lst92991-eng/four-axis-robot-arm/hardware/arm_equal_275/v1/README.txt

275+275 mm 等臂版 CAD 副本（2026-10-09）

打开 native/EQ275_SCARA四轴机械臂总成.SLDASM。必须保留整个native文件夹及同目录零件，不要只移动装配文件。
也可使用独立中性格式 SCARA_equal_275.step。

本次修改
- G1转轴中心距：195 -> 275 mm（增加80 mm）；G2仍为275 mm。
- G1臂板外形：330 × 60 × 10 mm；原孔径、板厚和端部安装尺寸保留。
- 中槽直段50 -> 130 mm，并修正槽位置、电机槽组和肘部四孔，避免中心矩形变长导致它们漂移。
- 肘部组件及大同步轮前移80 mm；关闭原CAD皮带的固定长度驱动，让皮带按新中心距重建。
- 原生装配、零件和虚拟皮带依赖均为独立副本。本次恢复仅打开和保存EQ275文件。

验证
- SolidWorks圆柱面回读轴距：275.000000 / 275.000000 mm。
- G1体积：136224.851137 mm³，与保留两端、中间加长80mm的几何结果一致。
- G1特征无错误；没有新增装配配合错误；原模型既有13项配合错误和配合组警告保留，见final-model-verification.json。
- 207实体，8281组4°构型；3939组无碰撞样本属于直臂姿态所在离散连通分量。
- 五对既有轴/轴套/键连接交叠按原模型解释排除；同步轮、皮带当前外形纳入本次检查。
- 新图为当前Z高度和末端R相对姿态的几何分析；不是连续路径证明、强度或实机安全验收。

需要后续核实
- 实物同步带长度/齿数必须重新选型，不能从CAD带长直接推出采购规格。
- 加长后的刚度、驱动负担、线缆/软管、抓手TCP和实物限位尚未验证。
- 当前棋盘尚未确定，本图没有把任何棋盘尺寸认定为最终实购物料。
- 此尺寸版本保留原生草图；以后再改臂长，仍须同步复核孔槽位置及装配关系。

文件
workspace-comparison.png / .svg：旧版195+275与新版275+275的同尺度俯视对比及中心放大。
旧版采样未纳入被抑制的同步轮/皮带总成，新版已纳入；不能将面积差解释为纯臂长修改的精确增益。
workspace-top-view.png / .svg：新的工作区俯视图。
model-isometric.png：新模型预览。
analysis/：实体干涉采样、连接交叠排除和统计证据。
final-model-verification.json：最终装配核验；早期制作日志中的错误已由后续步骤修正。

原件记录
初次复制时原文件哈希未变。用户关闭/重启SolidWorks的间隔内，原总装及其旧临时虚拟总装的哈希发生变化；该差异保留在日志中，没有回滚。恢复后的操作只针对EQ275副本，原件相对恢复基线未再变化。
