lst92991-eng/four-axis-robot-arm/hardware/camera_mount/v2/README.md

# 省料双梁相机桥架 V2 · 已撤回打印建议

> 2026-10-09：用户否决本方案，理由为结构过于复杂、用料仍偏多，以及62.6cm高度缺少实际视场与识别验证。棋盘尚未最终确定，本目录仅保留历史CAD及几何检查证据，不作为当前制作方案。以下打印数量和尺寸是该历史设计的记录。

2026-10-09。借用机械臂既有顶层铝板，打印左右卡座、镂空双梁、主板横条和相机横梁。省掉V1独立立柱与大托盘。结构件全部打印，普通螺钉连接；这是待试装原型，尚未打印或验证长期承载。

## 文件

- `camera_bridge.SLDASM`：9个打印组件的独立SolidWorks 2026固定装配；零件在`parts/`。
- `camera_bridge.step`：通用CAD装配；`print/`内5个STL按下表打印。
- `layout_check.png`、`layout_check.step`：包含机械臂、参考棋盘、相机和主板的安装场景。棋盘位置仍是布局参考，实际可达工作区另行验收。
- `reference/pcb_major_components.SLDPRT`：从用户STEP复制板框、固定孔和主要器件实体，省略小SMD，只作安装参考，不打印。完整器件包络记录在`pcb-import-evidence.json`。
- `source/`：本轮生成与验证脚本；`*-sketches.json`记录草图约束及特征消费关系。普通打印不需要运行Python。

原机械资料与用户STEP作为参考读取。不要把整机场景或主板参考模型拿去打印。

## 默认打印数量

| 文件 | 数量 | 包络mm | 用途 |
|---|---:|---|---|
| `01_clamp_right.STL` | 1 | 105×131.4×22.8 | 右侧板边卡座 |
| `02_clamp_left.STL` | 1 | 105×131.4×22.8 | 左侧板边卡座 |
| `03_truss_200.STL` | 4 | 200×45×12 | 每侧两段，搭接20mm |
| `04_camera_B_crossbar.STL` | 1 | 146×48×9 | 镜头向下的轻量横梁 |
| `05_pcb_support.STL` | 2 | 146×10×15 | 两个窄横条、四个12mm支柱 |

共**5种、9件**。最长200mm，成型空间建议至少约220×220mm，给裙边留余量。不要缩放适配打印机；更小的打印机需要重新分段。

## 安装接口与尺寸

坐标沿用项目候选机器人坐标，单位mm。铝板安装基准取原CAD底座底面；实际桌面与棋盘高度需要测量。

| 接口 | 尺寸/位置 | 来源或限制 |
|---|---|---|
| 顶层铝板 | 120×161×10；X=±60，Y=-214..-53，Z=524..534 | 原CAD电机支撑铝板 |
| 卡槽 | 净高10.4，单侧名义间隙0.2 | 夹10mm板；实际打印补偿待试配 |
| 每侧卡唇 | 两段各16mm宽，中心Y=-185、-115 | 避开下方角码和板角孔 |
| 板边压紧孔 | 每侧2孔Ø3.4，X=±55，Y=-185、-115 | M3顶紧；原铝板不钻新孔 |
| M3螺母窝 | 矩形6.7×5.8、深2.5；承力底厚2.7 | 放普通M3六角螺母，两平面朝5.8方向防转；从卡槽内放入 |
| 梁根槽 | 4.6宽，配4厚梁 | 拧紧后检查夹持；不只凭松配插接承载 |
| 梁根固定孔 | 每侧2孔Ø3.4，Y=-100，Z=615、640 | 与梁u=30孔对应 |
| 双梁 | 中心X=±66.6；从Y=-130延伸到250；Z=605..650 | 380mm有效长，45mm高、主腹板4mm厚 |
| 梁接缝 | 每侧2孔Ø3.4，Y=60，Z=615、640 | 两片各1.9厚，中间名义间隙0.2 |
| 梁顶固定耳 | u=65、95、125、155、175；孔Ø3.4，腹板横向w=2 | 由每段梁起点计；本版使用Y=145、205、225固定横条/相机 |
| 主板 | 板框约84.975×55.975、厚1.586 | 用户STEP；近似称85×56，不把接插件伸出量算作板框 |
| 主板孔 | 4孔约Ø2.700；孔阵58.000×49.000 | 使用四个安装孔，不使用网口/USB的焊接定位孔 |
| 主板横条 | Y=146、204；孔中心X=±24.5；Ø2.8；支柱Ø6×12高 | 固定58×49孔阵；梁端3.4×5.4矩形槽吸收1mm安装偏移 |
| 主板朝向 | 两个FPC朝+Y相机；网口、USB朝-Y机械臂侧 | 保留插拔空间；FPC1/FPC2名称本身不能证明哪一个是CSI |
| 主板底面 | Z=665；最高模型点约680.4，最低底面元件约656.7 | 下方横条顶面653，最低器件包络约留3.7mm |
| 相机固定 | 两端M3孔X=±66.6、Y=225；中央四孔21×13.5，Ø2.8 | MIS5001 B官方孔阵；实物PCB孔径仍需核对 |
| 镜头前端 | (0,250,626.4)；约62.6cm高 | 相对原CAD底座底面；离棋盘距离须扣除棋盘表面高度 |

相机孔阵中心暂代光轴参考，厂家图没有完整给出光轴偏置。新方案高度固定；若实际视野不够，应修改卡座高度或相机位置，不能把V1的50mm增高件直接套在V2上。

## 紧固件与装配

| 用途 | 初选规格 | 数量 |
|---|---|---:|
| 板边顶紧 | M3×10～12＋普通M3螺母，螺母放下卡唇防转窝 | 4套 |
| 梁根夹紧 | M3×18＋垫片/螺母 | 4套 |
| 梁叠接 | M3×10＋垫片/螺母 | 4套 |
| 主板横条到梁 | M3×12＋垫片/螺母 | 4套 |
| 相机横梁到梁 | M3×12＋垫片/螺母 | 2套 |
| 主板 | M2.5×22～25＋绝缘垫片/螺母 | 4套 |
| 相机 | 暂按M2×16＋垫片/螺母，先核对PCB孔径 | 4套 |

长度是按CAD厚度的初选，实装核对螺纹啮合与突出端。板边顶紧螺钉从下往上，螺母承在下唇的窝中，顶紧铝板；不要把螺母错误放在下唇外侧而失去承力。给接触面贴薄保护垫，轻拧到没有松动即可。

装配：先放卡座螺母→左右卡座从板侧滑入→顶紧定位→双梁根部固定→每侧两段梁叠接→两根主板横条→主板→相机横梁与相机→布线。先打印一个卡座试10mm板边配合，再打印全部。

实际MIPI排线160mm。两块FPC到相机背面接口的直线间距约50～55mm，只是布局预算；还需让排线绕开相机横梁、留弯曲和应力释放余量，实物试绕后确认。网线、电源和USB线固定在梁根/原结构处，插头拉力不要由主板孔和相机承担。

## 打印与使用边界

- 镂空侧梁平躺打印，让长边/三角框处于打印XY平面。两端1.9mm搭接面、梁耳局部悬空须检查切片。
- 卡座侧放，卡唇、梁根夹片和螺母窝可能需要局部支撑；不是整套免支撑设计。先在切片预览中确认卡槽没有残留支撑妨碍试装。
- 可从PETG、0.2mm层高、4道外壁开始试制；薄梁大多由外壁决定强度，实际用料以切片为准。长期蠕变、温升、卡座松动和相机摆动需要实物观察。
- 机械臂振动会传到相机。取图应安排在停车并稳定后；靠角标重投影/棋盘边缘位置记录稳定时间，不宣称软件滤波已解决机械抖动。
- 运动件、工具和线束的完整扫掠尚未验收；CAD几何检查不能替代实机运动与承载验证。

实际STL实体体积约166.09cm³，相比V1的CAD实体体积约减少89.88%。这不是切片耗材克数；卡座支撑、裙边及打印设置仍会改变实际用料。

已核对：5种STL封闭、正体积；9打印件SolidWorks自身干涉为0；按实际装配变换检查参考棋盘视锥无支架侵入；卡座对顶板/角码等邻近静态包络、主板横条/支柱对全部PCB器件包络未发现重叠；5种零件草图完全定义且没有Fix关系。61个原机械文件与用户源PCB STEP字节保持不变。几何检查范围见`validation.json`，不是完整运动或实物承载验收。

本版未获用户认可，已撤回打印建议；几何检查通过不能替代光学与识别验证。后续先确定视觉覆盖范围和图像质量，再设计少量短小支撑。

## 修改模型

通常直接编辑`parts/`中的SolidWorks草图和特征，再核对装配位置即可。装配固定在参考位置，修改梁长/卡座高度后不能假定其他组件会自动跟随。

脚本是本机SolidWorks 2026 COM生成记录，依赖已安装的`solidworks-automation-mcp`技能、pywin32、NumPy和Pillow；其他电脑需设置`SCARA_SW_SKILL`、模板路径及输入模型位置。生成顺序为`build_bridge.py clamps beam camera pcb`→导入用户STEP后运行`pcb_reference.py`→`assemble_bridge.py`→`assemble_bridge.py scene`→`verify_bridge.py`。重建会覆盖相应生成文件，先保留自己的改版。普通打印和原生CAD编辑不需要这套脚本环境。
