lst92991-eng/four-axis-robot-arm/hardware/camera_mount/v2/review/05_pcb_support_review_summary.md

# SolidWorks Review Summary

- Status: `pass`
- Score: `100`
- Manual review required: `True`

## Checks

- `rebuild_succeeded`: `True`
- `model_available`: `True`
- `previews_created`: `True`
- `previews_not_blank`: `True`
- `expected_outputs_exist`: `True`
- `feature_summary_available`: `True`
- `geometry_measurements_available`: `True`
- `geometry_measurements_error_free`: `True`
- `feature_errors_absent`: `True`

## Issues

- No rule-based issues.

## Recommendations

- Inspect generated previews and confirm geometry matches the user request.

## Previews

- `C:\Users\lst\Desktop\scara\hardware\camera_mount\v2\review\05_pcb_support_isometric.bmp`
- `C:\Users\lst\Desktop\scara\hardware\camera_mount\v2\review\05_pcb_support_front.bmp`
- `C:\Users\lst\Desktop\scara\hardware\camera_mount\v2\review\05_pcb_support_top.bmp`
- `C:\Users\lst\Desktop\scara\hardware\camera_mount\v2\review\05_pcb_support_right.bmp`
