lst92991-eng/four-axis-robot-arm/docs/机械臂软件参数与运动控制说明.md

# 机械臂软件参数、运动控制与相机安装

**2026-10-13 Z轴实测补充：** 当前节点1为Emm闭环，用户与日志确认上升/下降均达到过500RPM；不能据此称为极限或无异常持续运行。最小C++17 SocketCAN驱动及完整统计见[Z轴500RPM实测与最小驱动](Z轴500RPM实测与最小驱动.md)。丝杆导程仍未测定，不能把500RPM直接换算成已知Z线速度；其余三轴实物地址和性能不由本次结果外推。

日期：2026-10-09。依据已提供的机械装配/BOM、板端只读检查和当前C++代码整理。

**2026-10-13尺寸更正：** 用户将目标棋子直径从30mm改为33mm。新旧棋盘总装同步采用33mm参考棋子，格距暂沿用35mm、名义相邻净距2mm；板315×350mm、中心(0,280)mm及四码外包络450×485mm不变。下文30mm及35mm旧建议保留为历史来源；本次更正不改变仿真程序或冻结实物支架机位。

**2026-10-10当前口径覆盖：** 本文保留早期计算和来源；当前棋子为用户已购25mm磁性棋子，后续目标30mm。35mm/40mm及V1/V2固定机位是历史建议，棋盘和支架未冻结。本次新授权的旧机软件仿真见[仿真说明](../simulation/README.md)：节点1=Z、用户指定抬升10mm、驱动暂按X固件、机器人执红/执黑可配置。相机450mm、棋高6mm、格距30mm、导程4mm/转及扰动是明确的仿真假设；不替换第3.6节历史20mm计时数据或实物标定。运动EKF已在该虚拟执行器中实现，末端XY是合成传感器，不代表真实反馈已经接通。

本文是后续接真实电机的参数依据与实现取舍，不表示下面的新增算法已经实现。当前交付程序仍使用虚拟执行器；本次只补文档，不改运行程序、原始CAD或已交付压缩包。

## 1. 先采用的方案

- 棋具先固定一种：直径35mm的32枚棋子，厚度约10～15mm，交点间距40mm。实物到手后记录实测值；尺寸是项目选择，不是已经测过的商品参数。
- 相机镜头放在棋盘中心正上方，光轴垂直棋盘。用户后续明确采用全3D打印支架：新设计默认镜头前端距底脚安装面646.4mm，用50mm增高件分档调高；实际距棋盘还要扣除棋盘表面的高差，并按实拍校准。
- 四轴先完成单位、方向、回零、限位、反馈与停止。运动平顺优先使用驱动器已有的加减速/轨迹缓冲能力；能力不足再做主机轨迹时间规划。
- 背隙先测量。只有误差显著且方向规律稳定时，才增加定向接近或有限速度的背隙补偿。
- EKF按用户明确的目标用于运动状态估计。现有棋盘单应矩阵EKF不算运动EKF，也不能证明机械减振。
- 复用现有主循环、规划器、模拟器和统一测试入口，不为了四个节点引入通用设备框架或插件体系。

## 2. 如何区分参数可信度

| 标记 | 含义 | 能否直接驱动实物 |
|---|---|---|
| 资料确认 | BOM、CAD引用实体或官方文档中明确给出 | 还需核对实际装机是否一致 |
| 板端实测 | 当前开发板读到或本次记录中实测得到 | 只适用于对应硬件/固件与采集配置 |
| 软件假设 | 当前程序为仿真选择的数值 | 不能当作真实限位、负载或速度 |
| 待确认 | 材料没有给出，或不同证据有冲突 | 不填猜测值；影响该动作时应阻止执行 |

来源入口：[原始BOM只读副本](../research/mechanism/bom-original.xlsx)、[BOM单元格及图片记录](../research/mechanism/bom-evidence.json)、[CAD轴线/配合/属性证据](../research/mechanism/assembly-evidence.json)。BOM副本与原压缩包内容SHA-256一致：`a127472e85306e2ad5f825bf92eadf67cd0f0d8821d4d85861f71e27f169005b`。

## 3. 四轴结构与软件坐标

| 项目 | 已提取内容 | 软件含义与限制 |
|---|---|---|
| J1 | 42步进电机L60-2＋DLE42-L2BJ-长款50；输出轴经键槽法兰固定Z滑台，壳体/电机/J1臂一起转动 | 行星减速器反装。电机轴相对壳体的角度不能直接当大臂相对基座角度 |
| J2 | 42步进电机L60-3、GT20/GT60同步轮、同步带、61mm光轴 | 设计意图为小轮驱动大轮。软件肘角必须是第二臂相对第一臂的角度 |
| Z | 42步进电机L60-1、联轴器、T型丝杆与螺母、MGW12导轨滑块 | 螺母推动L型支架，整套水平机械臂升降；需要丝杆导程mm/转 |
| R | 42步进电机L40-1位于第二臂末端 | CAD未建额外减速器，也未建完整吸盘抓手。直接输出是当前设计意图 |
| 第一段转轴中心距 | 195mm，CAD轴线测得 | `L1`，不是J1板件外形250mm |
| 第二段转轴中心距 | 275mm，CAD轴线测得 | `L2`，不是第二臂板件外形330mm |
| 平面理想可达范围 | 半径80～470mm，即`abs(L1-L2)`至`L1+L2` | 只表示工具同轴时的理想几何。不能代替关节限位、碰撞和奇异位形余量 |
| 电机数量 | L60三台、L40一台；用户采购截图已对应到42ZDT60A-2与42ZDT40A-2，均带磁柱、8mm轴径 | 型号与驱动板见3.4节；BOM简称本身不提供完整电气性能 |

以下CAD差异要保留，不能靠软件参数掩盖：

1. DLE文件名含“长款50”，但原BOM/CAD没有独立速比属性或内部齿数。用户已更正误发的短款截图，正确实购选项为“二级DLE42 长款 圆法兰（12比-100比）”，并于2026-10-09明确确认“50：1”。**后续计算采用J1减速比幅值i1=50，即电机相对壳体转50圈，关节输出转1圈。** 来源为用户确认，不标为实测；方向仍按反装结构与实机标定处理。原“实购短款与CAD不一致”结论撤回。
2. GT20/GT60若对应20/60齿，名义比为3:1。但CAD皮带配合用了13和40.6mm直径，动画比例为3.1230769；轮子没有真实齿形。同步带真实速比应取齿数比，不能取外径比或照搬该动画比例。
3. J2小轮与电机模型轴线偏离约3.2075mm，模型电机轴径5mm、小轮孔径8mm；大轮与61mm光轴共轴。用户后续订单已确认实购电机轴径8mm，因此原5/8mm孔轴差异属于CAD模型与实购件的差异，不能再据此认定实物不匹配。CAD约3.2075mm轴线偏离仍需独立核实，不能用运动补偿掩盖装配问题。
4. 丝杆模型标注直径16mm、长度500mm；加工图只给长度与端部加工，未给有效行程和导程。多头丝杆的导程也不等于单条螺纹的螺距。

### 3.1 坐标与正逆解

当前[运动学接口](../algorithm/fk.hpp)约定：基座肩轴中心为XY原点，从+Z向下看逆时针为正，长度用mm、角度用rad，Z向上。`q1`相对基座，`q2`相对第一臂，`q4`相对第二臂。

```text
x   = L1*cos(q1) + L2*cos(q1+q2)
y   = L1*sin(q1) + L2*sin(q1+q2)
yaw = q1 + q2 + q4
q4  = 目标yaw - q1 - q2
```

这些公式以工具中心在腕轴中心为前提。实际TCP若有平面偏置或高度偏置，需加入工具变换，不能只改Z。末端保持同一朝向时，腕轴通常需要随前两轴补偿旋转。四角棋盘定位得到的平面映射，也不等于已经取得棋盘到机械臂基座的变换。

### 3.2 每个轴都必须记录的参数

| 参数 | 单位/记录方式 | 当前状态或用途 |
|---|---|---|
| 驱动节点地址及实际轴名 | J1/J2/Z/R映射表 | 待驱动板资料；不要只靠插线顺序 |
| 实际传动比 | 旋转轴`i=电机相对机壳转数/关节相对父连杆转数`的幅值；Z轴`iZ=电机转数/丝杆转数` | J1用户已确认i1=50；J2名义3有CAD冲突；Z/R直接连接需实装核对 |
| 电机步距角、外部细分、电子齿轮 | °/整步、输入脉冲/电机转、比例 | 三者与编码器计数分开记录，不默认1.8°或16细分 |
| 指令位置/速度/加速度单位 | 电机计数、关节角、mm、rpm等 | 以CAN协议为准，明确是否已在驱动器内换算减速比 |
| 反馈位置/速度单位与安装侧 | 电机轴或负载轴、计数/转、rad/s等 | 待确认；“闭环电机”不等于关节负载侧闭环 |
| 正方向、零位偏置 | `sign=±1`、rad或mm | 用统一坐标定义核验；J1反装特别核对 |
| 回零方式 | 开关/编码器索引/绝对编码器、搜索方向、速度、退回与二次接近 | 待确认；记录掉电后是否保留有效位置 |
| 软件限位、硬件限位 | rad/mm、常开/常闭、触发电平与去抖 | 待实物；量到接线及触发顺序，不能使用仿真±4π |
| 速度/加速度/jerk限制 | rad/s、rad/s²、rad/s³；Z轴用mm系列 | 当前只有仿真限速。jerk是加速度变化率 |
| 到位条件 | 位置误差、速度阈值、连续满足时间、超时 | 应依据真实反馈；固定等待不能证明到位 |
| 停止/故障/重新使能行为 | 减速停止、急停、断线、掉电、总线故障 | 明确哪个动作由硬件保证，何时需要重新回零/核对盘面 |
| Z抱闸/重力保持与恢复顺序 | 驱动使能、抱闸释放/吸合顺序 | 本资料未确认抱闸，也不能只凭T型丝杆就认定自锁 |
| 背隙、弹性误差、重复性 | 输出侧角度或mm；按方向/姿态/负载测 | 待测；不能把厂商别的DLE型号参数移用 |
| 电流、峰值/连续扭矩、温升、减速器允许负载 | A、N·m、温度、轴向/径向载荷 | 用于限制工况；现BOM没有可靠额定值 |
| 编码器状态 | 单圈/多圈、绝对/增量、溢出范围、错误位 | 处理回绕及重新上电；指令计数不是实测角度 |

### 3.3 电机单位到关节单位

若协议位置`m`是**电机轴计数**，这条数据每电机转对应计数为`N`，基础换算为：

```text
q = q0 + sign * (m-m0) * 2*pi / (N*i)
Z = z0 + sign * (m-m0) * lead / (N*iZ)   // lead单位mm/丝杆转
```

指令计数与反馈计数可能使用不同尺度，应分别记录`Ncmd`与`Nfeedback`，不能默认共用一个`N`。Z轴先用`iZ`得到丝杆转数，再乘导程。

仅当驱动器的协议单位及缩放**已经包含机械传动比**时，应用层才不再重复换算。设置电子齿轮本身不证明包含了减速器；需核对具体映射。毫米、角度、整数计数只在驱动边界转换；FK/IK与规划内部继续用mm/rad。

J1反装可解释为：在同一物理正方向下，常规减速关系是`输出相对壳体角=电机相对壳体角/i`；输出固定后，`壳体角=-电机相对壳体角/i`。这解释了结构负号，但最终`sign`还取决于电机安装朝向及反馈极性，不能未经核对直接设为-1。

### 3.4 2026-10-09 实购电机、CAN驱动与计时资料

本节根据用户本聊天连续提供的驱动板订单、电机订单及商品参数页，与原BOM逐项对照。采购截图属于用户提供的实购物料证据；没有读取或控制任何电机。

| 设备 | 目前确认的信息 | 来源和对应关系 |
|---|---|---|
| 40mm电机 | 张大头42ZDT40A系列，订单缩略图标为42ZDT40A-2；带磁柱、40mm机身、8mm轴径，1台 | BOM C21/D21为42步进电机L40/1；用于R轴的对应关系来自CAD。采购SKU `5764545574390` |
| 60mm电机 | 张大头42ZDT60A-2；带磁柱、60mm机身、8mm轴径，3台 | BOM C8/D8为42步进电机L60/3；分别对应J1/J2/Z。采购SKU `5764545574392` |
| 闭环驱动板 | 张大头X42S_V1.0主板套餐，CAN版 | 用户驱动板订单明确确认；板卡版本不等于当前固件版本 |
| J1行星减速器实购规格 | 二级DLE42、长款、圆法兰；用户已确认50∶1减速，计算取i1=50 | 长款类别由更正订单确认，具体速比由用户随后明确确认；不是从12～100可选范围推测，先前短款截图作废 |
| 40mm商品参数页 | 型号42ZDT40A、品牌ZHANGDATOU、D轴；页面标称5V、24W、0.42N·m | 按页面原字段记录。不能把通用商品属性套给60mm规格，不能将0.42N·m当作任意转速下的可用转矩 |

原BOM“品牌”和独立“型号”栏L8/M8、L21/M21为空，但C列已有电机规格且N列有精确采购SKU；因此不能笼统说“没有电机型号”。两款均来自BOM商品 `682797640293`：[60mm采购链接](https://item.taobao.com/item.htm?id=682797640293&skuId=5764545574392)、[40mm采购链接](https://item.taobao.com/item.htm?id=682797640293&skuId=5764545574390)。本次未能从公开商品页面取到可信的完整电气参数表或转矩—转速曲线，订单小图中模糊的电阻、电感、重量等不填为确认值。尺寸和轴径以用户订单为准。

已保存厂家署名《ZDT_X42S第二代闭环步进电机用户手册V1.0.5》（2026-05-27，110页）：[本地手册](../research/mechanism/driver-x42s/ZDT_X42S_manual_V1.0.5_260527.pdf)。下载来自[GitHub保存的厂家PDF副本](https://github.com/xhfb/emm_stepper/blob/main/ZDT_X42S%E7%AC%AC%E4%BA%8C%E4%BB%A3%E9%97%AD%E7%8E%AF%E6%AD%A5%E8%BF%9B%E7%94%B5%E6%9C%BA%E7%94%A8%E6%88%B7%E6%89%8B%E5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)，不是厂家下载站；文件SHA-256为 `0afae3f30e1a679c0cd425c790b495dee504c352d2afe234cfa474868319ee92`。手册第7～8页明确包含X42S_V1.0，不能混用较新V2.0硬件的供电/编码器指标。

与耗时计算直接有关：该板支持Emm与X两种固件，实际FWType仍需确认。X固件梯形位置模式可分别设置加速、减速（RPM/s），速度单位0.1RPM、位置单位0.1°（第55～56页）；Emm位置模式使用脉冲数，acc为档位，第57页给出每隔 `(256-acc)*50µs` 改变1RPM，acc=0为不使用曲线。两种固件均有同步执行和到位返回相关设置，需按手册对应章节与实机版本核对。本次只读资料，没有发送校准、使能、切换固件或运动命令。

后续计时分成两层：①给定速度、加减速、传动比和无碰撞路径后，计算指令轨迹时间；②结合供电、负载惯量及电机动态转矩验证是否能跟随该轨迹。电机页面5V不等于驱动母线供电，24W与0.42N·m也不能直接相除得出可用转速。J1减速比已由用户确认i1=50；仍缺Z丝杆导程、实际FWType及配置、负载下速度/加速度或转矩曲线、工具吸取/释放等待时间。型号及J1减速比不再要求用户重复提供。

### 3.5 计时参数：已有资料、配置核对与实测的区别

原机械资料包主要是CAD、加工图及BOM；已检查的“代码”“笔记”目录无文件。X42S用户手册为后续补充下载，驱动板与电机实购规格来自用户订单，不应统称为原压缩包已包含的资料。

| 计时相关信息 | 当前材料能给出什么 | 是否需要实测 |
|---|---|---|
| 臂长、转轴、名义结构及碰撞区 | CAD轴距195/275mm，结构碰撞采样、Z配合行程327.5mm已有 | 初步理论计算可用CAD；实装尺寸与限位最终核对 |
| 电机与驱动型号、数量、轴径 | BOM和用户采购图已对上，X42S CAN驱动手册已保存 | 无需再测型号；铭牌/装机一致性核对即可 |
| J1减速比 | 用户明确确认50∶1减速，取i1=50；与CAD“长款50”名称相符 | 理论计算可采用，不再列为资料缺口；实机接入时按既定单位/方向流程校验 |
| J2同步带比 | BOM为GT20/GT60，20/60齿对应名义3:1；CAD动画比例不作输入 | 看实物齿数标记、订单或数齿即可确认，不必运行电机计时 |
| Z丝杆导程 | BOM只有500mm长度及16mm包络；加工图标长度和端部加工，无导程 | 先查丝杆订单详细规格；仍缺时，安装条件允许后标定每转移动量 |
| 实际FWType、细分、驱动限制、CAN速率 | 手册说明含义和读法，不记录本机当前设置 | 从驱动菜单/只读参数取得，属于配置核对，不是机械运动实验 |
| 本次运动的速度、加速、减速 | 是规划/运动命令输入，不一定有可读取的持久默认值 | 可先由方案明确设置，直接计算轨迹时间；这些设置能否在负载下实现另测 |
| 棋盘位姿、抓取/通行高度、工具长度 | 现有代码高度属于仿真假设，完整工具未建模 | 最终安装后测量/标定；理论初算可先用明确标注的假设 |
| 抓手和负载质量/惯量 | 尚无可靠整机质量惯量 | 最快工况验证需确认，可用材料可靠的CAD估算或称重，不是给定轨迹计时的先决条件 |
| 吸牢、释放、落子后停稳时间 | 没有本抓手/棋子的有效实测值 | 需要在实际抓手、棋子、管路和运动参数下测试；初算仅能给等待假设 |
| 满载可用速度/加速度、跟随误差、振动 | 空载宣传转速和静态标称转矩不能替代 | 判断最快且可靠的完成时间需要实测验证；未验证时只给条件化理论值 |
| 通信、到位回报及主机调度延迟 | 可先按链路和协议预算，不含真实USB/Linux调度波动 | 要逼近实际总时间时测量；理论轨迹时间应单列这些开销 |

所以不需要先把所有参数实测一遍。J1速比已确认50；第一轮理论指令时间优先补Z导程，确认J2齿数及固件类型，然后明确速度/加减速、合法起终点路径、抬升距离、取放等待和是否回等待位。实际可靠时间再用负载运动、抓取释放和停稳测试校正。此处仅明确资料缺口与验证方法，未授权或执行硬件动作。

### 3.6 2026-10-09 走棋分项计时：20mm抬升方案

J1实际减速比已由用户最终确认 **50∶1（输入∶输出）**，本节可以据此计算给定运动参数下的轨迹时间。下面三档是计算假设，不是额定能力、实机推荐参数或已经测出的最快/最慢边界；所有动作采用静止起步、静止结束的对称梯形/三角形加减速，未计jerk限制。

| 假设档位 | J1电机速度/加减速 | J1、J2关节速度/加减速 | Z线速度/加减速 |
|---|---|---|---|
| 较慢 | 300rpm / 600rpm/s | 36°/s / 72°/s² | 20mm/s / 80mm/s² |
| 中档 | 600rpm / 1200rpm/s | 72°/s / 144°/s² | 40mm/s / 160mm/s² |
| 较快 | 900rpm / 1800rpm/s | 108°/s / 216°/s² | 60mm/s / 240mm/s² |

J1换算为 `关节速度(°/s)=电机rpm*6/50`。J2暂用相同的关节速度/加速度，按名义3∶1分别相当于电机18/36/54rpm、36/72/108rpm/s；实际齿数确认后再换算。Z导程尚未给出，因此只假设线速度，不将它冒充已实现的电机转速；若导程为p mm/转，中档40mm/s对应电机转速为 `2400/p rpm`（直接驱动假设）。本计算采用物理加速度；若实际使用Emm档位，需换算并按可用档位重算。

用户要求将运动与思考时间分开，并将抬升由原50mm改为20mm。本节按**从抓取接触位置向上移动20mm**重算；它不是距棋盘绝对高度20mm，也不是比其他棋子顶面再高20mm。实际净空仍需结合最高棋子、工具长度/包络及误差核对。

其他明确假设：吸取等待0.5秒、释放0.3秒，每次完整取放再预留通信/停稳合计0.2秒；R保持相对第二臂的当前姿态，不额外把棋子文字转正。参考等待点W=(0,440)mm，弃子点C=(270,210)mm，均为计算用点，不是已标定或推荐的实物位置。

不吃子的机械计时边界是：W通行高度出发→源点上方→下降/吸取/抬升→目标上方→下降/释放/抬升→返回W静止。共3段水平运动、4次20mm升降、1秒等待预算。吃子先从目标点移走对方棋子到C，再移动己方棋子，最后回W，共5段水平运动、8次20mm升降、2秒等待预算。机械执行时间不包含视觉、引擎思考、回零和异常重试。

对位移s、最大速度v、加速度幅值a：`T=2*sqrt(s/a)`（s≤v²/a）；否则 `T=s/v+v/a`。水平段让两轴共享归一化进度曲线，以最大关节位移控制耗时，避免只同步终点却改变路径。保持同一肘分支，离线每不超过0.5°检查关节路径是否位于既有4°CAD矩阵中四角均通过的单元；此筛查不替代新的连续碰撞计算、落子高度及工具/棋子净空验证。

| 机械执行示例（源→目标，mm；含吸放与等待） | 较慢假设 | 中档假设 | 较快假设 |
|---|---:|---:|---:|
| 相邻交点40mm：(20,256)→(-20,256) | 11.85s | 7.57s | 6.12s |
| 沿棋盘200mm：(-100,296)→(100,296) | 11.69s | 7.60s | 6.22s |
| 横跨长边360mm：(-180,336)→(180,336) | 11.24s | 7.37s | 6.05s |
| 横跨360mm且先移走目标棋子到C | 20.17s | 13.27s | 10.89s |

不同示例源点距等待点不同，因此不能只按棋子搬运直线距离比较总时间。J1单独转90°在中档假设下为1.75秒，不能用90/72=1.25秒遗漏加减速。中档Z轴每次20mm运动为 `20/40+40/160=0.75s`，包含加减速。

以横跨360mm中档为例，分项如下：

| 时间项 | 不吃子 | 吃子 |
|---|---:|---:|
| 水平运动（含去源点及返回W） | 3.37s | 5.27s |
| 升降运动 | 3.00s | 6.00s |
| 纯机械运动合计 | **6.37s** | **11.27s** |
| 吸取及释放等待假设 | 0.80s | 1.60s |
| 通信/停稳预留假设 | 0.20s | 0.40s |
| 机械执行合计 | **7.37s** | **13.27s** |
| 皮卡鱼搜索预算（独立项） | 1.00s | 1.00s |
| 机械执行＋搜索预算小计 | 8.37s | 14.27s |

**思考依据与额外开销。** 当前 `config/robot.json` 的 `think_ms=1000`，由 `chess/pikafish.cpp` 转成 `go movetime 1000`。04线程的[真板原始记录](../output/rv1106/pikafish-validation/2023-03-05/board-results.json)中，两次1000ms搜索分别耗时1.047和1.031秒；单次启动握手1.328秒。这些是既有独立引擎测试，不是本次重新实测，不能推广为所有局面的严格上下界。当前 `main.cpp` 在思考分支启动引擎并在搜索后关闭，因此启动/加载、合法走法检查及退出开销不能藏在1秒搜索预算内；本轮未修改引擎生命周期。

总响应应分别累计：视觉采集/稳定/识别/棋局确认、引擎准备与合法性检查、搜索、机械运动、吸放与停稳、落子后复核。已有单次NPU推理约85ms的记录不等于完整视觉时间。上表8.37/14.27秒只含明确列出的两类预算，不是端到端总时延。

结论仅为20mm抬升及三档明确假设下，不吃子示例机械执行约6～12秒，吃子示例约11～21秒；不是任意走法的全局上下界。原50mm方案结果已归档为 `timing-scenarios-lift50-superseded.json`，不再作为当前估算。仍有6个旧摆位交点不可达，不可给它们编造有限完成时间。驱动固件、Z导程、负载允许的速度/加速度和真实吸取停稳时间确认后，应替换假设重算。

可复算文件：[计算脚本](../research/estimate_move_time.py)、[逐段角度与时间结果](../output/move-time-estimate-2026-10-09/timing-scenarios.json)。未改机器人运行参数、未操作SolidWorks或实物电机。

### 3.7 当前皮卡鱼版本的棋力调节与时间口径

核对04线程的 `output/rv1106/pikafish-validation/2023-03-05/board-uci.log` 和本地源包 `source-4762ca3.tar.gz`：当前已真板验证的Pikafish-2023-03-05支持 `Skill Level=0..20`（默认20），以及 `UCI_LimitStrength`、`UCI_Elo=1350..2850`。源码中低于20级会启用弱化选招逻辑；开启UCI_LimitStrength时按UCI_Elo换算弱化等级，不应将其数值直接对应中国象棋棋手等级分或职业段位。

当前 `chess/pikafish.cpp` 只设置Threads=1、Hash=4MiB，未覆盖Skill Level，故采用默认20、不主动弱化；`config/robot.json` 的think_ms=1000控制搜索预算。当前程序尚未接入独立难度配置/选择界面，不能把引擎原生支持说成界面已经实现。难度和思考时长是两个维度，延长搜索通常可提高搜索质量，但不保证每一个具体局面都单调改善。

[官方FAQ](https://github.com/official-pikafish/Pikafish/wiki/Pikafish-FAQ#the-elo-rating-of-pikafish)将皮卡鱼描述为超人类棋力，同时说明棋力评价受硬件、用时和对手样本影响，不同等级分体系不可直接比较。本项目旧版本在RV1106上1秒/步的实测并未包含与王天一等顶尖棋手的对局，不能承诺达到或超过某位棋手水平。引擎版本和真板结论仍以04线程记录为准；本轮只核查能力，不更换引擎、不修改运行配置。

## 4. 棋盘、工具与运动空间参数

| 参数 | 当前代码值/已有选择 | 实物接入时的处理 |
|---|---|---|
| 棋盘 | 9列10行，格距40mm，交点跨度320×360mm | 量交点间距，包括河界；记录横纵是否相同 |
| 棋子 | 直径35mm；建议厚度10～15mm | 实测直径、高度、重量、表面吸附性，固定一种棋具 |
| 原标定板整体 | 480×520mm，网格原点(80,80)mm | 这是原打印稿尺寸；买成品后外围贴码必须重新记录几何 |
| 标记 | DICT_4X4_50；0左上、1右上、2右下、3左下；黑框48mm＋白边8mm | 四码全部可见、朝向匹配、与棋盘共面、相对位置固定 |
| 原标记中心 | (32,32)、(448,32)、(448,488)、(32,488)mm | 不可直接套到任意贴法；更换后更新16个角点的物理坐标 |
| 原交点到基座映射 | `x=(4.5-row)*40, y=90+col*40` | 仿真假设；实物需测棋盘到基座的平移/旋转及板面高度 |
| 原取放高度 | TCP Z=12mm，通行Z=70mm | 仿真假设；需结合板厚、棋子厚、吸盘压缩量、工具长度和障碍物设置 |
| 原软限位 | J1/R±4π，J2±π，Z 0～160mm | 全部为仿真假设，禁止照搬到实物 |
| 原限速 | J1/J2=1rad/s，Z=80mm/s，R=1.5rad/s；笛卡尔120mm/s | 全部为仿真假设；没有加速度/jerk约束 |
| 原规划分辨率 | 直线1mm、转角0.05rad，工具等待0.25s | 采样/演示参数，不是精度、减振或吸取成功保证 |
| 收纳区 | 每方15槽，当前坐标由`capturePose`给出 | 检查实际可达、碰撞、槽间距与收纳占用；相机若要复核，也要覆盖或另设观测方式 |
| 工具参数 | 同轴工具假设，实际抓手未建模 | TCP偏置、吸盘直径/材料、阀门极性、真空建立/释放时间、吸附反馈均待确认 |
| 负载与包络 | 未提取可靠质量、惯量和碰撞包络 | 记录连杆/电机/工具/棋子及线束；CAD材料属性缺失时不冒充实测惯量 |

原摆位的交点距离肩轴约92.2～447.8mm，仅是理想XY可达性。还要核对臂板宽度、转动中的电机壳体、相机支架、立柱、线束、棋子及收纳区。路径经过内侧空区、接近伸直奇异位形时，即使端点可达，也不能直接执行。

代码位置：[几何与仿真参数](../app/config.hpp)、[运动规划](../algorithm/motion_plan.cpp)、[运行配置](../config/robot.json)。更换棋盘后，不只改`Pitch`：当前视觉代码还写有固定ROI `(120,120,720,800)` 和40/80像素网格换算，应一起改为由实测几何推导。

### 4.1 2026-10-09 用户确认棋具规格及俯视摆位计算

> **已撤回作为实际摆位建议。** 用户指出必须计入机械结构碰撞/挡块。以下圆环和96mm近边仅保留为无碰撞约束前的几何计算历史；不能据此判定棋盘实机可用。后续以第4.2节的SolidWorks实体碰撞分析及其明确范围为准。

用户确认棋子直径35mm，横纵交点间距均为40mm，9列10行。最外侧交点跨度为 `(9-1)*40 × (10-1)*40 = 320×360mm`。这是用户确认的规格，不是本次用尺实测；棋盘外板尺寸、厚度、棋子高度和定位标记位置仍待记录。

本次通过SolidWorks COM只读提取原机械臂总装155个零件的三角面投影，没有模拟鼠标键盘、修改配合或保存模型。原总装SHA-256仍为 `42d75c8cc76da8c43b351f9c857fffed658a2c09febaa11f47c1b6cb3e27ec7b`，读取前后未保存标志均为false。投影轮廓为显示三角化精度，不是制造用精确线图。

- [俯视工作区与摆位图](../output/workspace-projection-2026-10-09/workspace-and-board.png)
- [摆放方向与正方形外板对照](../output/workspace-projection-2026-10-09/orientation-comparison.png)
- [CAD投影证据](../output/workspace-projection-2026-10-09/cad-projection-evidence.json)、[摆位计算](../output/workspace-projection-2026-10-09/placement-analysis.json)

**几何候选摆位：360mm沿横向X，320mm沿前后Y；网格中心在肩轴正前方256mm，近边Y=96mm、远边Y=416mm，左右X=±180mm。** 距离必须从肩旋转轴量起，不是从后方立柱中心或底座前沿量起。坐标方向沿用 `research/mechanism/camera-mount-layout-evidence.json` 中的候选右手系：`X=0.508123-CAD_X，Y=-155.215866-CAD_Y`（均为mm），+Y指向原装配伸臂前方。

该摆位对应 `x=(4.5-row)*40, y=96+col*40`，仅是布局分析候选值，未写入运行配置。90个交点都存在无约束2R逆解，双分支FK回代最大误差约1.61e-13mm。最近交点半径98.1mm，最远角点453.3mm，距理想80/470mm边界的径向余量约18.1/16.7mm；整个网格矩形的最小半径为96mm。上述数值不代表实际重复定位精度。

设网格横宽W、前后深D，近边距肩轴g。在正前方居中且边线与坐标轴平行、要求整个网格矩形在理想圆环内时：

```text
g >= 80
(W/2)^2 + (g+D)^2 <= 470^2
```

所以360横向×320前后时，g允许80～114.17mm；320横向×360前后时，仅允许80～81.93mm。96mm取值接近均衡整个矩形内外径向余量的96.38mm，未声称是计入关节限位和碰撞后的全局最优位置。最近交点需要J2相对折角约165.9°（伸直为0°）；**折臂自碰撞、驱动/线缆限位可能进一步扩大实际近端盲区**，必须验证后才能确认真实可用。所有目标点和路径还需验证Z工作高度、工具TCP、立柱和相机架净空。

正方形外板与可达落子区域要分别判断。以400×400mm正方形外板为示例，网格居中时可放在X=±200、Y=56～456mm，长边方向的棋子外缘到板边仍有2.5mm，短边方向有22.5mm；这是可容纳棋子的最低余量示例，未包含足够的四角标记区域，也不是用户已购外板尺寸。棋盘纸面边角无须全部被腕轴到达，90个交点及实际取放路径需要可达。若额外要求正前方居中、边线平行的正方形内每一点均在理想圆环内，最大边长约355.16mm，此时贴住内外边界，没有执行余量。棋子中心的可达区也不等于机械臂所有实体的运动扫掠区。

### 4.2 2026-10-09 修正：SolidWorks机械结构碰撞约束

**2026-10-13新旧同口径复核：** [俯视对比图](../output/workspace-comparison-2026-10-13/old-new-top-view.png)、[低头螺丝前后](../output/workspace-comparison-2026-10-13/screw-change-top-view.png)、[完整说明与范围](../output/workspace-comparison-2026-10-13/对比说明.md)。本次棋具参考直径33mm、格距35mm、中心(0,280)mm，与以下历史40mm格距/斜置分析分开。

用户随后指定只看新版螺丝改薄前后：[新版275＋275mm专图](../output/workspace-comparison-2026-10-13/new-arm-screw-change-top-view.png)。蓝色原范围、绿色新增约715cm²（约10.1%）；最远半径550mm不变，主要增加后侧绕回范围。两种头高均90/90端点通过，分析边界同下。

| 轴距mm | 两颗M6头高mm | 采样投影约cm² | 当前棋盘精确端点通过 |
|---|---:|---:|---:|
| 195＋275 | 6 | 5133 | 86/90 |
| 195＋275 | 3.82 | 5589 | 89/90 |
| 275＋275 | 6 | 7061 | 90/90 |
| 275＋275 | 3.82 | 7776 | 90/90 |

两版统一204实体、当前Z与腕相对姿态、4°构型采样，均不含传动子总成；保留5对已记录轴/轴套/键连接重叠的排除。90交点另行解两支IK并检查端点干涉。面积是构型单元FK投影合并近似值；不证明连续路径、完整电磁铁/线缆、全部Z工作区或实机安全。

低头分析保持承压面与杆部不动，仅截低原CAD头部2.18mm，未取得实际低头商品完整轮廓。旧臂肩部首次基座干涉由约±97.738°放宽至±114.610°，再回收会碰铝型材角座；近侧中心(0,122.5)mm仍需约±118.224°，所以不是全盘。名义头部间隙约2.08mm。**两份新交付原生总装仍保留6mm原头；3.82mm只是分析变体。** 最新总装入口见[33mm交付说明](../hardware/xiangqi33-assemblies-2026-10-13/README_先读我.md)。

用户明确：这里的限位指机械结构碰撞或挡块，不是驱动器软件角度限制。第4.1节的理想圆环和近边96mm摆位建议不能当作实际工作区。

**装配审计。** 本次直接读取运行中的原总装，发现其已有未保存改动，读取时保留原状态，不重建、不移动组件、不抑制/恢复配合，也不保存。主装配树包含270项配合和1个配合组，其中没有J1/J2角度限位配合；唯一限位配合为 `LimitDistance1`，范围约0～327.5mm。`平行17`将L型支架底座与J1臂板的侧面保持平行，限制其平面方向，不能把当前装配求解器的锁定姿态当成实物运动能力。

**分析方法。** 根据已测转轴和配合引用，将零件归入支架、第一臂、第二臂三个刚体组，用SolidWorks `IBody2.Copy` 创建临时实体，将组件坐标转换至总装坐标，再按J1/J2旋转变换对临时实体执行 `IModeler.CheckInterference`。这是真正的三维实体相交检测；二维投影仅用来画图，不用于判定碰撞。原文档的平行配合保持不变，分析采用重建的功能运动关系，不声称运行了原装配的完整配合求解器。

共153个已解析零件、204个实体参与当前状态的扫描。当前被抑制的同步带子总成及其子件不作为有效碰撞体；末端吸盘、软管、实物附加挡块未建模。初始直臂姿态中存在5对跨刚体交叠，位于减速器输出与键/法兰、肘轴与轴承/轴套连接处。按转轴连接关系将这些指定实体对排除，并保留清单；这是模型解释假设，不等于证明实物过盈量正确，也不允许自动忽略其他干涉。

**已经确认的接触边界与反例：**

| 姿态或检查 | SolidWorks结果 |
|---|---|
| J1正向边界 | 97.734375°未检出碰撞；97.741699°检出J1臂板与 `M6内六角x22-5` 相交 |
| J1负向边界 | -97.734375°未检出碰撞；-97.741699°检出J1臂板与 `M6内六角x22-1` 相交 |
| J1=0°、J2=150° | 当前高度下未检出碰撞 |
| J1=0°、J2=160° | 第二臂与L型支架底座相交 |
| J1=0°、J2=170° | 末端L40电机与L型支架底座相交 |
| J1=0°、J2=180° | 末端L40电机与T型丝杆相交 |

角度定义：J1=0°为本次CAD向正前方伸直，J2=0°为两臂同向伸直，俯视逆时针为正。这不是已标定的电机零位。约±97.7°是本模型无预留间隙的接触边界，不能直接作为实机软限位。J2的可用角度还与J1位置有关，不能简单设一个固定折角后画扇形。

原320×360mm网格（X=±180、Y=96～416mm）的90个交点已逐点计算两支逆解并执行实体干涉检查：84点至少有一支端点姿态未检出碰撞，6点两支均碰撞。失败点为 `(±60,96)`、`(±20,96)`、`(±20,136)` mm。其中 `(20,96)` 的J1逆解约为+125.263°和-148.800°，远超前述接触边界。84点只是端点无碰撞检查，不能由此推断整条取放路径、工具方向及实物都通过。

俯视区域使用4°构型网格，去掉干涉样本后，选取与当前直臂姿态连通的样本分量；网格间显示插值不是连续碰撞认证。输入Z高度取当前总装，末端法兰最低点CAD Z约1237.272mm；相对底座底面986mm约为251.272mm，不等于工具TCP或棋盘高度。全Z行程投影与固定落子高度的可达切片必须区别；结果适用范围见下列证据文件。

全域扫描覆盖J1/J2各-180～180°的91×91格点，共8281组构型；10226次SolidWorks实体对检查后，3711组未检出碰撞，且均属于包含(0°,0°)的离散连通分量。图中仅以四角均通过的3584个构型小格映射并填色，灰褐色兼含被约束剔除及采样边界未覆盖区域，不把整片未填色区都宣称为数学上已证明不可达。基准临时实体的包围盒在扫描前后保持一致。没有执行电机动作。

**Z关联复核（采样格点的投影存在性）。** J1当前可转连通分量内，748组被拒绝构型中有742组与随Z一起升降的支架/紧固件碰撞，这些相对干涉不会由共同升降解除。剩余6组均为第二臂与40×40立柱相交。读取立柱全部实体表面后，仅上下端面不是沿Z的直母线表面，恒定截面段为CAD Z=1000～1510mm；第二臂在完整327.5mm行程中的Z包络为1032.076～1369.576mm，始终在该段内，因此这6组干涉也不会因升降消失。J1两侧约±97.74°的接触屏障同样随Z升降，不能通过改变Z绕到另一侧。从而，在本4°构型格点和上述模型解释下，全行程XY投影未比当前高度增加可达格点。此结论不是“每个绿色XY点在任意Z都安全”。

末端R在本次扫描中保持当前相对第二臂的姿态，未独立扫描R转动包络；绿色区是该姿态下腕轴中心的位置范围，不是机械臂所有实体的扫掠区。抑制件、未来工具和实物未建模挡块仍须补齐后复核，不能把这张CAD采样图当作实机安全限位。

- [CAD碰撞约束工作区投影](../output/constrained-workspace-2026-10-09/cad-constrained-workspace.png)（[SVG](../output/constrained-workspace-2026-10-09/cad-constrained-workspace.svg)）
- [旧棋盘摆位的6个碰撞点](../output/constrained-workspace-2026-10-09/old-board-collision-check.png)
- [已确认的两处碰撞图](../output/constrained-workspace-2026-10-09/collision-witnesses.png)
- [配合及组件状态审计](../output/constrained-workspace-2026-10-09/constraint-audit.json)
- [刚体分组](../output/constrained-workspace-2026-10-09/rigid-groups.json)、[初始连接交叠](../output/constrained-workspace-2026-10-09/baseline-interference.json)
- [边界和90点干涉复核](../output/constrained-workspace-2026-10-09/boundary-and-board-probes.json)
- [全域扫描摘要](../output/constrained-workspace-2026-10-09/scan-summary.json)、[构型采样矩阵](../output/constrained-workspace-2026-10-09/cad-collision-scan.npz)
- [Z投影复核结论](../output/constrained-workspace-2026-10-09/z-projection-conclusion.json)、[立柱恒定截面证据](../output/constrained-workspace-2026-10-09/z-remaining-evidence.json)

API依据：[SolidWorks临时实体干涉示例](https://help.solidworks.com/2013/english/api/sldworksapi/Check_Interference_using_Modeler_CheckInterference_Example_VB.htm)、[角度限位定义](https://help.solidworks.com/2026/English/api/sldworksapi/SolidWorks.Interop.sldworks~SolidWorks.Interop.sldworks.IAngleMateFeatureData~IsAdvancedMate.html)。

### 4.3 2026-10-10真实驱动源码与软件验证补充

当前已编写`simulation/x42s.cpp/.hpp`真实SocketCAN驱动，和仿真共用X位置组包、分包、应答解析、四轴位移比例速度/加速度规划。共享运动滤波在`motion_filter.cpp/.hpp`：仅电机侧编码器是KF，加入独立新鲜末端XY才使用非线性FK测量成为EKF。没有用命令或FK(编码器)冒充独立测量。

厂家资料已由用户下载到`D:/BaiduNetdiskDownload/ZDT_XS系列第二代闭环步进电机资料`，实际核对了STM32F103/F407 HAL CAN示例。厂家固件记录明确有高速读参数顿挫、CAN定时上报叠加高频通信卡死、限位补偿越界等修复，实际固件版本必须接机核验。CANable识别和驱动板固件仍分别管理，不自动刷机。

真实代码支持四轴ACK后同步、位置/速度/状态稳定判定、超时/总线错误/堵转停止、心跳设置核对；已过隔离vcan测试及固定Cortex-A7/uClibc交叉编译。当前桌面仿真仍不打开真实CAN接口，软件通过不替代带负载运动和真实急停验收。完整说明、源码证据与参数假设见[本轮驱动报告](X42S驱动分析与实现报告.md)。

## 5. 相机安装：位置、距离与简单支架

> **2026-10-09更正：V2已被用户否决，撤回打印建议。** 用户指出结构过于复杂、用料仍偏多，且相机高度没有实际视场/识别验证。用户同时说明棋盘尚未确定。62.6cm及旧480×520mm标记板仅为历史设计/计算，不能作为已批准的采购或打印规格。后续先确定棋盘与标记外包络、实际有效视场及棋子文字清晰度，再确定机位和最少量支撑。

### 5.1 已知参数与真正缺少的参数

| 项目 | 当前证据 | 对安装的意义 |
|---|---|---|
| 主控/相机 | RV1106 boomPI＋MIS5001 MIPI；用户截图箭头指向广角无畸变B版 | 按B版做支架；实际采集视场仍须核对 |
| 已用采集 | 1280×960、NV12，转换BGR；节点`/dev/video11` | 4:3画面；测视场必须沿用同一采集/裁剪配置 |
| ISP输入记录 | 2592×1944 | 不等于已知镜头焦距，也不能据此直接算视场 |
| 当前IQ文件 | `mis5001_CMK-OT2115-PC1_30IRC-F16.json` | 这是ISP调校文件名，不是完整光学标定结果 |
| IQ光圈字段 | `module_calib/sensor_module/FNumber=1.6` | 表示调校中的f/1.6，不能解释成1.6mm焦距 |
| IQ焦距字段 | AF表`focal_length=[0]` | 未提供可用于计算的有效焦距；`LensT=90`也不能当90°视场 |
| B版厂家光学规格 | 焦距2.88mm、F2.4；DFOV95.5°、HFOV87.5°、VFOV56.5°，畸变标称<1% | 95.5°是对角视场；标称H/V与实际1280×960裁剪不能直接互相推出，K/D及有效视场仍须标定 |
| B版厂家机械图 | PCB25×24mm、厚1mm；四孔中心距21×13.5mm；前方轴向尺寸16.6mm、背面连接器突出2mm | 孔径与光轴到孔阵的完整偏置未标注；打印座按孔阵设计，实物试装核对 |
| 用户实物排线 | MIPI排线160mm | 主板放在相机附近，按真实走线预留弯曲与应力释放余量 |

板端IQ只读副本：[camera-iq.json](../research/mechanism/camera-iq.json)。光学工作距离、焦距、传感器有效尺寸共同决定视场，见[Basler镜头选择说明](https://www.baslerweb.com/en-us/learning/lens-selection/)。

B版参数与图来自[官方产品说明](https://wiki.luckfox.com/MIS5001-5MP-Camera/)和[官方机械尺寸图](https://www.luckfox.com/image/catalog/accBoard/MIS5001-5MP-Camera/MIS5001-5MP-Camera-details-size-B.jpg)。现IQ的FNumber=1.6与厂家B版F2.4不同，保留这一差异供后续相机阶段核对，不能用IQ覆盖实物版本信息；本轮没有修改ISP。

### 5.2 推荐安装位置

俯拍可作为画面均匀性和透视差的对照，但“镜头必须在棋盘中心正上方”尚未成为本项目的结构约束。应比较短支撑斜拍与必要伸出俯拍的识别效果，再选省料机位。画面长边尽量对齐棋盘及四角标记外包络；旋转相机后，标记位置与朝向仍须正确对应。

安装方式尚未确定。优先比较“主板直接固定在现有顶板、相机使用短小角度座”的用料和视野；斜拍需检查远端文字清晰度和机械臂停车时遮挡，不能因OpenCV能做透视变换就默认可行。若短支撑达不到视觉要求，再讨论必要的伸出长度。

**安装高度未确定。** V2的626.4mm是CAD相对基座底面的结构尺寸，不是通过相机实拍确定的工作距离；V1的646.4mm及50mm分档增高同样仅为旧方案记录。不能继续推荐用户按这些高度打印。

相机与支撑的实际位置须避开机械臂、工具和线束扫掠。不能仅按整机最高点统一抬高相机；位于扫掠之外的侧面短支撑应单独分析。当前软件Z=160mm上限只是TCP仿真值，不能用它推出真实电机壳体和相机横梁的安全间距。

### 5.3 用视场角估算高度

设要完整覆盖的“棋盘＋标记白边”外包络长宽为`W、H`，对应画面水平/垂直角为`alpha、beta`。每个方向最多使用画面80%，留出安装和定位余量，则近似：

```text
h >= max[ W / (0.8 * 2*tan(alpha/2)), H / (0.8 * 2*tan(beta/2)) ]
```

这是近似针孔计算，角度单位需一致；最终仍以该镜头实际图像验证。[视场角与工作距离关系](https://docs.baslerweb.com/knowledge/angle-of-view-calculation-in-the-basler-lens-selector)。

以原480×520mm标记板为例，把520mm方向对齐画面长边，需要水平视场至少650mm、垂直视场至少600mm。4:3画面若垂直覆盖600mm，水平方向对应约800mm。

| 假设的有效垂直视场角 | 覆盖600mm垂直范围所需高度 |
|---|---:|
| 40° | 824mm |
| 45° | 724mm |
| 50° | 643mm |
| 55° | 576mm |
| 60° | 520mm |

表中角度是演算例子，不是这颗MIS5001镜头的实测值。650mm起点大致对应有效垂直视场约50°时的需求。

### 5.4 不知道焦距，也能用一帧图确定高度

1. 先让镜头垂直朝下，把尺子或已知尺寸的纸放在**棋盘上表面所在平面**，量当前镜头到该平面的高度`h0`。粗装时用镜头前端量距，随后正式标定修正光心偏置。
2. 沿图像横、纵方向分别取一段已知长度`Lx、Ly`，测它们在原始1280×960图中的像素长度`px、py`。不要用浏览器缩放后截图的显示像素代替原图像素。
3. 近似全画面覆盖宽高：`Fx0=1280*Lx/px`，`Fy0=960*Ly/py`。
4. 所需高度：`h_new=h0*max(W/(0.8*Fx0), H/(0.8*Fy0))`。调整后再拍照验证四个标记的完整白边与所有棋子均在画面内。

例：高度500mm时，100mm尺段占原图200px，近似全画面为640×480mm。对于横520/纵480mm的目标外包络，留上述余量后，估算高度为625mm。**200px是计算示例，不是本次实拍数据。**

该方法要求同一镜头、对焦与采集裁剪不变，并尽量用画面中部尺段。广角畸变明显时先标定/去畸变，再测比例；四角单应变换本身不能消除径向畸变。

### 5.5 看得全还要看得清

若有效视场约800×600mm，1280×960原图中35mm棋子直径约56px，48mm标记黑框约77px。这只是分辨率预算；字形细节、失焦、压缩和反光仍会影响识别。不要通过无限抬高相机来避免遮挡。

固定漫射照明，避免棋面高光；对焦在棋子文字附近，并检查四角标记同样清楚。保存实际曝光时间、增益、白平衡和帧率。需要锁定曝光/白平衡时，以现场光照实测为准，不预先填一个万能值。

更换镜头、对焦距离、分辨率、裁剪或支架位置后，重新验证标定。检测耗时约85ms是本项目NPU测试的单次检测口径，不包含采集与传输，不能把该视觉链路当作高频电机控制环。

### 5.6 棋子高度带来的定位偏差

四角标记校正的是棋盘平面，棋子文字在更高的平面。对正上方针孔相机，棋子中心距光轴在棋盘上的投影点为`r`，棋子厚度为`t`，相机距棋盘为`h`，把棋子顶面直接映射到棋盘平面会产生近似径向误差：

```text
偏差 = r*t/(h-t)
```

例：棋盘网格角点`r≈241mm`、棋子厚12mm、相机高650mm，偏差约4.5mm。它是高度视差，不是减速器背隙，也不应靠EKF把真实偏差“平滑掉”。

对落子识别，使用检测结果判断所属交点；对取放目标，优先使用**已标定的交点机械坐标**。若要抓取明显偏离交点的实物棋子，需考虑棋子高度、内外参及实际抓取中心，再做修正。当前12mm的视觉交点归属容差不是允许12mm的机械定位误差。

### 5.7 已撤回的V2与历史V1

以下是[已被用户否决的双梁桥架V2](../hardware/camera_mount/v2/README.md)历史记录：左右打印卡座夹10mm顶层铝板，4段同款镂空梁组成两侧380mm悬臂，两个窄横条按用户主板四孔支撑，前端横梁固定相机，共5种、9件打印件。相对V1减少材料不能证明已符合用户“省料、结构简单”的要求。

原CAD顶层铝板120×161×10mm，位于基座Z=524..534mm。C槽净高10.4mm，卡槽定位、M3螺钉压紧，不钻原板。每侧卡唇中心Y=-185、-115mm，避开下方角码与板角孔。卡座打印配合、压紧承载和长期蠕变尚未实测。

双梁位于X=±66.6mm、Z=605..650mm，相机孔阵参考中心为(0,250)mm。镜头前端高度链为`650-6-1-16.6=626.4mm`，不是实拍光心高度；孔阵到光轴偏置仍需核对。参考棋盘摆位未作为实机可达验收结论。

用户主板STEP提取板框约84.975×55.975×1.586mm，四个安装孔约Ø2.700、孔距58.000×49.000mm。使用两个窄横条和四个12mm高支柱固定，主板底面Z=665mm，底面最低器件包络对横条约留3.7mm。两个FPC朝相机，网口/USB朝后侧；FPC的确切CSI用途以实际接线核对。用户排线仍为160mm，直线间距约50～55mm不替代实际绕线长度核对。

实际STL实体总体积约166.09cm³，相比V1约减少89.88%；不是切片后的耗材重量。网格封闭性、独立桥架自身干涉及参考视锥检查通过，卡座对邻近静态包络、支柱对全部PCB器件包络未发现重叠；尚未打印、承载、完整运动扫掠或实拍标定。最大件200mm，卡座等位置需要局部打印支撑。机械臂停车后仍需测量画面稳定时间。

[全打印支架V1](../hardware/camera_mount/v1/README.md)保留为历史方案：独立600mm柱段、646.4mm镜头高度、50mm增高模块、通用大托盘；这些结构与调高件不自动适用于V2。

### 5.8 2026-10-09相机参数复核：仍不能冻结高度

本次通过ADB只读查询，`/dev/video11`当前格式为1280×960、NV12，步长1280字节，一帧1843200字节。未启动采集、修改相机配置或取得已知高度/尺寸的实拍标定图。用户说明尚无最终棋盘，因此不存在已确认的“棋盘＋四角标记”实物外包络。

仅把B版标称VFOV=56.5°代入`覆盖高度=2h*tan(VFOV/2)`，且假设镜头垂直俯拍、该角度适用于当前采集，可得：

| 假设镜头距棋盘面 | 估算垂直覆盖 | 35mm棋子在960行原图中的直径 |
|---|---:|---:|
| 40cm | 430mm | 78px |
| 50cm | 537mm | 63px |
| 60cm | 645mm | 52px |
| 62.64cm | 673mm | 50px |

这些是视场预算，不是实拍或识别结果。厂家H/V角组合的正切比约1.782，而当前输出是4:3；尚不清楚它们对应的传感器有效区域和裁剪，不能直接把两个标称角拼成当前画面的确定覆盖宽高。透视变换能校正平面投影，不能恢复失焦、遮挡或原始采样中已经丢失的文字笔画。

当前代码先透视拉正，再裁720×800棋子区，等比缩放到640×640模型输入；35mm棋子在规范化输入中约56px。这个人为输出尺寸不能代替原始清晰度，不应误算为整幅1280图像直接缩半后的25px，也不证明远距离实拍可识别。

没有成品棋盘也能先用A4纸或尺子，在已知镜头高度下测有效视场；但最终仍要用选定棋具验证四角码稳定识别、全盘入镜、远近端各类棋子文字及停车遮挡，再设计短小支撑。当前只撤回旧方案和记录约束，不继续生成固定高度CAD。

## 6. 背隙会不会造成抖动

**会在某些工况下造成或加重抖动，但有背隙不等于每次运动都持续振荡。** 典型表现是：换向时电机先走一段而负载没动，另一侧齿面重新接触后发生冲击；位置控制器反复跨越空程，也可能来回修正。参见[Beckhoff机械背隙说明](https://infosys.beckhoff.com/content/1033/backlash/15312602251.html)与[MathWorks齿面接触/分离建模](https://www.mathworks.com/help/sm/ug/backlash-joint-limits.html)。

| 现象 | 优先排查 | 对应方法 |
|---|---|---|
| 同一点从两个方向接近，最终位置不同 | 减速器/丝杆/联接处空程 | 测换向差；定向接近或经验证的背隙补偿 |
| 加速、急停时晃动，停下后衰减 | 结构柔性、惯量、轨迹冲击 | 紧固/支撑、降低加速度和jerk、平滑轨迹 |
| 某个速度/频率特别容易振动 | 电机/机械共振、控制环参数 | 驱动参数整定，测频率后才考虑陷波 |
| 负载或伸展姿态变化后偏移变化 | 刚度、挠曲、工具偏置 | 负载/姿态测量、结构改进，不能只补一个常数 |
| 静止时读数抖，但实物未见移动 | 测量噪声、量化、时间戳 | 检查测量；适量滤波与状态估计 |
| 停机/重启后坐标突然不一致 | 丢步、未回零、编码器回绕/零偏错误 | 恢复定位与反馈检查，不用滤波掩盖 |

对同轴TCP，小角度误差可近似估算：`末端XY误差上界≈(L1+L2)*abs(δq1)+L2*abs(δq2)`，角度用rad。若仅J1有0.1°输出误差，最伸展处约0.82mm；若仅J2有0.1°，约0.48mm。**这是敏感度例子，不是本减速器已测背隙值。** Z轴空程直接表现为高度误差；腕轴空程主要影响朝向，工具偏心后也会引入位置误差。

## 7. 解决策略：按实测问题逐层增加

### 7.1 第一层：结构、参数与轨迹

1. 先处理松动、孔轴配合、联轴器、同步带张力和支架刚度。张力/预紧按零件允许值设置，不能靠无限拉紧消除误差。
2. 核对每轴方向、零点、单位和传动比。J1反装负号、J2相对角和Z导程错误不是“抖动参数”。
3. 优先使用驱动器现成的加减速、S曲线和同步启动/轨迹缓冲功能；只有驱动能力不足时才在主机补时间规划。[S曲线与jerk取舍](https://www.rockwellautomation.com/en-pl/docs/studio-5000-logix-designer/38-02/contents-ditamap/instruction-set/drives-instructions/tune-an-s-curve-profile.html)。
4. 当前`PlanStep`约1mm是路径采样点。平滑必须覆盖一整段连续动作，不能让每个采样点都零速起停。对有拐角的路径，需要明确减速到位或可接受的过渡误差，并重新检查整条扫掠路径。
5. 四轴需要共同的时间基准。逐个发目标并让四个驱动各自“尽快到位”，不能保证协调的TCP轨迹；确认驱动器是否支持同步触发、带时间戳目标或缓冲轨迹。

### 7.2 第二层：测量后再补偿背隙

可先用低速、空载及典型负载做往返定位测量：在同一姿态和同一目标，分别从正反方向接近，等待相同的稳定条件后，用输出侧测量比较位置。覆盖近/中/远几个姿态并重复若干次，记录换向差、离散程度和负载依赖。单次偏差不直接当作背隙常数。

简单选项是“从同一关节方向完成最后接近”，但为了绕行到同侧而新增的路径仍需限位/碰撞检查。TCP从同一方向靠近，不必然意味着两个转动关节都从同一方向靠近，要按最终关节轨迹判断。

软件换向补偿需要保存最后有效运动方向、实际输出侧空程和补偿完成状态；复位、故障或手动挪动后应重新建立状态。补偿应平滑分配在有限时间内，继续遵守速度、加速度、jerk与限位；不要在换向瞬间突然多发一大段角度。厂家说明也指出瞬时补偿会激励机器，需要时应分摊到多个控制周期。[补偿动态效应](https://infosys.beckhoff.com/content/1033/backlash/15312602251.html)。

若驱动器已启用背隙补偿，主机不能再重复补偿。目标到位后的有限等待可以帮助振动衰减，但不能消除静态空程，也不能替代实际到位/吸附反馈。

### 7.3 第三层：运动反馈与EKF

用户希望EKF服务于机械臂运动。可以从`x=[q1,q2,z,q4,dq1,dq2,dz,dq4]`的8状态开始，但先明确每项测量从哪里来。

- 仅使用匀速状态模型与编码器直接读关节角度时，模型是线性的，普通KF足够。
- 融合真实末端标记的视觉位置/姿态时，FK及相机投影形成非线性观测，才有使用EKF的具体理由。需保存相机标定、标记到TCP变换、编码器/图像时间戳、测量延迟和噪声估计。[EKF适用条件](https://www.mathworks.com/help/fusion/ug/extended-kalman-filters.html)。
- 静态棋盘四角只能测相机与棋盘的关系，不能测机械臂实际运动。当前只测XY时也无法完整观测Z和同轴腕角；需要相应的编码器或姿态/深度测量。
- 电机侧编码器位于减速器之前时，不能直接测到减速器之后的全部空程和弹性偏差。负载侧编码器或末端观测可用于验证实际输出位置；不能拿“命令已经发出”代替反馈。
- EKF提供状态估计，控制器依据估计误差产生控制量。大幅真实振动不能当成噪声直接滤掉；过度滤波或错误延迟处理会影响控制响应。

第一版不预建双惯量辨识、MPC或自适应控制框架。若驱动板已实现快速电流/速度环，先利用其能力，RV1106负责视觉、规划、指令协调与状态监督；普通Linux用户态和USB-CAN链路不作为未经验证的硬实时伺服环。

## 8. CAN、执行确认与故障处理参数

此前本机只读记录：boomPI、Linux5.10.160，`CONFIG_CAN`未启用；后续接入时复核当前内核。2026-10-10用户确认工具为张大头 **ZDT_CANable V1.0**，不再将型号列为未知。本次Windows已枚举到`1D50:606F`、`candleLight USB to CAN adapter`，通讯接口MI_00由WinUSB驱动，状态OK、问题码0；确认工具的candleLight固件类别，具体构建号仍未知。RV1106端可用驱动/接口尚未验证，不能把Windows识别成功当作板端`gs_usb`已可用。详见[USB识别记录](../output/hardware-validation/stage1-usb-identification.json)。

建议先接Windows电脑识别工具并用厂家软件验证单节点只读应答，最终移至RV1106 USB Host，由板端直接收发。CANable的candleLight/slcan等工具固件与电机驱动X/Emm固件分别核对。[厂家工具说明](https://blog.csdn.net/zhangdatou666/article/details/132269560)列出V1.0默认candleLight与配套cangaroo；默认值不替代实物确认。若复用当前ADB的USB口切换Host，先保证网口SSH或串口可持续登录。本次未发CAN查询或动作命令。

| 要记录的内容 | 为什么软件需要它 |
|---|---|
| 转接模块ZDT_CANable V1.0的实际固件、驱动和CAN速率 | 型号已由用户确认；其余决定内核/用户态接口，不先写死SocketCAN或任意厂家库 |
| 四轴节点ID与命令/反馈ID、标准/扩展帧 | CAN节点地址和报文ID的映射由协议决定，一个通道可挂四个节点 |
| 数据字节序、有符号数、缩放、校验/序号 | 防止角度/电流误解码，区分旧反馈与新反馈 |
| 指令模式及单位、允许刷新周期、缓冲深度 | 选择点位运动还是连续轨迹，估算总线负载与USB/调度抖动 |
| 反馈频率、时间戳、到位/故障位、错误码 | 为EKF、超时和真正到位确认提供依据 |
| 命令确认、重发、清队列、停止和恢复语义 | 避免重复动作；总线恢复后不能无条件继续旧轨迹 |
| 同步执行机制及四轴时序偏差 | 评估协调运动；不能仅凭四次发送成功认定四轴同步 |
| 急停/使能/限位与通信超时的硬件作用 | 网络软件停止不能代替硬件停机链路；Z保持和吸盘保持要单独定义 |

总线位率和更新率必须由真实协议计算：每周期包含命令、反馈及协议开销，还要考虑位填充和仲裁余量。这里不先规定一个未经带宽与时延验证的“1kHz四轴控制”目标。

只有“驱动反馈到位＋工具动作成功＋盘面复核一致”才提交机器走法。丢帧、断线、驱动故障、抓取失败或视觉不确定应停止推进并保留待确认状态；恢复后先重新核对实物。

## 9. 预计增加多少代码与复杂度

统计口径：**新增非空生产C++行，包含教学注释**。当前基线2267行，主流程305物理行；排除第三方源码、测试、Python界面、训练工具、文档和生成物。下表为设计估算，尚未实现，不是承诺工期或精度。

| 工作项 | 预计新增行 | 复杂度 | 前提/放置位置 |
|---|---:|---|---|
| 参数核实与标定值接入 | 0～60 | 代码低，测量工作较多 | 沿用`app/config.hpp`及一份明确标定数据，不造通用配置系统 |
| 单一确定CAN协议的四轴接入、换算、状态、超时/停止 | 350～700 | 中 | 各方案共用基础；一个实际驱动模块，配合现main，不另外建平行状态机 |
| 使用驱动器已有加减速/平滑与同步能力 | 40～120 | 低～中 | 确认协议已有对应功能；复用驱动模块 |
| 同方向最终接近＋有界稳定等待 | 40～100 | 低～中 | 按关节方向判断并检查新增路径；放现规划/执行流程 |
| 有限速度的换向背隙补偿 | 100～220 | 中 | 实测空程、保存方向状态、不与驱动器重复补偿 |
| 主机四轴同步平滑轨迹 | 250～550 | 中 | 覆盖整个连续动作，处理拐角/约束；扩展现`motion_plan` |
| 编码器位置/速度KF | 100～220 | 低～中 | 有真实反馈与时间戳；它不消除机械间隙 |
| 运动EKF＋一种非线性观测融合 | 350～800 | 中～高 | 有编码器与可观测的末端位置/姿态；含矩阵、异常测量和同步处理 |
| 相机标定结果加载/去畸变＋实际棋盘几何统一 | 50～120 | 低～中 | 标定采集与求解离线完成；板端复用OpenCV，消除当前硬编码ROI/格距 |
| 简化背隙/传感噪声仿真 | 80～180 | 中，测试支持为主 | 注入可控误差做比较；仍不能宣称真实柔性减振验证 |
| 双惯量柔性模型与主动振动抑制 | 1000以上 | 高 | 需要动态辨识及足够反馈；暂不作为教学首版 |

**这些行数不能全部直接相加。** 驱动器平滑与主机平滑是优先选择关系；KF与EKF也不是默认串联。视觉几何整理、背隙补偿和仿真注入按需要选择。运动EKF的传感器接入若超出已有CAN反馈与现有相机通路，需另估接口成本。

建议分两步预算：

- **先把真驱动跑稳：** 参数0～60＋驱动350～700＋驱动器平滑40～120＋定向接近/等待40～100，约新增430～980行，总量约2697～3247非空生产C++行。若不需要定向接近，可省去对应增量。
- **再满足运动EKF教学目标：** 在上述基础上增加350～800行，累计新增约780～1780行，总量约3047～4047行。这以真实观测条件具备为前提。若驱动器不提供平滑，替换为主机轨迹方案后重新估算，不把二者同时堆上去。

统一测试仍沿用`tests/main.cpp`。驱动模拟、停止/超时、换算与换向边界、滤波数学验证预计另需200～500行测试支持，复杂硬件异常场景另计；不混进上述生产行数。内核CAN适配、实物测量、支架安装、打印、标定和实验时间不能用代码行数代表。

## 10. 按什么顺序验证

| 顺序 | 要完成的结果 | 保留的证据 |
|---|---|---|
| 1 结构 | J1反装、J2孔轴/齿数、Z导程、工具偏置与限位核对 | 实测参数表，明确测量位置、方向、工况 |
| 2 相机架 | 四角完整白边和棋子可见，中心俯视，文字与角标清楚 | 实测高度、目标外包络、原始帧、实际像素跨度、曝光/对焦设置 |
| 3 标定 | 相机K/D、棋盘平面、棋盘到基座、TCP与高度建立一致关系 | 标定数据及独立检查点误差；不能只看拟合残差 |
| 4 单轴 | 低速方向/单位/回零/停止/故障正确 | 指令与实测位置对应记录，掉线后不自动续跑 |
| 5 往返 | 同一点正反向接近、多个姿态/负载重复测量 | 输出侧位置、换向差、稳定时间和离散程度 |
| 6 平滑 | 比较相同运动的原方案与平滑方案 | 速度/加速度限制检查、稳定时间、真实末端轨迹；不只看动画 |
| 7 补偿/估计 | 只有对应问题显著时启用补偿；按运动教学目标验证EKF | 原始反馈、估计值、独立真值/检查量、时间戳与延迟 |
| 8 整局 | 取子、吃子、收纳、遮挡、停止/恢复均能复核 | 执行前后盘面、工具状态、确认时刻和失败恢复记录 |

定位精度、稳定时间和可接受抓取偏心尚未验收。可先把“交点位置误差不超过2mm”作为讨论/测量目标，但它不是已达到的精度，也不是根据未知吸盘尺寸得出的保证；最终允许误差由实物棋具、吸盘有效接触区和抓取试验共同确定。

## 11. 后续实现约束

主流程仍按“观察→合法走法→规划→执行→复核→提交”顺序展开。硬件变化集中在参数、相机/驱动边界，运动学保持清晰单位。每增加一项优化，先证明它改善了对应实测问题，再保留代码；不为了演示算法名称同时堆叠滤波器。

当前[`homography_ekf`](../algorithm/homography_ekf.hpp)估计的是棋盘映射。后续运动EKF应有明确独立的关节状态与真实测量；视觉定位是否还需要原EKF，按固定支架后的测量结果决定。先完成本参数表，再修改算法与驱动，不把CAD尚未确认的数值静默写入运行程序。
