lst92991-eng/four-axis-robot-arm/output/workspace-comparison-2026-10-13/对比说明.md

# 新旧工作区俯视对比与螺丝改进（2026-10-13）

棋子按用户最新更正采用33 mm；格距仍35 mm、中心(0,280) mm。棋子尺寸不改变本次腕轴中心采样或90交点坐标；本次没有把邻子、电磁铁或实物抓取净空算作已通过。

- `old-new-top-view.png`：两版原6 mm螺丝，与本次两份原生总装一致。
- `new-arm-screw-change-top-view.png`：用户最新指定的新版275＋275，6→3.82mm前后对比；绿色单独标出新增采样范围，约715cm²、10.1%。
- `screw-change-top-view.png`：旧195＋275 mm不变，比较6与3.82 mm头高。
- `old-new-low-heads-top-view.png`：两版同用3.82 mm头高的分析变体。
- `all-four-top-view.png`：全部四种组合。各图坐标、比例、棋盘摆位相同。

| 臂长 mm | 两颗头高 mm | 采样投影 cm² | 当前棋盘端点通过 |
|---|---:|---:|---:|
| 195＋275 | 6 | 5133 | 86/90 |
| 195＋275 | 3.82 | 5589 | 89/90 |
| 275＋275 | 6 | 7061 | 90/90 |
| 275＋275 | 3.82 | 7776 | 90/90 |

旧臂换低头后，采样投影约增加456 cm²（约8.9%），棋盘通过点86增至89。肩部首次基座干涉由约±97.738°放宽到±114.610°；再回收时碰到铝型材角座。近侧中心(0,122.5) mm需要肩角约±118.224°，因此仍未通过。换低头没有消除所有结构限制。

新版275＋275 mm在原6 mm头高时即有90/90端点通过；低头变体也是90/90。只代表本参考摆位下各点至少有一支无碰撞IK端点，不证明整局搬子路径已经通过。

## 范围与方法

两版统一153个顶层零件、204个实体，均排除传动子总成；没有混用历史旧版不含传动、新版含传动的面积口径。5对已记录的轴/轴套/键连接交叠单独排除，其余跨组初始干涉会阻止扫描。

保持当前装配Z高度和腕的相对姿态，肩/肘4°采样，共8,281组构型。图中取直臂所在离散连通分量。投影面积由四角均通过的构型单元经FK投影、合并得到，是近似面积；边界不能直接当实机软限位。所有90交点另解两支IK并做精确端点实体干涉检查。

绿色/蓝色区域表示腕轴中心位置，不是整机实体扫掠外包络，也不代表全部Z高度。尚未纳入传动总成、完整电磁铁、线缆、实际TCP、动态挠曲及装配误差；连续轨迹和真实安全净空仍须复核。

## 低头螺丝的几何假设

仅`M6内六角x22-1`和`M6内六角x22-5`。承压面与杆部不动，把原头从6截低至3.82 mm；用实体极值检查头部切面和杆底。不是把整颗螺丝下移2.18 mm。低头商品的完整头径/圆角/垫片尚未取得，因此原头截低仅作为分析轮廓假设。

原G1底面相对CAD Z=1000约283.7535 mm；承压面277.8535 mm，新头顶281.6735 mm，名义静态间隙约2.08 mm。两份总装仍为原6 mm头高；没有擅自替换实购物料。

四个NPZ与同名JSON保存采样、连通性、实体范围、交点解和首接触角度；`plot-metrics.json`保存近似投影面积。API裁切盒依据[SolidWorks官方CreateBodyFromBox3](https://help.solidworks.com/2016/english/api/sldworksapi/SOLIDWORKS.Interop.sldworks~SOLIDWORKS.Interop.sldworks.IModeler~CreateBodyFromBox3.html)的底面中心与宽/长/高定义，并回读实体极值确认。所有运算只用临时BRep，未保存源CAD。
