lst92991-eng/four-axis-robot-arm/hardware/xiangqi30-long275275-2026-10-13/markers/aruco_4_ids_A4_100percent.pdf

## 中国象棋定位标记 / 4 个独立 ID

DICT_4X4_50 / ID 0 | DICT_4X4_50 / ID 1
DICT_4X4_50 / ID 3 | DICT_4X4_50 / ID 2

按 100% 或“实际大小”打印，不要选择“适合页面”。

黑色编码区 48 mm；四周白边各 6 mm；裁后外形 60 mm。

不要剪掉白边，不要覆反光胶膜。四块按模型位置和方向摆放。

50 mm calibration bar
