lst92991-eng/four-axis-robot-arm/hardware/xiangqi30-long275275-2026-10-13/markers/aruco_id_1_60mm.pdf

### DICT_4X4_50 / ID 1

Print 100% / Actual size
