lst92991-eng/four-axis-robot-arm/output/pdf/gomoku-board-a2.pdf

# GOMOKU / PRINT AT ACTUAL SIZE

A2 420 x 594 mm | Board 410 x 410 mm | 15 x 15 intersections | 25 mm spacing

18-20 mm stones. ArUco DICT_4X4_50, IDs 0-3. ID 0 (START) is the board top-left.

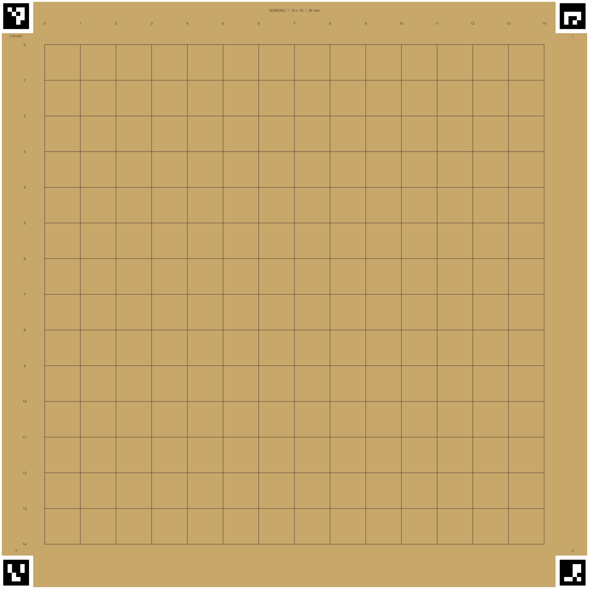
[picture p2: figure]
GOMOKU / 15 x 15 / 25 mm; 0 START

0 | 100 mm

PRINT: Actual size / 100%. Disable Fit, Shrink, scaling and printer borderless enlargement.

Measure the ruler: exactly 100 mm. Keep at least 2 mm of white paper outside the coloured board.

Do not trim the corner-marker white quiet zones. Use matte paper and mount flat.
