lst92991-eng/four-axis-robot-arm/output/pdf/gomoku-board-a4-tiles.pdf

# GOMOKU / TILE 1 OF 6

A4 portrait | Actual size 100% | Do not Fit / Shrink
Row 1, column 1 | Global origin (0, 0) mm | Window 150 x 210 mm

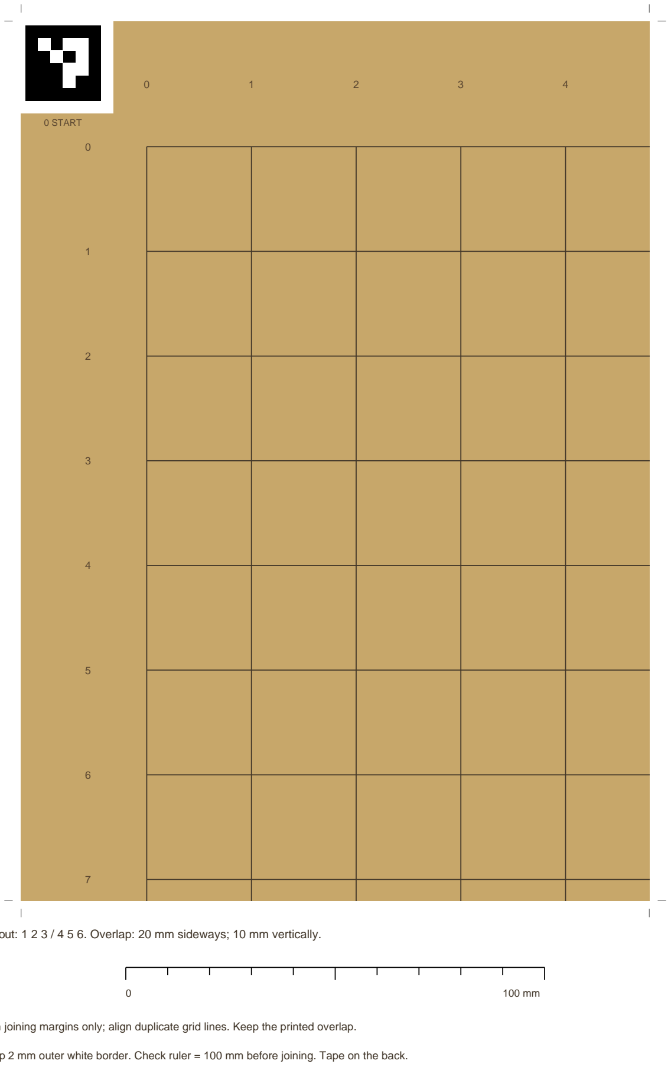
[picture p3: figure]
0 START

Layout: 1 2 3 / 4 5 6. Overlap: 20 mm sideways; 10 mm vertically.

Trim joining margins only; align duplicate grid lines. Keep the printed overlap.

Keep 2 mm outer white border. Check ruler = 100 mm before joining. Tape on the back.

# GOMOKU / TILE 2 OF 6

Row 1, column 2 | Global origin (130, 0) mm | Window 150 x 210 mm

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
GOMOKU / 15 x 15 / 25 mm

Layout: 1 2 3 / 4 5 6. Overlap: 20 mm sideways; 10 mm vertically.

# GOMOKU / TILE 3 OF 6

Row 1, column 3 | Global origin (260, 0) mm | Window 150 x 210 mm

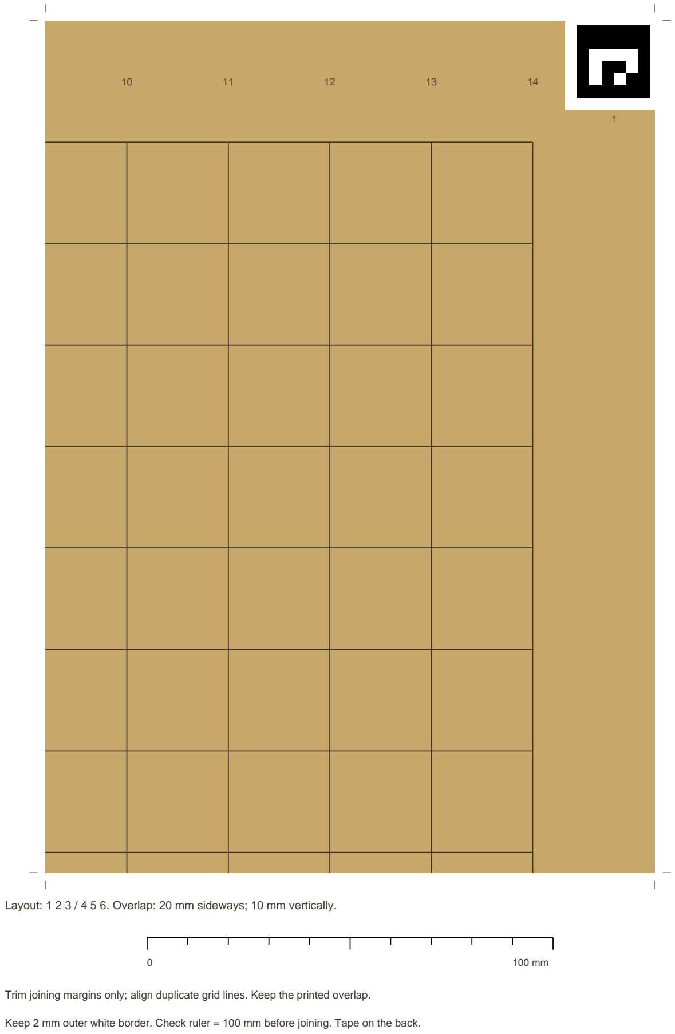
[picture p4: figure]

Layout: 1 2 3 / 4 5 6. Overlap: 20 mm sideways; 10 mm vertically.

# GOMOKU / TILE 4 OF 6

Row 2, column 1 | Global origin (0, 200) mm | Window 150 x 210 mm

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
Layout: 1 2 3 / 4 5 6. Overlap: 20 mm sideways; 10 mm vertically.

# GOMOKU / TILE 5 OF 6

Row 2, column 2 | Global origin (130, 200) mm | Window 150 x 210 mm

Layout: 1 2 3 / 4 5 6. Overlap: 20 mm sideways; 10 mm vertically.

# GOMOKU / TILE 6 OF 6

Row 2, column 3 | Global origin (260, 200) mm | Window 150 x 210 mm

2

Layout: 1 2 3 / 4 5 6. Overlap: 20 mm sideways; 10 mm vertically.
