lst92991-eng/four-axis-robot-arm/output/pdf/gomoku-board-v2-a1.pdf

# 五子棋 V2 / 大号定位标记

黑白打印 | 棋盘外框510mm | 15×15交点 | 格距25mm | 适配18-20mm棋子

每块标记黑色外框48×48mm，四周白色留边8mm；四个ID均保持正向。

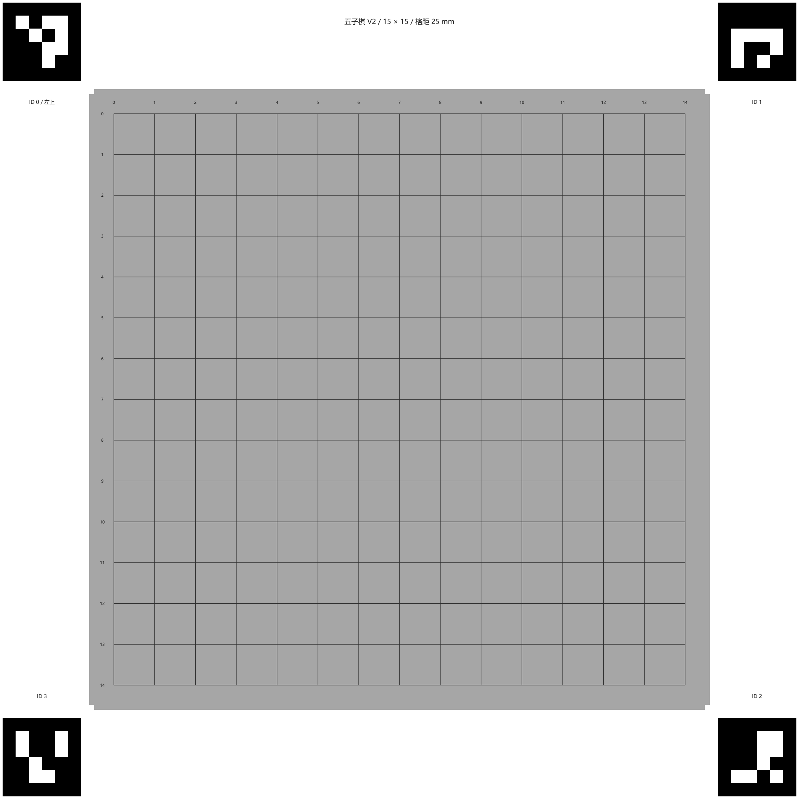
[picture p5: figure]
五子棋 V2 / 15 × 15 / 格距 25 mm

打印后测量：此尺应为 100 mm

请选择“实际大小 / 100%”，关闭“适合页面”和“缩小”。

不要把本页缩到A4；A4打印请使用六页拼接版。

打印后核对：标尺100mm、标记黑框48mm、相邻交点25mm。

保留完整白边，使用哑光纸并贴平。ID 0所在角为棋盘左上角。
