lst92991-eng/four-axis-robot-arm/output/pdf/gomoku-board-v2-a4-tiles.pdf

## 五子棋 V2 / 第 1 张，共 6 张

第1行，第1列 / 单面 / 100%实际大小 | 打印后测量：此尺应为 100 mm

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
### ID 0 / 左上

排列：1 2 3 / 4 5 6；横向重叠30mm、竖向10mm。只裁拼接白边，对齐网格，背面固定。

## 五子棋 V2 / 第 2 张，共 6 张

第1行，第2列 / 单面 / 100%实际大小 | 打印后测量：此尺应为 100 mm

# 五子棋 V2 / 15 × 15 / 格距 25 mm

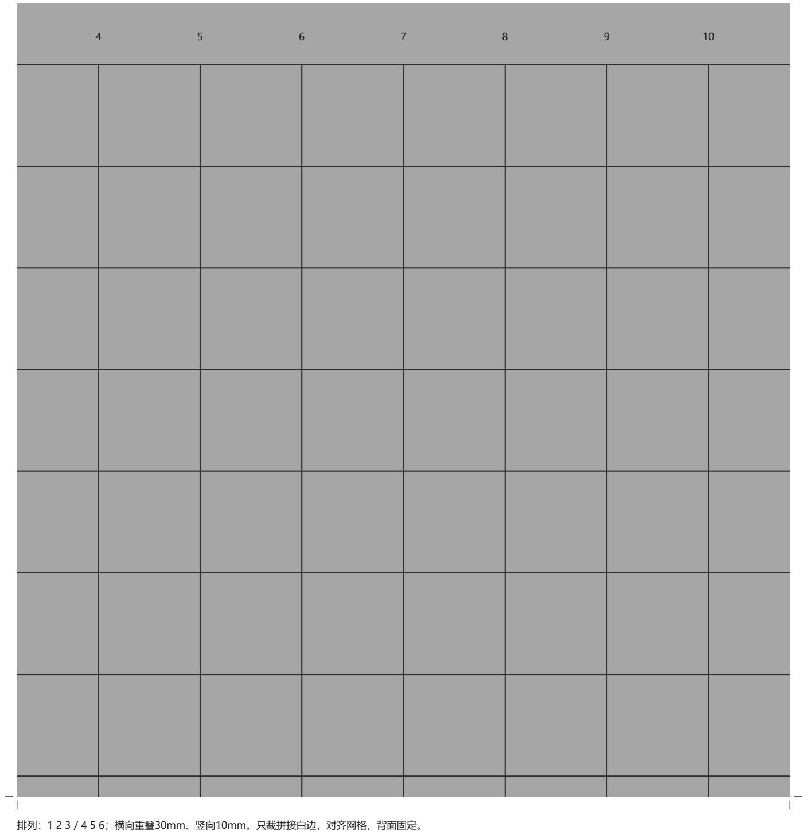
[picture p6: figure]

## 五子棋 V2 / 第 3 张，共 6 张

第1行，第3列 / 单面 / 100%实际大小 | 打印后测量：此尺应为 100 mm

10

11

12

13

14

ID 1

## 五子棋 V2 / 第 4 张，共 6 张

第2行，第1列 / 单面 / 100%实际大小 | 打印后测量：此尺应为 100 mm

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
ID 3

## 五子棋 V2 / 第 5 张，共 6 张

第2行，第2列 / 单面 / 100%实际大小 | 打印后测量：此尺应为 100 mm

## 五子棋 V2 / 第 6 张，共 6 张

第2行，第3列 / 单面 / 100%实际大小 | 打印后测量：此尺应为 100 mm

ID 2
