lst92991-eng/four-axis-robot-arm/output/pdf/xiangqi-board-a1.pdf

# 中国象棋 · 视觉标定棋盘

## 外框 480×520 mm / 9列×10行 / 格距 40 mm / 实物棋子 35 mm

## 单面打印 · 实际大小100% · 关闭适合页面、缩放和无边距扩印

9 | 9
8 | 8
7 | 7
6 | 6
5 | 5
4 | 4
3 | 3
2 | 2
1 | 1
0 | 0

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
楚 河 | 漢 界

## 中国象棋 · 视觉标定板

黑方在上 / row 0 / rank 9

红方在下 / row 9 / rank 0

格距 40 mm · 实物棋子 35 mm · 机器人布局尚未标定

ID 0 / 左上 | ID 1
ID 3 | ID 2

此段实测应为 100 mm

使用哑光纸并平整固定；不要裁入四角标记白边，四角必须完整入镜。

真实棋子使用红黑字区分双方；打印棋盘本身只用灰度，不依赖彩色打印。

打印几何读取 app/config.hpp；robot-placement 只是未标定模拟布局。

35mm参考得力9566商品规格；40mm格距由本项目选择，并非唯一市场标准。

商品规格来源：www.deliworld.com/product/educational-toy/

DICT_4X4_50 / ID 0,1,2,3 / 48mm黑块 / 8mm完整白边 / 所有坐标单位mm
