lst92991-eng/four-axis-robot-arm/output/pdf/xiangqi-board-a4-tiles.pdf

中国象棋 1/6 · 单面打印 · 实际大小100% · 禁止适合页面

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
## ID 0 / 左上

100 mm / 请用直尺核对 / 100%

排列 1 2 3 / 4 5 6 · 重叠30/20mm · 裁接缝白边，对齐重叠图案；外白边保留，胶带贴背面

中国象棋 2/6 · 单面打印 · 实际大小100% · 禁止适合页面

# 中国象棋 · 视觉标定板

## 黑方在上 / row 0 / rank 9

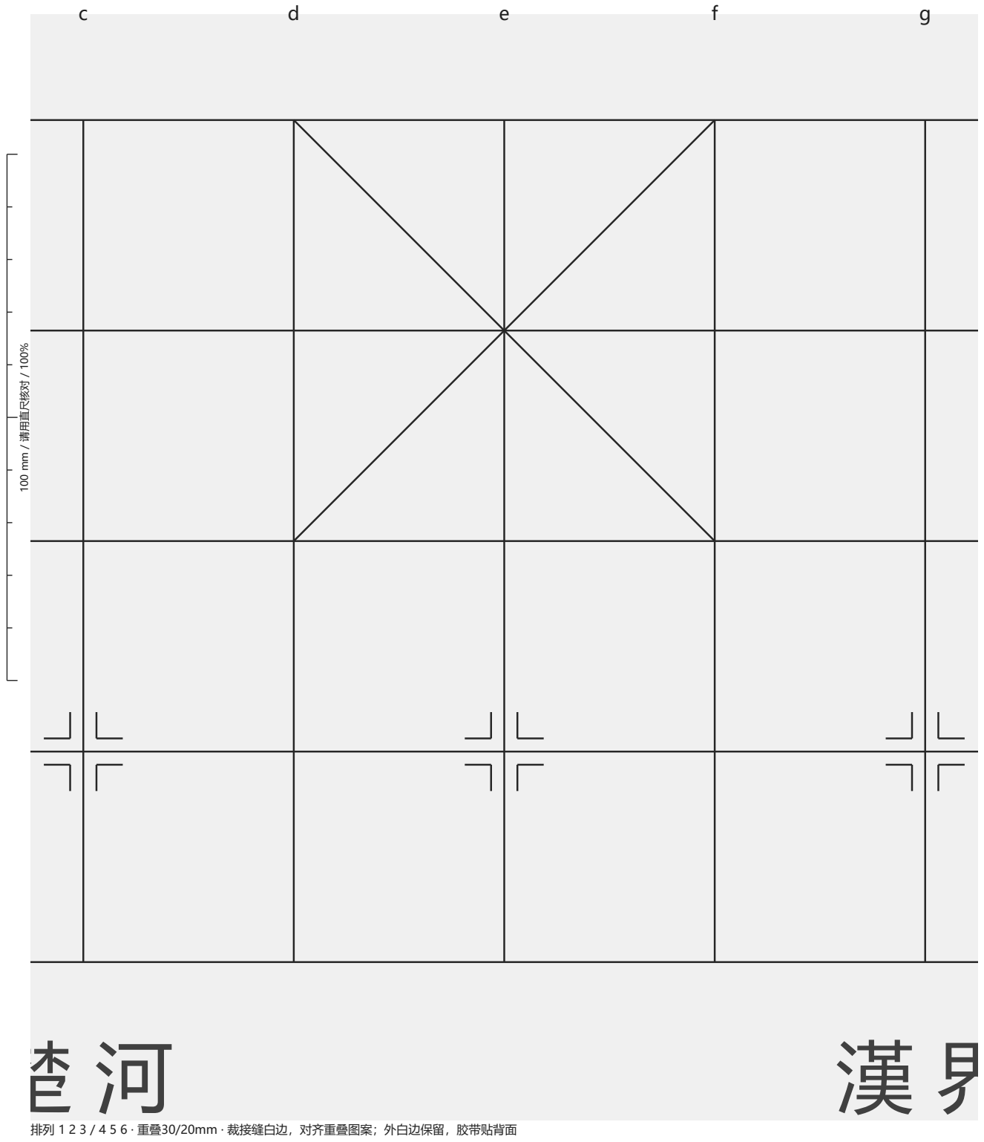
[picture p7: figure]
100 mm / 请用直尺核对 / 100%

中国象棋 3/6 · 单面打印 · 实际大小100% · 禁止适合页面

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
ID 1

100 mm / 请用直尺核对 / 100%

中国象棋 4/6 · 单面打印 · 实际大小100% · 禁止适合页面

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
ID 3

100 mm / 请用直尺核对 / 100%

中国象棋 5/6 · 单面打印 · 实际大小100% · 禁止适合页面

c

d

e

f

g

楚 河 | 漢 界

## 红方在下 / row 9 / rank 0

## 格距 40 mm · 实物棋子 35 mm · 机器人布局尚未标定

100 mm / 请用直尺核对 / 100%

中国象棋 6/6 · 单面打印 · 实际大小100% · 禁止适合页面

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
ID 2 ¹⁰⁰ mm / 请用直尺核对 / 100%
