lst92991-eng/four-axis-robot-arm/hardware/camera_mount/v2/STATUS.md

# V2已撤回打印建议

2026-10-09，用户否决本方案：结构过于复杂、用料仍偏多，且62.6cm高度缺少实际视场与识别验证。棋盘尚未最终确定。

本包仅保留历史CAD与几何检查记录，不作为当前制作方案。网格闭合、静态干涉和视锥计算不能证明真实相机能稳定识别棋盘及棋子。先确定棋盘/标记范围与实际画质，再设计最少量短支撑。
