lst92991-eng/four-axis-robot-arm/docs/项目开发总规划.md

# 中国象棋机器人开发总规划

日期：2026-10-09初版；2026-10-13更新。当前完成度和剩余待办以第10节为准；第3节仍是唯一阶段顺序。每个模块实施/精简之前，先与用户商定最小职责、接口和范围。

历史授权说明：2026-10-09规划轮次只完成规划。2026-10-10用户另外授权旧机软件仿真、RV虚拟机新目录及VSCode连接，交付说明见[仿真入口](../simulation/README.md)；本次未授权真实电机动作、提交/推送或旧代码清理。2026-10-13用户已另外授权Z轴带载测试，节点1实物上下运动及500RPM可达已确认；这覆盖此前规划轮次的动作限制，但不授权提交、推送或清理。软件仿真通过不替代实机阶段检验。各阶段的审核与归档规则见[分阶段开发与审核流程](分阶段开发与审核流程.md)，具体硬件证据见[机械臂参数说明](机械臂软件参数与运动控制说明.md)。阶段顺序以本文件为唯一清单。

## 1. 当前输入与最终目标

| 项目 | 当前事实 | 规划中的处理 |
|---|---|---|
| 现有机械臂 | 旧结构，原CAD轴距195＋275mm | 先用于驱动、平滑运动和已验证区域内的取放；不套用新版工作区 |
| 更新机械臂 | 06子线程已交付275＋275mm候选CAD，实物更新需要周期 | 加工等待期推进不依赖新机的阶段；新机到位后重新做几何与运动验收 |
| 末端 | 用户确定为电磁铁 | 所有新增取放流程按电磁吸取/释放设计，原吸盘/气路描述作为历史资料 |
| 当前棋子 | 用户已购买直径25mm、带磁铁的象棋 | 先验证真实吸放和这一套棋具；是否到货及实际高度/质量在对应阶段登记 |
| 后续棋子 | 用户于2026-10-13将目标直径从30mm更正为33mm | 先确认可吸附性，再换尺寸、标定与必要的权重；本次CAD参考格距仍为35mm |
| 棋盘 | 成品外形、格距、标记范围尚未最终确定 | 棋子直径不等于格距；旧35mm棋子/40mm格距/480×520mm稿不作为最终采购规格 |
| 主控与视觉 | RV1106、MIS5001 B MIPI、16cm排线，C++17、OpenCV5.0.0、RKNN YOLO | 沿用已确认技术栈；机位与支架在视觉阶段验证后决定 |
| 电机通信 | ZDT_CANable V1.0/candleLight；节点1实物X42S_V2.0B、Emm闭环、500kbit/s已通信及运动 | 其余三轴配置/地址和RV端USB Host、CAN/gs_usb链路待验证 |
| 对弈 | 9列×10行、红黑14类、Pikafish | 沿用04线程的真板引擎版本及协议证据，不另起引擎实现 |
| 算法 | FK/IK、平滑轨迹、运动EKF | EKF用于真实运动状态估计；棋盘映射滤波不算运动EKF完成 |

最终教学版要完成：人走棋→观察盘面→核验合法→皮卡鱼应手→机械臂搬子/吃子→复拍确认→提交棋局，包含停止、故障提示与可核对的恢复步骤。

25mm和33mm都属于当前确认的需求，但不同时建设两套程序。最终常用棋具目标是33mm；25mm用于前期开发和升级复验。30mm是已被更正的历史目标，既有资料保留。

### 1.1 已核对的新版资料

已读取聊天 **06-绘制机械臂子进程1（结构参数调整）-2026-10-09 (2)**，ID `01a12092-6b88-7d92-877c-c1396dbdb7c0`。

- [新版CAD交付与限制](../research/arm-structure-optimization/HANDOFF.json)
- [275＋275mm原生装配](../hardware/arm_equal_275/v1/native/EQ275_SCARA四轴机械臂总成.SLDASM)
- [同盘同摆位的新旧对比](../research/arm-structure-optimization/chess30-old-new-top-view.json)

该对比使用30mm棋子、40mm格距、棋盘中心(-210,210)mm及斜置候选摆位：旧机86/90点、新机90/90点通过采样工作区初筛。它没有为旧机重新优化摆位，也没有验证电磁铁、棋子实体及连续抬升路径；不能据此称新版已完成实机全盘验收。后续06若交付新版本，更新版本记录后再使用其参数。

### 1.2 电磁铁与33mm棋具的选型条件

“33mm、通用外观”不等于“能被电磁铁吸起”。后续棋具需要有可被吸附的材料/结构，或经过明确的可吸附改造；普通木质/塑料本体不能默认适用。尺寸、外观与可吸附性分别验收。

25mm棋子有磁铁，也仍要测试从棋子顶面吸取、克服棋盘吸持、运输和释放。永久磁铁/残磁可能影响断电释放，不能把线圈通电当作已经抓住棋子，也不能把断电指令当作棋子已经落下。

## 2. 模块划分：六个职责块

这是职责边界，不要求现在创建六套目录、类或测试程序。按阶段增加普通函数和少量必要文件。

| 模块 | 负责 | 输出给谁 | 单独验收的结果 |
|---|---|---|---|
| 设备接口 | USB-CAN传输、X42S协议、四轴状态/反馈、停止、电磁铁开关 | 运动与取放 | 指令、应答和真实状态能对应；故障有界退出 |
| 运动 | 单位/零位、FK/IK、轨迹与同步、已验证的限位/路径、运动EKF | 取放 | 给定目标在当前机械版本上正确运动并反馈状态 |
| 取放执行 | 到源点、吸取、抬升、搬运、释放、吃子及收纳 | 主流程 | 一次明确的搬子任务成功，或明确停在可复核的失败状态 |
| 视觉 | NV12转换、棋盘/标记定位、标定、NPU识别、90格状态与可信性 | 主流程/运动观测 | 输出有时间戳、坐标定义和不确定标记的观测 |
| 棋局与引擎 | 盘面差分、合法走法、历史、Pikafish请求、结果判断 | 主流程 | 合法走法与已提交棋局；不以通信错误代替终局 |
| 主流程 | 人机轮次、调用顺序、停止与恢复、显示必要结果 | 用户 | 一个能按执行顺序讲清楚的完整对局入口 |

程序读取一份当前有效参数；旧/新结构及25/30棋具的快照随阶段保存。候选新CAD参数不自动替换现用旧机运行参数。机械臂版本改变不另写一套FK/IK，棋子改变不另写一套棋局。视觉教学入口仍按单文件执行顺序展开，RKNN和硬件协议细节留在各自明确的边界。

模块间只约定必要数据：棋局用10×9交点与双方14类身份，走法用起终交点；标定把交点映射为TCP位置；运动内部位置用mm、旋转关节用rad；电机协议单位只在设备边界转换。图像像素、棋盘行列、基座坐标及工具坐标各有明确来源，不在不同模块重复猜换算关系。

### 2.1 已获用户初步认可的视觉分工

```text
MIPI NV12 → OpenCV转BGR → ArUco定位 → 透视矫正/裁剪/RGB与尺寸准备
→ RV1106 NPU运行YOLOv5识别红黑14类 → 程序映射90交点
→ OpenCV绘制检查结果 → 棋局合法性与Pikafish
```

OpenCV负责图像与几何处理、标定和可视化；YOLO负责学习并识别棋子身份，RKNN负责其板端NPU推理。第7阶段验证前者的定位/标定链路，第9阶段验证后者的身份识别，两者共同构成视觉模块。初步认可不等于已经完成实拍验证或冻结相机机位。

## 3. 开发顺序与检验点

**前置：规划审核→用户授权现状归档→本地与远程归档均核对成功→按清单整理旧代码→开始阶段1。** 本轮未执行这一归档/清理步骤；已经做过的虚拟软件、模型和CAD证据均先保留。

下面每阶段均经过“实现→实测→用户认可效果→教学精简→回归→用户审核代码并授权提交→本地/远程归档成功”的关口。表内检验点不能由虚拟结果替代实机结果。

| 阶段 | 本阶段完成什么 | 检验点/进入下一阶段的条件 |
|---|---|---|
| 1 RV1106通信与单轴基础运动 | 确认USB-CAN在本板Linux上的真实通信路径；读取驱动状态；单轴小范围正反转、停止、超时 | 型号/固件/节点与协议对应；方向与运动量正确；无盲重发；用户认可基础运动效果。电脑厂家上位机能动不等于RV端已通 |
| 2 四轴反馈、单位与回零 | J1/J2/Z/R对应表、方向、传动换算、回零、停止/限位、掉线恢复 | 各轴不串号；反馈可用且单位正确；回零可重复；Z保持行为明确；重新连接不自动续跑旧指令 |
| 3 电磁铁静态吸放 | 确认额定电压/电流、驱动接口、线圈保护和允许通电时间，测试25mm实物棋子顶吸和释放 | 单子能吸起且能放下；不连带邻子；吸持/释放等待与温升限制有依据；停止/断电时带子状态可解释。先不结合复杂路径 |
| 4 平滑运动与同步 | 利用驱动已有功能，补最小速度/加速度及必要jerk规划，协调多轴完成同一段运动 | 起步、换向和停止达到用户认可的顺滑程度；不让每个路径采样点零速起停；反馈与到位判定有效 |
| 5 FK/IK与当前机型点位 | 接入当前机械参数、TCP、零偏；检查点位、连续路径、同一肘型与实际障碍 | 独立点位核验坐标和误差；奇异位形/碰撞/限位得到处理；旧机只使用已验证区域；CAD采样图不是连续运动认证 |
| 6 指定点位取放与吃子 | 不依赖识别和引擎，按给定源/目标完成吸取、抬升、搬运、释放；吃子先清目标，再搬己子 | 普通搬子、吃子、收纳、漏吸/未释放和途中停止可复核；工具、棋子实体、完整路径纳入检查。20mm抬升只是此前计算方案，验证后才能用于动作 |
| 7 相机机位、棋盘定位与标定 | 在临时可调机位测试真实棋盘/标记范围、画质与遮挡；再定省料支架和棋盘到基座标定 | 全盘及四角白边完整；远近端文字清晰；机位/棋盘/取放高度定义一致；停车稳定时间有记录。此时才确定支架打印尺寸 |
| 8 运动EKF | 用真实编码器反馈及可校准的末端观测，估计运动状态并接入监督/必要反馈修正 | 状态、模型、噪声、时间戳和延迟明确；有同工况原始反馈/估计/独立观测对比；不用滤波掩盖传动比、回零、背隙或松动 |
| 9 当前棋具YOLO识别 | 真板输出红黑14类及空格；此时若仍用25mm先验证该套，33mm已到位可直接作为识别基准；按实拍决定沿用权重、微调或替换 | 数据来源/划分/权重可追溯；独立实拍包含各类、远角、满盘、残局和遮挡；低置信/重复检测不进入动作；新字体不能只靠缩放增强宣称适配 |
| 10 棋局、引擎与单回合闭环 | 合法性、历史和结果处理；把已验证的识别与取放接成一个人机回合 | 人的非法走法不改历史；机器走法先核验合法且可执行，实物复拍正确后才提交；中断后盘面和引擎历史一致。旧机可用限定场景验证，不强求全盘 |
| U 新结构与33mm升级复验 | 新机到位后先沿用25mm棋子验证机械变化；再换33mm棋具验证吸附、定位、识别与布局 | 按第4节复验；没有通过的相关阶段退回重做。完成正式全盘联调前必须通过，不要求先完成旧机整盘版本 |
| F 正式全盘联调与教学复现 | 在最终机型和33mm可吸附棋具上验证90点、吃子区、整局、异常恢复和从干净环境复现 | 整盘与完整取放路径通过；整局和异常场景有记录；用户认可效果并审核最小代码；授权最终归档后交付 |

### 3.1 阶段1接入讨论（2026-10-10）

用户已确认转接工具为ZDT_CANable V1.0。建议按四个小检验点推进：

1. **电脑识别工具。** 先只接USB端到Windows电脑，核对设备枚举和当前工具固件；此时无需连接电机。
2. **电脑验证单节点。** 按驱动手册核对接线、外部供电、终端、电机地址、CAN速率与校验，用厂家上位机只读取版本/状态，确认真实驱动应答。
3. **RV1106只读收发。** 工具移到板子的USB Host口，核对本板驱动/内核路径，用单文件C++实现一条查询、接收解析和超时。达到这里才证明板端CAN链路已通。
4. **单轴基础运动。** 在既定授权、范围和停止方式下加入低速短行程正反转与停止；用户认可效果后再精简、回归和审核提交。

最终运行链路为`RV1106 USB Host→ZDT_CANable→CAN总线→电机驱动`；电脑先验证只为排查基础链路。CANable固件（如candleLight/slcan）和电机驱动固件（X/Emm）是独立项目。

[厂家工具说明](https://blog.csdn.net/zhangdatou666/article/details/132269560)注明V1.0出厂默认candleLight、配套cangaroo；用户手中固件仍以识别为准。当前处于商讨与资料核对，没有操作电机、改固件或创建新的运动程序。

2026-10-10检查进展：用户已插入工具，未连接CAN总线。Windows最终枚举为`1D50:606F`、`candleLight USB to CAN adapter`，通讯接口MI_00绑定WinUSB、问题码0。**只通过第1个USB识别检验点**，尚未验证CAN收发或电机应答。首查曾显示VMware接管，复查已由Windows主机正常枚举；本次没有主动切换USB、改驱动或刷固件。证据见[USB识别记录](../output/hardware-validation/stage1-usb-identification.json)。

新结构若提前到位，U可以在受影响阶段开始前插入，不必先把旧版阶段重复做到底。机械加工等待期间可先完成阶段1～6中满足输入条件的工作；视觉/引擎已有材料可以离线整理，但不自动越过用户的阶段授权和审核关口。

旧机若遇到合法但不可达的走法，应停止自动执行并明确说明；不能删除这些合法走法或裁掉棋盘，假装已经支持整盘。

## 4. 升级时哪些复用、哪些必须重验

| 变化 | 复用的内容 | 必须更新或复验 |
|---|---|---|
| 195＋275改275＋275等新结构 | CAN协议、引擎、棋规和主流程；同一套FK/IK公式 | 实际中心距、零偏/TCP、关节限制、背隙、负载下速度/加速度、完整路径、停车位、吃子区及相关标定 |
| 25mm改33mm | 90格棋局表示、红黑14类定义、引擎与动作顺序 | 棋子可吸附性、直径/厚度/质量、吸放时间、电磁头与邻子间隙、格距/外板/标记、真实图像和权重 |
| 棋盘或相机机位改变 | 采集/转换、标定和识别代码 | 实际视场、清晰度、角标坐标、棋盘到基座映射、文字平面高度及末端视觉观测外参 |
| 电磁铁/驱动或供电改变 | 取放任务定义 | 电控接口、吸力/释放、响应/温升、带子时停止策略、TCP与工具包络 |

参数变更只让同一程序适配新条件，不使旧验收自动有效。先更换结构、再更换棋具，分别保存复验结果。

## 5. 运动EKF的最小教学方案

优先从平面两关节做4状态示例：`x=[q1,q2,dq1,dq2]`。编码器提供关节反馈，固定相机对末端标记提供经过标定的XY观测，XY观测函数由真实FK形成非线性；Z/R先沿各自真实反馈处理，不为凑算法名称扩大状态。

这是待对应阶段验证的方案，不是已完成的反馈控制。只有编码器和线性模型时如实称KF；若末端观测在运动中不可用、时间/坐标不能对齐，先保留待验收项。离线回放和虚拟执行器可以验证数学实现，不能代替真机运动观测。

轨迹平顺主要由速度/加速度规划与驱动环实现。EKF估计不能直接消除机械背隙或支架松动，也不把普通Linux用户态和USB-CAN当作未经验证的硬实时电流/速度环。

## 6. 完整对局与故障处理

主流程保持一条可读路径：

```text
等待人走 → 停稳取图 → 可信盘面差分 → 合法性核验 → 提交人的走法
→ 皮卡鱼应手 → 合法性/当前机型可执行性核验 → 清目标/搬己子
→ 机械臂停车 → 复拍核对 → 提交机器走法 → 等待人走
```

不确定盘面、手部遮挡、引擎异常、反馈超时、吸放失败或复拍不一致均停止推进棋局。机器的“计划走法”和“已完成走法”分开；通电、发指令或到位应答不足以证明棋子搬运成功。吸附确认可优先结合视觉复核；若证据不足需停下核对，不为省代码直接假定成功。

人的非法走法提示还原，复拍与已提交盘面一致后再继续。吃子中断须保留当前走法和已执行步骤，再按现场复核处理，不能从头盲重跑清目标/搬己子两段任务。

带子时的停止/释放/断电处理须在电磁阶段明确，既不能无条件关磁导致落子，也不能无限通电。重启/重连后重新确认定位、工具状态、实物盘面与历史，再由用户恢复。

沿用04线程已验证的教学规则口径：普通合法走法与自将检查、无合法走法判负（将死/困毙）、认输及双方约定和棋；三次重复转待裁定。完整长将/长捉竞赛裁判尚未完成，不能用搜索评分0、通信失败或异常bestmove代替裁判结论。若后续要求完整竞赛规则，另列必须完成的验收项。

RV1106按已有真板方案串行调度视觉/NPU与Pikafish，避免同时占用过多内存；思考能取消，停止/故障处理不能被引擎搜索阻塞。电机底层快速控制继续由驱动板承担。

## 7. 检验记录与通过标准

每阶段只留一份记录：版本与输入、试验范围、操作和结果、误差/失败数据、停止/恢复结果、用户效果确认、精简前后行数、回归结果、代码审核授权、本地/远程提交号、遗留项。使用已有统一测试入口和实际数据，不按每个案例新增程序。

规划建议的功能样本量：电磁单子吸放20次，固定点搬运10次，吃子/收纳10次；最终90个交点及所用路径均验证，完成至少2局并另测故障场景。次数供用户审核，不替代定位误差、成功率、温升和路径净空等指标。

目前不虚构速度、精度、线圈电流或等待时间。每个相关阶段开始试验前，先约定允许的运动范围、XY/Z误差、反馈超时、带子保持时间及停止方式，再按这些指标记录是否通过，不能试完后随意降低标准。

YOLO记录独立测试的分类/定位、误检漏检与不确定输出；需要各类和关键位置都有实拍样本。合成图、训练集准确率、几何覆盖图和虚拟整局分别保留其口径，不升级成真机验收证据。

## 8. 教学代码规模与复现

本轮预算和实际变化：生产C++新增0行、新增生产文件0个；仅新增本规划并修订流程/共识文档。当前历史生产入口为`main.cpp`构建的`scara_robot`，统一测试入口为`tests/main.cpp`；本轮不改变它们。

后续最小教学核心暂按约1500～2500非空自有C++行作为审核目标，含中文注释，不是承诺，也不是删保护代码的上限。初步分项：设备接口150～300、运动250～450、运动EKF100～180、取放100～180、视觉350～650、棋局/引擎180～320、主流程150～250；参数加载视最终方式计入对应模块。

OpenCV/RKNN/皮卡鱼及模型不计入上述自有C++，但来源、版本、大小与许可证单独记录。Python工具、UI、测试、训练/CAD脚本也分别列清单和体量，不能借排除它们宣传整个项目只有这些行数。

每阶段效果获认可后再精简：一个正式入口、一份有效参数、直白函数/必要具体对象、中文意图注释、少量有效日志；停止、超时、单位、协议正确性与真实反馈保留。小功能超过约250行或单文件超过约600行时复核职责和复杂度，不机械拆文件或压行。

最终复现包固定工具链、OpenCV5.0.0、RKNN ABI/运行库、模型/数据划分、Pikafish与NNUE、构建/部署命令、当前硬件/标定参数及验收记录。先由用户指定最终有效版本与范围，再形成逐文件SHA-256清单；提交成功不自动称为冻结。

## 9. 规划审核时需要定的内容

现在可审核：模块边界、阶段顺序、旧机的阶段用途、新结构/33mm升级门、每阶段效果与代码审核关口、教学与规则边界。

留到对应阶段补齐：ZDT_CANable V1.0的实际固件/可用Linux路径、电机驱动固件与节点、Z导程及J2实装传动、线圈/驱动规格、棋具可吸附性和棋盘参数、真实机位/标定、各项性能阈值。USB-CAN型号、X42S、电机型号和用户确认的J1=50减速比均不重复当成未知信息。

总体方案已获初步认可；2026-10-10开始商讨阶段1接入。前置归档、清理及实机动作仍按相应授权执行，不因商讨自动开始。本轮不要求提前安装新结构。

## 10. 距离项目结束的待办与最小实现商讨（2026-10-13）

本节是第3节各阶段的当前进度视图，不新建另一套阶段编号。完成条件仍是：最终机型与33mm可吸附棋具上完成实物人机对局、吃子、异常停止/恢复，并交付用户审核过、可复现的教学代码。

用户判断Z轴是负载最重的电机，该轴驱动成功后，其他三轴接入成功的可能性很高。后续以此安排工作，不继续将同型号电机可驱动性作为方案选择的主要悬念；剩余三轴保留为逐轴接入核对项，不将预期成功提前记为实测通过。当前主要工作是软件收敛、定位与多模块实物集成。

### 10.1 已有成果，可直接复用

- 节点1/Z：实物驱动、编码器校准、上下方向、F6恒速、反馈和FE停止已有证据；上下达到过500RPM。极限负载、连续额定性能及全行程定位不在此结论内。
- `robot/can.*`、`motor.*`：C++候选实现已通过隔离vcan和ARM交叉编译。尚待用户逐项商定精简，不能再仅凭230有效行称作最终最小版；C++真实板端CAN未验收。
- `algorithm/fk.*`、`ik.*`、`motion_plan.*`：几何与虚拟轨迹已有代码；`simulation/motion_filter.*`已有KF/EKF数学实现与虚拟测量验证，可选取复用。
- `vision/camera.*`、`board_vision.*`、`detector.*`与现有模型：采集/OpenCV5/RKNN链路已有实现和板端运行记录；最终棋具、机位、棋盘及真实盘面验收仍待完成。
- `chess/board.*`、`pikafish.*`：棋局、引擎、合法走法和虚拟对局已有实现与验证。不重新写象棋引擎。
- `main.cpp`当前仍调用`robot::Simulator`；`simulation/`为CAD仿真路径；`app/motor_test.cpp`为真实驱动阶段入口。三者用途不同，尚未形成最终真实整机主流程。

### 10.2 剩余待办：软件、实物输入及完成标准

下列均尚未整体完成。已有代码的项优先移植/精简与接入，不默认全部重写。每行“先商讨”是该模块动代码前的议题；列出待办不代表同时授权实施所有模块。

| 待办（对应阶段） | 还缺的软件工作 | 最小实现与先商讨内容 | 依赖/勾选条件 |
|---|---|---|---|
| □ CAN收敛与板端接通（1） | 审核现有打开/收发/超时/错误接口；补板端实际通信验证 | 保留一份SocketCAN连接；讨论类或普通函数、ID与帧参数是否直接传入、错误返回方式；不预建队列/线程/适配器框架 | 核对RV1106内核CAN、gs_usb和USB Host；本板实际查询/应答通过 |
| □ Motor收敛及其余三轴（1～2） | 精简Emm恒速与反馈；按下棋定位需要补最少位置命令、到位和必要同步能力 | 先定最终必需命令列表、方向/单位、反馈字段、停止职责；不默认全量实现厂家协议 | 三轴逐一核对地址/模式/方向；不是再做三套驱动或重复整套极限展示 |
| □ 统一标定参数与回零（2、5） | 电机角度到关节rad/Z毫米转换、零位和回零、有效范围、TCP/棋盘外参 | 一份有效参数，显式字段；先定硬件原点方法、需要保存哪些值及何时判标定有效 | Z导程、各轴比例/方向/零偏、实物限位与重复回零实测；肩50∶1不套给Z |
| □ 电磁铁（3） | 接线对应的通断接口、吸放等待、带子停止和通电时间管理 | 一个明确开关接口即可；先定实际GPIO/驱动方式、吸放确认与带子停止行为 | 实际棋具可吸起、可释放；额定参数、邻子影响与温升有依据 |
| □ 点到点运动与多轴协调（4） | 将真实Emm位置控制接到轨迹，合理加减速、同步/到位、途中停止 | 先比较驱动原生梯形规划能否满足；只补缺少的协调，不先重写FOC/PID或通用轨迹引擎 | 真实点到点顺滑、单位/误差/停止满足商定指标；恒速500RPM不能替代此项 |
| □ FK/IK与实际路径（5） | 复用现有公式，接入实物标定、工具、肘型与实际路径约束 | 先定可执行点集、停车位、路径形式和碰撞处理范围；不以理想圆环为可用区域 | 实物点位和完整路径通过；新旧机参数分开 |
| □ 搬子/吃子执行（6） | 用真实运动和电磁铁替换虚拟动作；记录动作步骤，处理漏吸/未释放/中断 | 先商定“取→抬→移→放”及吃子移出顺序、收纳区、必要状态；可用顺序流程或小枚举，不预建任务框架 | 指定两点搬运、清目标后吃子、暂停后核对可复现 |
| □ 相机/棋盘/机械坐标标定（7） | 复用NV12与ArUco处理；统一棋盘交点到TCP映射和坐标来源 | 先定棋盘/标记布局、机位、标定方式和必须保存的数据；保留一个视觉教学入口 | 最终棋盘全幅清晰、标记完整、基座坐标与真实落点一致；再定省料支架 |
| □ 真实运动EKF（8） | 从现有数学实现接入真实编码器与末端观测，校准时序/噪声，明确是否反馈修正 | 先商定状态/测量/用途；初步沿用肩肘4状态，不扩大到全机；观测不可用时如实区分KF | 独立末端XY观测及前后对比，不能用棋盘映射EKF或虚拟传感器顶替 |
| □ 最终棋具识别（9） | 真板14类识别、90点映射和可信盘面；按实拍判断是否需要补数据/微调 | 先复用现有权重；先约定误检/漏检和不确定盘面处理，再决定训练量；不默认重新训练 | 最终棋具/机位的独立实拍测试通过；遮挡/低置信不触发错误走棋 |
| □ 棋局/引擎与单回合（10） | 复用现有逻辑，把真实识别与真实取放接入；实物复拍后提交机器走法 | 商定执色、启动盘面、搜索时间、棋规口径、停机/重启恢复；只保留一个权威棋局 | 人走→应手→搬子→复拍→提交完整通过，非法走法和中断不破坏历史 |
| □ 最终结构与整局（U、F） | 将候选结构/最终棋具参数落实；验证90点、完整路径、吃子区、异常恢复与耗时 | 先定最终机型、验收误差/成功率/整局样本；拆分机械、吸放停稳、识别、思考耗时 | 实物整局与异常场景通过；软件支持不以CAD采样覆盖代替 |
| □ 教学收口与复现（贯穿、F） | 合并重复生产路径/参数，移出仿真与临时调试，更新说明、构建部署与有效文件清单 | 每模块代码由用户审核；最终入口和文件范围先定，清理另按授权清单；不以转移代码到其他文件假装减少 | 干净环境复现；用户授权后归档并核对；冻结版本由用户指定 |

高频转速波形日志仍为**暂停项**，不自动恢复，也不作为当前整机完成的默认阻塞条件。极限速度展示不是每轴接入必须重复的步骤；影响走棋时间的加速、定位、停稳则保留测量。

### 10.3 每个模块动手前，先交给用户一张最小实现提案

每次只商讨一个模块，提案保持以下七项，不一次把整仓设计定死：

1. **本次要完成的一个动作**：例如指定CAN ID发一帧并收到有期限的应答。
2. **复用/保留/删除/暂不做**：逐项对应当前代码，说明必要性及有无现成调用者。
3. **头文件草案与调用例**：先展示函数签名、数据和主调用顺序，用户能判断是否好教；尚未批准的草案放在讨论/文档中。
4. **失败处理归谁**：超时、错误、停止及状态各有明确负责人，避免各层重复整套处理；不能留下无人负责的路径。
5. **改动范围与预算**：拟改文件、新增概念和估计行数；以完整、清楚为准，不以更少行数自动判优秀。
6. **怎么验收**：沿用现有测试入口，列正常/异常关键行为；本轮可离线完成的部分与必须接实物的部分分开。
7. **用户确认设计后再实现**：已有明确授权范围内继续，不反复问；若实现暴露必须改变的接口/职责，先说明变化再定。之后沿用效果确认、精简回归、代码审核与授权归档关口。

下一轮优先商讨CAN，再商讨Motor。不因已有代码能运行就跳过设计确认，也不在讨论期间顺手重构别的模块。

### 10.4 CAN/Motor现版的具体精简候选（未实施）

| 代码现状 | 拟商讨的处理 | 必须保留的行为/边界 |
|---|---|---|
| `Motor::read/prepare`内有34秒、2800mA、20～27V台架判断；`app/motor_test.cpp`也管运行时长 | 先决定“协议驱动”与“台架监督”分别负责什么；业务阈值集中一个位置，或明确Motor就是当前设备控制器，避免两处共同计时 | 职责迁移不等于删除已接受的停止行为；失联保护仍须有效 |
| `start/read`异常时请求停止，应用catch再次请求停止，析构还会尽力停止 | 审查一次故障可能经过的路径，确定一处主动处理和必要兜底，合并重复处理/打印 | F6已发但ACK丢失仍按可能运动处理；停止失败不能继续喂旧运动心跳 |
| `start()`调用完整`read()`，每次读位置/速度/电流/状态，另查心跳；`prepare()`已有部分检查 | 讨论启动必需的新鲜检查与运行反馈采样，各保留需要的字段，减少无用查询；不先建缓存框架 | 不能拿旧准备结果冒充当前静止/故障状态；查询减少需回归 |
| `ready_`、`moving_`和运行时间共同记录状态 | 用正常、故障及停止失败路径核对每个状态是否必要，再决定是否合并；不机械换成更复杂状态机 | 必须区分未准备、可能已运动、停止未确认；不能为省变量丢信息 |
| `Can::receive`与`Motor::exchange`各有期限循环 | 核对底层等待和上层应答匹配的必要性，讨论更直白的deadline传递；不因有两个循环就认定重复 | NOTICE/无关帧不能无限延长一次请求；收发层保持不理解电机协议 |
| `query()`是对两字节请求的短封装；两文件各有局部`require()` | 以阅读体验决定保留/展开，不为几行建公共工具头 | 简短封装本身不自动算冗余；CAN与Motor边界仍有价值 |
| Can/Motor资源对象禁止复制，并含析构 | 先在头文件草案中比较类与普通函数对资源生命周期的表达，不默认“去掉类才最小” | 不重复关闭fd、不遗失退出时处理；不新增抽象基类或继承 |

本轮生产代码改动0行，没有执行上述候选优化、运行硬件或提交。当前待办和精简方案尚需逐模块商定，不能把本节当成用户已批准的全部实现方案。

### 10.5 逐方法审查与决策记录（2026-10-14）

用户最新要求：先保存已实现/已验证事实，再逐方法敲定保留、去掉及写法。10.4仅为问题候选，尚无逐方法删除决策。项目长期记忆已记录在AGENTS.md当日条目；完成度仍以10.1和证据为准，以下不重列整项目待办。

**工作方式：每次讨论一个方法，当前模块相关方法全部定案后，汇总头文件与调用例，再按确认范围实现。** 若方法依赖一个尚未决定的错误接口或生命周期规则，先将该点记为待定，不为赶进度猜定其他方法。

讲解要求（2026-10-14用户补充）：每次询问意见必须同时展示当前方法的完整代码；先解释执行顺序，再说明保留/删除/改写的理由。修改草案也应展示完整方法并明确尚未实施，不能只给签名或零散片段。

每个方法的记录固定为：现有职责和调用者 → 必要输入/输出 → 保留/删除/迁移项及理由 → 拟写的短代码或伪代码 → 失败处理与验收 → 用户结论/日期。状态用“待讨论、讨论中、已定案、已实现、已回归”；未收到用户选择，不从建议升级为定案。删掉的方法也记录调用者改到哪里。

| 顺序 | 当前方法/声明 | 这次要扣清的问题 | 状态 |
|---|---|---|---|
| C1 | `Can::Can(interface)` | 打开接口还是也配置接口；参数、socket/bind、错误订阅、失败释放；初始化失败如何交给调用方 | 已实现/已离线验证：teaching/内，提交8ea1bef；详见10.8 |
| C2 | `Can::~Can()` | fd由谁持有/关闭；是否还需要显式close；避免重复释放 | 讨论中 |
| C3 | `Can::send(frame)` | 直接传can_frame还是ID/数据；帧类型和长度检查；发送结果及是否重试 | 待讨论 |
| C4 | `Can::receive(frame, timeoutMs)` | 接收范围、期限、超时与总线错误表达；空状态通知兼容保留在哪里 | 待讨论 |
| C5 | CAN局部`require()`及禁止复制声明 | 便于理解还是多一层跳转；资源唯一所有权怎样表达，不为去重新建通用层 | 待讨论 |
| M1 | `Motor::Motor(can, node)` | 总线引用与生命周期；节点/CAN ID映射及节点检查；构造不运动 | 待讨论 |
| M2 | `Motor::exchange(bytes, replyLength)` | 发送/匹配/解析分别归谁；总期限与Can接收期限关系；失败后上报什么 | 待讨论 |
| M3 | `Motor::query(code, length)` | 两字节命令封装是否值得保留；展开后调用是否更清楚 | 待讨论 |
| M4 | `Motor::prepare()` | 哪些核对属于协议，哪些属于台架；临时心跳设置及回读；重复检查如何安排 | 待讨论 |
| M5 | `Motor::start(signedRpm)` | 启动前最少新鲜检查；F6一次；ACK丢失按可能运动处理；符号/加速度输入 | 待讨论 |
| M6 | `Motor::read()` | 必需反馈字段、查询数量、单位；监测策略放哪里；故障锁定由谁负责 | 待讨论 |
| M7 | `Motor::stop()` | 发停止与确认停止是否同一方法；超时/零速次数；停止失败后行为 | 待讨论 |
| M8 | `Motor::stopOnFailure()` | 与应用异常路径是否重复；谁负责主动停止、谁负责兜底 | 待讨论 |
| M9 | `Motor::~Motor()` | 是否执行通信和等待；与显式stop的责任及失败可见性 | 待讨论 |
| M10 | Motor局部`nowMs/number/require`、状态字段及禁止复制声明 | 辅助函数是否必要，状态是否可合并；不只数方法漏掉跨方法冗余 | 待讨论 |
| A1 | 应用`main()` | 初始化/运行/停止唯一顺序；时长/阈值归属；异常停止是否重复 | 待讨论 |
| A2 | 应用`integer/print/onSignal` | 参数转换、必要显示、信号请求分别是否保留及最直白写法 | 待讨论 |

**C1首份建议：CAN初始化（不是已批准实现）**

- 当前调用者：阶段入口和现有测试先建立Can对象，再把同一对象交给Motor。现参数为接口名，如`can0`；正常构造后可收发，失败抛异常。
- 建议保留：一个接口名；名称基本检查；打开socket；取得接口索引并bind；订阅真实CAN错误；后续步骤失败时关闭已打开的fd。
- 建议职责止于：打开已配置的接口。速率500kbit/s和接口启用由板端启动步骤负责，初始化不另起shell配置，也不查电机模式、不使能、不运动。
- 现有构造中没有自动扫接口、线程、队列或重连逻辑，不能把这些当成“已经删除的冗余”；本次暂不新增。
- 待用户选择：继续使用具体Can对象的构造/析构表达生命周期，还是改为显式open/close普通函数；错误延用异常还是统一返回值。先讨论教学阅读习惯和调用方式，不先改名称/代码。
- 预期实现顺序：检查接口名 → socket → 接口索引 → bind → 错误帧订阅；中途失败释放fd并报告失败。具体代码在接口/错误方式商定后写入本条。
- 验收：有效接口能打开，错误接口有明确失败，无初始化发送帧，失败不泄漏fd。继续复用现有测试入口，当前不发实机命令。
- 用户结论：尚未给出。生产代码保持现状。

C1讨论进展（2026-10-14）：用户要求去掉require封装，并明确不需要开头的接口名称判断，理由是教学调用会写正确名称。当前方法草案改为直接if判断系统调用结果，移除开头名称判空/长度检查；调用契约为有效、长度小于IFNAMSIZ的接口名字符串（教学示例固定"can0"）。这不表示socket/ioctl/bind等系统调用一定成功；它们的处理和try/catch尚在讲解商讨。仅C1当前草案采用此结论，不据此批量删除其他模块的参数检查。用户要求逐步讲清后续代码的原因与原理；完整方法尚未最终定案，源码未修改。

### 10.6 开源依据与教学取舍（2026-10-14）

用户要求吸收同方向开源项目与成熟设计经验，再逐方法选择最适合本项目的教学方案；不以主观偏好、最少行数或开源项目名气宣布“最优”。评价顺序为本项目功能/协议正确、可逐步解释、与现有调用一致、维护负担和规模；实物效果仍单独验证。

本轮已阅读的一手资料：

| 来源 | 实际阅读范围/可借鉴内容 | 本项目取舍 |
|---|---|---|
| [Linux SocketCAN官方文档](https://www.kernel.org/doc/html/latest/networking/can.html) | socket/bind/read/write、接口编号0表示所有接口、错误帧默认不接收；原理例子明确省略错误检查 | 沿用系统API，不自造设备层；错误订阅依据本项目真实CAN故障保留 |
| [linux-can/can-utils的cansend.c](https://github.com/linux-can/can-utils/blob/master/cansend.c) | 阅读实际源文件：if_nametoindex、系统调用检查、顺序收发；还包含FD/XL和命令行解析 | 借鉴直接系统调用与名称查询；不搬入FD/XL、命令行帧解析或只发不收的过滤设置。该工具退出进程的处理不能直接代替长驻对象资源释放 |
| [ODrive ros2_control接口说明](https://github.com/odriverobotics/ros_odrive/blob/main/odrive_ros2_control/README.md) | 阅读README：SocketCAN、多电机、全局接口名和每关节node_id；文档也明确错误反馈待完善 | 借鉴总线/节点边界；未审计整个实现，不将此项目称为全面验证的范本；不引入ROS2插件或套用ODrive协议 |
| [ZDT_EmmV5_Driver](https://github.com/RyanZhangK/ZDT_EmmV5_Driver) | 阅读README：第三方STM32 HAL串口实现，传输与电机操作分文件 | 同类项目结构参考，非厂家权威协议来源，也非Linux CAN实现；不照搬其参数范围/单位，当前协议以厂家资料和本机已验报文为准 |

C1建议修订（尚未定案）：保持当前Can对象接口不变，采用if_nametoindex替换ifreq/strcpy/ioctl；不加用户已否决的名称防御检查。绑定与错误订阅分别写if，以便学生理解和定位失败；撤回上一版为省行数将两个系统调用并入一个if的建议。初始化失败仍释放资源；异常返回策略延用现有调用，仅为控制本轮改动范围，不宣称异常比返回值普遍更适合教学。源码未改。

后续每次方法评审同时给出：开源依据、与本项目的差异、完整方法草案、保留/删除理由。普通系统API调用可独立编写；若直接复用开源代码，实施时固定来源版本并保留适用许可证。链接检索日为2026-10-14，未以浮动master链接宣布依赖版本冻结。

### 10.7 C1用户定案（2026-10-14）

用户确认原文：“这版我已经可以接受了”。批准范围为以下完整CAN构造方法：保留接口名参数，使用if_nametoindex；无名称判空/长度检查、require或try/catch；各系统操作分别判断失败，绑定/错误订阅失败关闭句柄并抛出异常。此结论覆盖10.5及10.6中C1的待定草案，不代表其他方法或全项目错误处理已批准。

```cpp
Can::Can(const char* interface)
{
    // 根据名称取得CAN接口编号。
    unsigned index = if_nametoindex(interface);
    if (index == 0)
        throw std::runtime_error("CAN接口不存在");

    // 创建非阻塞CAN通信句柄。
    fd_ = socket(PF_CAN, SOCK_RAW | SOCK_NONBLOCK, CAN_RAW);
    if (fd_ < 0)
        throw std::runtime_error("创建CAN连接失败");

    // 绑定到指定CAN接口。
    sockaddr_can address{};
    address.can_family = AF_CAN;
    address.can_ifindex = index;

    if (bind(fd_, reinterpret_cast<sockaddr*>(&address),
             sizeof(address)) < 0) {
        close(fd_);
        throw std::runtime_error("CAN绑定失败");
    }

    // 允许接收CAN总线错误信息。
    can_err_mask_t errors = CAN_ERR_MASK;

    if (setsockopt(fd_, SOL_CAN_RAW, CAN_RAW_ERR_FILTER,
                   &errors, sizeof(errors)) < 0) {
        close(fd_);
        throw std::runtime_error("CAN错误订阅失败");
    }
}
```

状态：设计已定案、尚未实施。按当前模块方法商定后统一修改的约定，源码暂留原版本。下一项C2析构建议保持单次close(fd_)，不增加显式close入口或状态分支；待用户审议。

### 10.8 教学分支实施记录（2026-10-14）

用户更新推进方式：从空白教学代码开始，第1提交为需求与技术栈；第2提交起每确认一个接口就实现、验证并提交一次，每次提交正文详细解释设计原因。本轮已执行，覆盖10.5/10.7此前等待整模块完成的规则。未商定接口仍不得提前实现；已有认可不重复询问。

分支codex/teaching-interfaces，路径teaching/；原robot等实验代码保留，没有全仓清理或归档。只将新教学项目选定文件纳入提交。

| 次序 | 提交 | 内容 |
|---|---|---|
| 1 | 67bd29a | 项目需求＋技术栈初步调研，仅2份文档 |
| 2 | 8ea1bef | C1构造方法（与10.7批准代码一致）、必需头文件及阶段边界说明 |

C1已通过主机/ARM目标文件编译、隔离vcan成功打开与不发帧检查、接口不存在及绑定非CAN接口失败时的fd回收检查。未测试真实硬件；socket创建和订阅失败未故障注入。关闭/析构尚未实现，因此本阶段不是完整可长驻运行的库，成功路径测试进程退出时回收socket。详情在提交正文与output/teaching-interfaces/verification.json。

当前下一项仍为C2析构/关闭，不自动实现。提交详细说明约定已写入teaching/README.md。没有远端配置或推送，本地接口提交不等于最终冻结。
