lst92991-eng/four-axis-robot-arm/research/hardware-input-notes.md

# 已提供机械资料与软件选型边界

## 初次提取记录（2026-10-08）

资料：用户提供的 `尚硅谷嵌入式项目之四轴机械臂2026.0917.zip`。用户已明确机械硬件方案确定。本轮只读目录与物料表，不修改原包，也没有在 SolidWorks 内打开总装或求解装配关系。

原文件：`D:/App/WeChat/chat_data/xwechat_files/wxid_q6cgqi9xjpft22_691b/msg/file/2026-10/尚硅谷嵌入式项目之四轴机械臂2026.0917.zip`。

包大小 20,216,885 字节；SHA-256 为 `6e82640044d92745a4cce0fdaa148ae4fd66cf0a6610798295a6f7aebefe1209`。这里的哈希仅用于标识输入资料，不是用户项目的代码冻结或复现验收。

90 个文件包含：58 个 SLDPRT、2 个 SLDASM、9 个 SLDDRW、8 个 DWG、9 个 STEP、2 个 JPG、1 个 XLSX、1 个嵌套 ZIP。主装配位于 `资料/SCARA四轴机械臂机械结构V1.1/SCARA四轴机械臂总成.SLDASM`；另一个装配体为轴承座。未发现控制源码、电路原理图、主控说明或摄像头说明。

物料表 `SCARA四轴机械臂总成 物料明细表.XLSX` 的 `物料清单汇总` 表中：

| 来源单元格 | 记录 | 能支持的结论 |
| --- | --- | --- |
| C8:D8 | 42步进电机L60，3 件 | 机械 BOM 中有 3 个该规格的电机 |
| C21:D21 | 42步进电机L40，1 件 | 另有 1 个该规格的电机 |
| C9:D9 | DLE42-L2BJ-长款50，1 件 | 有此型号零件，不能仅凭名称推定实际传动比 |
| C27:D28 | GT20、GT60 同步轮，各 1 件 | 存在同步带传动零件，具体轴与传动关系需从装配核验 |
| C47、P47 | T型丝杆500MM，包络 500×16×16 | 500 是丝杆零件长度，不能当成 Z 轴有效行程 |
| C19/P19、C20/P20 | 第二机械臂包络 330×60×10；J1机械臂包络 250×60×10 | 这是零件包络尺寸，**不能用 330、250 直接作为转轴中心距** |

本轮尚不能从这些资料确定：电机驱动的 STEP/DIR 或总线接口、主控型号、细分与减速配置、相机平台、末端吸盘/夹爪、回零和限位传感器、各轴实际限位、轴中心距、Z 有效行程、第四轴正方向/传动耦合。

因此软件建议以既有机械结构为前提。下次机械核验应先取得真实关节中心和装配关系，建立 J1/J2/Z/R 的坐标与单位约定，再核验棋盘四角、供子区、弃子区和整条运动路径。末端点可达不代表手臂连杆不会扫过人手或立柱。

完整目录与只读物料单元格提取见 `hardware-archive-inventory.json`。价格和购买链接不是本轮选型依据，未做当前价格核验。

## 传动结构复核（2026-10-09）

直接读取原始 XLSX、嵌入的零件图片、采购超链接，并对照 SolidWorks 零件实体、装配轴线和配合。原表只有一个工作表，无额外批注或嵌入说明文档。只读副本为 `mechanism/bom-original.xlsx`，与原始 ZIP 内 XLSX 的 SHA-256 一致：`a127472e85306e2ad5f825bf92eadf67cd0f0d8821d4d85861f71e27f169005b`。原始装配和运行程序没有修改。

| 轴 | 资料中的传动结构 | 结论与限制 |
| --- | --- | --- |
| J1 大臂 | 42步进电机L60-2、DLE42-L2BJ-长款50、8mm键槽法兰、J1机械臂 | DLE42系列行星减速器。输出轴经键槽法兰固定于Z滑台，壳体、电机与J1臂一起转动，是反装结构。不能套用输出轴带动大臂的普通安装方向。 |
| J2 小臂 | 42步进电机L60-3、GT20/GT60同步轮、同步带、61mm光轴 | 设计意图是小轮驱动大轮后转动第二臂。BOM名称对应20/60齿时名义为3:1，但CAD并未建真实齿形；CAD皮带配合使用13/40.6mm直径，得到3.1230769，不能将该动画比例直接用于实物换算。 |
| Z 升降 | 42步进电机L60-1、8-16联轴器、T型丝杆及螺母、MGW12导轨滑块 | 螺母连接L型支架，带动整套臂升降。500mm是丝杆零件长度；现有加工图没有提供可据以确定每转位移的导程。 |
| R 末端旋转 | 42步进电机L40-1安装于第二机械臂末端 | 当前装配没有额外末端减速器，按直接输出的设计意图理解。末端完整工具和真实夹持仍需实际结构验证。 |

J1反装的引用实体：重合134对应减速器42×42mm壳体端面，Z=1293.753mm；重合336对应10×10mm轴肩面，Z=1290.253mm，贴合键槽法兰顶部。法兰由重合335及同心254/255安装孔固定到L型底座。L60-2与减速器输入壳体通过重合381和安装孔定位。

另发现J2未闭合的装配细节：GT60与61mm光轴共轴；GT20轴线与L60-3电机轴线偏离约3.2075mm，电机模型轴径5mm而小轮孔径8mm。因此只能确认该传动拓扑的设计意图，不能宣布小轮与电机已在CAD中正确配合或实物能直接装上。

DLE减速比证据：C9名称为“DLE42-L2BJ-长款50”，D9数量1，L9品牌及M9型号列为空。零件只有默认配置，导入特征名为“DLE42-L2BJ-长款1.STEP<1>”，没有独立50:1属性或内部齿数。50:1仍是选型名称暗示的候选值，未作为已经验证的驱动换算参数。采购链接未能读取；不使用其他DLE42子型号的背隙、扭矩或品牌来填空。

DLE42行星类别可对照[厂家同系列资料](https://www.gdszsl.com/products/xingxingjiansuji/xxjsbjytjxl/2022_0808/101.html)，该对照不证明本BOM实际采购品牌。BOM提取、嵌图和CAD复核证据保存在 `mechanism/`。
