lst92991-eng/four-axis-robot-arm/hardware/xiangqi30-old195275-2026-10-12/delivery-front-2026-10-13/README_先读我.md

# 旧版 SCARA + 30 mm 中国象棋参考总装

本包用于在 SolidWorks 中设计摄像头支架、观察棋盘/标记与原机械结构的空间关系。SolidWorks 2026 原生格式；旧版肩肘轴距为 **195 + 275 mm**。

## 打开

先把 ZIP **完整解压**到一个普通文件夹，再打开 `SolidWorks/SCARA_FRONT_195_275_CHESS30.SLDASM`。不要只从压缩包拖出单个 SLDASM。该目录包含全部外部引用，另附 STEP 和实际模型预览。

顶层共 38 个组件：1 个旧机械臂子装配、1 块棋盘、32 枚棋子、4 块独立 ArUco 标记。新增组件按参考摆位固定；原机械臂仍作为独立原生子装配保存，内部配合保留。

## 本包几何参数

| 项目 | 模型值 | 依据 |
|---|---|---|
| 棋子直径 | 30 mm | 用户要求；市售同直径圆饼形象棋可查 |
| 棋子高度 | 8 mm，文字凸起 0.10 mm | 参考建模假设，不是已购实测 |
| 棋盘外形 | 315 × 350 mm | 30 mm 木盘套装的商品标称参考 |
| 棋盘厚度 | 14 mm | 参考假设，使棋盘底面与原 CAD 基座底面等高 |
| 交点格距 | 横纵均 35 mm | 本模型的明确设计值，不冒充商品实测 |
| 最外侧交点跨度 | 280 × 315 mm | 9 列、10 行，共 90 个交点 |
| 棋子相邻静态间隙 | 5 mm | 格距减直径，不是抓取动态净空 |
| 黑色编码区 | 48 × 48 mm | OpenCV 5.0.0，DICT_4X4_50，ID 0/1/2/3 |
| 标记白边 / 裁切外形 | 四周 6 mm / 60 × 60 mm | 白边必须保留 |
| 棋盤和标记总包络 | 450 × 485 mm | 沿棋盘局部横纵方向测量 |

外观参考采用浅色圆饼、红黑字。没有把某个网上商品的外形等同于电磁铁可抓取：真实棋子必须另行确认吸附与断电释放。配套棋盘到手后应核对外形、实际格距、厚度；如不一致，应调整参考模型后再定支架，不要把这份假设模型当作供应商尺寸图。

商品参考来源：

- [先行者京东目录](https://www.jd.com/hprm/13182defe8218dd5eb68.html)：可查磁性亚克力中国象棋 AX-7 的 **30 mm** 规格；未由该目录推断棋盘格距。
- [天宝堂 30 mm 木盘象棋套装](https://item.rakuten.co.jp/tenpodo/ms221208a14/)：公开索引标注棋子直径 30 mm、木盘约 **315 × 350 mm**。仅作为常见尺寸与外观参考，不表示已购、已实测或磁性兼容。

## 摆位坐标

沿用项目已有基座右手坐标，单位 mm：

```
X = 0.508123 - CAD_X
Y = -155.215866 - CAD_Y
Z = CAD_Z - 1000
```

按用户最新圈选图片，棋盘调整为机械臂正前方居中，黑方靠近机械臂，红方朝向操作者。参考中心为基座 `(0,280,0)` mm，局部横轴相对基座 X 轴旋转 180°。对应原 CAD 中心 `(0.508123,-435.215866,1000)` mm。棋盘表面为 CAD Z=1000 mm，底面 Z=986 mm。280 mm 是根据图片采用的摆位参数，不是用户实测距离。

棋盘局部原点在板中心，+X向棋盘右侧、+Y向黑方底线。四个标记中心：ID0=(-195,212.5)、ID1=(195,212.5)、ID2=(195,-212.5)、ID3=(-195,-212.5) mm；编码朝向相同。纸面上的上边对应局部 +Y。

模型中的印刷线用 0.04～0.10 mm 的薄实体表示。棋子底面在板面上方 0.10 mm，用于避开这层显示用的“油墨”，不是抓取净空或制造间隙。

独立标记实体采用 14 mm 高白色参考垫块，让标记面与棋盘表面共面。实物可用轻质垫片/泡沫/支撑片实现，不要求实心打印；纸标记直接贴在比棋盘低 14 mm 的桌面上，会引入平面标定偏差。

该正前方摆位在现有旧机 4° CAD 碰撞采样中有 **86/90** 个交点取得至少一支逆解的支持；`(-35,122.5)`、`(0,122.5)`、`(35,122.5)`、`(0,157.5)` mm 这 4 个近侧点尚未通过该保守初筛，不能当作实机可抓点，也不能仅凭采样不足断言数学上不可达。图片位置优先保留；待低头螺丝等改型落实后再复核。旧侧向斜放的90/90结果不套用于这个新摆位。

本包保留现有旧机螺丝，没有擅自改成3.82 mm头高。对已有CAD网格的测量显示，G1板底高283.7535 mm（相对CAD Z=1000 mm），两颗限位螺丝的承压面高277.8535 mm；6 mm头高顶面283.8535 mm，原先高出板底0.10 mm。若承压面不变而改为3.82 mm头高，理论间隙约2.08 mm。这个判断只解除这对螺丝与G1臂板的干涉；尚未重新扫描整机工作区。

原CAD的伸直展示姿态会遮挡部分棋盘；实际视觉拍摄需先把机械臂移到经过验证的避让位。静态摆位、拍照避让位和连续取放路径分别验证，总装不会自动改变真实电机参数。

## 摄像头支架设计时使用哪些量

相机应覆盖整个 **450 × 485 mm** 标记外包络，并留出安装误差余量；不要只按 280 × 315 mm 落子网格计算视场。模型没有把相机高度冻结为某个已验证数值。

既定相机是 MIS5001 广角无畸变 B 版，MIPI 排线 160 mm。排线长度限制的是主板与相机之间的布线距离，因此主板需要随相机靠近安装。选支架高度时仍需在实际采集分辨率和有效视场下确认：四码完整、文字清晰、机械臂运动时不遮挡关键画面。网购“无畸变”名称不代替标定。

## 打印标记

`markers/aruco_4_ids_A4_100percent.pdf`：一张 A4 包含 4 块；另有每个 ID 的单独 PDF、PNG、SVG。

选择 **100% / 实际大小**，不要选“适合页面”。打印后用尺核对 50 mm 标尺；每个标记沿裁切记号剪成 60 mm 方形，完整保留白边。不要覆反光膜。

## 文件与验证

`assembly-layout.json` 记录所有新增组件变换及尺寸，`validation.json` 记录重开、引用与文件核对，`SHA256SUMS.json` 提供完整交付文件清单。`preview/` 是实际 SolidWorks 模型导出的视图。

原机械臂内部保留既有装配警告和干涉项，未为取得一个绿色状态而删除原机械配合。新增棋具与机械臂的静态总装检查和原机械结构内部检查分开记录。

**源文件记录：**本次原生 Pack and Go 过程中源 SLDASM 被 SolidWorks 重新保存，文件哈希与此前记录不同；44 个原源零件均与既有 CAD 提取记录的 SHA-256 相同。本包未对源零件做设计改动；新增棋盘、棋子和标记全部写入副本。不能把“零件未变”表述为“源装配二进制完全未变”。

这是可编辑的空间参考总装，不是相机支架成品、采购件完整尺寸认证或实机运动验收报告。未提交或推送 Git。

现成模型候选：mming1106 的 [Chinese chess](https://3dgo.app/models/thingiverse/218414) 列出完整 32 枚棋子，并标注 CC Attribution-Share Alike；[作者原始 Thingiverse 页面](https://www.thingiverse.com/thing:218414)及 [GrabCAD 页面](https://grabcad.com/library/chinese-chess-1)本轮返回访问限制，尚未验证源文件格式、尺寸和许可版本。本包棋具仍是自建参考零件，没有把未取得的模型冒称为已经复用。

## 交付复核结果（2026-10-13）

总装已从交付目录重新打开：顶层38个组件、含子装配195个组件；保存引用与运行时引用均未指向包外。原来依赖临时目录的传动子装配和皮带已改为包内独立原生文件，几何来源仍为原始模型。五张实际CAD预览已检查非空白，STEP已在引用修复后重新导出。CAM加工元数据按用户明确同意在参考副本中不保留。
