lst92991-eng/four-axis-robot-arm/docs/公开归档与J1演示.md

# 公开归档与J1跨电脑演示

日期：2026-11-02。用户明确授权本次现状提交及公开推送，不清理本机资料，不操作实机。

## 保存范围

远端：[lst92991-eng/four-axis-robot-arm](https://github.com/lst92991-eng/four-axis-robot-arm)，公开；默认分支 `main`。本地归档分支 `codex/public-archive-2026-11-02` 保留原来两个教学提交，再保存当前工作区。原教学分支指针保留。

本次包含根目录原项目、`teaching`、`simulation`、`hardware`、`research`、`assets`、`tools`、文档、测试与已有 `output`。此前被忽略的 `output/rv1106`、`output/release`、`output/build-entry-validation` 也纳入，避免丢失运行库、模型和历史交付包。超过100MiB的原生CAD由Git LFS保存，其余文件保持原字节；`.gitattributes`不做文本换行归一化。

不公开：`.git`、`tmp`、构建缓存、`__pycache__`、`.pyc`、`.venv`、本地环境密钥、`tools/robot-viewer/connection.json`、CAD的`~$`锁文件、PID及本次打包/核验的临时副本。原文件均保留在本机。本次不包含独立Ludic工作树，不扩展到项目外用户文件或外部SDK目录。

`public-archive-manifest.json`按项目相对路径记录有效归档文件的字节数与SHA-256。清单自身排除以避免自引用；`.git`不在清单中。哈希用于验证可恢复性，不表示所有旧资料或当前代码都通过实机验收，也不是用户指定的最终冻结基准。首次公开前，对源码/文档及21个已有压缩包中的文本做密钥特征扫描，未发现匹配；个人连接配置另行排除。

完整恢复：

```powershell
git clone https://github.com/lst92991-eng/four-axis-robot-arm.git
cd four-axis-robot-arm
git lfs install
git lfs pull
```

需先安装Git及Git LFS。超长路径电脑建议克隆到短目录；原CAD及其版本使用说明在各自目录内，注意区分历史件、正式交付副本与分析变体。GitHub普通源码ZIP可能只包含LFS指针，不能据此认为115.75MiB的CAD已完整恢复。

## J1演示小包

下载[最新Release中的J1-Windows-x64-Demo.zip](https://github.com/lst92991-eng/four-axis-robot-arm/releases/latest/download/J1-Windows-x64-Demo.zip)，完整解压，双击 `启动Z轴上位机.bat`。软件会准备Python/Tk和USB依赖，随后打开现有面板；不自动使能或开始运动。只需J1演示时无需Git、CAD、OpenCV、CUDA、SolidWorks或RV1106工具链。

离线包包含官方Python 3.11.9 x64安装器，以及gs-usb 0.3.1、PyUSB 1.3.1、libusb-package 1.0.30.0、importlib-resources 7.1.0的wheel。Python安装器和wheel均有固定SHA-256；要求及wheel哈希只维护在面板`requirements.txt`。Python安装器哈希取官方Sigstore bundle；wheel来源PyPI，离线安装不访问索引。附带来源、可获得的许可证/元数据及全包`SHA256SUMS.txt`。

USB驱动、实物接线与现场演示步骤见[面板说明](../tools/z-axis-panel/README.md)。本次没有把驱动安装或CAN连接成功伪装成可全自动完成的依赖安装。适配器仍限定原序列号；节点1为Z，A上升、B下降；导程及Z软限位仍待标定。

## 本次验证与边界

- 原32项Python离线测试通过，不打开USB。
- Windows PowerShell 5.1检查 `-SetupOnly` 与 `-CheckOnly` 通过，不打开GUI/USB、不发CAN命令。
- 从ZIP解压到含空格路径，用独立空依赖目录执行离线安装，固定版本wheel及libusb后端核验通过；Python解释器复用本机已安装3.11，经目录联接隔离依赖路径。这不是全新Windows系统安装器实测。
- Python安装器已下载，并与官方SHA-256一致；新电脑若无Python时的安装流程按官方静默安装参数准备。本次没有在全新Windows上重新安装Python或更换USB驱动。
- 解压后的演示文件逐项校验SHA-256。完整远端提交及大CAD恢复另外核对，不用“push命令运行过”代替归档成功。
- 本次只改启动/依赖/交付说明与归档设置，未改面板运动状态机、停止路径、报文、速度或电流限制，未发送真实电机指令。
