lst92991-eng/four-axis-robot-arm/assets/board/v2/board.png

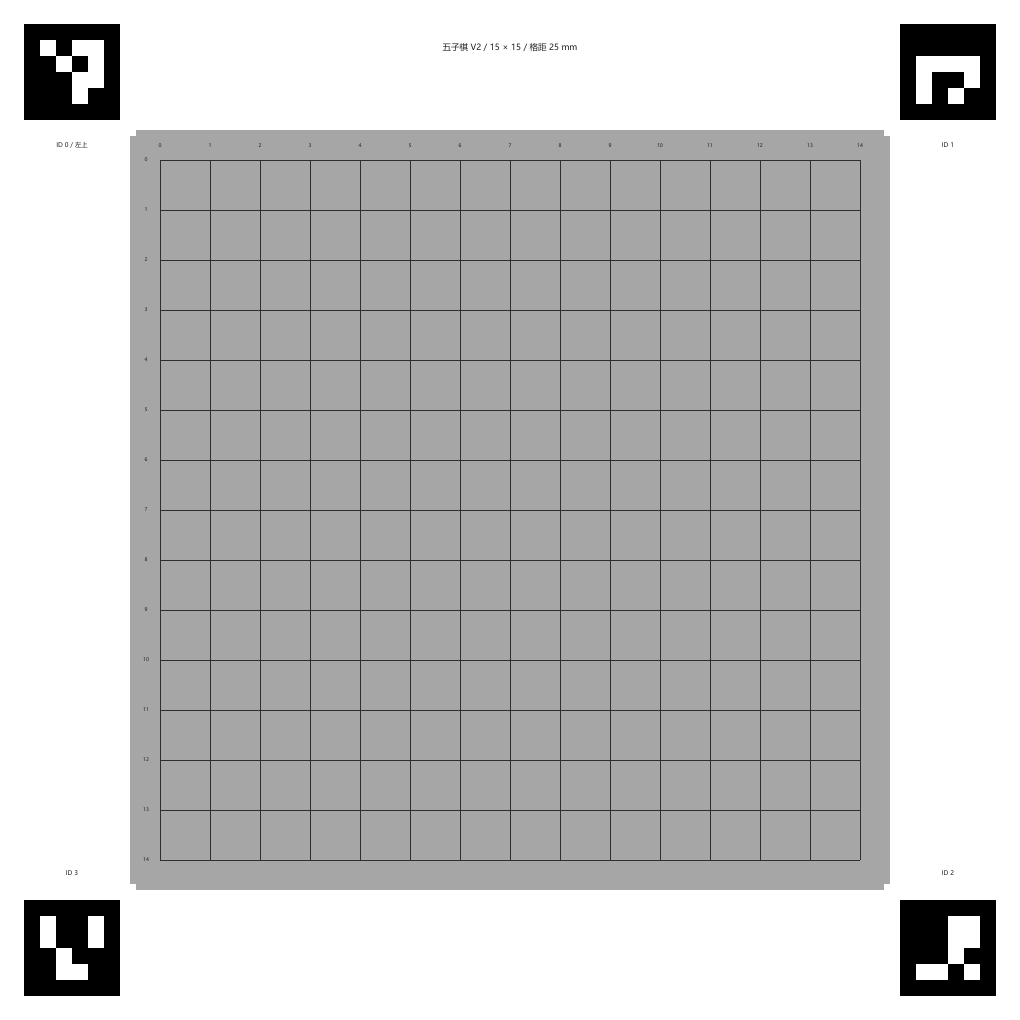
assets/board/v2/board.png
