lst92991-eng/four-axis-robot-arm/assets/xiangqi/board.png

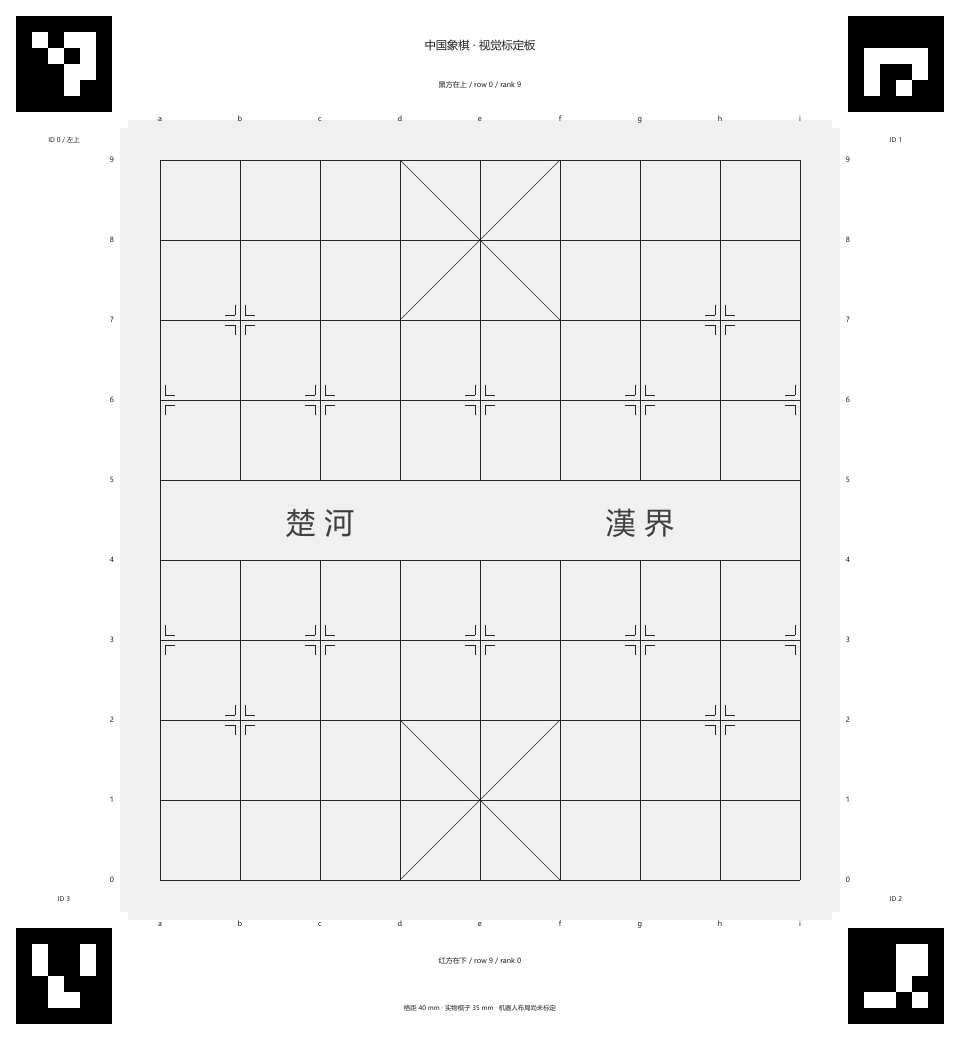
assets/xiangqi/board.png
