lst92991-eng/four-axis-robot-arm/assets/xiangqi/renders/a1-1.png

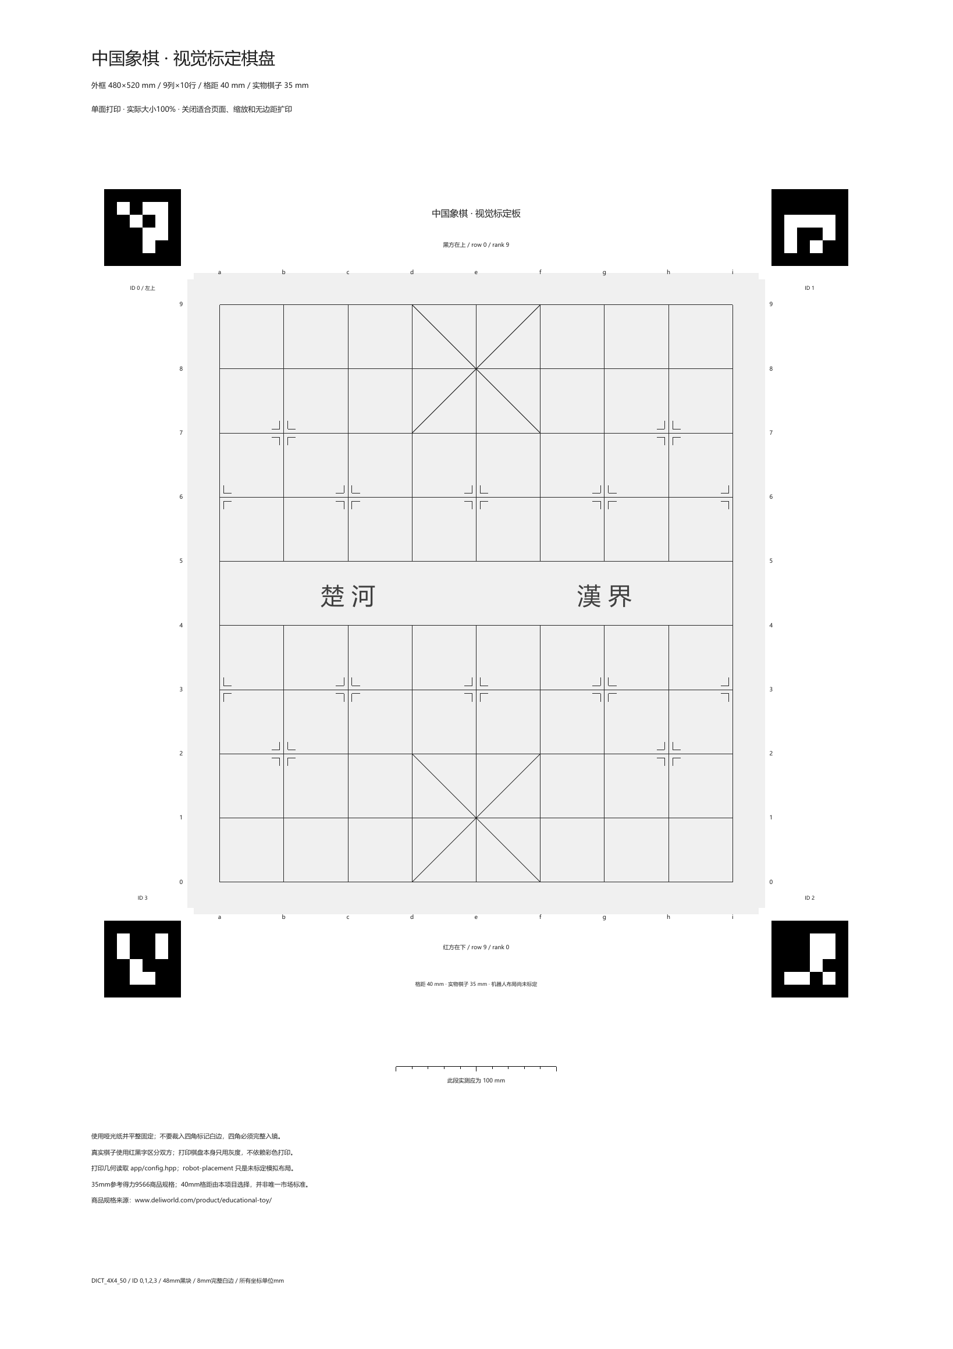
assets/xiangqi/renders/a1-1.png
