lst92991-eng/four-axis-robot-arm/assets/xiangqi/renders/a4-1.png

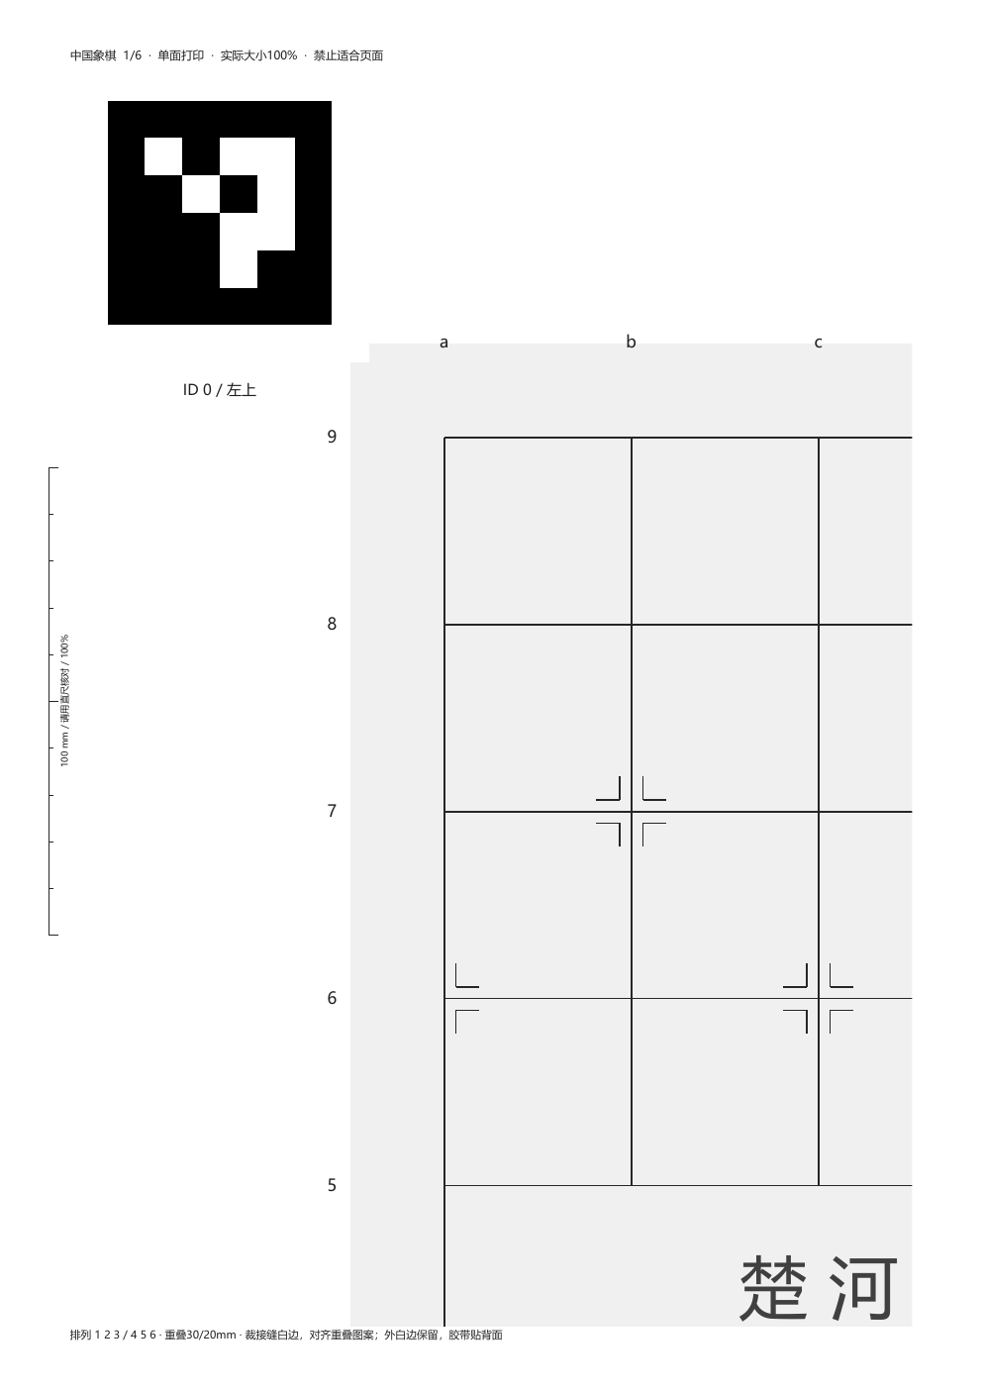
assets/xiangqi/renders/a4-1.png
