lst92991-eng/four-axis-robot-arm/assets/xiangqi/renders/a4-contact.png

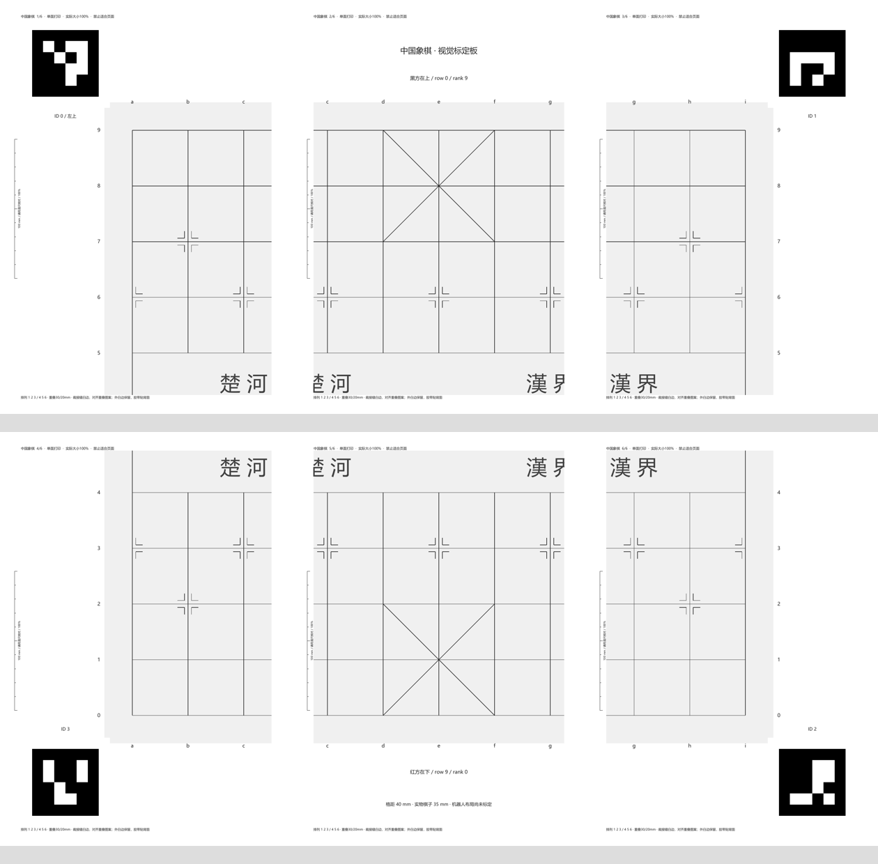
assets/xiangqi/renders/a4-contact.png
