lst92991-eng/four-axis-robot-arm/assets/xiangqi/renders/a4-footers.png

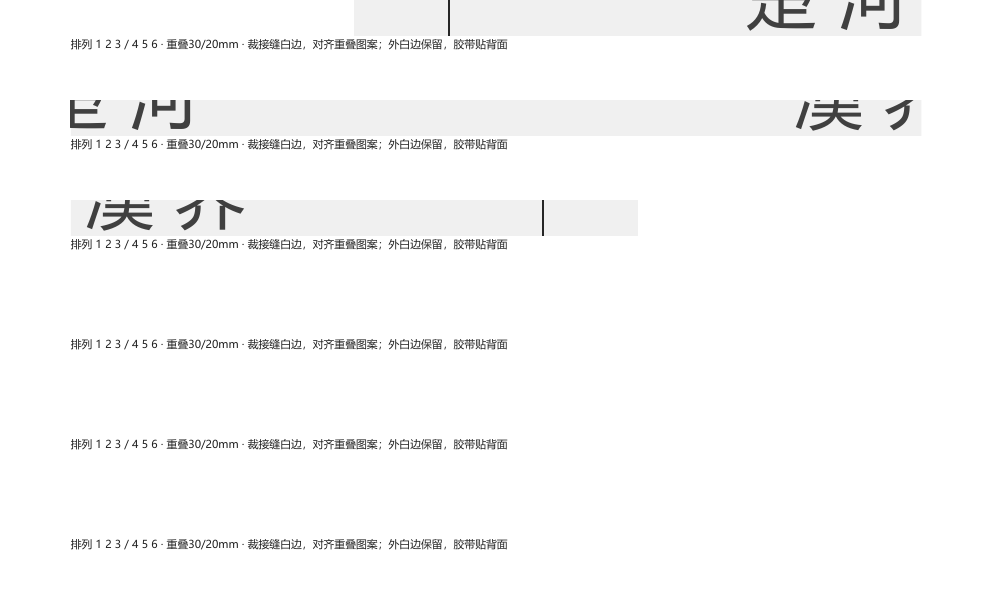
assets/xiangqi/renders/a4-footers.png
