lst92991-eng/four-axis-robot-arm/hardware/arm_equal_275/v1/model-isometric.bmp

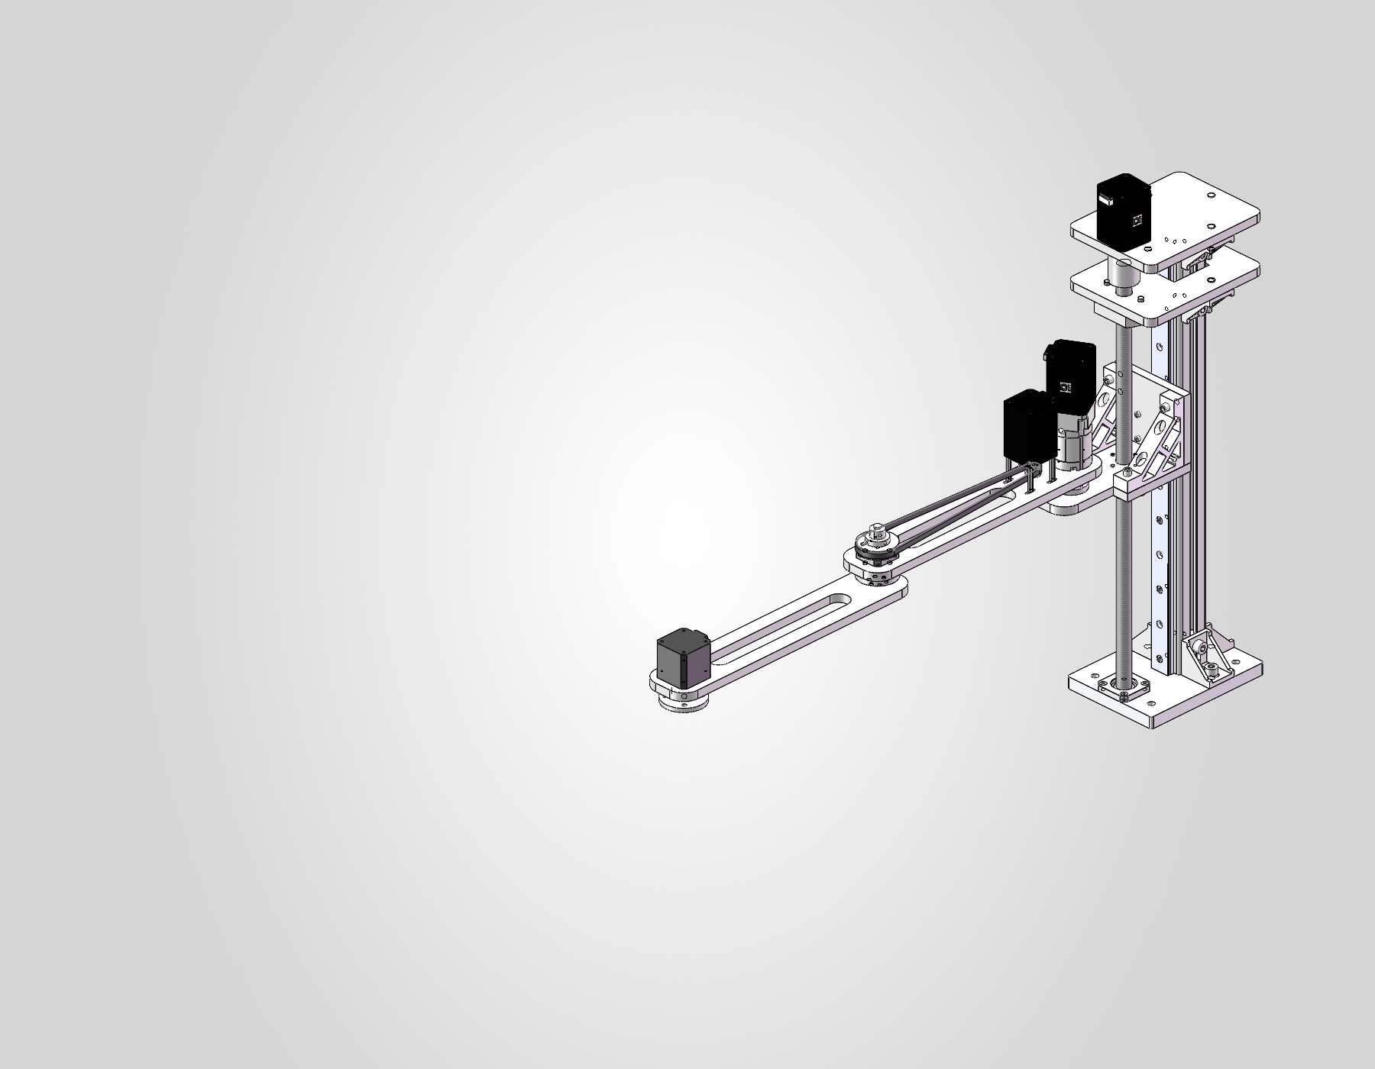
hardware/arm_equal_275/v1/model-isometric.bmp
