lst92991-eng/four-axis-robot-arm/hardware/arm_equal_275/v1/workspace-top-view.png

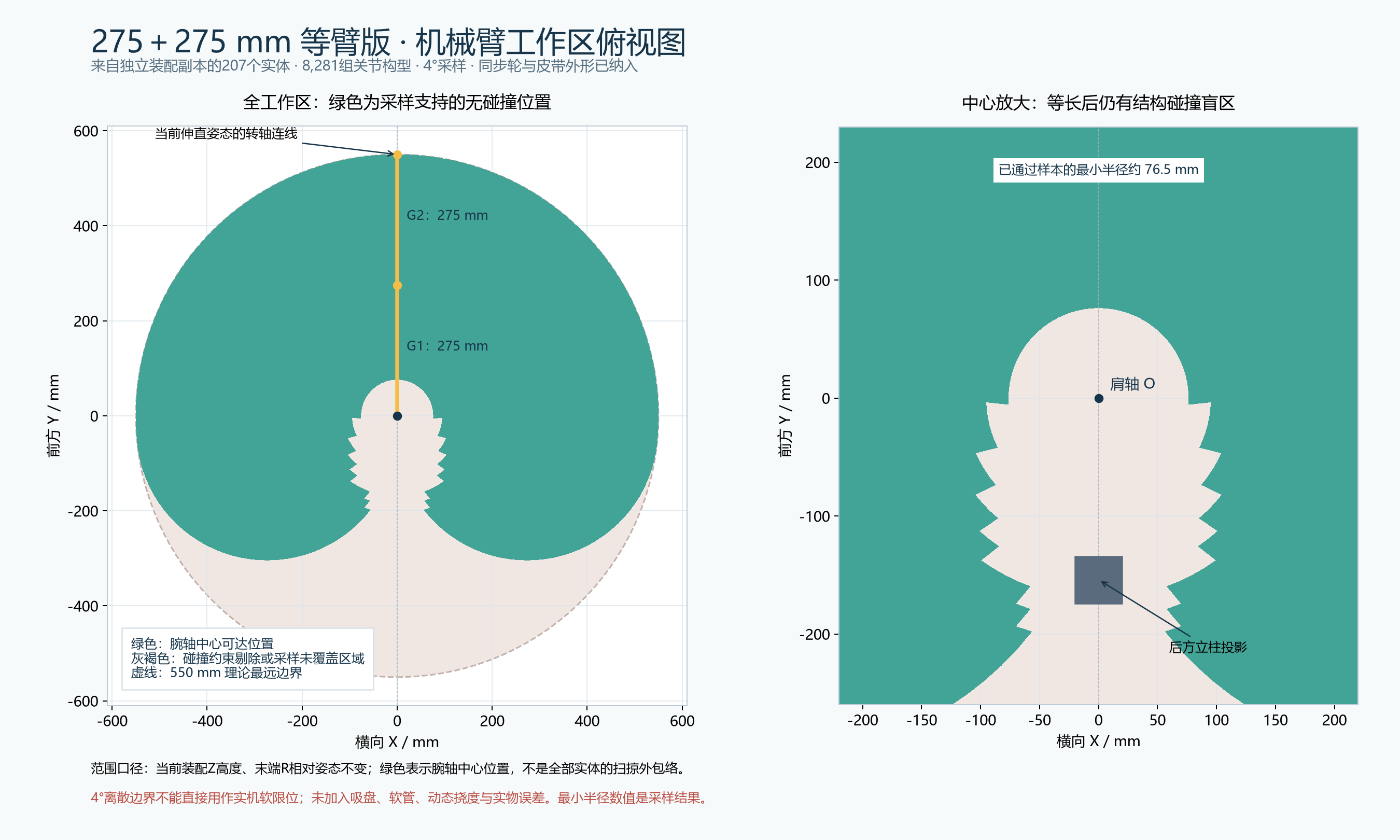
hardware/arm_equal_275/v1/workspace-top-view.png
