lst92991-eng/four-axis-robot-arm/hardware/camera_mount/v2/camera_bridge.bmp

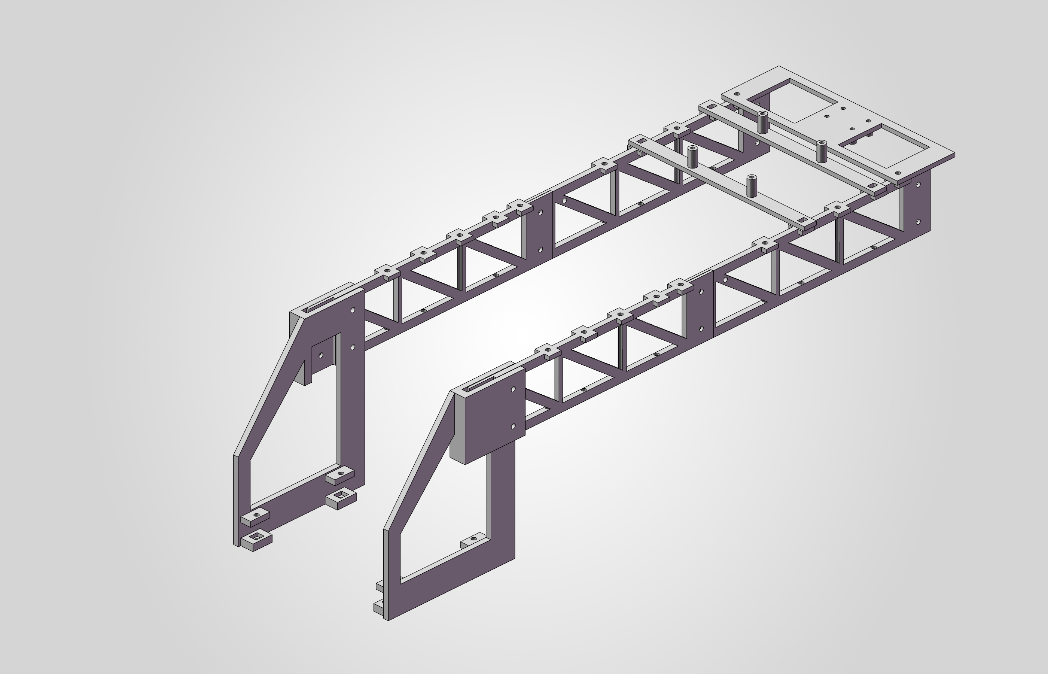
hardware/camera_mount/v2/camera_bridge.bmp
