lst92991-eng/four-axis-robot-arm/hardware/camera_mount/v2/layout_check.bmp

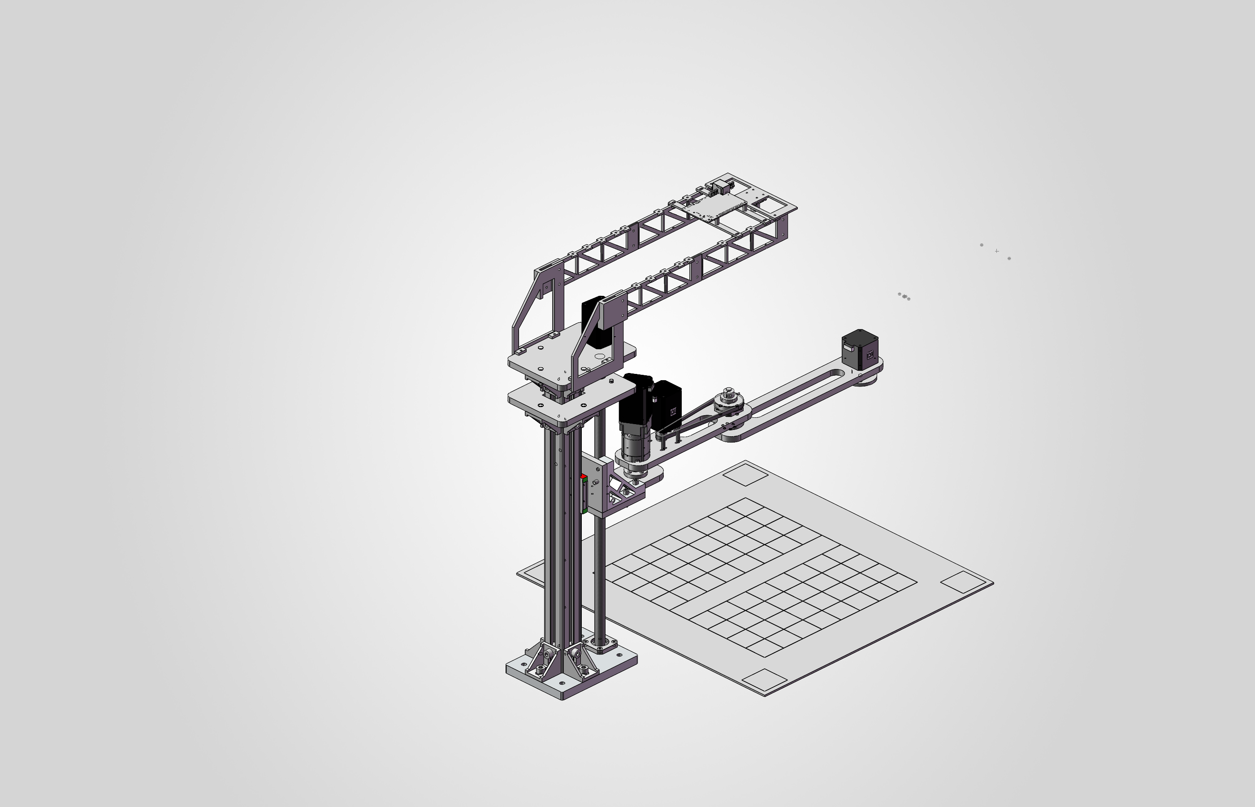
hardware/camera_mount/v2/layout_check.bmp
