lst92991-eng/four-axis-robot-arm/hardware/camera_mount/v2/review/01_clamp_right_isometric.bmp

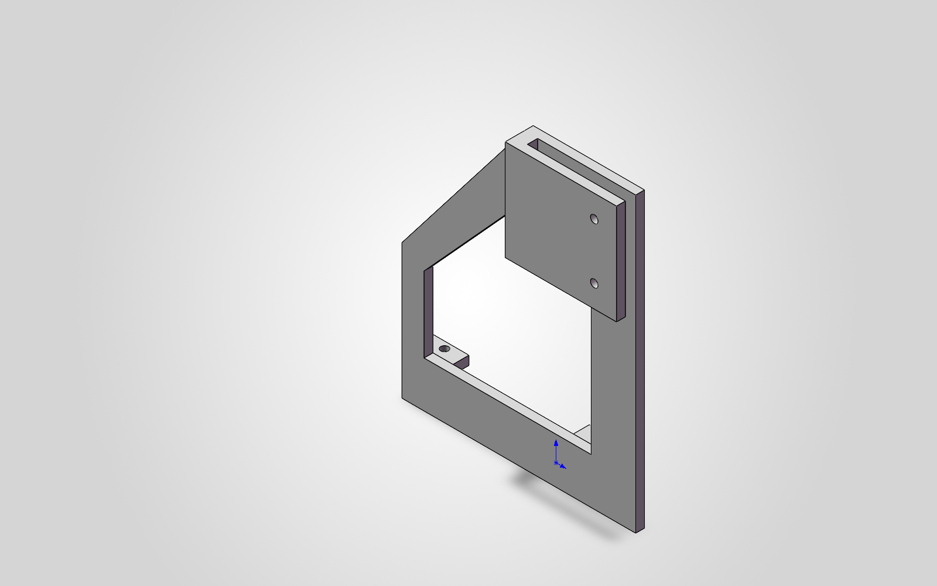
hardware/camera_mount/v2/review/01_clamp_right_isometric.bmp
