lst92991-eng/four-axis-robot-arm/hardware/camera_mount/v2/review/02_clamp_left_right.bmp

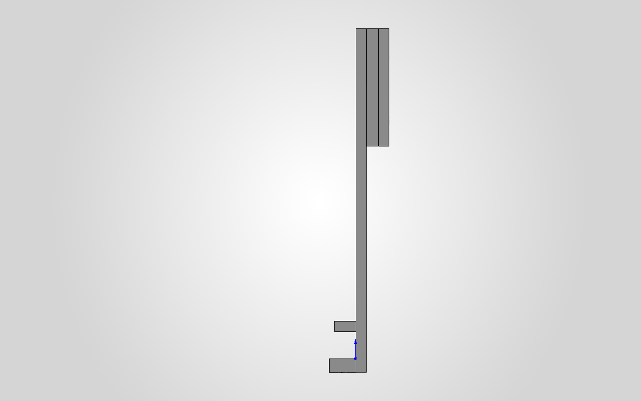
hardware/camera_mount/v2/review/02_clamp_left_right.bmp
