lst92991-eng/four-axis-robot-arm/hardware/camera_mount/v2/review/03_truss_200_right.bmp

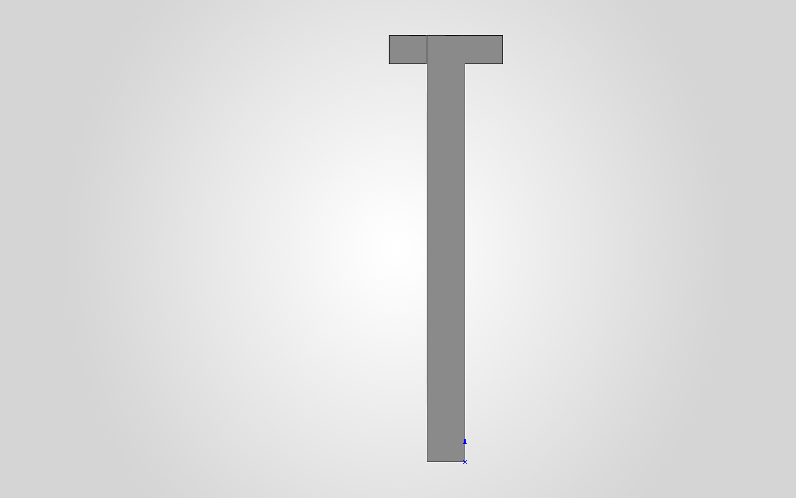
hardware/camera_mount/v2/review/03_truss_200_right.bmp
