lst92991-eng/four-axis-robot-arm/hardware/camera_mount/v2/review/04_camera_B_crossbar_right.bmp

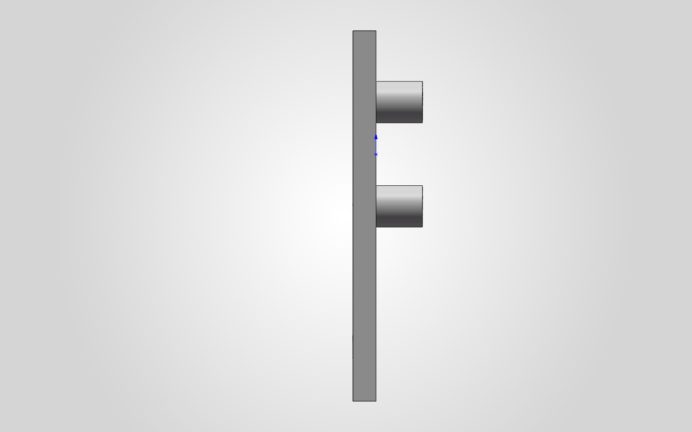
hardware/camera_mount/v2/review/04_camera_B_crossbar_right.bmp
