lst92991-eng/four-axis-robot-arm/hardware/camera_mount/v2/review/05_pcb_support_isometric.bmp

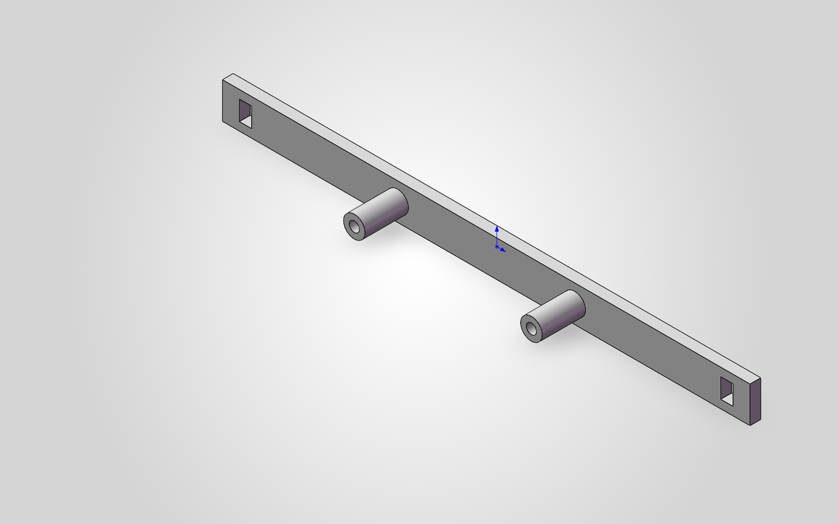
hardware/camera_mount/v2/review/05_pcb_support_isometric.bmp
