lst92991-eng/four-axis-robot-arm/hardware/xiangqi30-long275275-2026-10-13/markers/aruco_id_3_60mm.png

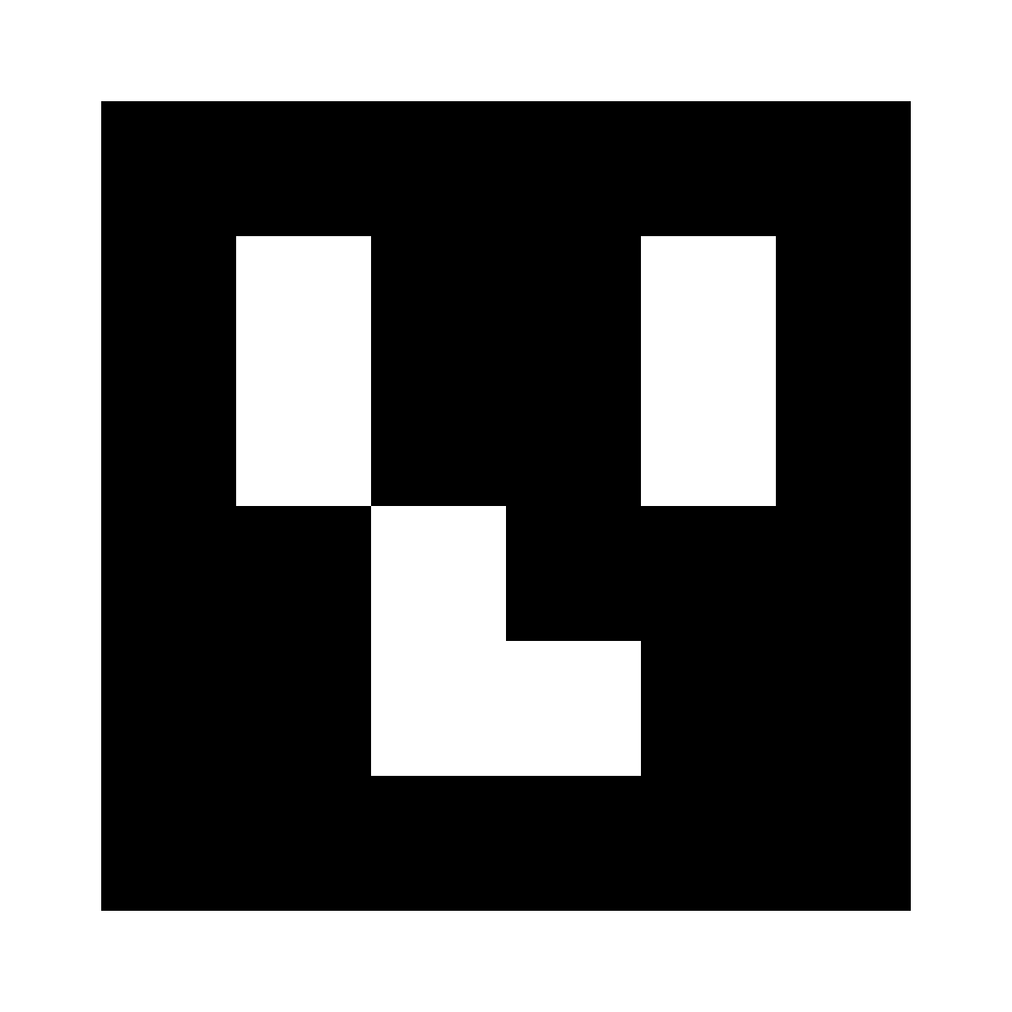
hardware/xiangqi30-long275275-2026-10-13/markers/aruco_id_3_60mm.png
