lst92991-eng/four-axis-robot-arm/output/constrained-workspace-2026-10-09/cad-constrained-workspace.png

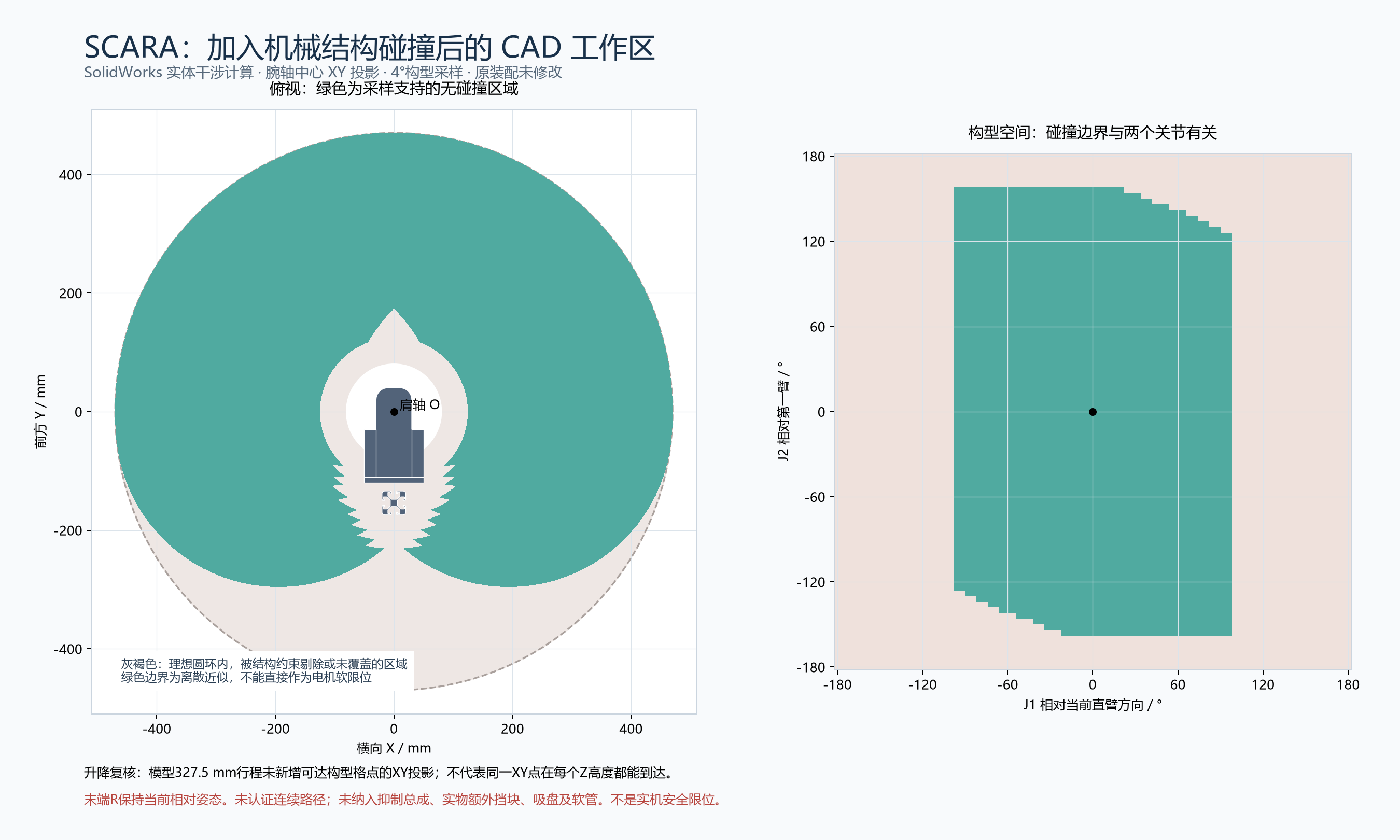
output/constrained-workspace-2026-10-09/cad-constrained-workspace.png
