lst92991-eng/four-axis-robot-arm/output/constrained-workspace-2026-10-09/collision-witnesses.png

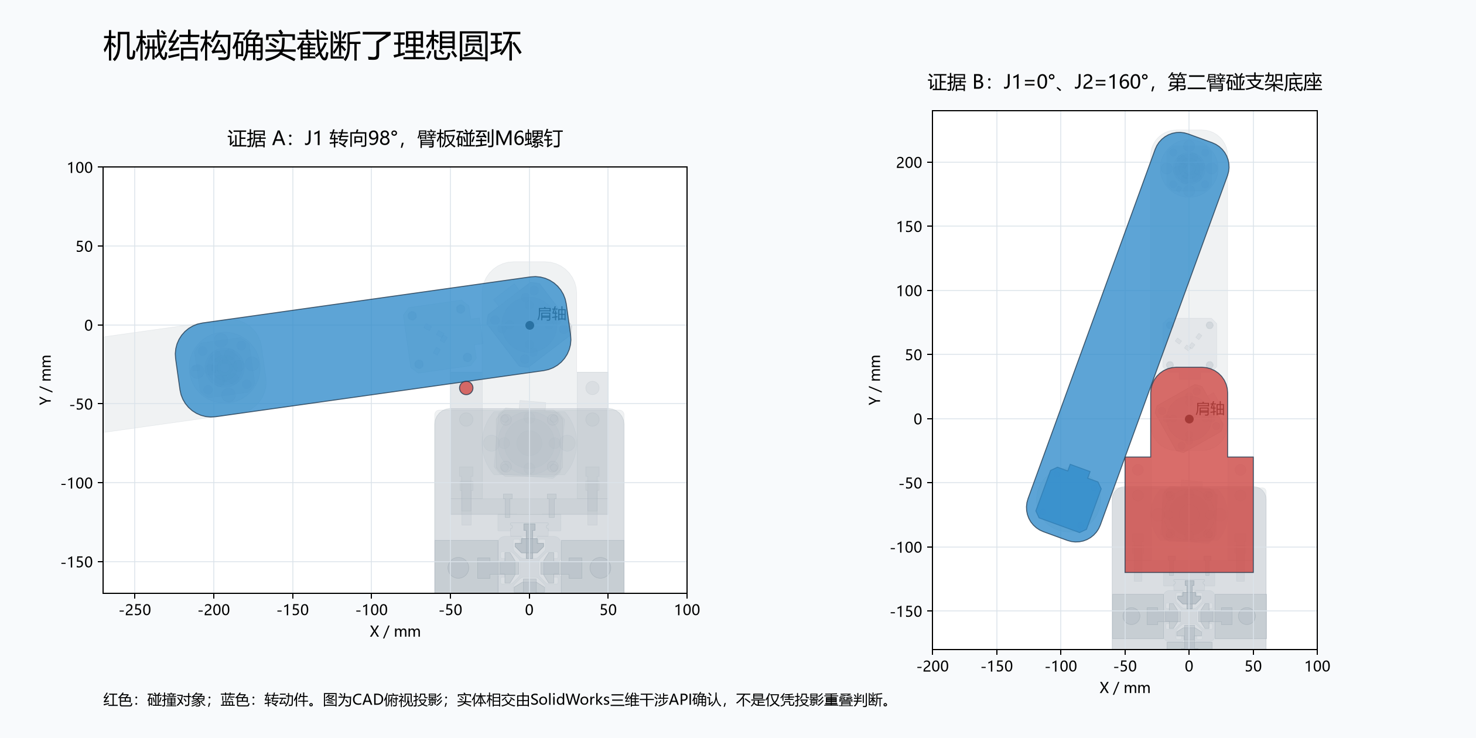
output/constrained-workspace-2026-10-09/collision-witnesses.png
