lst92991-eng/four-axis-robot-arm/output/release/scara-sim-2026-10-10/final-black/camera.jpg

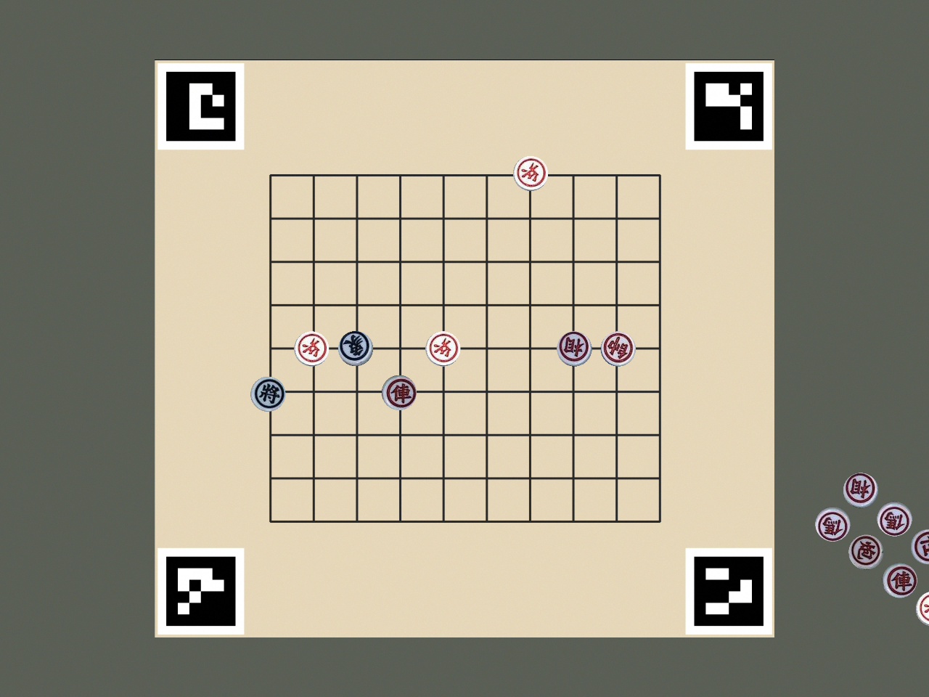
output/release/scara-sim-2026-10-10/final-black/camera.jpg
