lst92991-eng/four-axis-robot-arm/output/release/scara-sim-2026-10-10/final-black/scene.jpg

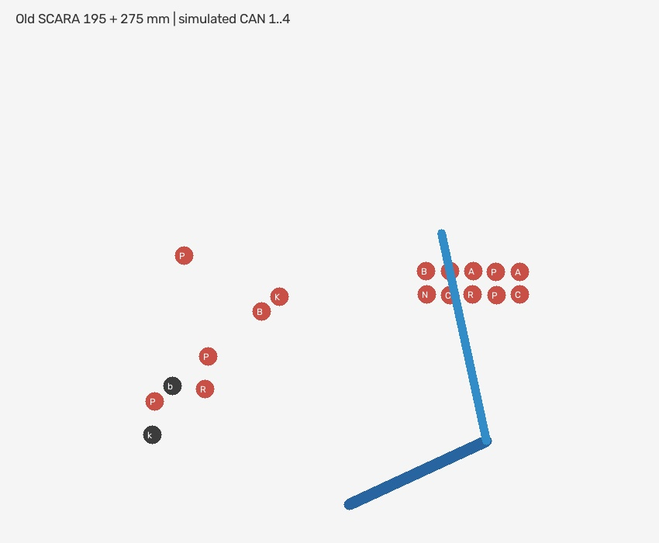
output/release/scara-sim-2026-10-10/final-black/scene.jpg
