lst92991-eng/four-axis-robot-arm/output/simulation-review/cad-scene.jpg

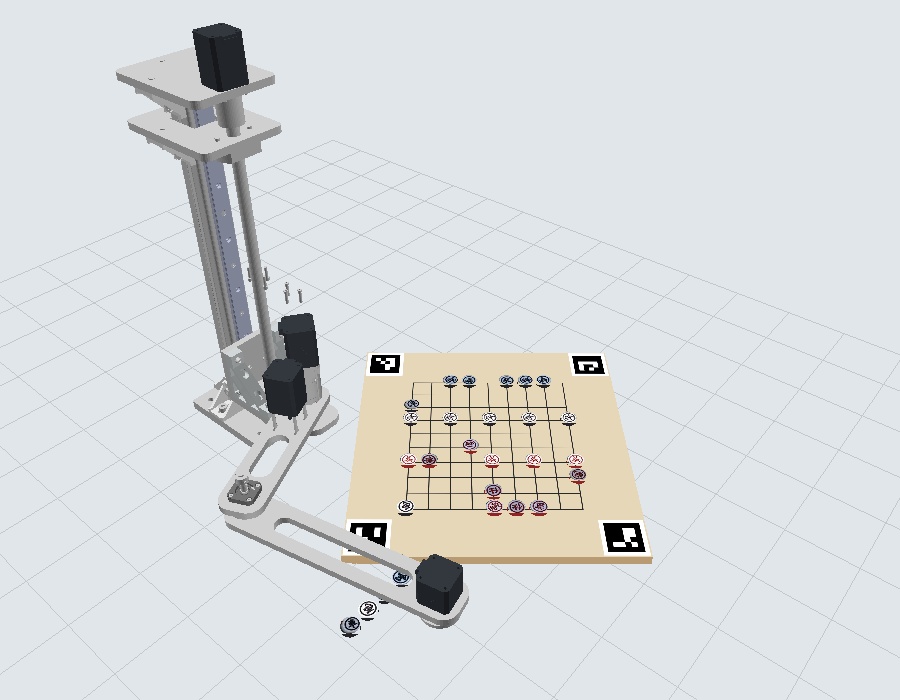
output/simulation-review/cad-scene.jpg
