lst92991-eng/four-axis-robot-arm/output/simulation-review/cad-vision.jpg

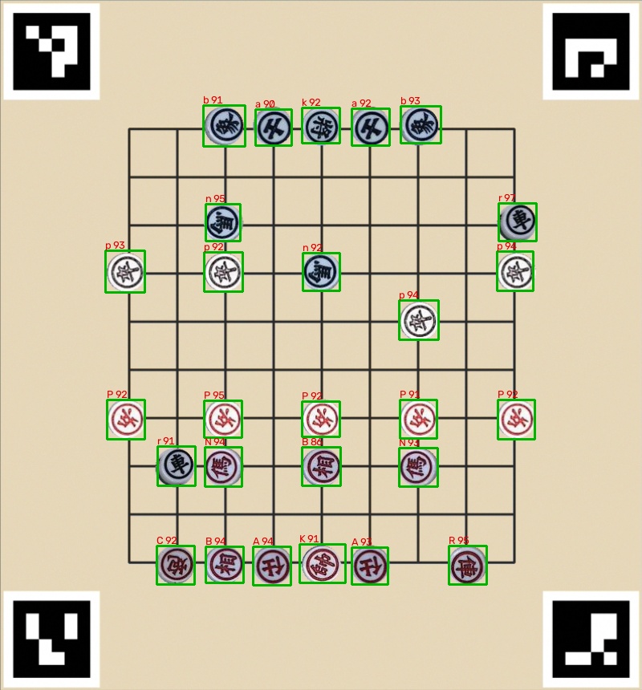
output/simulation-review/cad-vision.jpg
