lst92991-eng/four-axis-robot-arm/output/simulation-review/camera.jpg

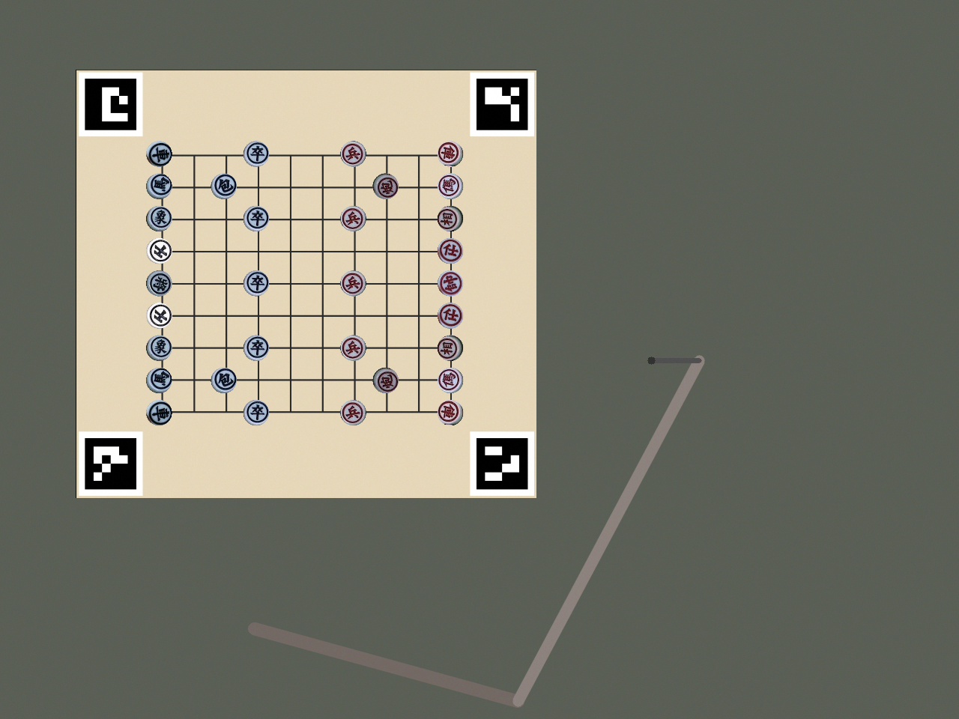
output/simulation-review/camera.jpg
