lst92991-eng/four-axis-robot-arm/output/simulation-review/gui-red-screen.png

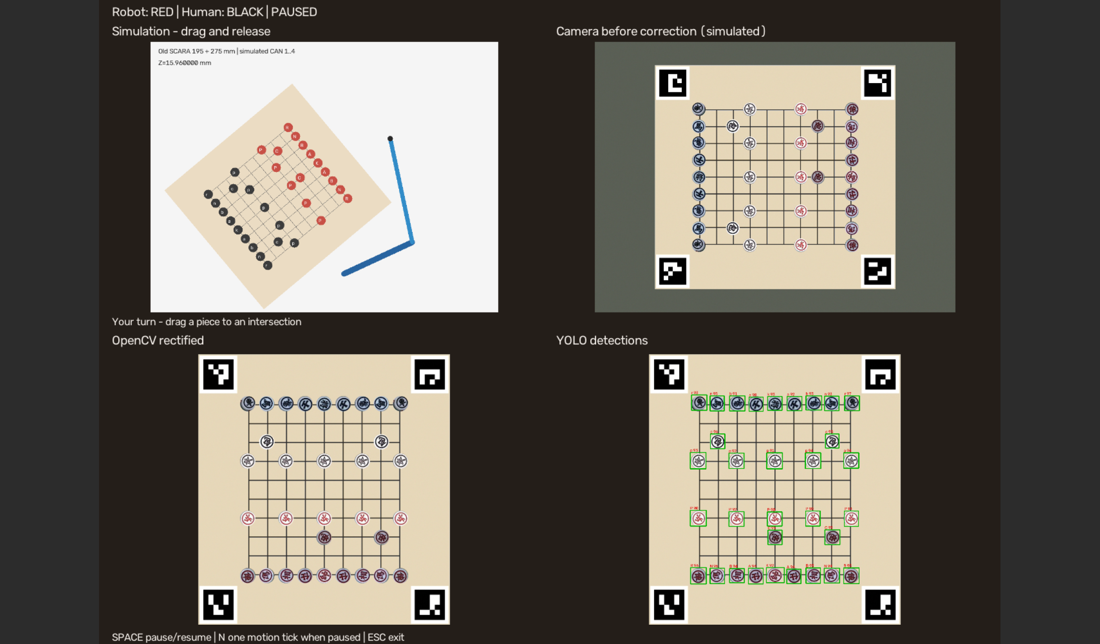
output/simulation-review/gui-red-screen.png
