lst92991-eng/four-axis-robot-arm/output/simulation-review/gui-screen.png

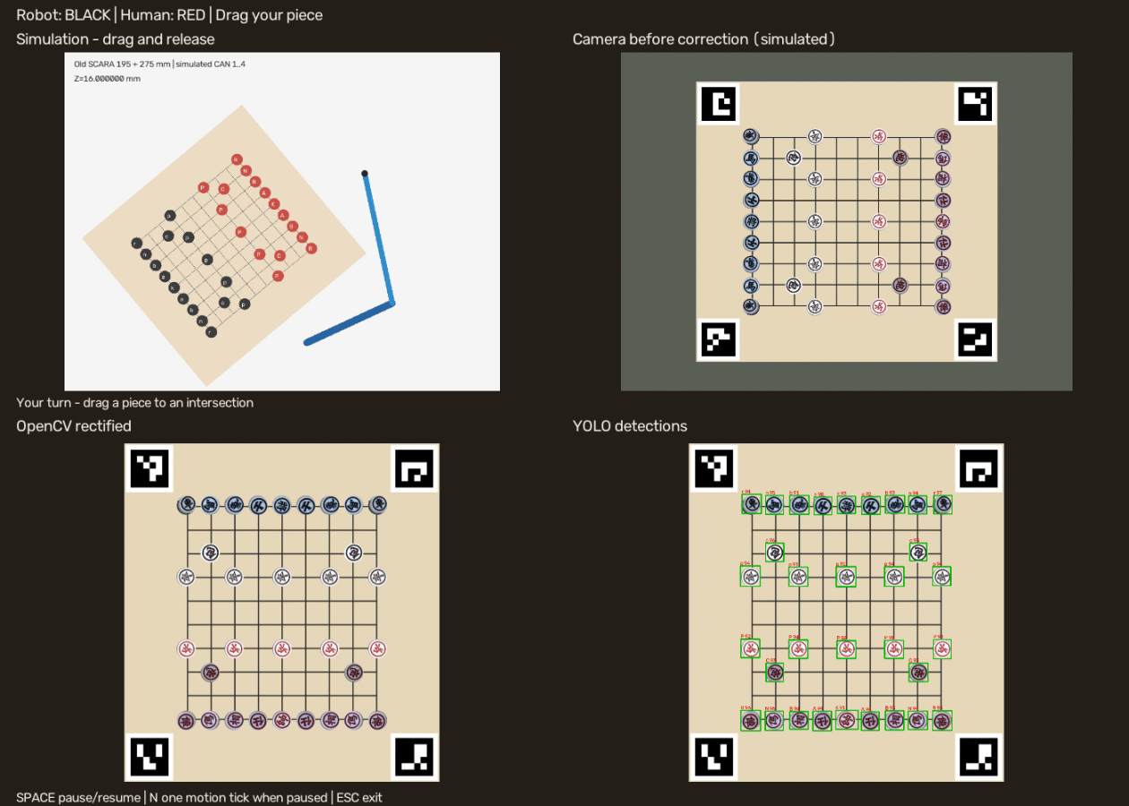
output/simulation-review/gui-screen.png
