lst92991-eng/four-axis-robot-arm/output/simulation-review/K0.png

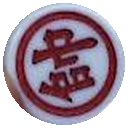
output/simulation-review/K0.png
