lst92991-eng/four-axis-robot-arm/output/simulation-review/K1.png

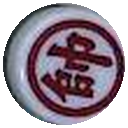
output/simulation-review/K1.png
