lst92991-eng/four-axis-robot-arm/output/simulation-review/K3.png

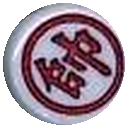
output/simulation-review/K3.png
