lst92991-eng/four-axis-robot-arm/output/simulation-review/K4.png

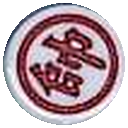
output/simulation-review/K4.png
