lst92991-eng/four-axis-robot-arm/output/simulation-review/live-cad.png

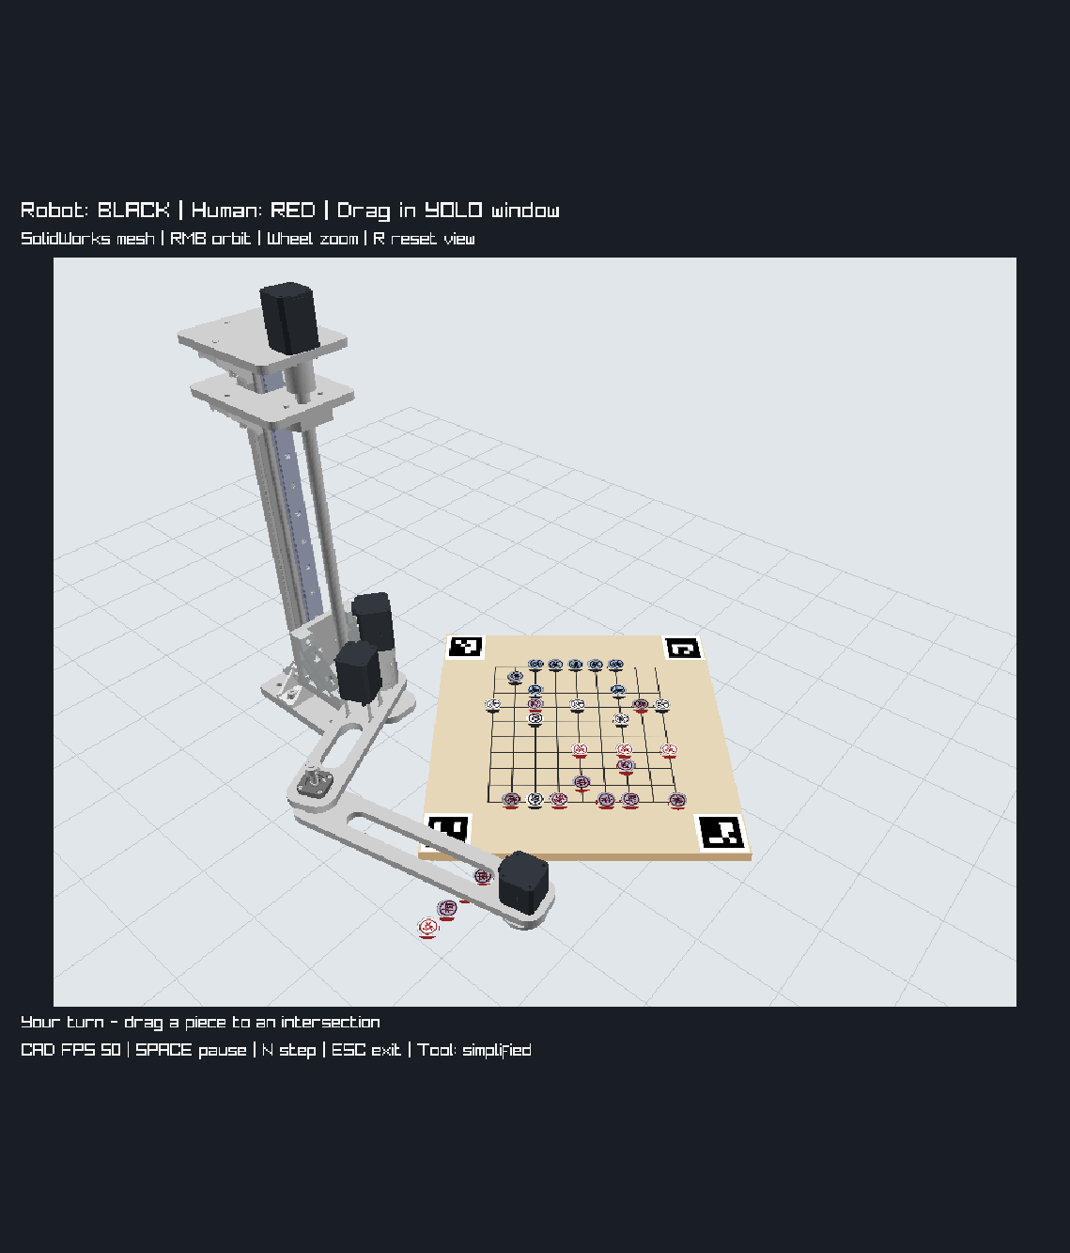
output/simulation-review/live-cad.png
