lst92991-eng/four-axis-robot-arm/output/simulation-review/live-gpu-vision.jpg

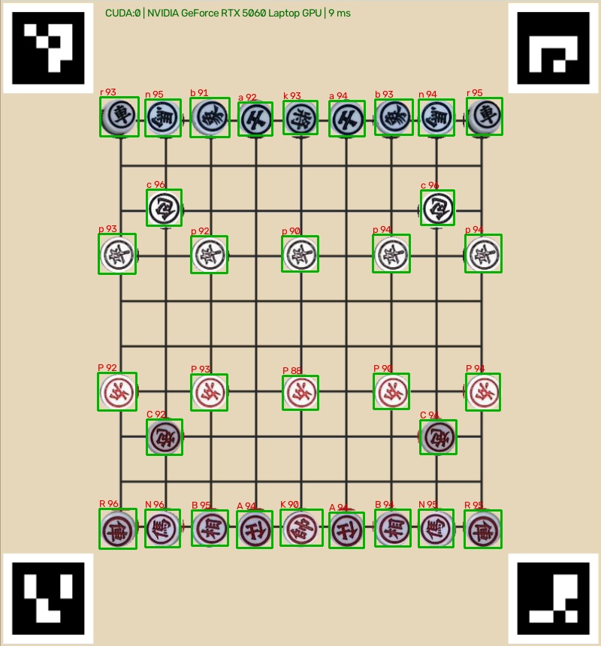
output/simulation-review/live-gpu-vision.jpg
