lst92991-eng/four-axis-robot-arm/output/simulation-review/live-yolo.png

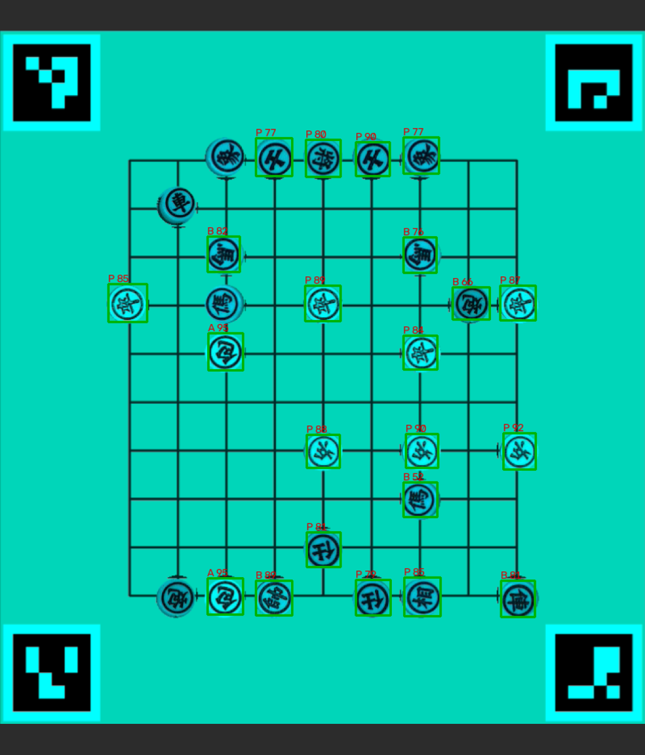
output/simulation-review/live-yolo.png
