lst92991-eng/four-axis-robot-arm/output/simulation-review/N3.png

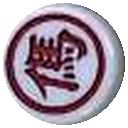
output/simulation-review/N3.png
