lst92991-eng/four-axis-robot-arm/output/simulation-review/vision-black.jpg

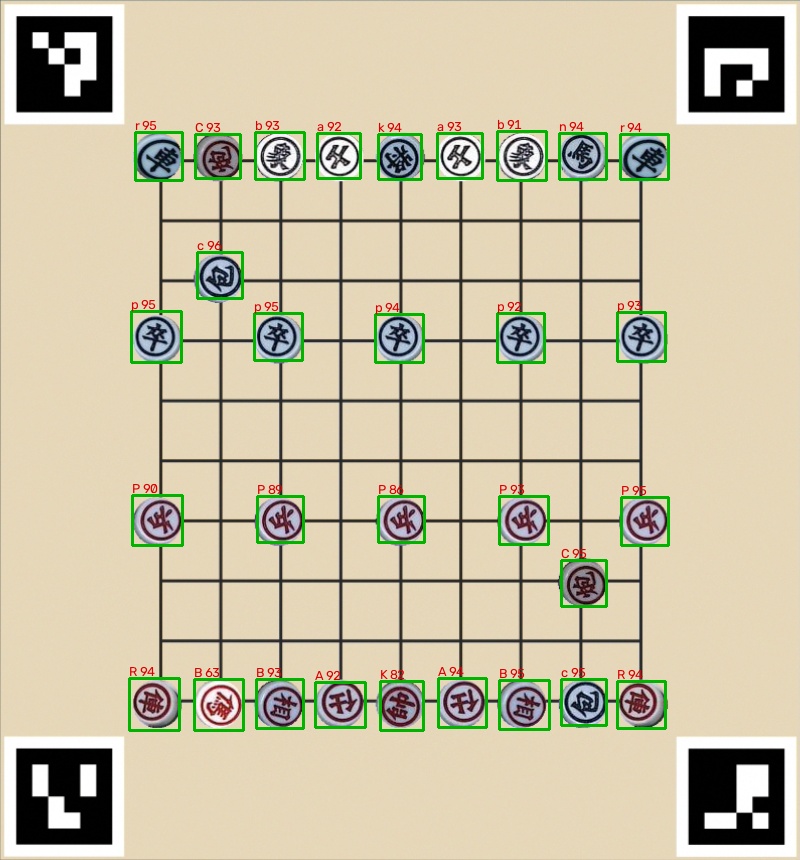
output/simulation-review/vision-black.jpg
