lst92991-eng/four-axis-robot-arm/output/simulation-review/vision.jpg

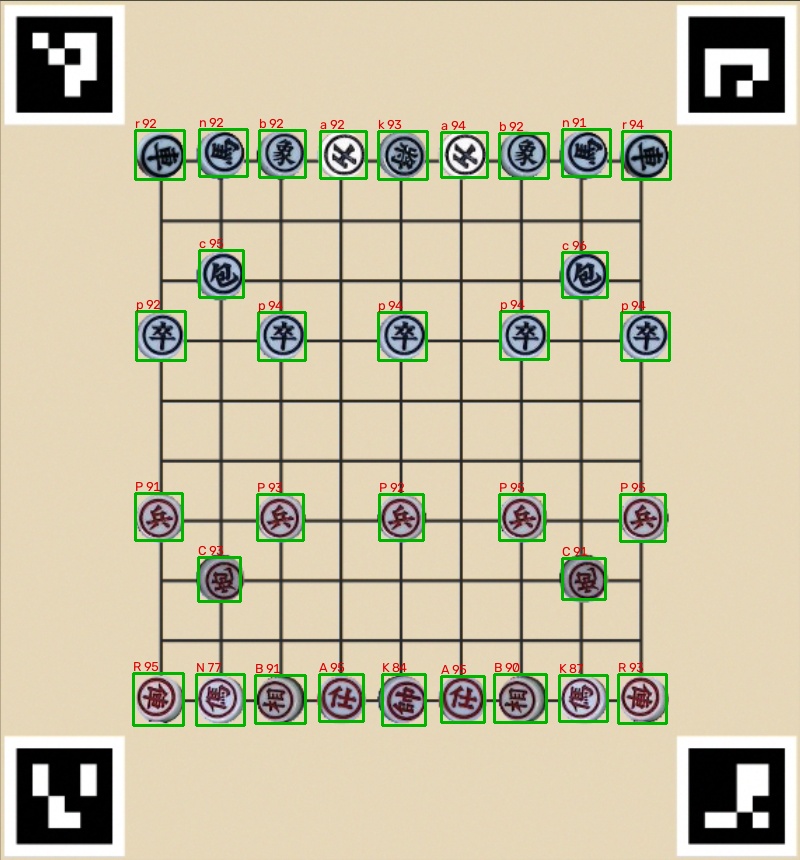
output/simulation-review/vision.jpg
