lst92991-eng/four-axis-robot-arm/output/workspace-comparison-2026-10-13/all-four-top-view.png

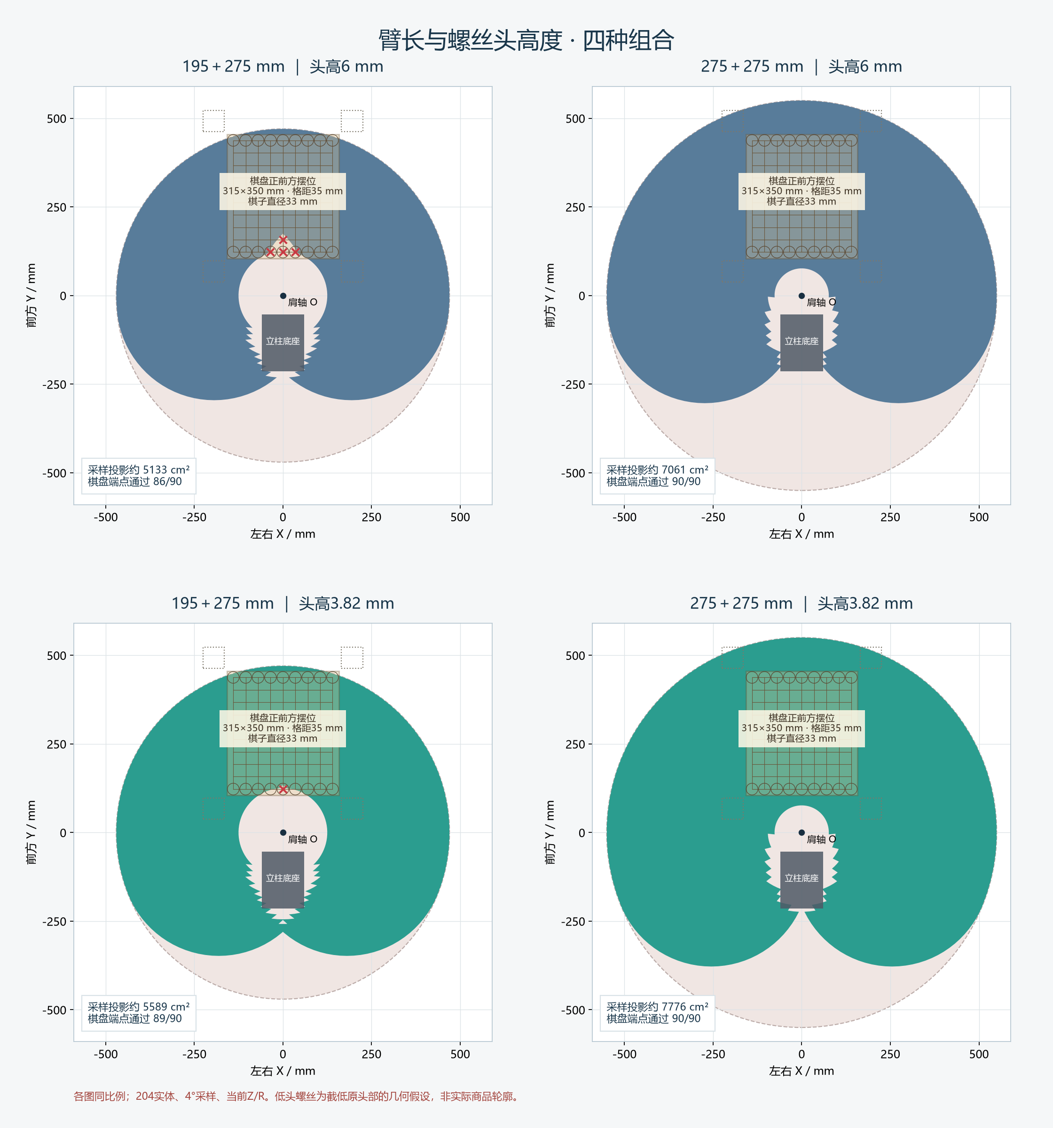
output/workspace-comparison-2026-10-13/all-four-top-view.png
