lst92991-eng/four-axis-robot-arm/output/workspace-comparison-2026-10-13/screw-change-top-view.png

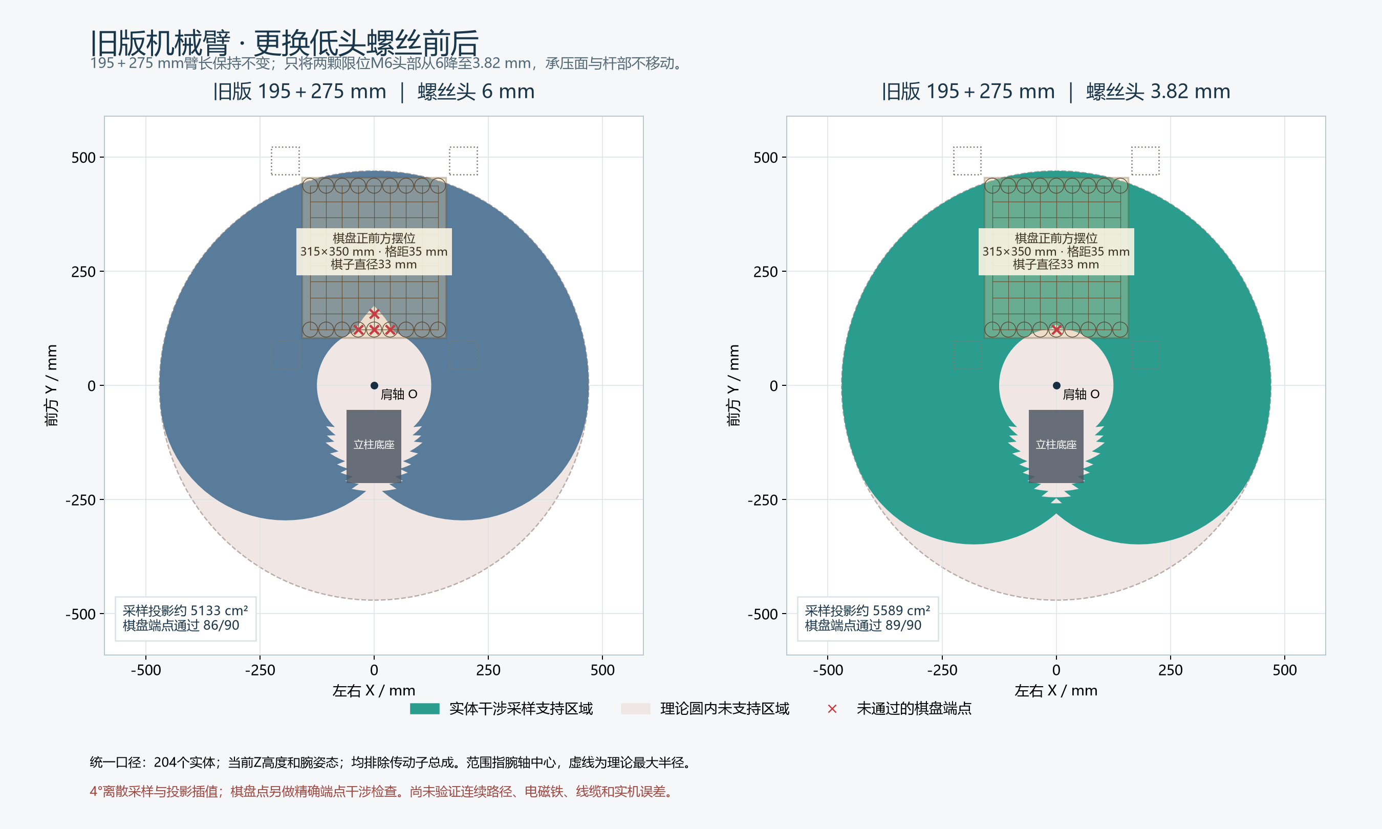
output/workspace-comparison-2026-10-13/screw-change-top-view.png
