lst92991-eng/four-axis-robot-arm/output/workspace-projection-2026-10-09/orientation-comparison.png

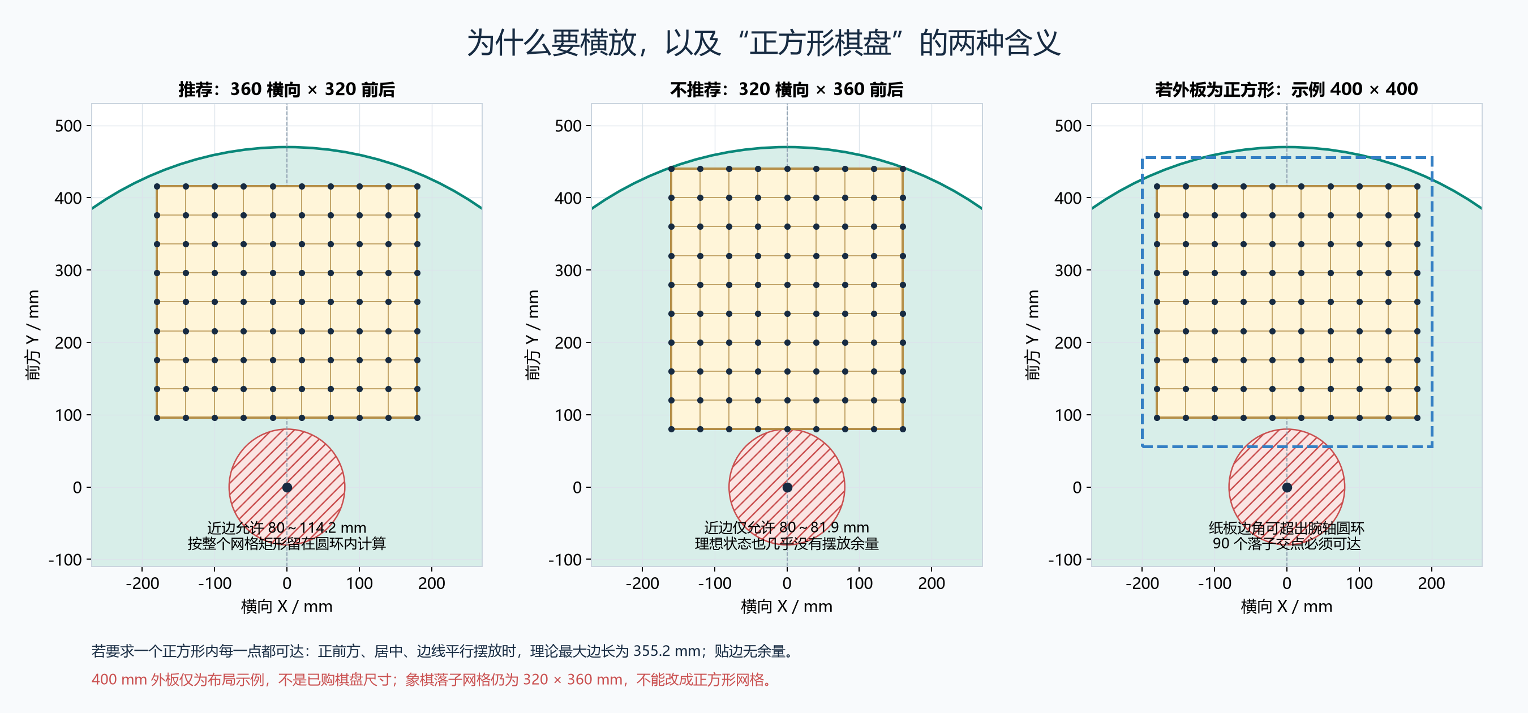
output/workspace-projection-2026-10-09/orientation-comparison.png
