lst92991-eng/four-axis-robot-arm/output/workspace-projection-2026-10-09/workspace-and-board.png

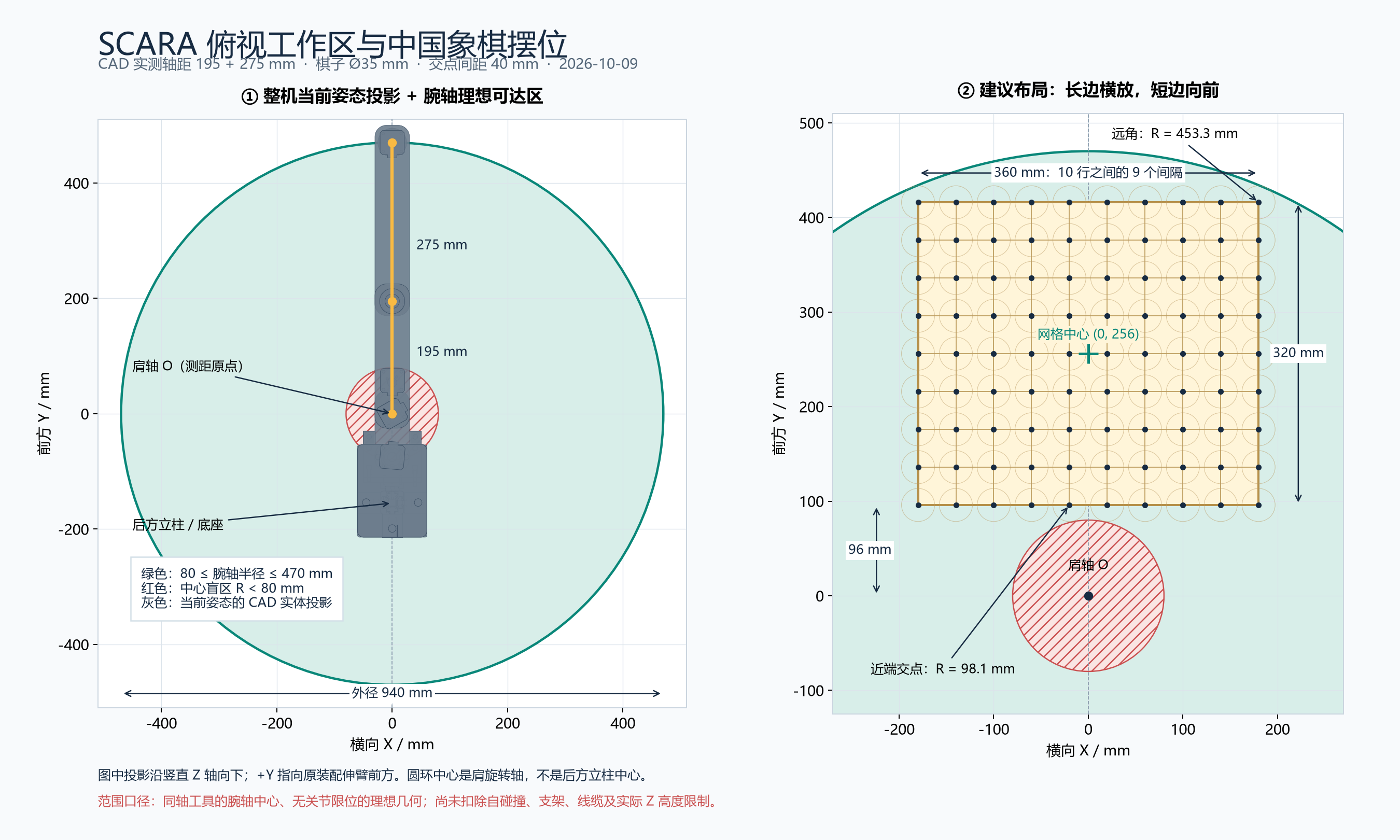
output/workspace-projection-2026-10-09/workspace-and-board.png
