lst92991-eng/four-axis-robot-arm/research/arm-structure-optimization/equal275-chess30-top-view.png

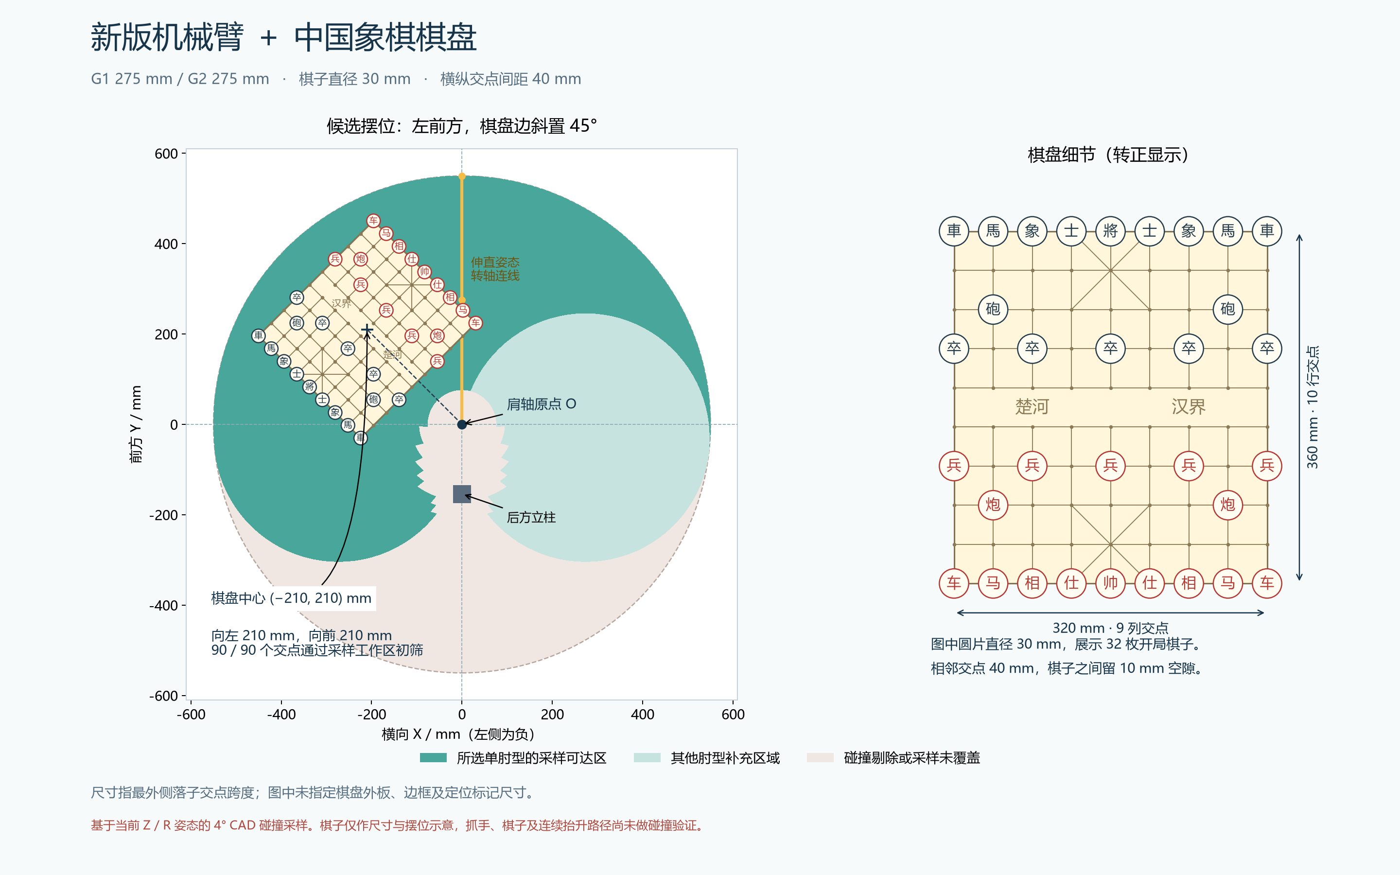
research/arm-structure-optimization/equal275-chess30-top-view.png
