lst92991-eng/four-axis-robot-arm/research/mechanism/driver-x42s/reducer-thumbnail-inspect.png

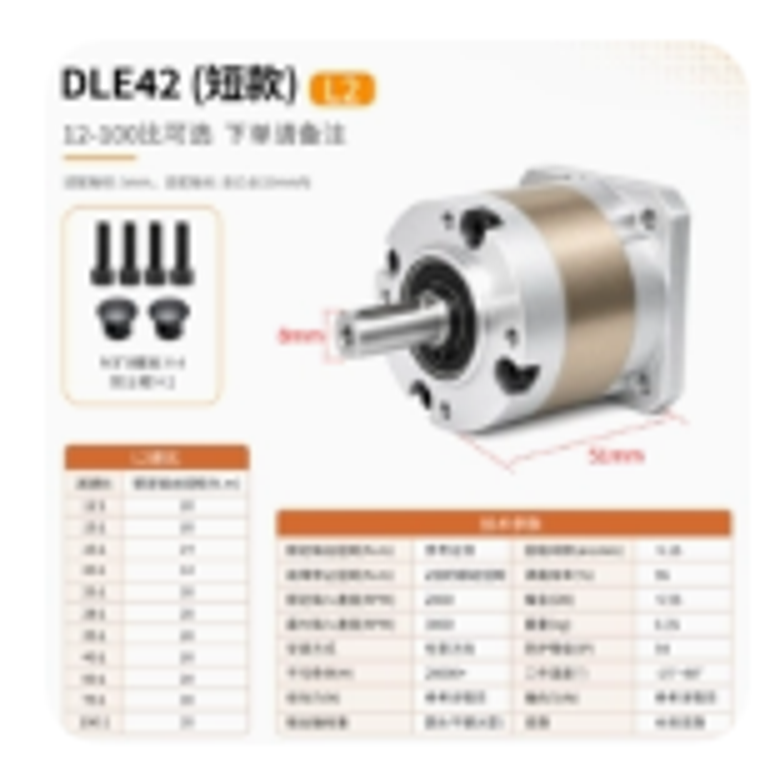
research/mechanism/driver-x42s/reducer-thumbnail-inspect.png
