lst92991-eng/four-axis-robot-arm/research/small-xiangqi-selection/existing-simulation-page.jpg

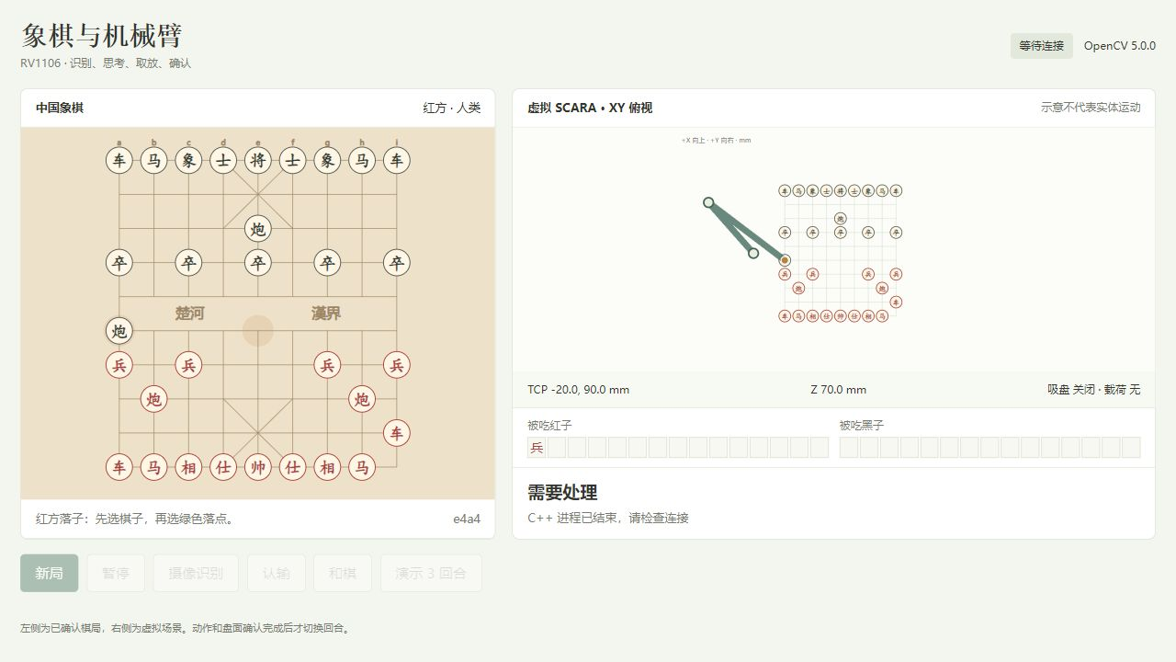
research/small-xiangqi-selection/existing-simulation-page.jpg
