lst92991-eng/four-axis-robot-arm/output/hardware-validation/500rpm-extract-2026-10-13/segments.csv

segment | source | direction | start_unix | duration_s | outcome | reason | samples | peak_abs_rpm | first_500_s | phase_current_max_ma | median_sample_interval_s | post_ramp_samples | post_ramp_abs_rpm_min | post_ramp_abs_rpm_max | post_ramp_abs_rpm_median | post_ramp_within_5pct_fraction | last_sample
1 | z-panel-20261013-180703.jsonl | up | 1791886036.2335498 | 7.060359 | stopped | 已停止并保持使能；再次运行需松开后重新按 | 61 | 503 | 6.46529 | 682 | 0.10947990417480469 | 2 | 498 | 503 | 500.5 | 1.0 | [10071.7822265625, 498, 666, 1]
2 | z-panel-20261013-180703.jsonl | down | 1791886043.9613729 | 8.145061 | stopped | 已停止并保持使能；再次运行需松开后重新按 | 71 | 502 | 6.78337 | 502 | 0.10919356346130371 | 12 | 490 | 502 | 497.0 | 1.0 | [-2925.1593017578125, -497, 485, 1]
3 | z-panel-20261013-180703.jsonl | down | 1791886055.4120026 | 4.356974 | stopped | 已停止并保持使能；再次运行需松开后重新按 | 36 | 294 |  | 416 | 0.10979056358337402 | 0 |  |  |  |  | [-6693.9202880859375, -294, 348, 1]
4 | z-panel-20261013-180703.jsonl | down | 1791886060.7644198 | 2.6397 | stopped | 已停止并保持使能；再次运行需松开后重新按 | 23 | 188 |  | 486 | 0.10951638221740723 | 0 |  |  |  |  | [-8233.978271484375, -188, 273, 1]
5 | z-panel-20261013-180746.jsonl | up | 1791886076.842867 | 11.905537 | stopped | 已停止并保持使能；再次运行需松开后重新按 | 106 | 517 | 7.007094 | 742 | 0.10924243927001953 | 47 | 482 | 517 | 498 | 1.0 | [16424.89013671875, 493, 579, 1]
6 | z-panel-20261013-180746.jsonl | down | 1791886089.641003 | 10.992778 | stopped | 已停止并保持使能；再次运行需松开后重新按 | 97 | 510 | 6.457635 | 521 | 0.10931646823883057 | 38 | 489 | 510 | 499.0 | 1.0 | [-5087.548828125, -500, 487, 1]
7 | z-panel-20261013-180746.jsonl | up | 1791886104.703168 | 11.21266 | stopped | 已停止并保持使能；再次运行需松开后重新按 | 99 | 517 | 6.455695 | 722 | 0.10935235023498535 | 40 | 480 | 517 | 499.0 | 1.0 | [17082.784423828125, 508, 564, 1]
8 | z-panel-20261013-180746.jsonl | down | 1791886117.7965736 | 11.107441 | stopped | 已停止并保持使能；再次运行需松开后重新按 | 97 | 507 | 6.471343 | 524 | 0.10957157611846924 | 38 | 490 | 507 | 499.0 | 1.0 | [-4498.033447265625, -499, 482, 1]
9 | z-panel-20261013-180746.jsonl | up | 1791886147.1240928 | 10.509326 | stopped | 已停止并保持使能；再次运行需松开后重新按 | 93 | 523 | 6.34763 | 999 | 0.10951006412506104 | 34 | 479 | 523 | 499.0 | 1.0 | [15696.71630859375, 495, 913, 1]
10 | z-panel-20261013-180746.jsonl | down | 1791886164.5397801 | 11.761955 | stopped | 已停止并保持使能；再次运行需松开后重新按 | 103 | 514 | 6.470967 | 526 | 0.10953223705291748 | 44 | 490 | 514 | 498.5 | 1.0 | [-7853.1097412109375, -501, 481, 1]
11 | z-panel-20261013-180746.jsonl | down | 1791886187.474317 | 0.785253 | stopped | 已停止并保持使能；再次运行需松开后重新按 | 6 | 41 |  | 534 | 0.11069989204406738 | 0 |  |  |  |  | [-8245.909423828125, -41, 236, 1]
12 | z-panel-20261013-180746.jsonl | up | 1791886188.6045396 | 13.20848 | stopped | 已停止并保持使能；再次运行需松开后重新按 | 120 | 518 | 6.444441 | 2694 | 0.1091606616973877 | 61 | 17 | 518 | 497 | 0.9016393442622951 | [19449.212036132812, 17, 2694, 1]
13 | z-panel-20261013-180746.jsonl | down | 1791886210.5752108 | 13.78363 | fault | 堵转/失能，停止测试 | 127 | 512 | 6.457905 | 3050 | 0.10930907726287842 | 68 | 0 | 512 | 497.0 | 0.8676470588235294 | [-9611.636352539062, 0, 3050, 5]
14 | z-panel-20261013-181028.jsonl | up | 1791886234.4861088 | 11.802549 | stopped | 已停止并保持使能；再次运行需松开后重新按 | 105 | 516 | 6.448552 | 984 | 0.10932803153991699 | 46 | 484 | 516 | 499.0 | 1.0 | [14874.45556640625, 504, 559, 1]
