lst92991-eng/four-axis-robot-arm/research/mechanism/bom-row-8-image-5.png

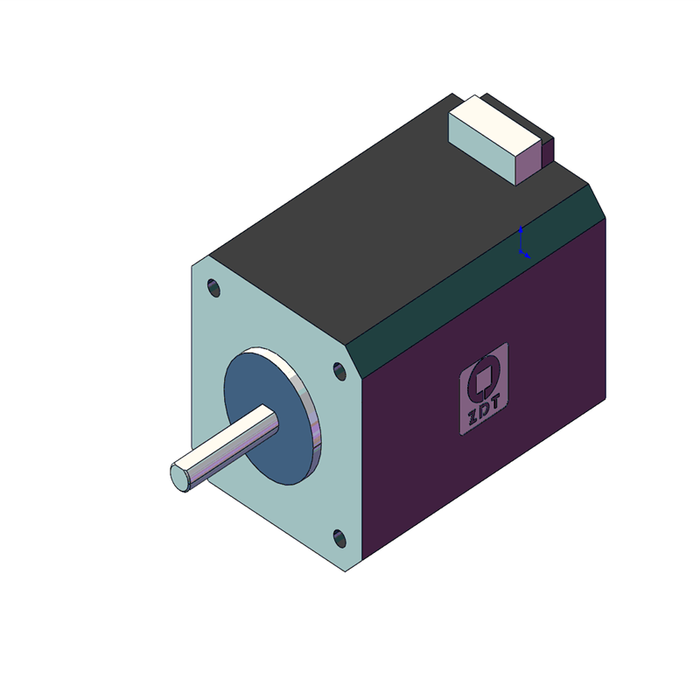
research/mechanism/bom-row-8-image-5.png
