lst92991-eng/four-axis-robot-arm/research/mechanism/bom-row-9-image-6.png

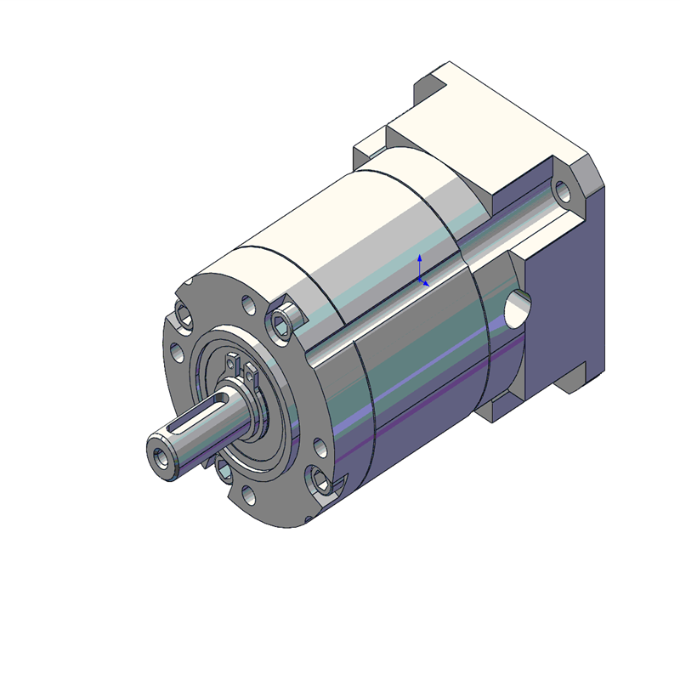
research/mechanism/bom-row-9-image-6.png
