lst92991-eng/four-axis-robot-arm/research/mechanism/bom-row-18-image-15.png

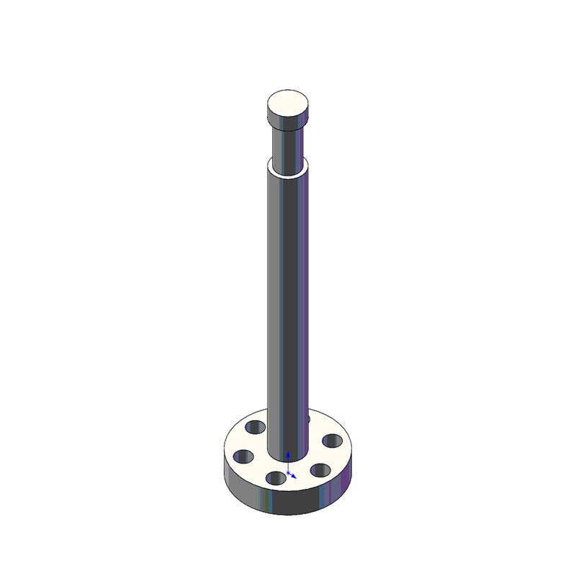
research/mechanism/bom-row-18-image-15.png
