lst92991-eng/four-axis-robot-arm/research/mechanism/bom-row-19-image-16.png

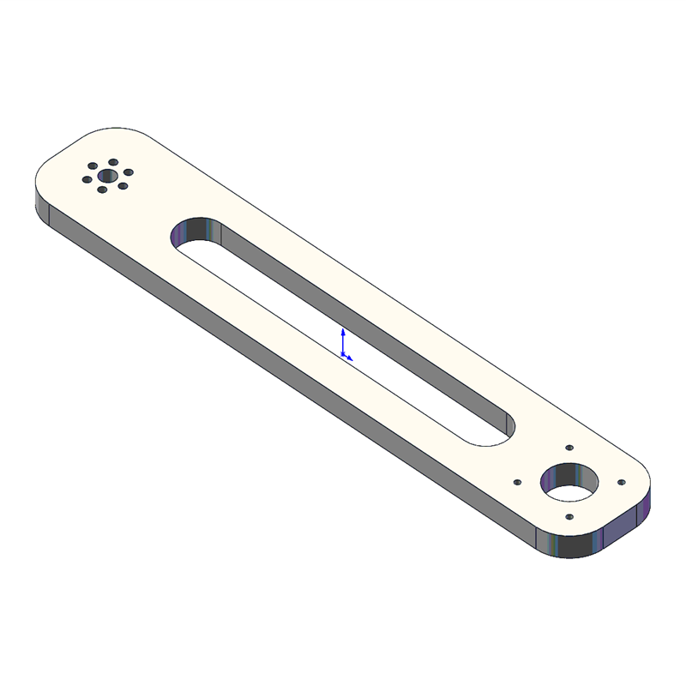
research/mechanism/bom-row-19-image-16.png
