lst92991-eng/four-axis-robot-arm/research/mechanism/bom-row-20-image-17.png

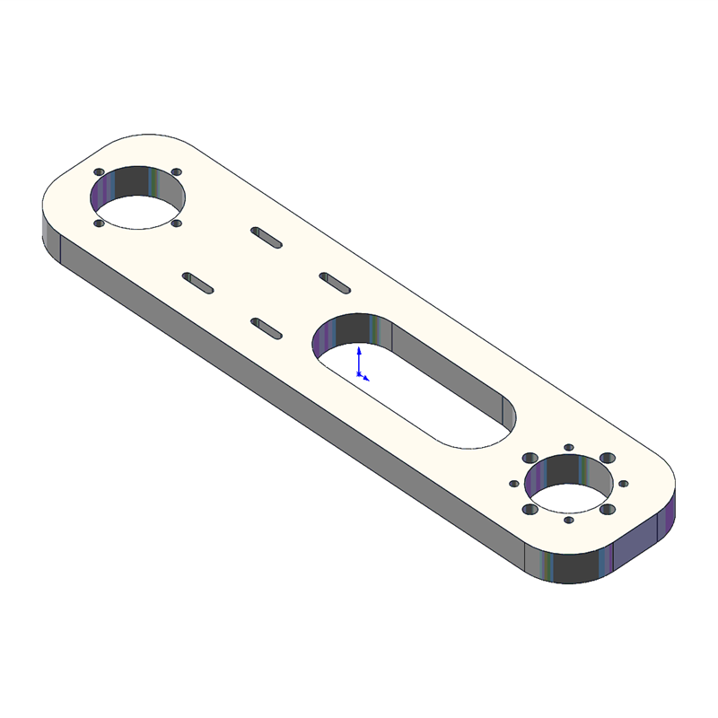
research/mechanism/bom-row-20-image-17.png
