lst92991-eng/four-axis-robot-arm/research/mechanism/bom-row-21-image-18.png

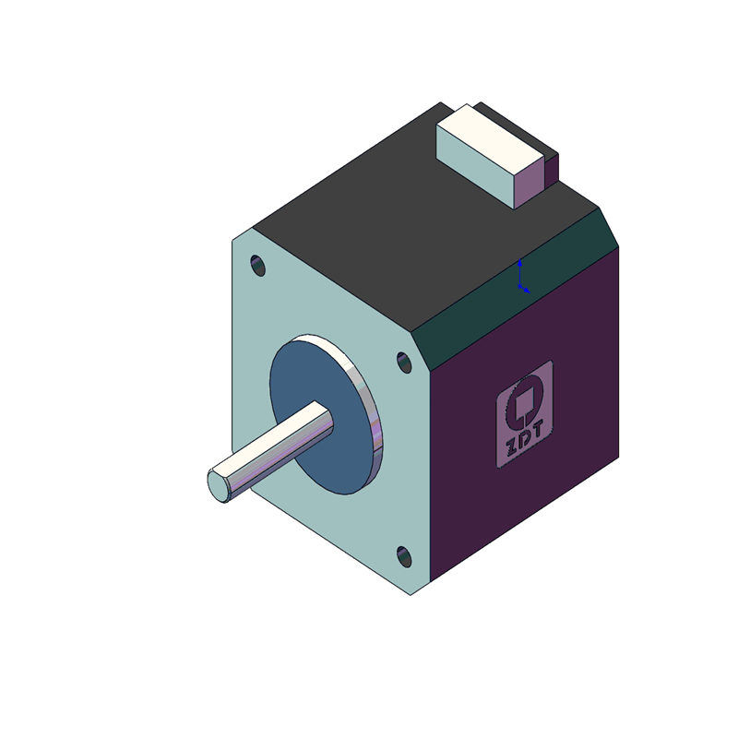
research/mechanism/bom-row-21-image-18.png
