lst92991-eng/four-axis-robot-arm/research/mechanism/bom-row-25-image-22.png

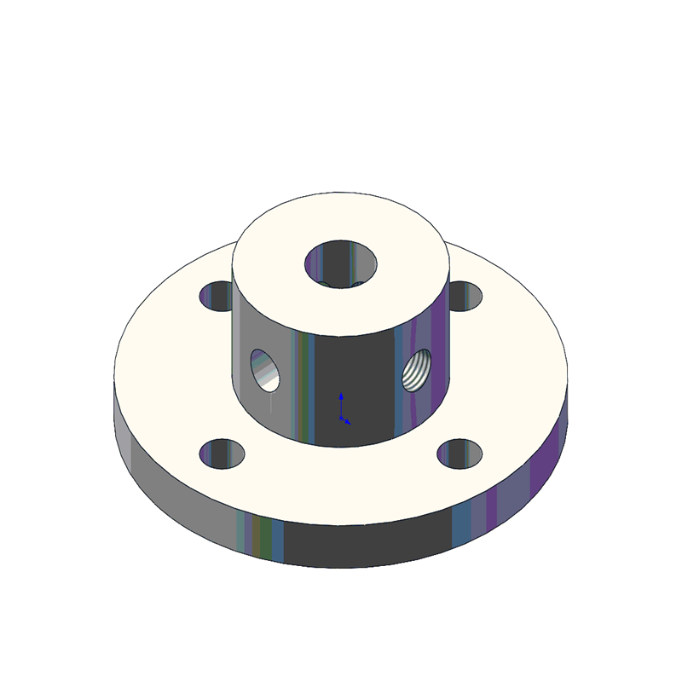
research/mechanism/bom-row-25-image-22.png
