lst92991-eng/four-axis-robot-arm/research/mechanism/bom-row-26-image-23.png

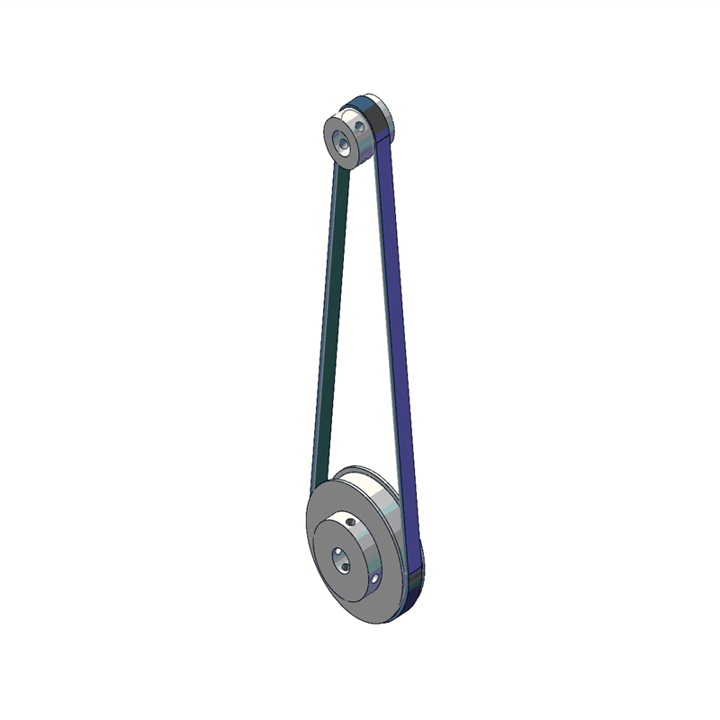
research/mechanism/bom-row-26-image-23.png
