lst92991-eng/four-axis-robot-arm/research/mechanism/bom-row-27-image-24.png

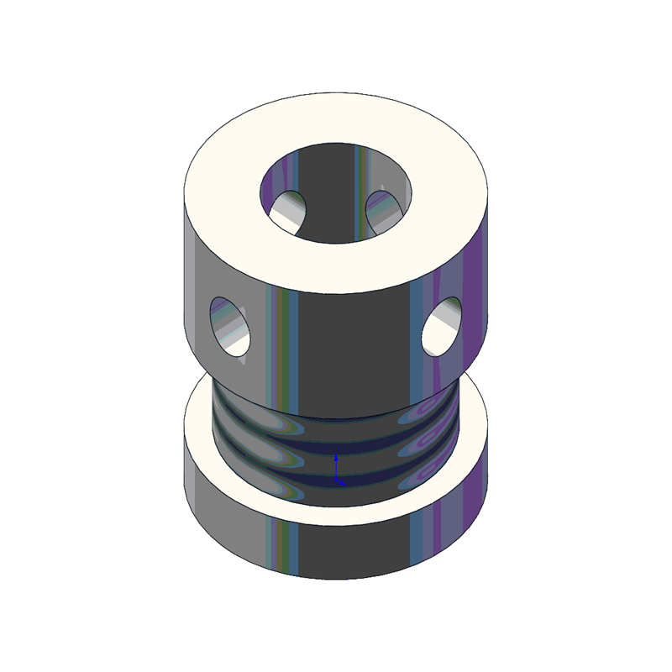
research/mechanism/bom-row-27-image-24.png
