lst92991-eng/four-axis-robot-arm/research/mechanism/bom-row-28-image-25.png

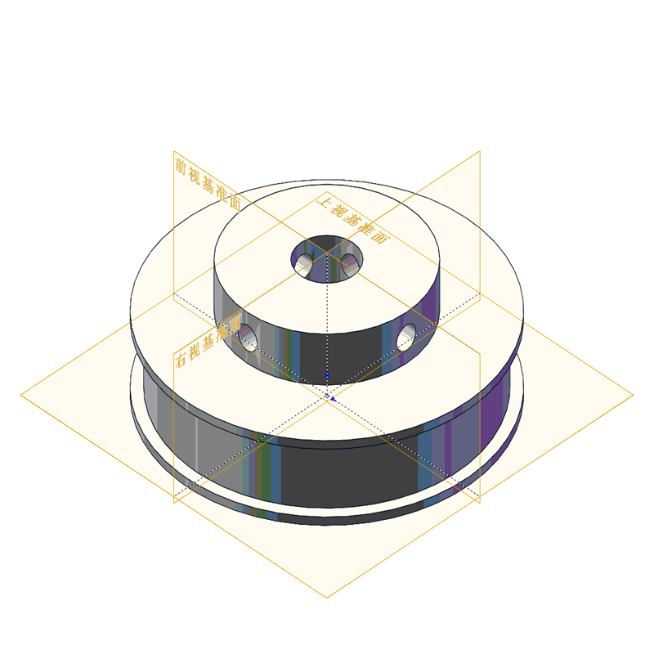
research/mechanism/bom-row-28-image-25.png
