lst92991-eng/four-axis-robot-arm/research/mechanism/bom-row-47-image-44.png

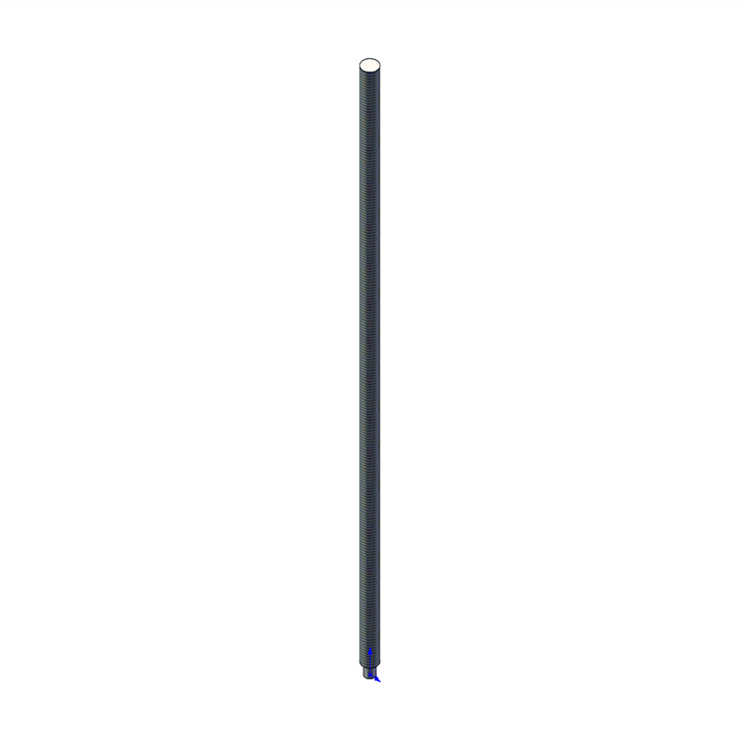
research/mechanism/bom-row-47-image-44.png
