lst92991-eng/four-axis-robot-arm/research/mechanism/driver-x42s/motor40-order-detail.png

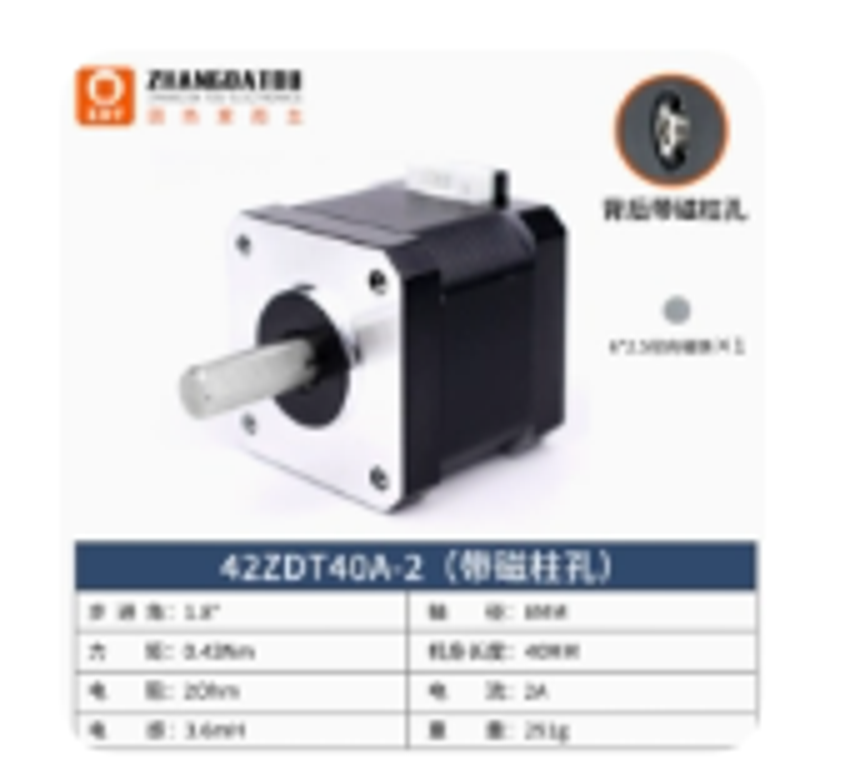
research/mechanism/driver-x42s/motor40-order-detail.png
