lst92991-eng/four-axis-robot-arm/hardware/arm_equal_275/v1/native/EQ275_M4内六角x16mm.SLDPRT

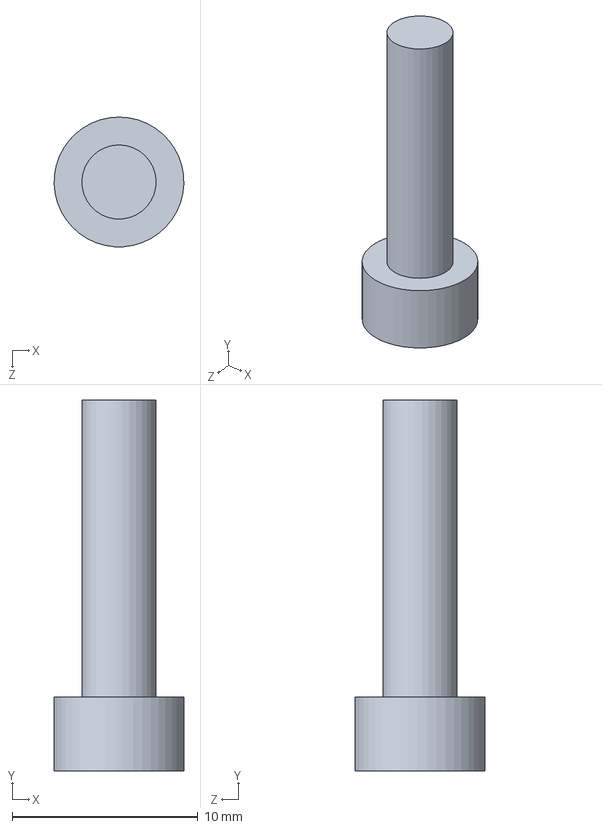
[picture p87: CAD file, 2026-11-02]
hardware/arm_equal_275/v1/native/EQ275_M4内六角x16mm.SLDPRT
7.00 x 20.0 x 7.00 mm
