lst92991-eng/four-axis-robot-arm/hardware/camera_mount/v2/layout_check.step

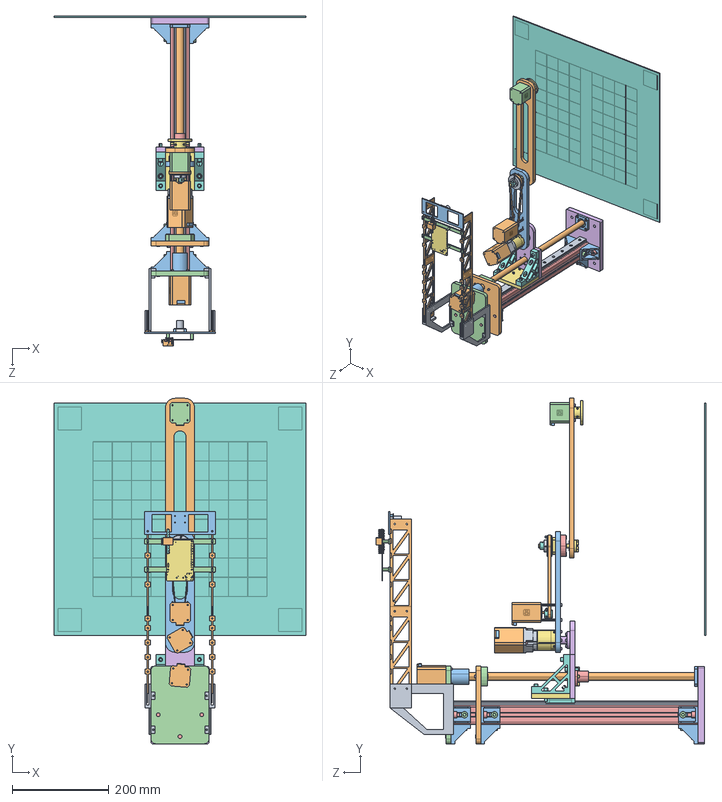
[picture p89: CAD file, 2026-11-02]
hardware/camera_mount/v2/layout_check.step
520.0 x 714.0 x 681.8 mm
01_clamp_right
02_clamp_left
03_truss_200 x 4
04_camera_B_crossbar
05_pcb_support x 2
40x40x500
底座
40型材M4T型螺母 x 7
MGW12H滑块
MGW12_500mm_MGW12R270
42步进电机L60 x 3
DLE42-L2BJ-长款50
FF固定铝板
40型材角件 x 9
电机支撑铝板
单头六角螺柱M3x30+6 x 4
L型支架底座
L型支架竖板
铝型材挤压角座 x 2
方键条销
第二机械臂
J1机械臂
42步进电机L40
轴承座8mm内径
FF ______________[FF12]
SKF_608-2ZZ
内径8mm法兰
GT20同步轮
GT60同步轮
皮带1-2^装配体1_SCARA四轴机械臂总成
40T型螺母M8孔 x 9
M8内六角x18mm x 9
M8内六角x16mm x 9
M3内六角x16mm x 8
M4内六角x16mm x 14
M6内六角x22 x 8
M3内六角x12mm x 12
M5内六角x16 x 4
M3x4mm紧固螺丝 x 8
M4内六角x18mm x 7
M3内六角x10mm x 4
8mm键槽法兰
光轴固定环
8x10x3mm轴套
T型丝杆500mm
8-16联轴器
紧凑型轴承座
T型丝杆螺母
M6小头内六角x22 x 2
FF丝杆支撑座[FF10]_FF10
M3内六角小头x16mm x 8
61mm光轴
reference_board
reference_camera_B
pcb_major_components
