lst92991-eng/four-axis-robot-arm/hardware/camera_mount/v2/parts/01_clamp_right.step

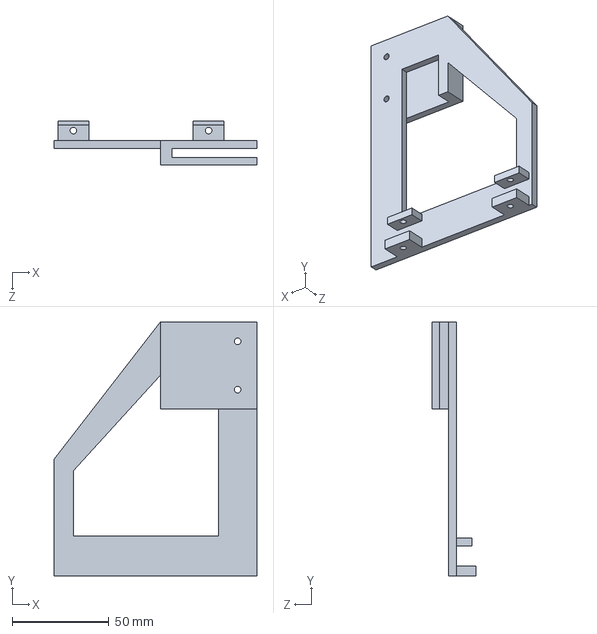
[picture p90: CAD file, 2026-11-02]
hardware/camera_mount/v2/parts/01_clamp_right.step
105.0 x 131.4 x 22.8 mm
