lst92991-eng/four-axis-robot-arm/hardware/xiangqi30-long275275-2026-10-13/SCARA_FRONT_275_275_CHESS30.step

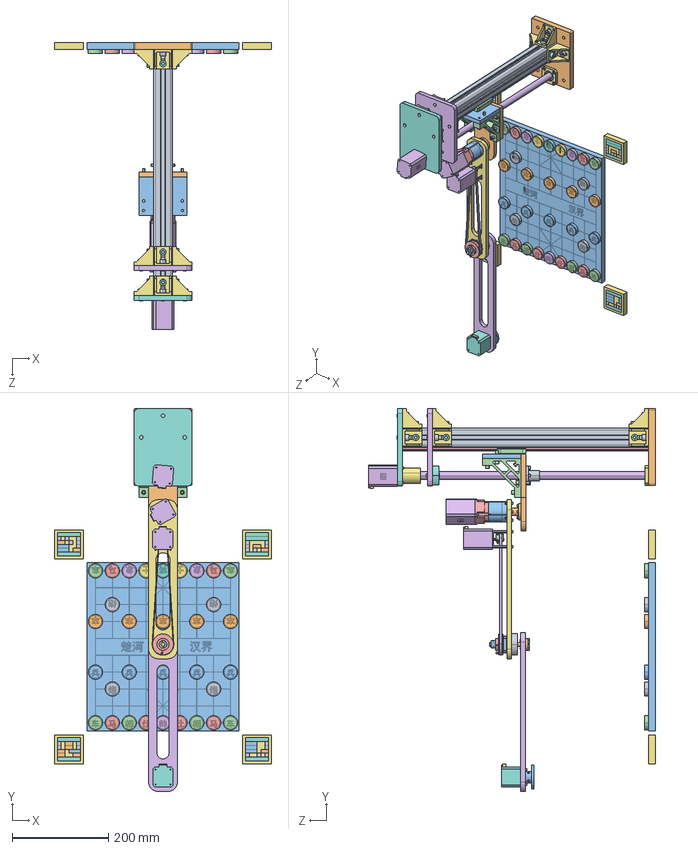
[picture p91: CAD file, 2026-11-02]
hardware/xiangqi30-long275275-2026-10-13/SCARA_FRONT_275_275_CHESS30.step
450.0 x 794.0 x 594.0 mm
EQ275_40x40x500
EQ275_底座
EQ275_40型材M4T型螺母 x 7
EQ275_MGW12H滑块
EQ275_MGW12_500mm_MGW12R270
EQ275_42步进电机L60 x 3
EQ275_DLE42-L2BJ-长款50
EQ275_FF固定铝板
EQ275_40型材角件 x 9
EQ275_电机支撑铝板
EQ275_单头六角螺柱M3x30+6 x 4
EQ275_L型支架底座
EQ275_L型支架竖板
EQ275_铝型材挤压角座 x 2
EQ275_方键条销
EQ275_第二机械臂
EQ275_J1机械臂
EQ275_42步进电机L40
EQ275_轴承座8mm内径
EQ275_FF ______________[FF12]
EQ275_SKF_608-2ZZ
EQ275_内径8mm法兰
LONG_EQ275_GT20同步轮
LONG_EQ275_GT60同步轮
EQ275_BELT
EQ275_40T型螺母M8孔 x 9
EQ275_M8内六角x18mm x 9
EQ275_M8内六角x16mm x 9
EQ275_M3内六角x16mm x 8
EQ275_M4内六角x16mm x 14
EQ275_M6内六角x22 x 8
EQ275_M3内六角x12mm x 12
EQ275_M5内六角x16 x 4
EQ275_M3x4mm紧固螺丝 x 8
EQ275_M4内六角x18mm x 7
EQ275_M3内六角x10mm x 4
EQ275_8mm键槽法兰
EQ275_光轴固定环
EQ275_8x10x3mm轴套
EQ275_T型丝杆500mm
EQ275_8-16联轴器
EQ275_紧凑型轴承座
EQ275_T型丝杆螺母
EQ275_M6小头内六角x22 x 2
EQ275_FF丝杆支撑座[FF10]_FF10
EQ275_M3内六角小头x16mm x 8
EQ275_61mm光轴
LONG_board_315x350_pitch35
LONG_piece_black_r x 2
LONG_piece_black_n x 2
LONG_piece_black_b x 2
LONG_piece_black_a x 2
LONG_piece_black_k
LONG_piece_black_c x 2
LONG_piece_black_p x 5
LONG_piece_red_P x 5
LONG_piece_red_C x 2
LONG_piece_red_R x 2
LONG_piece_red_N x 2
LONG_piece_red_B x 2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
