lst92991-eng/four-axis-robot-arm/hardware/xiangqi33-assemblies-2026-10-13/long/SolidWorks/N33_EQ275_MGW12_500mm.SLDPRT

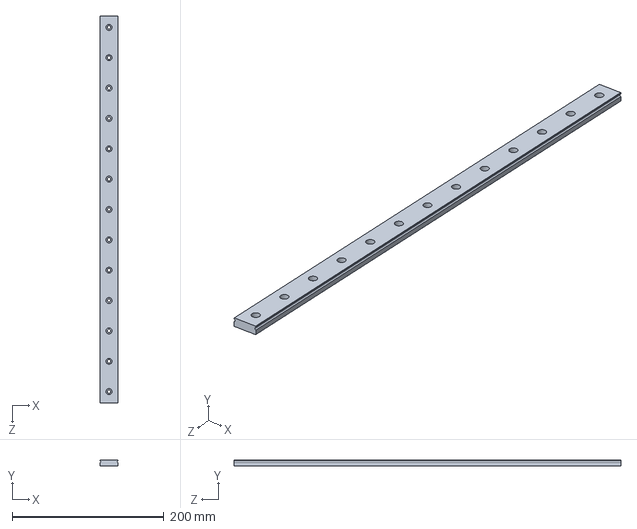
[picture p92: CAD file, 2026-11-02]
hardware/xiangqi33-assemblies-2026-10-13/long/SolidWorks/N33_EQ275_MGW12_500mm.SLDPRT
24.0 x 8.50 x 510.0 mm
