lst92991-eng/four-axis-robot-arm/hardware/arm_equal_275/v1/native/EQ275_T型丝杆500mm.SLDPRT

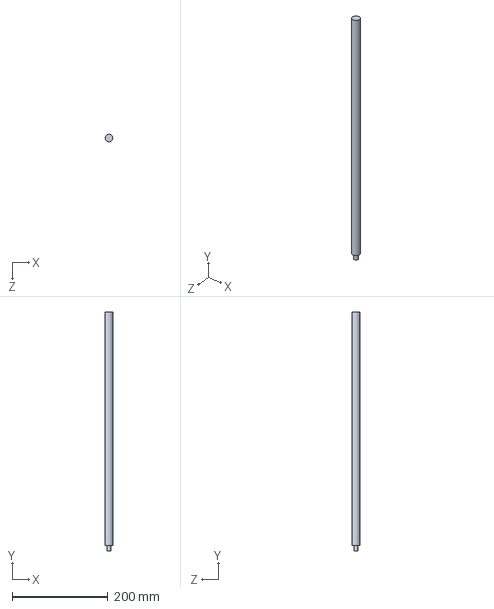
[picture p93: CAD file, 2026-11-02]
hardware/arm_equal_275/v1/native/EQ275_T型丝杆500mm.SLDPRT
16.0 x 500.0 x 16.0 mm
