lst92991-eng/four-axis-robot-arm/hardware/camera_mount/v2/camera_bridge.step

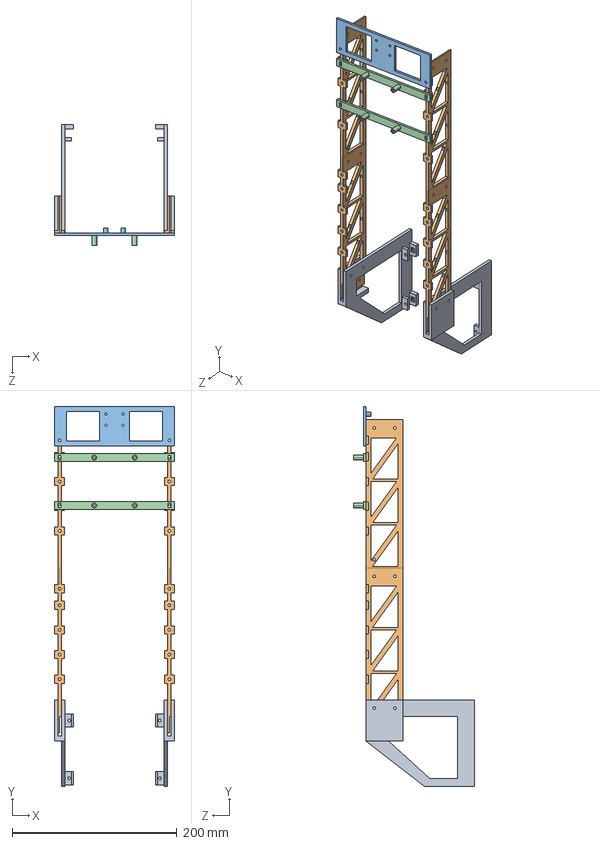
[picture p94: CAD file, 2026-11-02]
hardware/camera_mount/v2/camera_bridge.step
146.0 x 461.0 x 146.4 mm
01_clamp_right
02_clamp_left
03_truss_200 x 4
04_camera_B_crossbar
05_pcb_support x 2
