lst92991-eng/four-axis-robot-arm/hardware/camera_mount/v2/parts/05_pcb_support.step

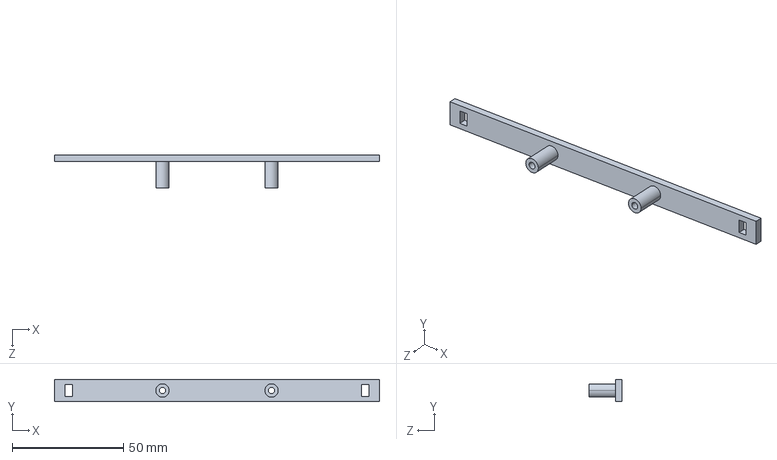
[picture p95: CAD file, 2026-11-02]
hardware/camera_mount/v2/parts/05_pcb_support.step
146.0 x 10.0 x 15.0 mm
