lst92991-eng/four-axis-robot-arm/hardware/camera_mount/v2/reference/pcb_major_components.SLDPRT

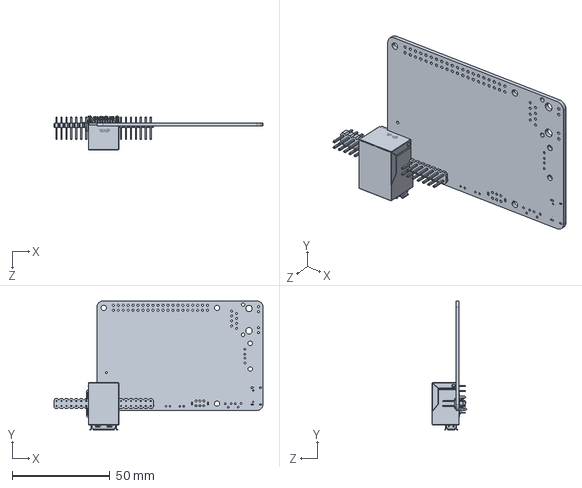
[picture p96: CAD file, 2026-11-02]
hardware/camera_mount/v2/reference/pcb_major_components.SLDPRT
106.9 x 66.0 x 17.7 mm
