lst92991-eng/four-axis-robot-arm/hardware/xiangqi30-long275275-2026-10-13/SolidWorks/EQ275_SKF_608-2ZZ.SLDPRT

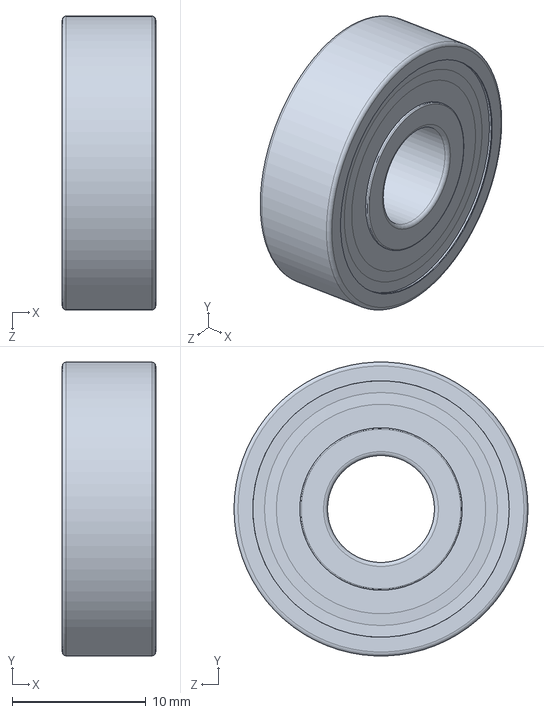
[picture p97: CAD file, 2026-11-02]
hardware/xiangqi30-long275275-2026-10-13/SolidWorks/EQ275_SKF_608-2ZZ.SLDPRT
7.00 x 22.0 x 22.0 mm
