lst92991-eng/four-axis-robot-arm/hardware/xiangqi33-assemblies-2026-10-13/long/SolidWorks/N33_EQ275_40型材角件.SLDPRT

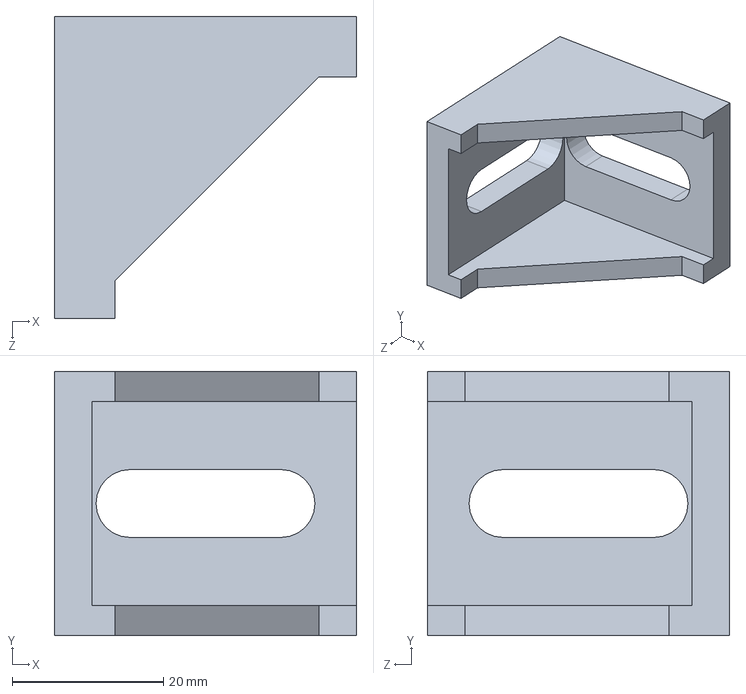
[picture p98: CAD file, 2026-11-02]
hardware/xiangqi33-assemblies-2026-10-13/long/SolidWorks/N33_EQ275_40型材角件.SLDPRT
40.0 x 35.0 x 40.0 mm
