lst92991-eng/four-axis-robot-arm/hardware/camera_mount/v2/parts/03_truss_200.step

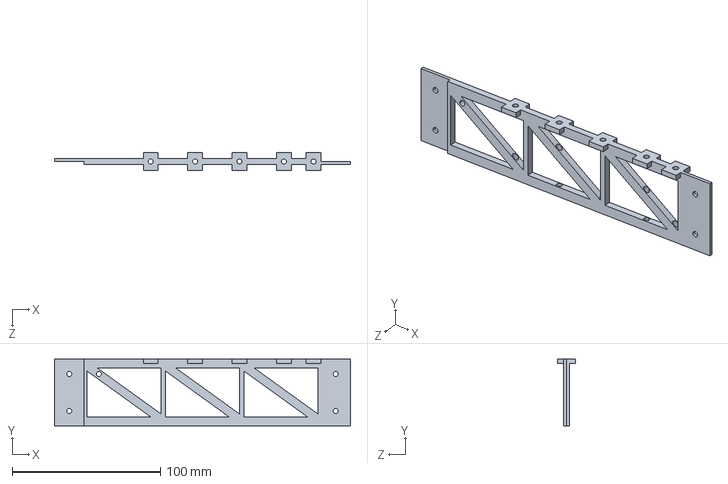
[picture p99: CAD file, 2026-11-02]
hardware/camera_mount/v2/parts/03_truss_200.step
200.0 x 45.0 x 12.0 mm
