lst92991-eng/four-axis-robot-arm/hardware/xiangqi30-long275275-2026-10-13/SolidWorks/EQ275_铝型材挤压角座.SLDPRT

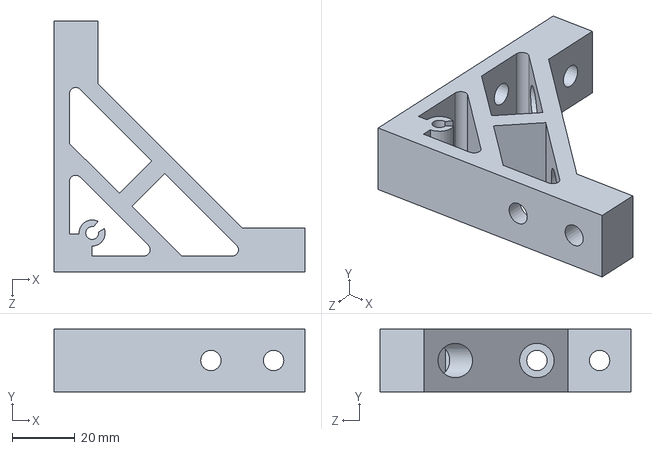
[picture p100: CAD file, 2026-11-02]
hardware/xiangqi30-long275275-2026-10-13/SolidWorks/EQ275_铝型材挤压角座.SLDPRT
80.0 x 20.0 x 80.0 mm
