lst92991-eng/four-axis-robot-arm/hardware/xiangqi33-assemblies-2026-10-13/long/SolidWorks/N33_EQ275_61mm光轴.SLDPRT

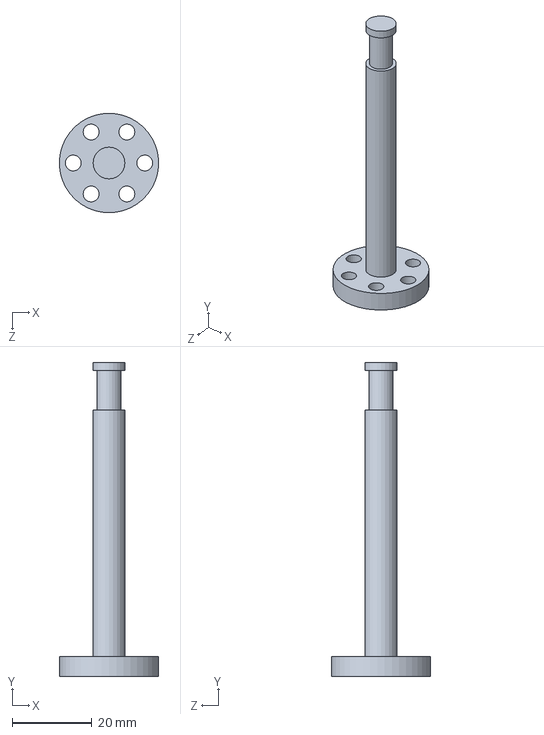
[picture p101: CAD file, 2026-11-02]
hardware/xiangqi33-assemblies-2026-10-13/long/SolidWorks/N33_EQ275_61mm光轴.SLDPRT
24.9 x 79.0 x 25.0 mm
