lst92991-eng/four-axis-robot-arm/hardware/arm_equal_275/v1/native/EQ275_T型丝杆螺母.SLDPRT

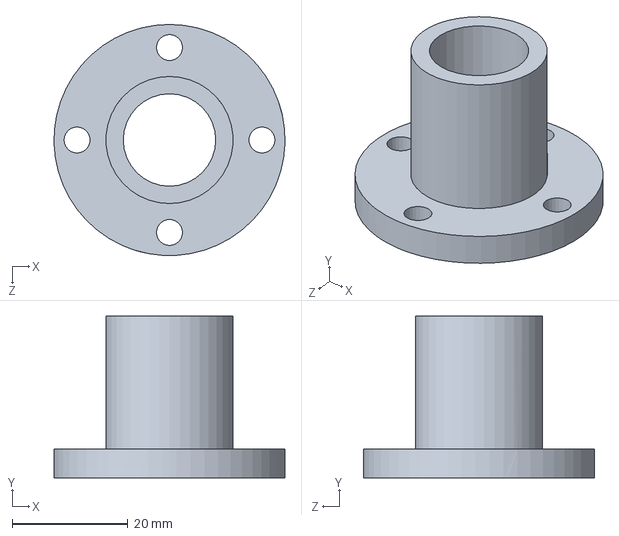
[picture p102: CAD file, 2026-11-02]
hardware/arm_equal_275/v1/native/EQ275_T型丝杆螺母.SLDPRT
40.0 x 28.0 x 40.0 mm
