lst92991-eng/four-axis-robot-arm/hardware/xiangqi30-long275275-2026-10-13/SolidWorks/LONG_EQ275_GT20同步轮.SLDPRT

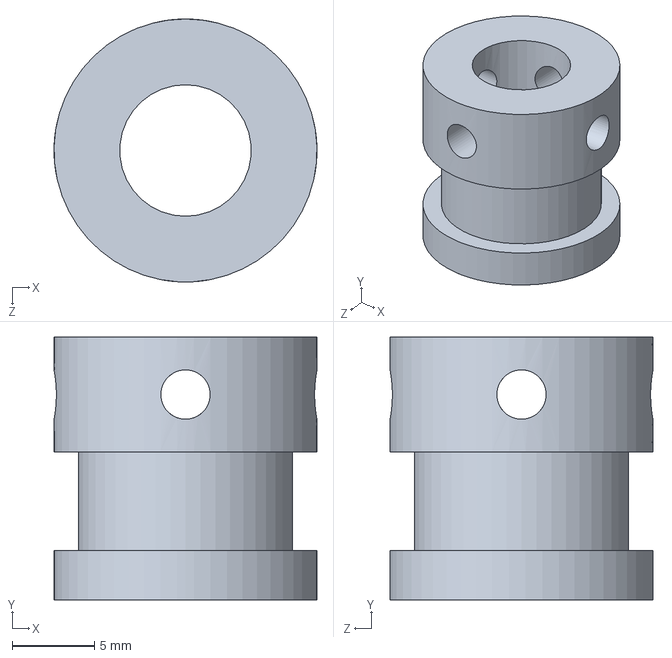
[picture p103: CAD file, 2026-11-02]
hardware/xiangqi30-long275275-2026-10-13/SolidWorks/LONG_EQ275_GT20同步轮.SLDPRT
16.0 x 16.0 x 16.0 mm
