lst92991-eng/four-axis-robot-arm/hardware/arm_equal_275/v1/native/EQ275_MGW12H滑块.SLDPRT

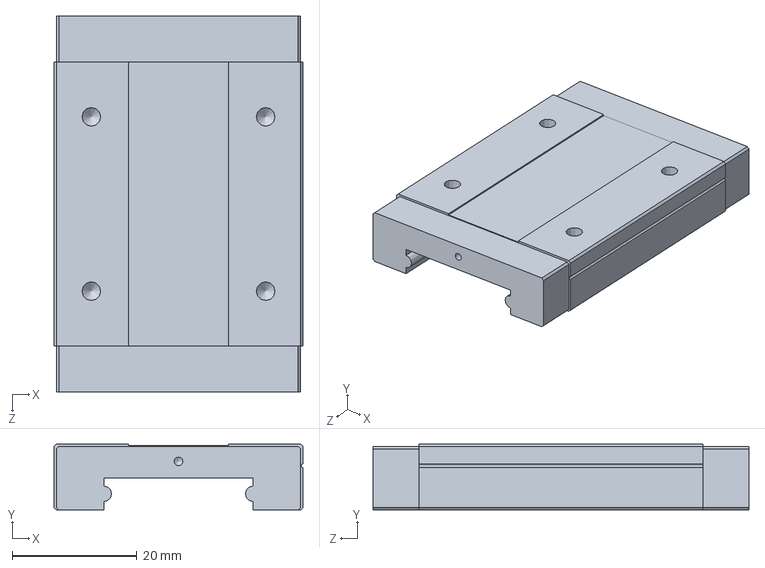
[picture p104: CAD file, 2026-11-02]
hardware/arm_equal_275/v1/native/EQ275_MGW12H滑块.SLDPRT
40.0 x 10.6 x 60.4 mm
