lst92991-eng/four-axis-robot-arm/hardware/camera_mount/v2/parts/04_camera_B_crossbar.step

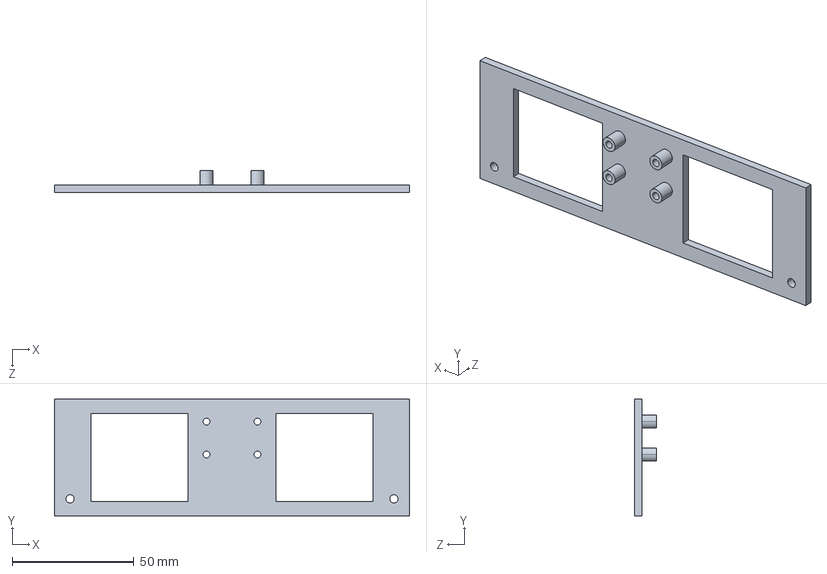
[picture p105: CAD file, 2026-11-02]
hardware/camera_mount/v2/parts/04_camera_B_crossbar.step
146.0 x 48.0 x 9.00 mm
