lst92991-eng/four-axis-robot-arm/hardware/xiangqi33-assemblies-2026-10-13/long/SolidWorks/N33_EQ275_底座.SLDPRT

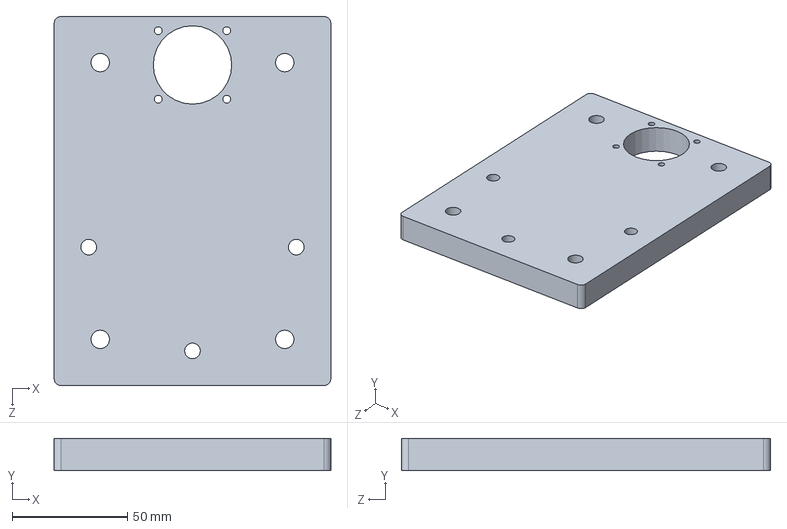
[picture p106: CAD file, 2026-11-02]
hardware/xiangqi33-assemblies-2026-10-13/long/SolidWorks/N33_EQ275_底座.SLDPRT
120.0 x 14.0 x 160.0 mm
