lst92991-eng/four-axis-robot-arm/hardware/xiangqi30-long275275-2026-10-13/SolidWorks/EQ275_40型材M4T型螺母.SLDPRT

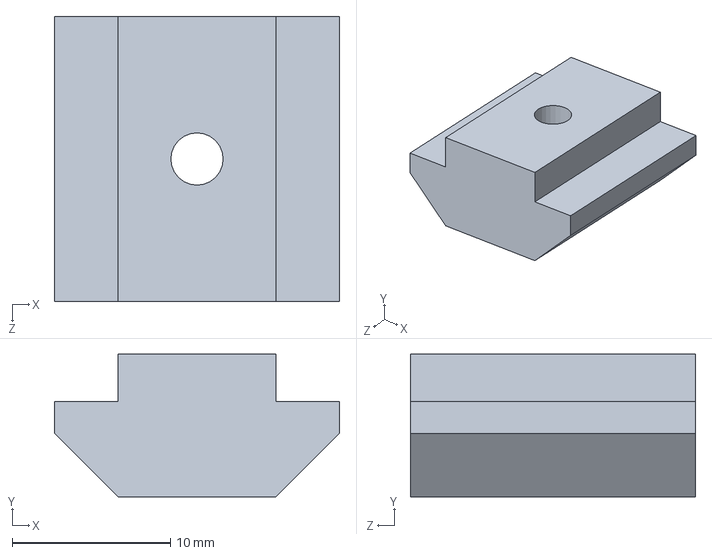
[picture p107: CAD file, 2026-11-02]
hardware/xiangqi30-long275275-2026-10-13/SolidWorks/EQ275_40型材M4T型螺母.SLDPRT
18.0 x 9.00 x 18.0 mm
