lst92991-eng/four-axis-robot-arm/hardware/xiangqi33-assemblies-2026-10-13/long/SolidWorks/N33_EQ275_42步进电机L60.SLDPRT

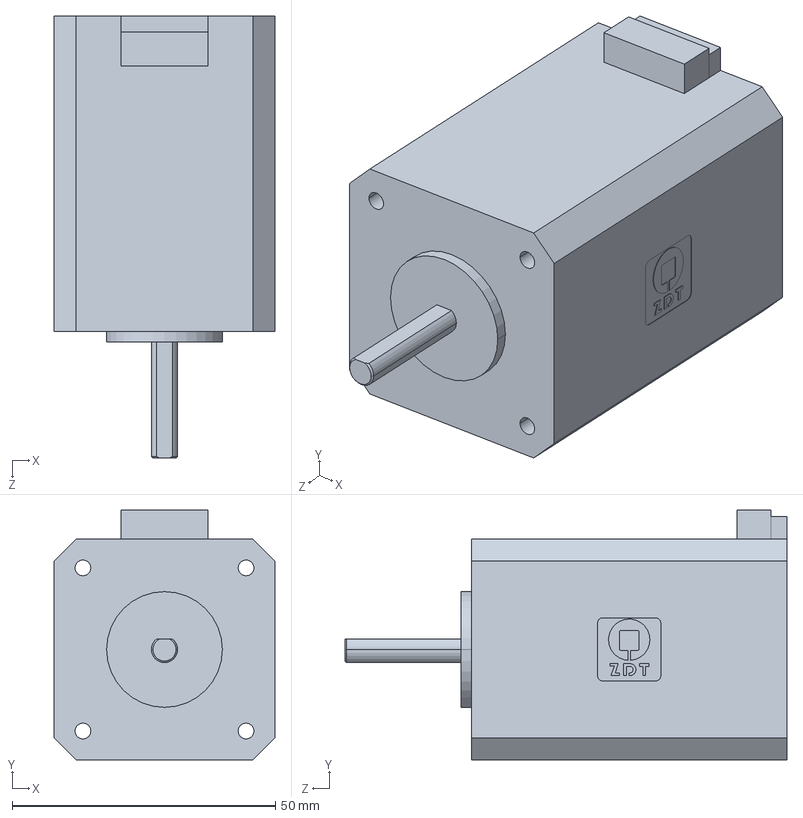
[picture p108: CAD file, 2026-11-02]
hardware/xiangqi33-assemblies-2026-10-13/long/SolidWorks/N33_EQ275_42步进电机L60.SLDPRT
42.0 x 47.5 x 84.0 mm
