lst92991-eng/four-axis-robot-arm/hardware/arm_equal_275/v1/native/EQ275_GT60同步轮.SLDPRT

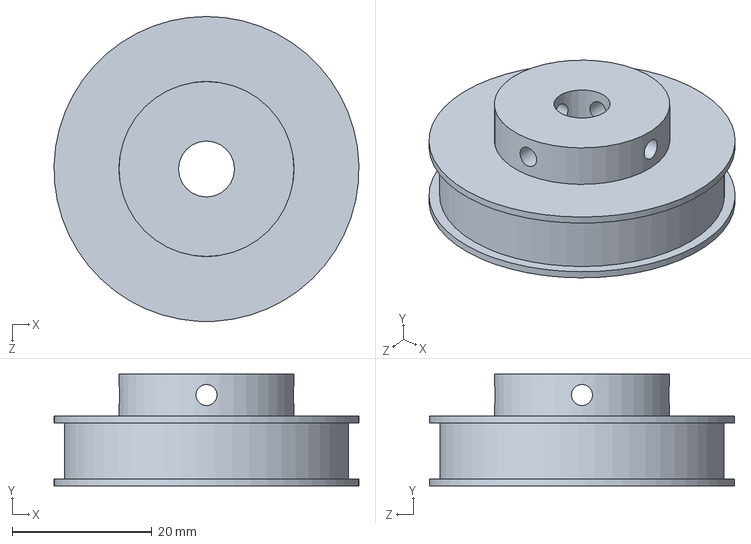
[picture p109: CAD file, 2026-11-02]
hardware/arm_equal_275/v1/native/EQ275_GT60同步轮.SLDPRT
43.6 x 16.0 x 43.6 mm
