lst92991-eng/four-axis-robot-arm/hardware/xiangqi33-assemblies-2026-10-13/long/SolidWorks/N33_EQ275_M3内六角x16mm.SLDPRT

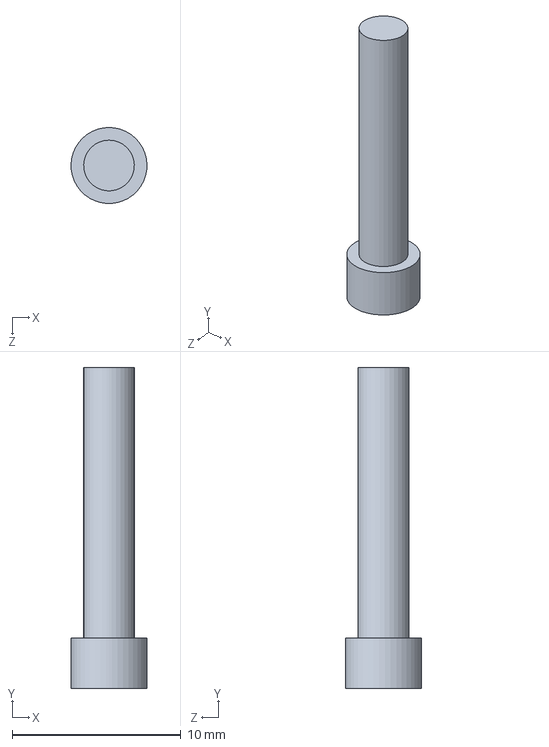
[picture p110: CAD file, 2026-11-02]
hardware/xiangqi33-assemblies-2026-10-13/long/SolidWorks/N33_EQ275_M3内六角x16mm.SLDPRT
4.50 x 19.0 x 4.50 mm
