lst92991-eng/four-axis-robot-arm/hardware/xiangqi30-long275275-2026-10-13/SolidWorks/EQ275_DLE42-L2BJ-长款50.SLDPRT

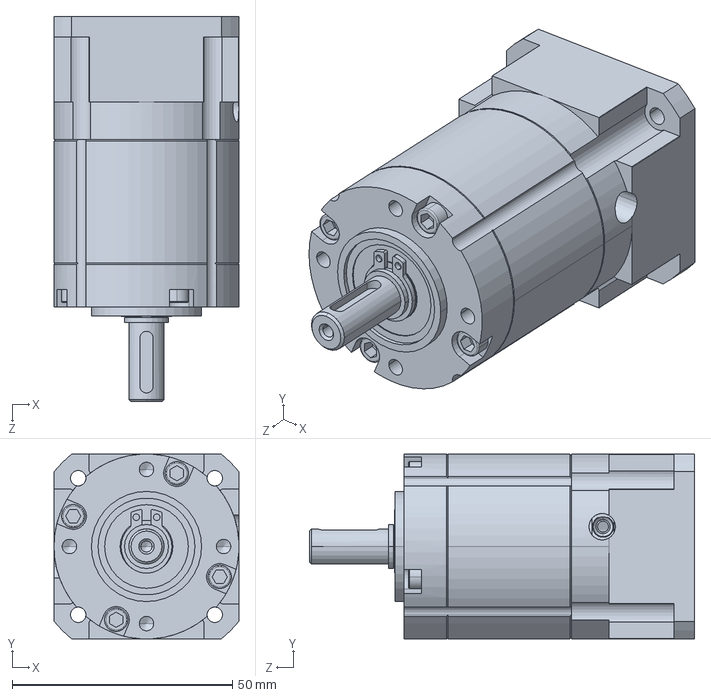
[picture p112: CAD file, 2026-11-02]
hardware/xiangqi30-long275275-2026-10-13/SolidWorks/EQ275_DLE42-L2BJ-长款50.SLDPRT
42.0 x 42.0 x 87.5 mm
