lst92991-eng/four-axis-robot-arm/hardware/xiangqi33-assemblies-2026-10-13/long/SolidWorks/N33_EQ275_M3x4mm紧固螺丝.SLDPRT

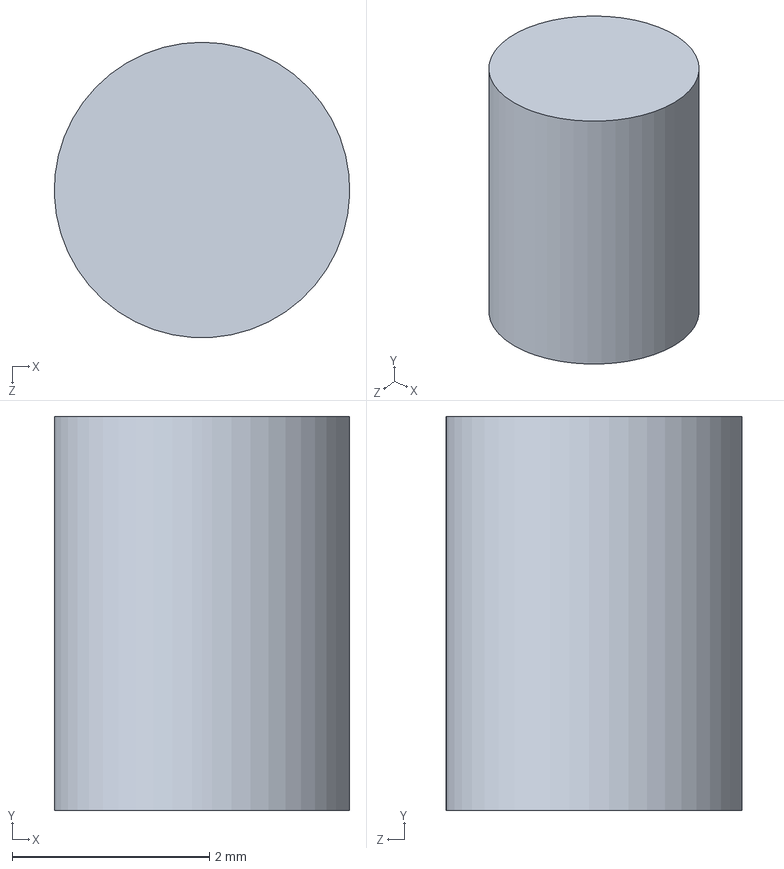
[picture p113: CAD file, 2026-11-02]
hardware/xiangqi33-assemblies-2026-10-13/long/SolidWorks/N33_EQ275_M3x4mm紧固螺丝.SLDPRT
3.00 x 4.00 x 3.00 mm
