lst92991-eng/four-axis-robot-arm/hardware/arm_equal_275/v1/native/EQ275_42步进电机L40.SLDPRT

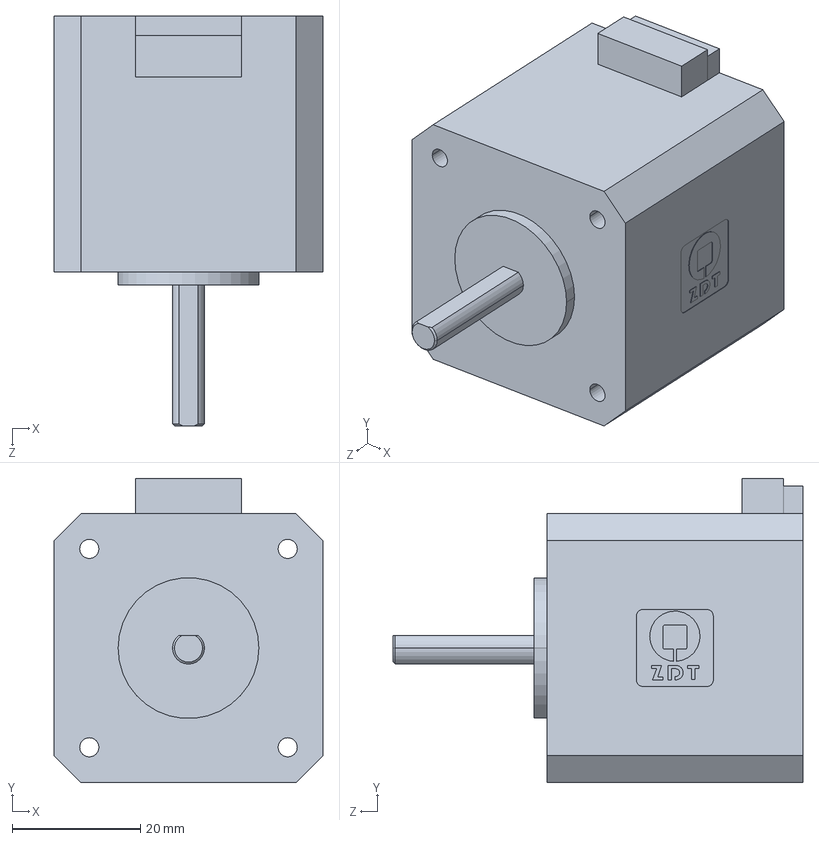
[picture p114: CAD file, 2026-11-02]
hardware/arm_equal_275/v1/native/EQ275_42步进电机L40.SLDPRT
42.0 x 47.5 x 64.0 mm
