lst92991-eng/four-axis-robot-arm/hardware/xiangqi30-long275275-2026-10-13/SolidWorks/LONG_piece_red_C.SLDPRT

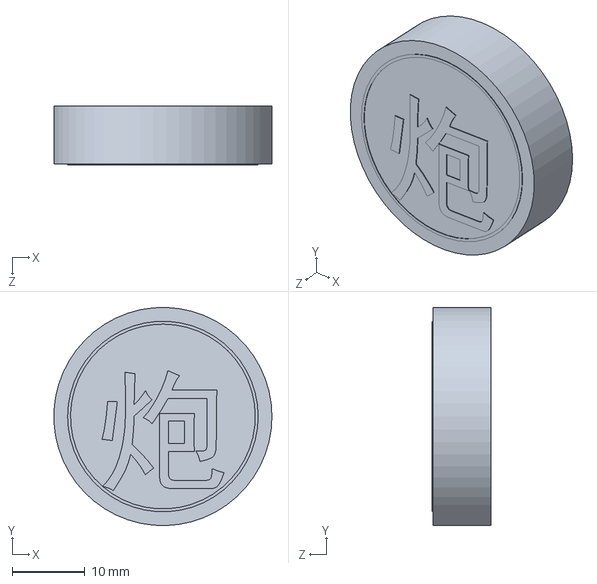
[picture p115: CAD file, 2026-11-02]
hardware/xiangqi30-long275275-2026-10-13/SolidWorks/LONG_piece_red_C.SLDPRT
30.0 x 30.0 x 8.10 mm
