lst92991-eng/four-axis-robot-arm/hardware/xiangqi33-assemblies-2026-10-13/long/SolidWorks/N33_EQ275_紧凑型轴承座.SLDPRT

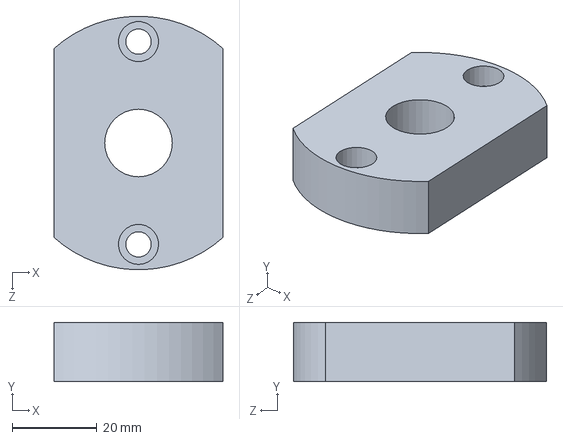
[picture p116: CAD file, 2026-11-02]
hardware/xiangqi33-assemblies-2026-10-13/long/SolidWorks/N33_EQ275_紧凑型轴承座.SLDPRT
40.0 x 14.0 x 59.9 mm
