lst92991-eng/four-axis-robot-arm/hardware/arm_equal_275/v1/native/EQ275_方键条销.SLDPRT

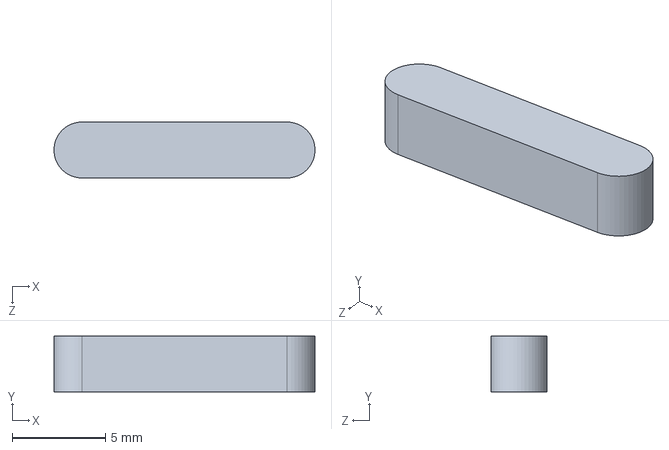
[picture p117: CAD file, 2026-11-02]
hardware/arm_equal_275/v1/native/EQ275_方键条销.SLDPRT
14.0 x 3.00 x 3.00 mm
