lst92991-eng/four-axis-robot-arm/hardware/xiangqi33-assemblies-2026-10-13/long/SolidWorks/N33_LONG_aruco_id_1_60mm.SLDPRT

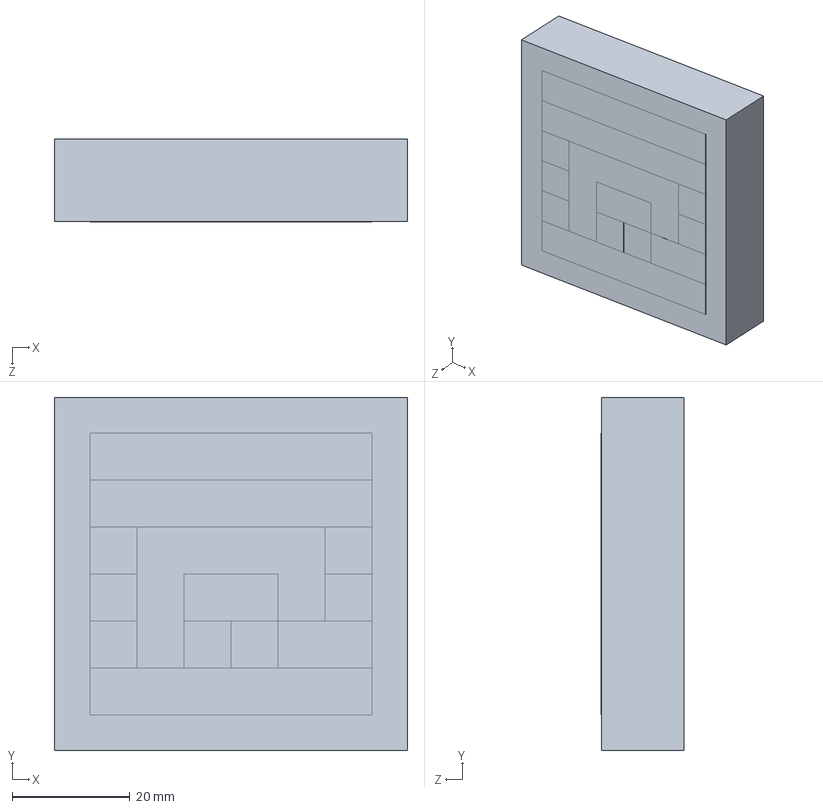
[picture p118: CAD file, 2026-11-02]
hardware/xiangqi33-assemblies-2026-10-13/long/SolidWorks/N33_LONG_aruco_id_1_60mm.SLDPRT
60.0 x 60.0 x 14.0 mm
