lst92991-eng/four-axis-robot-arm/hardware/arm_equal_275/v1/native/EQ275_内径8mm法兰.SLDPRT

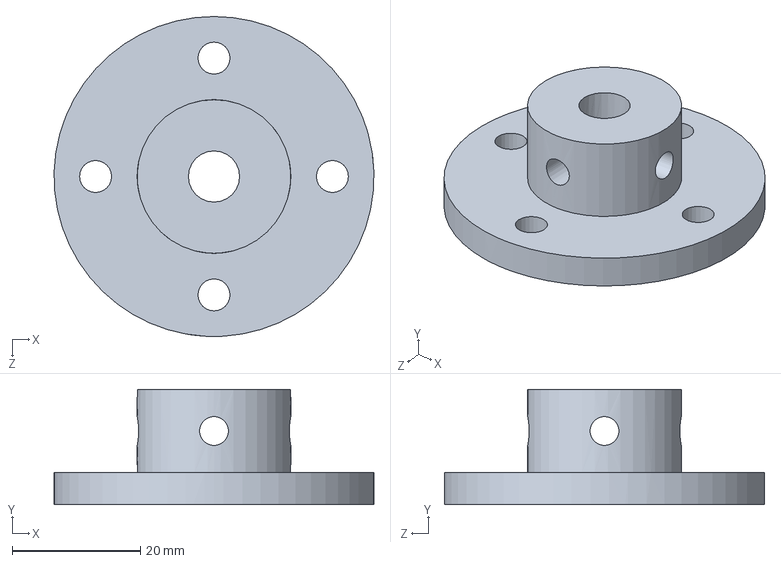
[picture p119: CAD file, 2026-11-02]
hardware/arm_equal_275/v1/native/EQ275_内径8mm法兰.SLDPRT
50.0 x 18.0 x 50.0 mm
