lst92991-eng/four-axis-robot-arm/hardware/xiangqi30-long275275-2026-10-13/SolidWorks/EQ275_8-16联轴器.SLDPRT

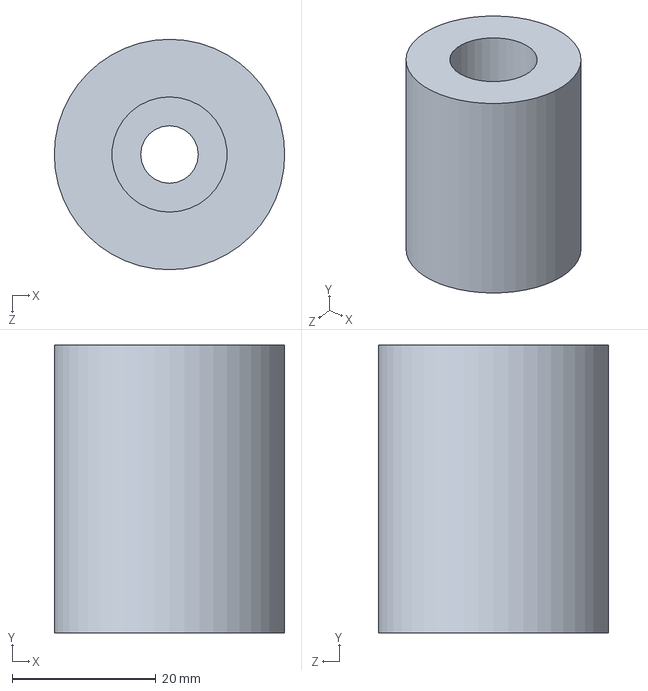
[picture p120: CAD file, 2026-11-02]
hardware/xiangqi30-long275275-2026-10-13/SolidWorks/EQ275_8-16联轴器.SLDPRT
32.0 x 40.0 x 32.0 mm
