lst92991-eng/four-axis-robot-arm/hardware/xiangqi33-assemblies-2026-10-13/long/SolidWorks/N33_EQ275_M8内六角x16mm.SLDPRT

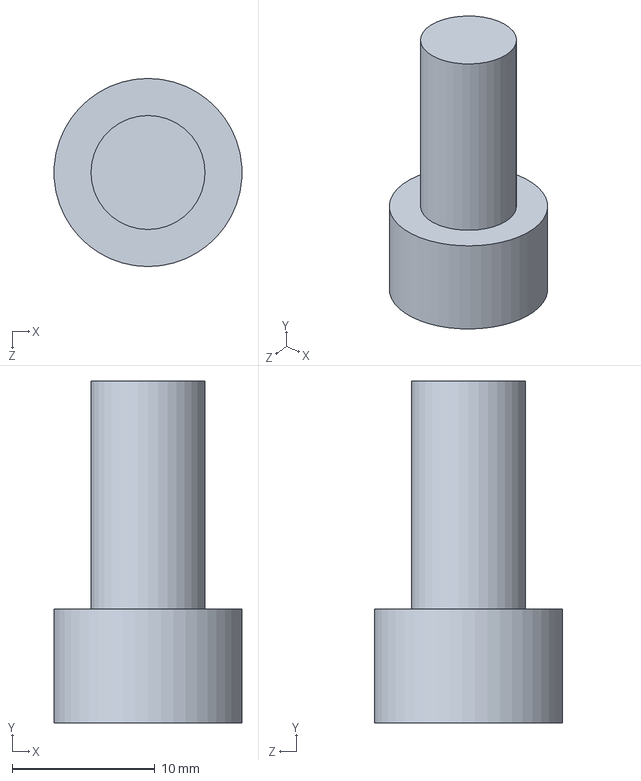
[picture p121: CAD file, 2026-11-02]
hardware/xiangqi33-assemblies-2026-10-13/long/SolidWorks/N33_EQ275_M8内六角x16mm.SLDPRT
13.2 x 24.0 x 13.2 mm
