lst92991-eng/four-axis-robot-arm/hardware/arm_equal_275/v1/native/EQ275_M8内六角x18mm.SLDPRT

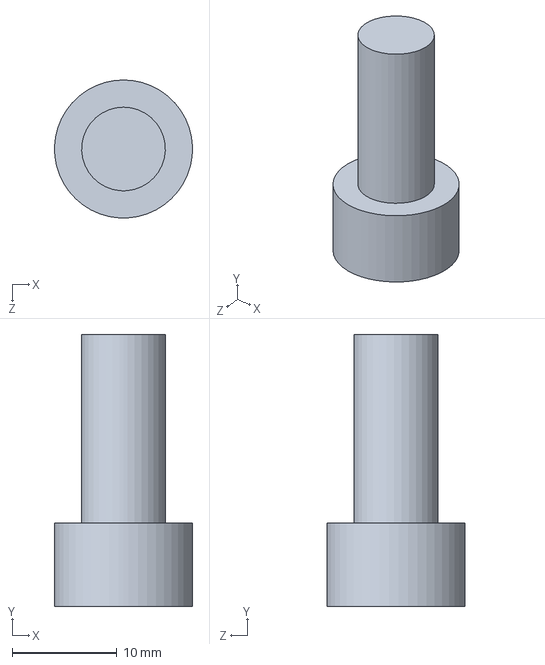
[picture p122: CAD file, 2026-11-02]
hardware/arm_equal_275/v1/native/EQ275_M8内六角x18mm.SLDPRT
13.2 x 26.0 x 13.2 mm
