lst92991-eng/four-axis-robot-arm/hardware/arm_equal_275/v1/native/EQ275_M3内六角x10mm.SLDPRT

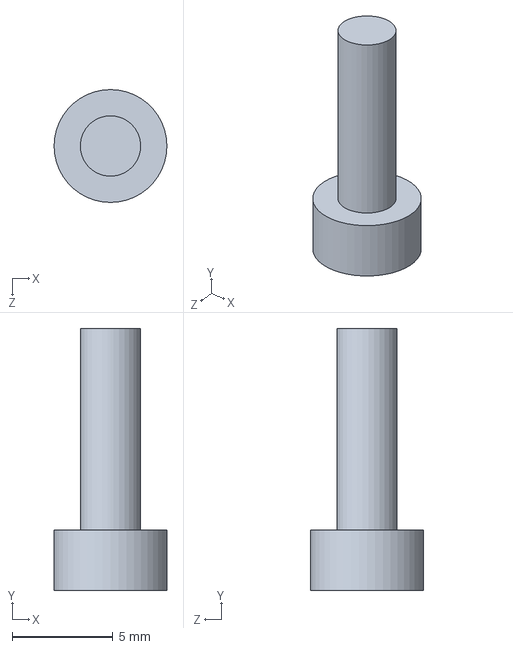
[picture p123: CAD file, 2026-11-02]
hardware/arm_equal_275/v1/native/EQ275_M3内六角x10mm.SLDPRT
5.60 x 13.0 x 5.60 mm
