lst92991-eng/four-axis-robot-arm/hardware/xiangqi30-long275275-2026-10-13/SolidWorks/EQ275_8mm键槽法兰.SLDPRT

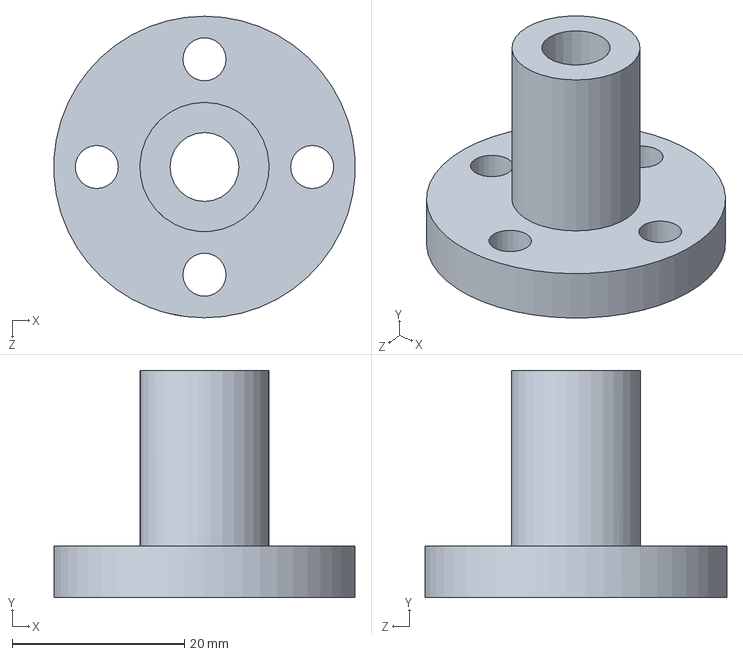
[picture p124: CAD file, 2026-11-02]
hardware/xiangqi30-long275275-2026-10-13/SolidWorks/EQ275_8mm键槽法兰.SLDPRT
34.9 x 26.4 x 35.0 mm
