lst92991-eng/four-axis-robot-arm/hardware/xiangqi33-assemblies-2026-10-13/long/SolidWorks/N33_LONG_piece_black_b.SLDPRT

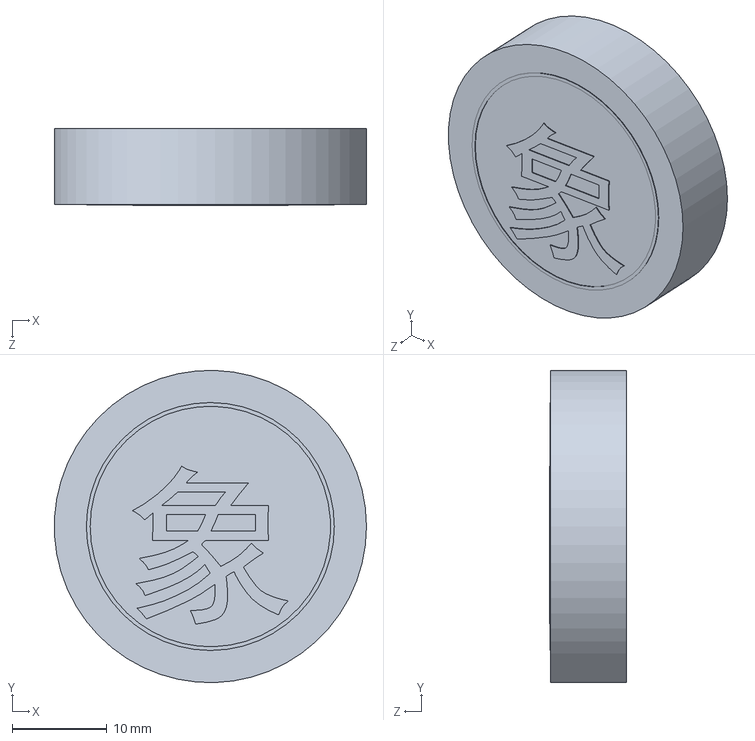
[picture p125: CAD file, 2026-11-02]
hardware/xiangqi33-assemblies-2026-10-13/long/SolidWorks/N33_LONG_piece_black_b.SLDPRT
33.0 x 33.0 x 8.10 mm
