lst92991-eng/four-axis-robot-arm/hardware/arm_equal_275/v1/native/EQ275_M6内六角x22.SLDPRT

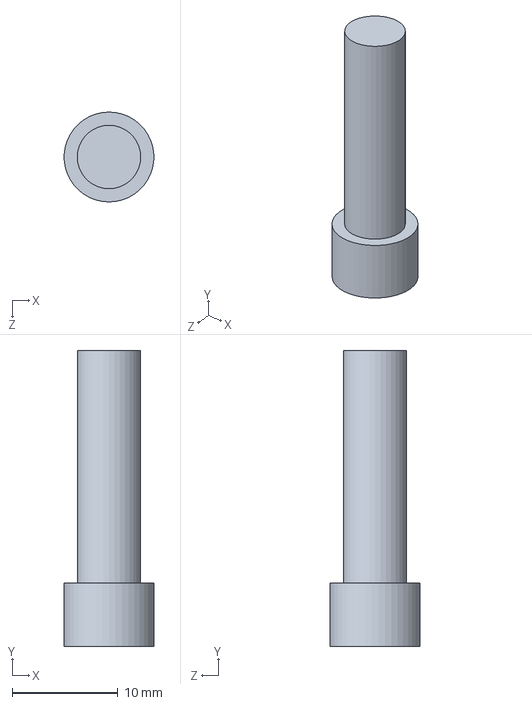
[picture p126: CAD file, 2026-11-02]
hardware/arm_equal_275/v1/native/EQ275_M6内六角x22.SLDPRT
8.48 x 28.0 x 8.50 mm
