lst92991-eng/four-axis-robot-arm/hardware/xiangqi30-long275275-2026-10-13/SolidWorks/EQ275_L型支架竖板.SLDPRT

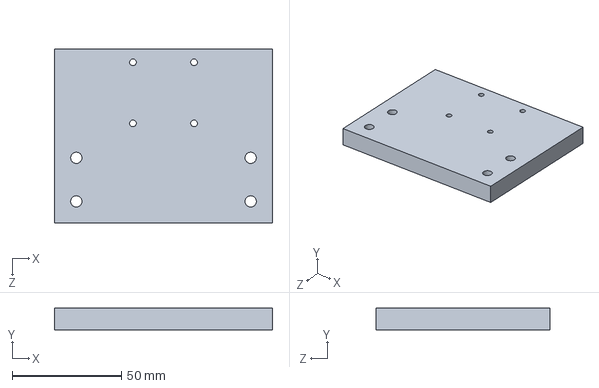
[picture p127: CAD file, 2026-11-02]
hardware/xiangqi30-long275275-2026-10-13/SolidWorks/EQ275_L型支架竖板.SLDPRT
100.0 x 10.0 x 80.0 mm
