lst92991-eng/four-axis-robot-arm/hardware/arm_equal_275/v1/native/EQ275_第二机械臂.SLDPRT

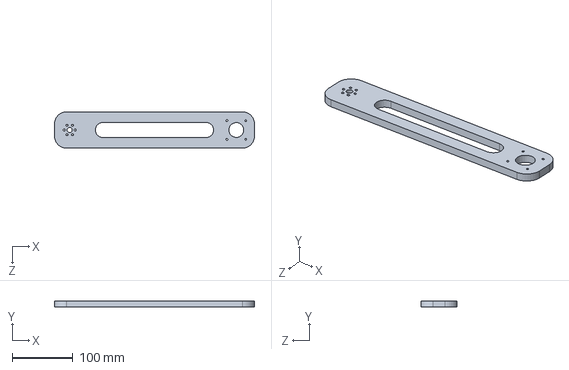
[picture p128: CAD file, 2026-11-02]
hardware/arm_equal_275/v1/native/EQ275_第二机械臂.SLDPRT
330.0 x 10.0 x 60.0 mm
