lst92991-eng/four-axis-robot-arm/hardware/xiangqi30-long275275-2026-10-13/SolidWorks/EQ275_40T型螺母M8孔.SLDPRT

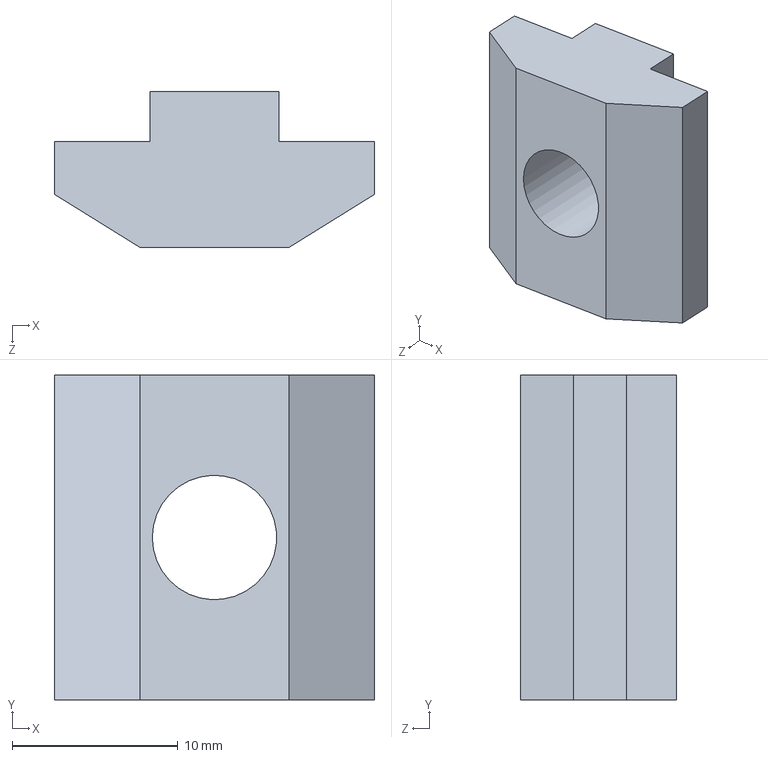
[picture p129: CAD file, 2026-11-02]
hardware/xiangqi30-long275275-2026-10-13/SolidWorks/EQ275_40T型螺母M8孔.SLDPRT
19.3 x 19.6 x 9.40 mm
