lst92991-eng/four-axis-robot-arm/hardware/arm_equal_275/v1/native/EQ275_M3内六角小头x16mm.SLDPRT

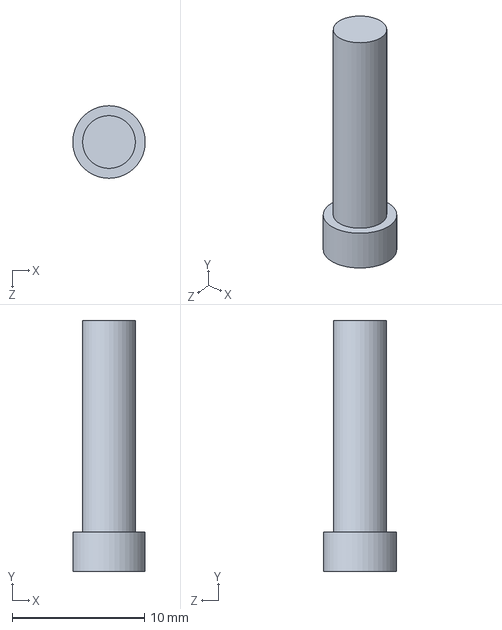
[picture p130: CAD file, 2026-11-02]
hardware/arm_equal_275/v1/native/EQ275_M3内六角小头x16mm.SLDPRT
5.48 x 19.0 x 5.50 mm
