lst92991-eng/four-axis-robot-arm/hardware/arm_equal_275/v1/native/EQ275_L型支架底座.SLDPRT

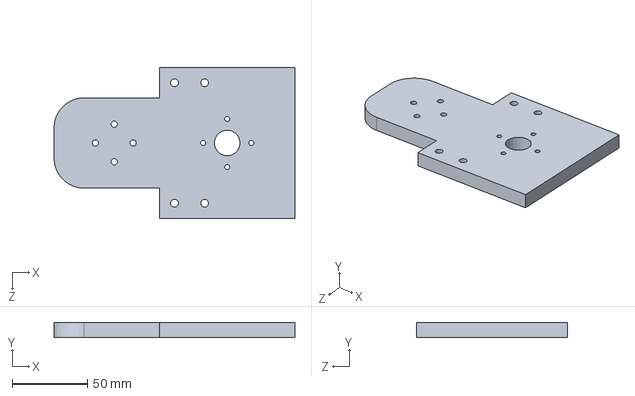
[picture p131: CAD file, 2026-11-02]
hardware/arm_equal_275/v1/native/EQ275_L型支架底座.SLDPRT
160.0 x 10.0 x 100.0 mm
