lst92991-eng/four-axis-robot-arm/hardware/arm_equal_275/v1/native/EQ275_FF丝杆支撑座[FF10].sldprt

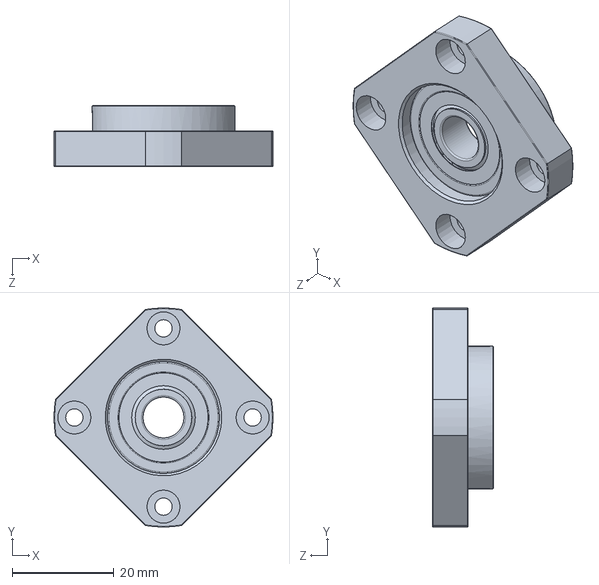
[picture p132: CAD file, 2026-11-02]
hardware/arm_equal_275/v1/native/EQ275_FF丝杆支撑座[FF10].sldprt
43.0 x 43.0 x 12.0 mm
