lst92991-eng/four-axis-robot-arm/hardware/arm_equal_275/v1/native/EQ275_光轴固定环.SLDPRT

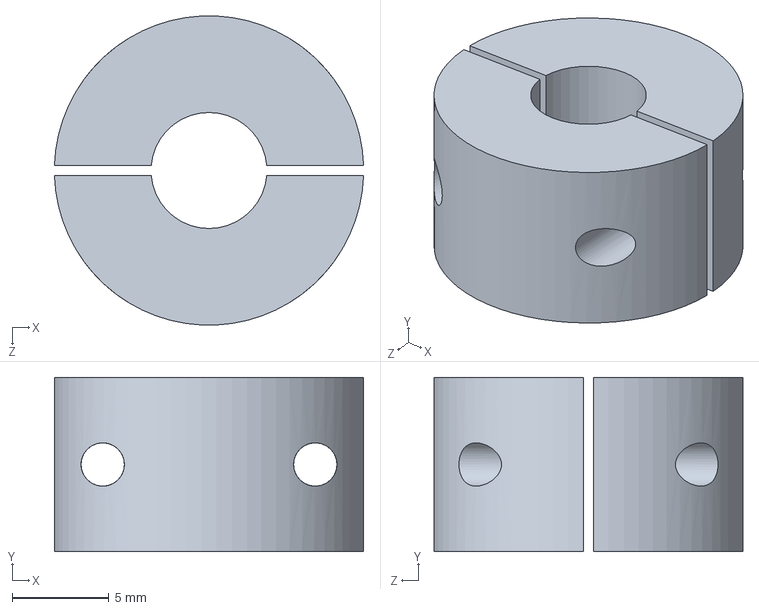
[picture p133: CAD file, 2026-11-02]
hardware/arm_equal_275/v1/native/EQ275_光轴固定环.SLDPRT
16.0 x 9.00 x 16.0 mm
