lst92991-eng/four-axis-robot-arm/hardware/arm_equal_275/v1/native/EQ275_轴承座8mm内径.SLDPRT

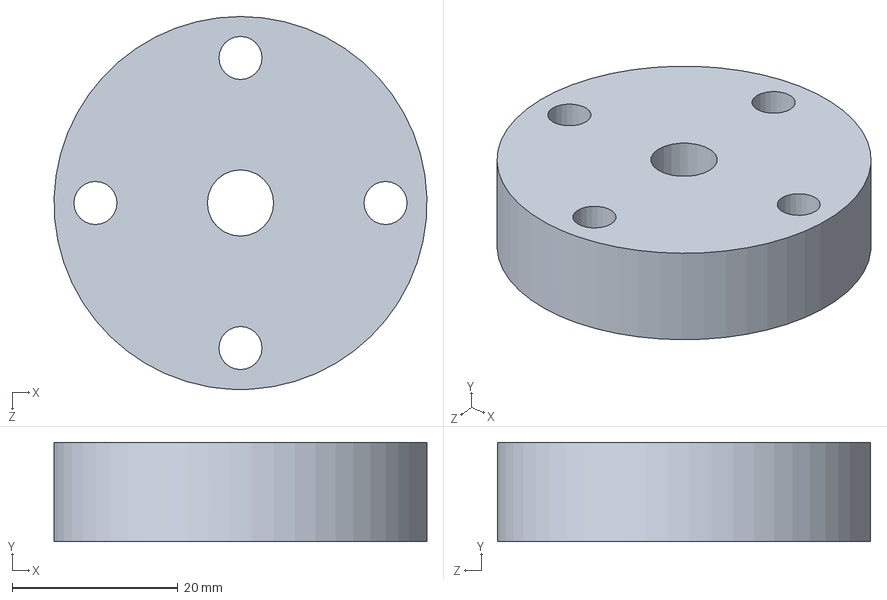
[picture p134: CAD file, 2026-11-02]
hardware/arm_equal_275/v1/native/EQ275_轴承座8mm内径.SLDPRT
45.0 x 12.0 x 45.0 mm
