lst92991-eng/four-axis-robot-arm/hardware/xiangqi30-long275275-2026-10-13/SolidWorks/EQ275_M4内六角x18mm.SLDPRT

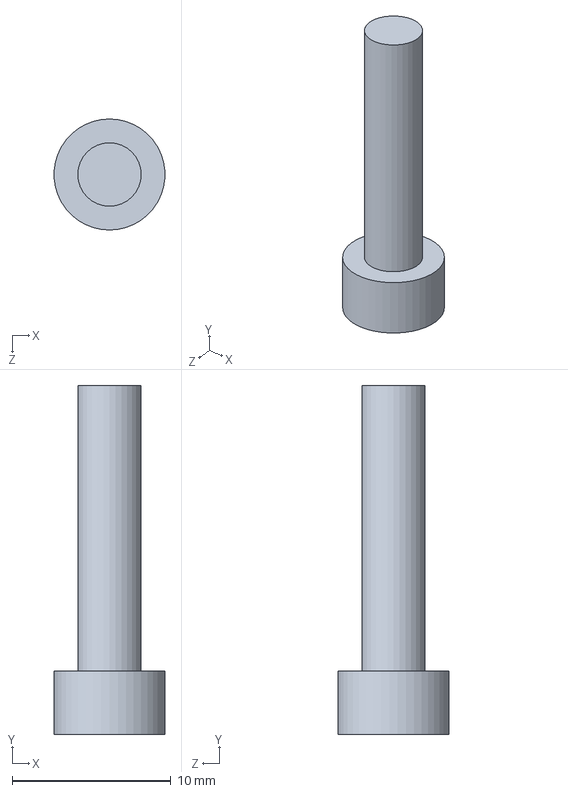
[picture p135: CAD file, 2026-11-02]
hardware/xiangqi30-long275275-2026-10-13/SolidWorks/EQ275_M4内六角x18mm.SLDPRT
6.98 x 22.0 x 7.00 mm
