lst92991-eng/four-axis-robot-arm/hardware/arm_equal_275/v1/native/EQ275_单头六角螺柱M3x30+6.SLDPRT

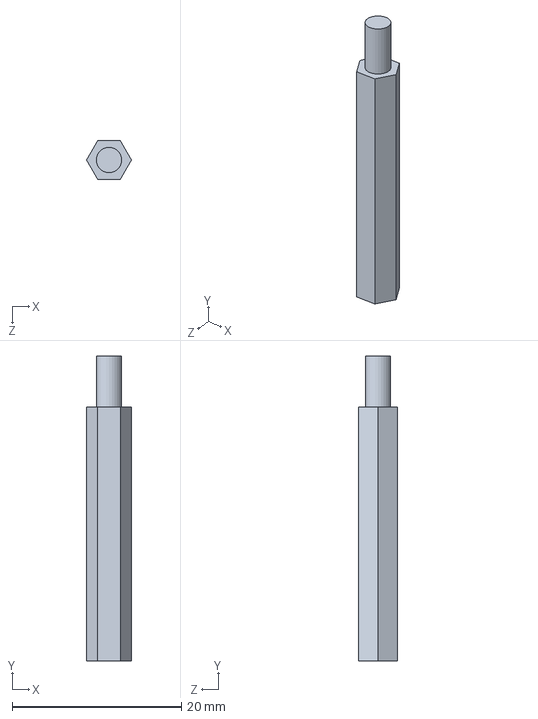
[picture p136: CAD file, 2026-11-02]
hardware/arm_equal_275/v1/native/EQ275_单头六角螺柱M3x30+6.SLDPRT
5.31 x 36.0 x 4.60 mm
