lst92991-eng/four-axis-robot-arm/hardware/arm_equal_275/v1/native/EQ275_FF固定铝板.SLDPRT

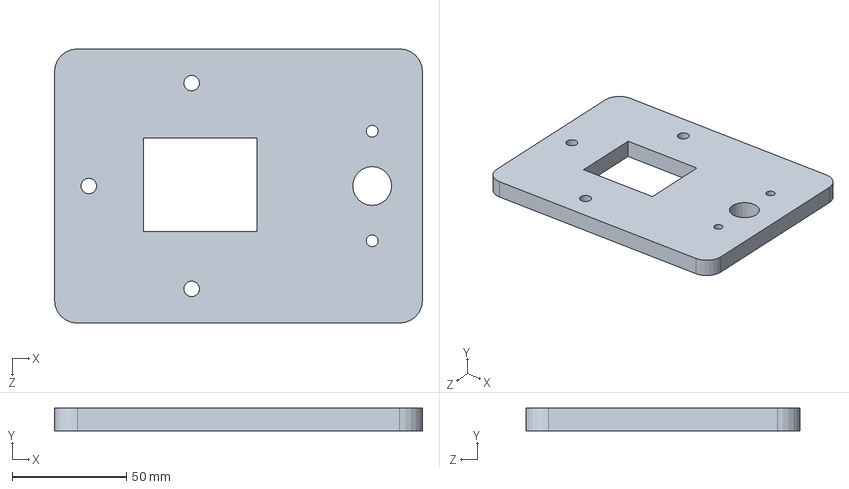
[picture p137: CAD file, 2026-11-02]
hardware/arm_equal_275/v1/native/EQ275_FF固定铝板.SLDPRT
161.0 x 10.0 x 120.0 mm
