lst92991-eng/four-axis-robot-arm/hardware/xiangqi33-assemblies-2026-10-13/long/SolidWorks/N33_LONG_board_315x350_pitch35.SLDPRT

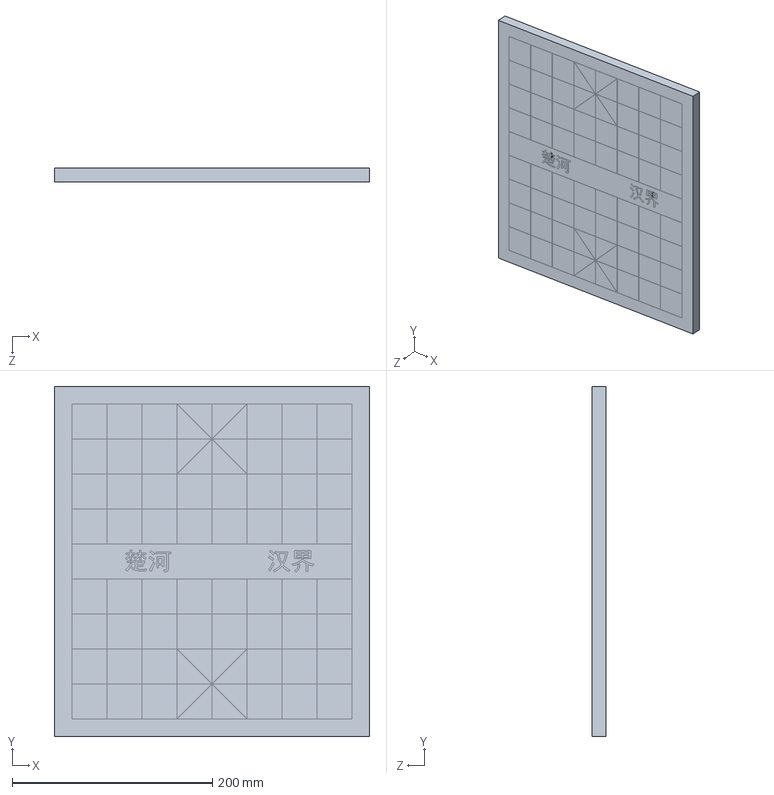
[picture p138: CAD file, 2026-11-02]
hardware/xiangqi33-assemblies-2026-10-13/long/SolidWorks/N33_LONG_board_315x350_pitch35.SLDPRT
315.0 x 350.0 x 14.1 mm
