lst92991-eng/four-axis-robot-arm/hardware/xiangqi30-long275275-2026-10-13/SolidWorks/EQ275_M6小头内六角x22.SLDPRT

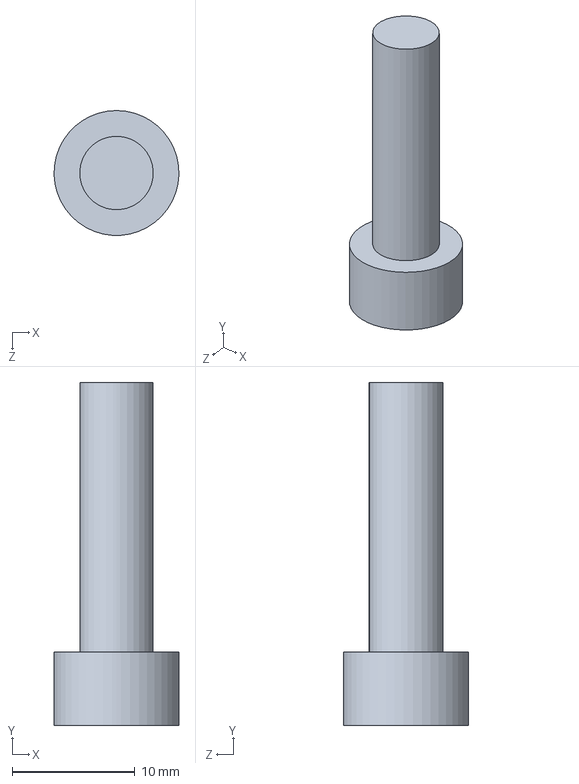
[picture p139: CAD file, 2026-11-02]
hardware/xiangqi30-long275275-2026-10-13/SolidWorks/EQ275_M6小头内六角x22.SLDPRT
10.2 x 28.0 x 10.2 mm
