lst92991-eng/four-axis-robot-arm/hardware/arm_equal_275/v1/native/EQ275_M5内六角x16.SLDPRT

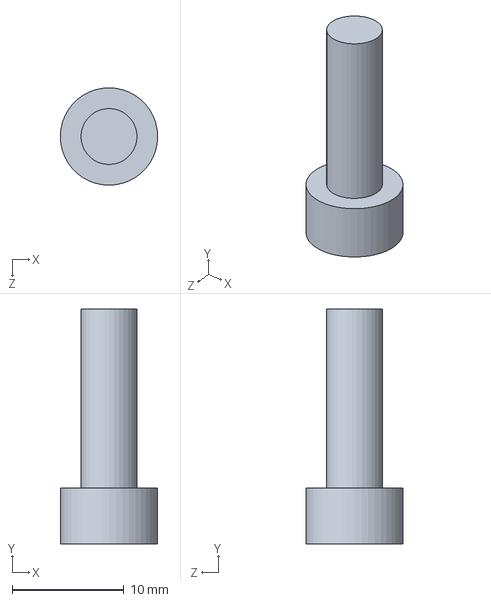
[picture p140: CAD file, 2026-11-02]
hardware/arm_equal_275/v1/native/EQ275_M5内六角x16.SLDPRT
8.70 x 21.0 x 8.70 mm
