lst92991-eng/four-axis-robot-arm/hardware/xiangqi30-long275275-2026-10-13/SolidWorks/EQ275_40x40x500.SLDPRT

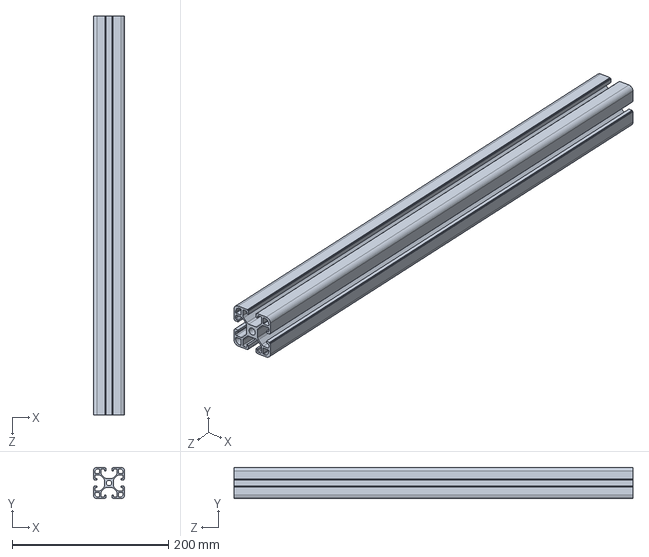
[picture p141: CAD file, 2026-11-02]
hardware/xiangqi30-long275275-2026-10-13/SolidWorks/EQ275_40x40x500.SLDPRT
40.0 x 40.0 x 510.0 mm
