lst92991-eng/four-axis-robot-arm/hardware/xiangqi33-assemblies-2026-10-13/long/SolidWorks/N33_EQ275_8x10x3mm轴套.SLDPRT

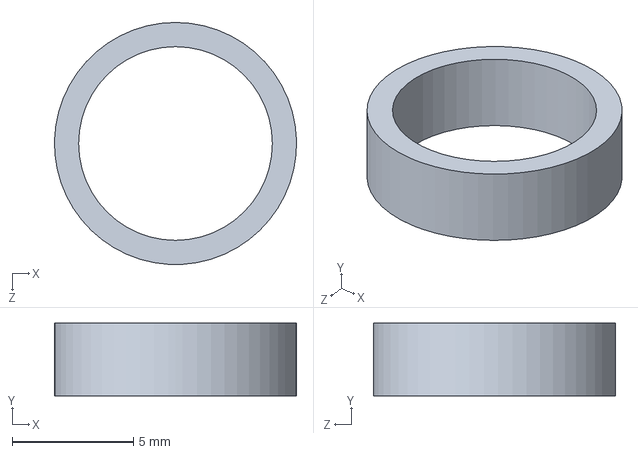
[picture p142: CAD file, 2026-11-02]
hardware/xiangqi33-assemblies-2026-10-13/long/SolidWorks/N33_EQ275_8x10x3mm轴套.SLDPRT
10.00 x 3.00 x 10.0 mm
