lst92991-eng/four-axis-robot-arm/hardware/arm_equal_275/v1/native/EQ275_SCARA四轴机械臂总成.SLDASM

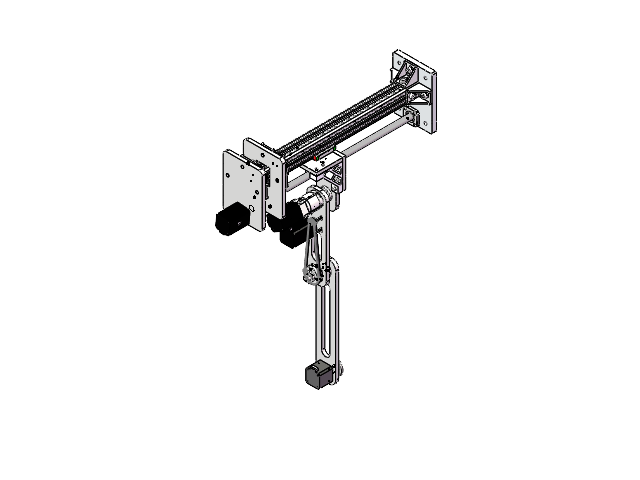
[picture p144: CAD file, 2026-11-02]
hardware/arm_equal_275/v1/native/EQ275_SCARA四轴机械臂总成.SLDASM
EQ275_40x40x500
EQ275_底座
EQ275_40型材M4T型螺母 x 7
EQ275_MGW12H滑块
EQ275_MGW12_500mm
EQ275_42步进电机L60 x 3
EQ275_DLE42-L2BJ-长款50
EQ275_FF固定铝板
EQ275_40型材角件 x 9
EQ275_电机支撑铝板
EQ275_单头六角螺柱M3x30+6 x 4
EQ275_L型支架底座
EQ275_L型支架竖板
EQ275_铝型材挤压角座 x 2
EQ275_方键条销
EQ275_第二机械臂
EQ275_J1机械臂
EQ275_42步进电机L40
EQ275_轴承座8mm内径
EQ275_FF ______________[FF12]
EQ275_SKF_608-2ZZ
EQ275_内径8mm法兰
EQ275_GT20同步轮
EQ275_GT60同步轮
皮带1-2^装配体1_EQ275_SCARA四轴机械臂总成
EQ275_40T型螺母M8孔 x 9
EQ275_M8内六角x18mm x 9
EQ275_M8内六角x16mm x 9
EQ275_M3内六角x16mm x 8
EQ275_M4内六角x16mm x 14
EQ275_M6内六角x22 x 8
EQ275_M3内六角x12mm x 12
EQ275_M5内六角x16 x 4
EQ275_M3x4mm紧固螺丝 x 8
EQ275_M4内六角x18mm x 7
EQ275_M3内六角x10mm x 4
EQ275_8mm键槽法兰
EQ275_光轴固定环
EQ275_8x10x3mm轴套
EQ275_T型丝杆500mm
EQ275_8-16联轴器
EQ275_紧凑型轴承座
EQ275_T型丝杆螺母
EQ275_M6小头内六角x22 x 2
EQ275_FF丝杆支撑座[FF10]
EQ275_M3内六角小头x16mm x 8
EQ275_61mm光轴
