lst92991-eng/four-axis-robot-arm/hardware/xiangqi30-long275275-2026-10-13/SolidWorks/EQ275_DRIVE_ASSEMBLY.SLDASM

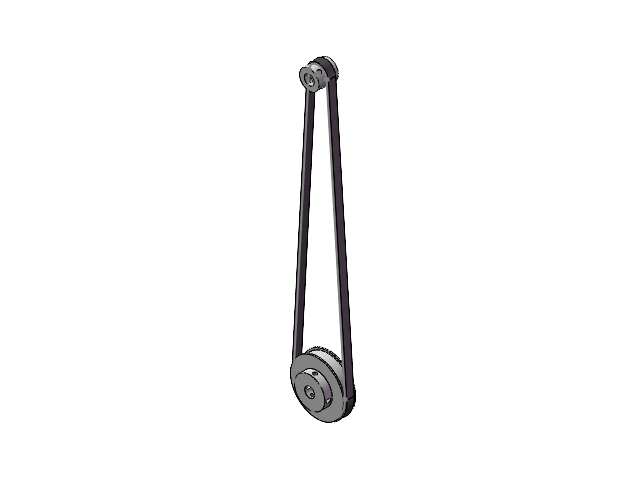
[picture p146: CAD file, 2026-11-02]
hardware/xiangqi30-long275275-2026-10-13/SolidWorks/EQ275_DRIVE_ASSEMBLY.SLDASM
LONG_EQ275_GT20同步轮
LONG_EQ275_GT60同步轮
EQ275_BELT
