lst92991-eng/four-axis-robot-arm/(list of files, cad)

Other CAD files:
hardware/xiangqi33-assemblies-2026-10-13/long/SolidWorks/N33_EQ275_SCARA四轴机械臂总成.SLDASM
hardware/xiangqi33-assemblies-2026-10-13/long/SolidWorks/N33_EQ275_DRIVE_ASSEMBLY.SLDASM
hardware/camera_mount/v2/reference/rv1106_board.SLDPRT
hardware/xiangqi30-long275275-2026-10-13/reference/RV1106_PCB_user_supplied.step
hardware/xiangqi30-long275275-2026-10-13/SolidWorks/EQ275_FF ______________[FF12].SLDPRT
hardware/xiangqi33-assemblies-2026-10-13/long/SCARA_FRONT_275_275_CHESS33.step
hardware/xiangqi33-assemblies-2026-10-13/reference/RV1106_PCB_user_supplied.step
hardware/camera_mount/v2/parts/02_clamp_left.step
hardware/xiangqi30-long275275-2026-10-13/SolidWorks/EQ275_BELT.SLDPRT
hardware/xiangqi33-assemblies-2026-10-13/long/SolidWorks/N33_LONG_piece_red_C.SLDPRT
hardware/xiangqi30-long275275-2026-10-13/SolidWorks/LONG_piece_red_P.SLDPRT
hardware/xiangqi33-assemblies-2026-10-13/long/SolidWorks/N33_EQ275_BELT.SLDPRT
hardware/xiangqi30-long275275-2026-10-13/SolidWorks/LONG_piece_black_p.SLDPRT
hardware/xiangqi30-long275275-2026-10-13/SolidWorks/LONG_piece_black_k.SLDPRT
hardware/xiangqi33-assemblies-2026-10-13/long/SolidWorks/N33_LONG_piece_black_p.SLDPRT
hardware/xiangqi30-long275275-2026-10-13/SolidWorks/LONG_piece_red_K.SLDPRT
hardware/xiangqi33-assemblies-2026-10-13/long/SolidWorks/N33_LONG_aruco_id_3_60mm.SLDPRT
hardware/xiangqi30-long275275-2026-10-13/SolidWorks/LONG_piece_black_r.SLDPRT
hardware/xiangqi33-assemblies-2026-10-13/long/SolidWorks/N33_LONG_piece_red_R.SLDPRT
hardware/xiangqi30-long275275-2026-10-13/SolidWorks/LONG_piece_red_B.SLDPRT
hardware/xiangqi33-assemblies-2026-10-13/long/SolidWorks/N33_LONG_piece_red_K.SLDPRT
hardware/arm_equal_275/v1/native/EQ275_FF ______________[FF12].SLDPRT
hardware/xiangqi33-assemblies-2026-10-13/long/SolidWorks/N33_LONG_piece_red_P.SLDPRT
hardware/arm_equal_275/v1/native/EQ275_J1机械臂.SLDPRT
hardware/xiangqi33-assemblies-2026-10-13/long/SolidWorks/N33_LONG_aruco_id_0_60mm.SLDPRT
hardware/xiangqi30-long275275-2026-10-13/SolidWorks/LONG_aruco_id_2_60mm.SLDPRT
hardware/xiangqi33-assemblies-2026-10-13/long/SolidWorks/N33_LONG_piece_black_a.SLDPRT
hardware/xiangqi33-assemblies-2026-10-13/long/SolidWorks/N33_LONG_piece_red_B.SLDPRT
hardware/xiangqi30-long275275-2026-10-13/SolidWorks/LONG_piece_red_N.SLDPRT
hardware/xiangqi30-long275275-2026-10-13/SolidWorks/LONG_piece_black_c.SLDPRT
hardware/xiangqi33-assemblies-2026-10-13/long/SolidWorks/N33_LONG_piece_red_N.SLDPRT
hardware/xiangqi30-long275275-2026-10-13/SolidWorks/LONG_aruco_id_3_60mm.SLDPRT
hardware/camera_mount/v1/camera_mount.SLDASM
hardware/camera_mount/v1/camera_mount.step
hardware/camera_mount/v1/layout_check.SLDASM
hardware/camera_mount/v1/layout_check.step
hardware/camera_mount/v1/parts/01_base.SLDPRT
hardware/camera_mount/v1/parts/01_base.step
hardware/camera_mount/v1/parts/02_mast_150.SLDPRT
hardware/camera_mount/v1/parts/02_mast_150.step
hardware/camera_mount/v1/parts/03_height_spacer_50.SLDPRT
hardware/camera_mount/v1/parts/03_height_spacer_50.step
hardware/camera_mount/v1/parts/04_rear_braced_boom.SLDPRT
hardware/camera_mount/v1/parts/04_rear_braced_boom.step
hardware/camera_mount/v1/parts/05_front_boom.SLDPRT
hardware/camera_mount/v1/parts/05_front_boom.step
hardware/camera_mount/v1/parts/06_splice_plate.SLDPRT
hardware/camera_mount/v1/parts/06_splice_plate.step
hardware/camera_mount/v1/parts/07_camera_B_carrier.SLDPRT
hardware/camera_mount/v1/parts/07_camera_B_carrier.step
hardware/camera_mount/v1/parts/08_board_tray.SLDPRT
hardware/camera_mount/v1/parts/08_board_tray.step
hardware/camera_mount/v1/parts/reference_board.SLDPRT
hardware/camera_mount/v1/parts/reference_camera_B.SLDPRT
hardware/camera_mount/v1/print/01_base.STL
hardware/camera_mount/v1/print/02_mast_150.STL
hardware/camera_mount/v1/print/03_height_spacer_50.STL
hardware/camera_mount/v1/print/04_rear_braced_boom.STL
hardware/camera_mount/v1/print/05_front_boom.STL
hardware/camera_mount/v1/print/06_splice_plate.STL
hardware/camera_mount/v1/print/07_camera_B_carrier.STL
hardware/camera_mount/v1/print/08_board_tray.STL
hardware/camera_mount/v2/camera_bridge.SLDASM
hardware/camera_mount/v2/layout_check.SLDASM
hardware/camera_mount/v2/parts/01_clamp_right.SLDPRT
hardware/camera_mount/v2/parts/02_clamp_left.SLDPRT
hardware/camera_mount/v2/parts/03_truss_200.SLDPRT
hardware/camera_mount/v2/parts/04_camera_B_crossbar.SLDPRT
hardware/camera_mount/v2/parts/05_pcb_support.SLDPRT
hardware/camera_mount/v2/print/01_clamp_right.STL
hardware/camera_mount/v2/print/02_clamp_left.STL
hardware/camera_mount/v2/print/03_truss_200.STL
hardware/camera_mount/v2/print/04_camera_B_crossbar.STL
hardware/camera_mount/v2/print/05_pcb_support.STL
hardware/xiangqi30-long275275-2026-10-13/SolidWorks/EQ275_J1机械臂.SLDPRT
hardware/xiangqi30-long275275-2026-10-13/SolidWorks/LONG_aruco_id_0_60mm.SLDPRT
hardware/xiangqi30-long275275-2026-10-13/SolidWorks/LONG_piece_black_a.SLDPRT
hardware/xiangqi30-long275275-2026-10-13/SolidWorks/LONG_piece_black_b.SLDPRT
hardware/xiangqi30-long275275-2026-10-13/SolidWorks/LONG_piece_black_n.SLDPRT
hardware/xiangqi30-long275275-2026-10-13/SolidWorks/LONG_piece_red_A.SLDPRT
hardware/xiangqi30-long275275-2026-10-13/SolidWorks/LONG_piece_red_R.SLDPRT
hardware/xiangqi30-long275275-2026-10-13/SolidWorks/SCARA_FRONT_275_275_CHESS30.SLDASM
hardware/xiangqi30-old195275-2026-10-12/delivery-front-2026-10-13/SCARA_FRONT_195_275_CHESS30.step
hardware/xiangqi30-old195275-2026-10-12/delivery-front-2026-10-13/SolidWorks/GT20同步轮.SLDPRT
hardware/xiangqi30-old195275-2026-10-12/delivery-front-2026-10-13/SolidWorks/GT60同步轮.SLDPRT
hardware/xiangqi30-old195275-2026-10-12/delivery-front-2026-10-13/SolidWorks/OLD_40T型螺母M8孔.SLDPRT
hardware/xiangqi30-old195275-2026-10-12/delivery-front-2026-10-13/SolidWorks/OLD_40x40x500.SLDPRT
hardware/xiangqi30-old195275-2026-10-12/delivery-front-2026-10-13/SolidWorks/OLD_40型材M4T型螺母.SLDPRT
hardware/xiangqi30-old195275-2026-10-12/delivery-front-2026-10-13/SolidWorks/OLD_40型材角件.SLDPRT
hardware/xiangqi30-old195275-2026-10-12/delivery-front-2026-10-13/SolidWorks/OLD_42步进电机L40.SLDPRT
hardware/xiangqi30-old195275-2026-10-12/delivery-front-2026-10-13/SolidWorks/OLD_42步进电机L60.SLDPRT
hardware/xiangqi30-old195275-2026-10-12/delivery-front-2026-10-13/SolidWorks/OLD_61mm光轴.SLDPRT
hardware/xiangqi30-old195275-2026-10-12/delivery-front-2026-10-13/SolidWorks/OLD_8-16联轴器.SLDPRT
hardware/xiangqi30-old195275-2026-10-12/delivery-front-2026-10-13/SolidWorks/OLD_8mm键槽法兰.SLDPRT
hardware/xiangqi30-old195275-2026-10-12/delivery-front-2026-10-13/SolidWorks/OLD_8x10x3mm轴套.SLDPRT
hardware/xiangqi30-old195275-2026-10-12/delivery-front-2026-10-13/SolidWorks/OLD_BELT.SLDPRT
hardware/xiangqi30-old195275-2026-10-12/delivery-front-2026-10-13/SolidWorks/OLD_DLE42-L2BJ-长款50.SLDPRT
hardware/xiangqi30-old195275-2026-10-12/delivery-front-2026-10-13/SolidWorks/OLD_DRIVE_ASSEMBLY.SLDASM
hardware/xiangqi30-old195275-2026-10-12/delivery-front-2026-10-13/SolidWorks/OLD_FF ______________[FF12].SLDPRT
hardware/xiangqi30-old195275-2026-10-12/delivery-front-2026-10-13/SolidWorks/OLD_FF丝杆支撑座[FF10].sldprt
hardware/xiangqi30-old195275-2026-10-12/delivery-front-2026-10-13/SolidWorks/OLD_FF固定铝板.SLDPRT
hardware/xiangqi30-old195275-2026-10-12/delivery-front-2026-10-13/SolidWorks/OLD_GT20同步轮.SLDPRT
hardware/xiangqi30-old195275-2026-10-12/delivery-front-2026-10-13/SolidWorks/OLD_GT60同步轮.SLDPRT
hardware/xiangqi30-old195275-2026-10-12/delivery-front-2026-10-13/SolidWorks/OLD_J1机械臂.SLDPRT
hardware/xiangqi30-old195275-2026-10-12/delivery-front-2026-10-13/SolidWorks/OLD_L型支架底座.SLDPRT
hardware/xiangqi30-old195275-2026-10-12/delivery-front-2026-10-13/SolidWorks/OLD_L型支架竖板.SLDPRT
hardware/xiangqi30-old195275-2026-10-12/delivery-front-2026-10-13/SolidWorks/OLD_M3x4mm紧固螺丝.SLDPRT
hardware/xiangqi30-old195275-2026-10-12/delivery-front-2026-10-13/SolidWorks/OLD_M3内六角x10mm.SLDPRT
hardware/xiangqi30-old195275-2026-10-12/delivery-front-2026-10-13/SolidWorks/OLD_M3内六角x12mm.SLDPRT
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
