lst92991-eng/four-axis-robot-arm/hardware/xiangqi33-assemblies-2026-10-13/README_先读我.md

# 33mm象棋：新旧SCARA参考总装

解压整个压缩包，用SolidWorks 2026分别打开：

- 旧195＋275：`old/SolidWorks/SCARA_FRONT_195_275_CHESS33.SLDASM`
- 新275＋275：`long/SolidWorks/SCARA_FRONT_275_275_CHESS33.SLDASM`

不要只复制SLDASM；保留各自SolidWorks文件夹。每版文件夹另有同名STEP、实际CAD预览和四个独立ArUco打印稿。

## 最新规格

用户2026-10-13把棋子直径30更正为33mm。两版均32枚，红黑14种身份，原生驱动圆直径33mm、高8mm；字面0.1mm凸起。自建参考棋子，不冒充开源商品模型或已实测实物。

参考棋盘315×350×14mm，格距35mm，90交点跨度280×315mm，中心在肩轴前方(0,280)mm；黑方近机械臂。相邻圆饼净距2mm，最外侧圆饼距板边1mm。只改变直径，棋盘及37个棋具/标记变换不变；实际棋高、质量、磁吸和抓手/邻子净空需单独验收。

四码DICT_4X4_50的ID0～3，黑码48mm、白边各6mm、外形60mm；总外包络450×485mm。`old/markers/`与`long/markers/`打印稿一致，打印按100%实际尺寸；`reference/`有用户提供的RV1106 PCB STEP。尚未冻结机位或摄像头支架。

## 已核对

每版独立副本打开、38个顶层/195个总组件；32枚棋子全部回读为33mm，圆柱面回读轴距分别195＋275和275＋275mm；保存引用、运行引用均在本版SolidWorks文件夹内，虚拟皮带和传动装配已外部化。STEP导出与实际CAD预览已检查。

30mm原交付及源275＋275候选结构保留；源文件哈希未变化。原结构既有配合问题保留；本次没有改机械结构，没有实物电机动作、commit/push。按用户已授权处理参考副本CAM保存提示。

## 工作区

`workspace-comparison/old-new-top-view.png`直接比较新旧原结构；另有换低头前后、两版同用低头及四组合图。均按204实体、当前Z/R与4°采样的同一口径。旧机原头86/90，低头分析89/90；新机两种头高均90/90。

**原生总装仍保留6mm螺丝头；3.82mm只作为独立分析变体。** 端点通过不代表连续搬运、电磁铁、线缆、动态挠度或实机验收完成。详见`workspace-comparison/对比说明.md`。

`old/validation.json`和`long/validation.json`保存尺寸/引用/轴距证据，`SHA256SUMS.json`逐文件SHA-256用于完整性核对。
