lst92991-eng/four-axis-robot-arm/hardware/xiangqi30-old195275-2026-10-12/delivery-verified/preview/assembly_review_summary.md

# SolidWorks Review Summary

- Status: `warn`
- Score: `72`
- Manual review required: `True`

## Checks

- `rebuild_succeeded`: `True`
- `model_available`: `True`
- `previews_created`: `True`
- `previews_not_blank`: `True`
- `expected_outputs_exist`: `True`
- `feature_summary_available`: `True`
- `geometry_measurements_available`: `False`
- `geometry_measurements_error_free`: `True`
- `feature_errors_absent`: `True`

## Issues

- `warn` `feature_health_review_required`: 特征存在警告或无法取得完整错误证据。
- `warn` `interference_detected`: 装配体存在干涉，体积与组件详见明细。

## Recommendations

- 复核特征错误/警告明细。
- 确认是否为有意过盈，否则修复配合。

## Previews

- `C:\Users\lst\Desktop\scara\hardware\xiangqi30-old195275-2026-10-12\preview\assembly_isometric.bmp`
- `C:\Users\lst\Desktop\scara\hardware\xiangqi30-old195275-2026-10-12\preview\assembly_front.bmp`
- `C:\Users\lst\Desktop\scara\hardware\xiangqi30-old195275-2026-10-12\preview\assembly_top.bmp`
- `C:\Users\lst\Desktop\scara\hardware\xiangqi30-old195275-2026-10-12\preview\assembly_right.bmp`
