lst92991-eng/four-axis-robot-arm/hardware/xiangqi30-long275275-2026-10-13/markers/print_preview.png

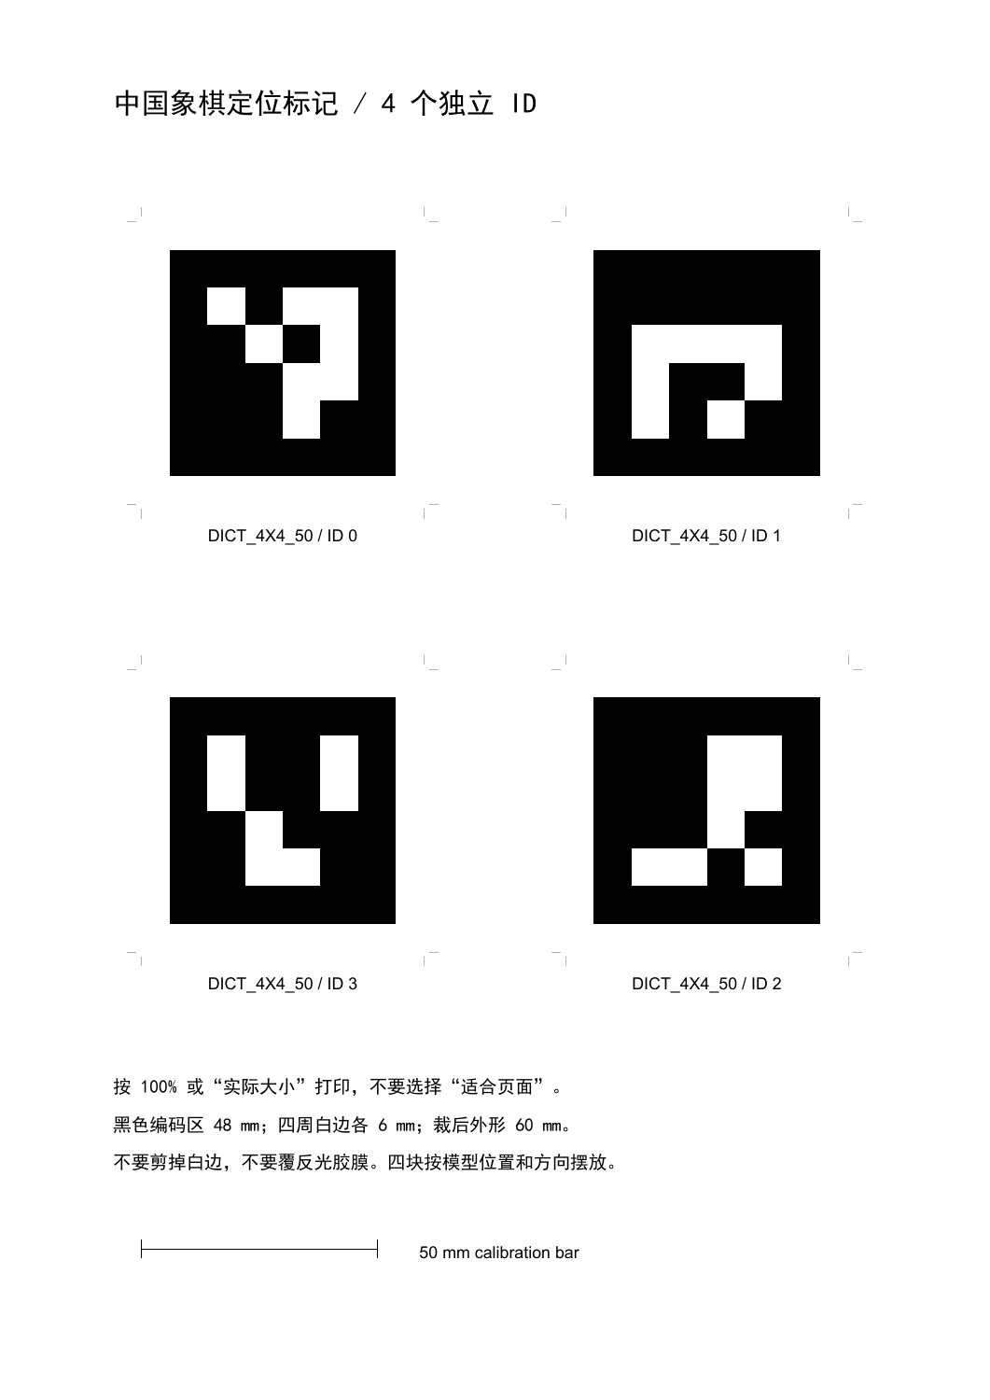
hardware/xiangqi30-long275275-2026-10-13/markers/print_preview.png
