lst92991-eng/four-axis-robot-arm/hardware/xiangqi33-assemblies-2026-10-13/long/preview/isometric.bmp

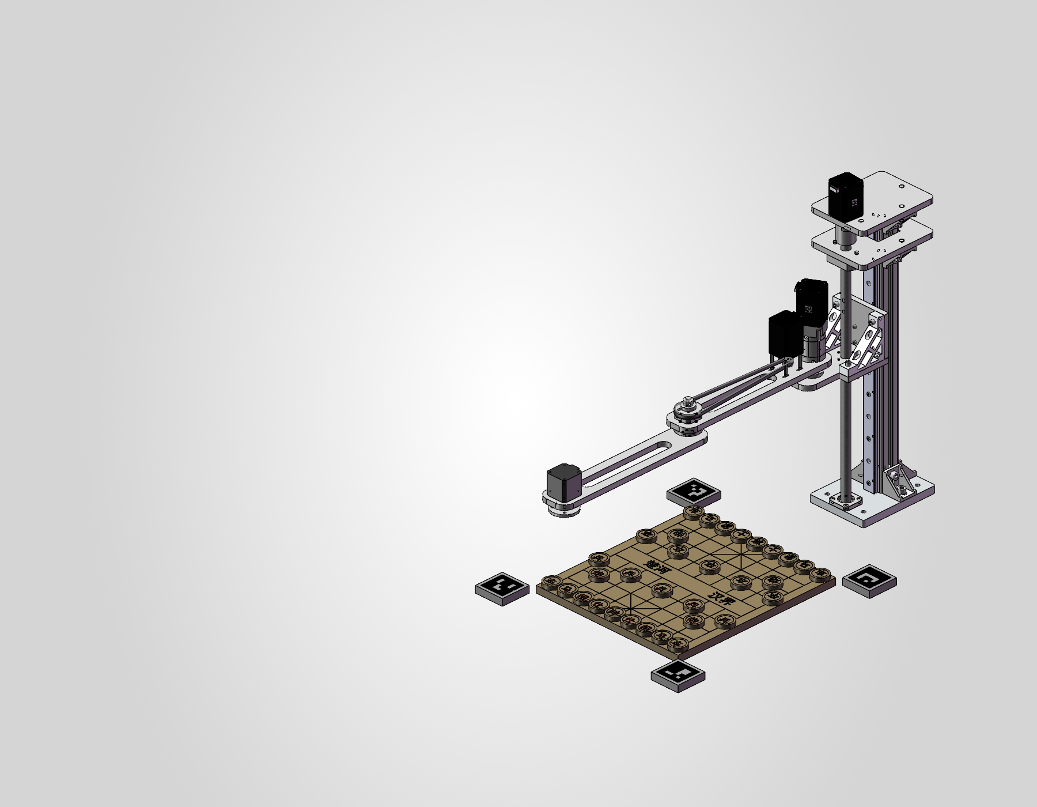
hardware/xiangqi33-assemblies-2026-10-13/long/preview/isometric.bmp
