lst92991-eng/four-axis-robot-arm/hardware/xiangqi33-assemblies-2026-10-13/long/preview/top.bmp

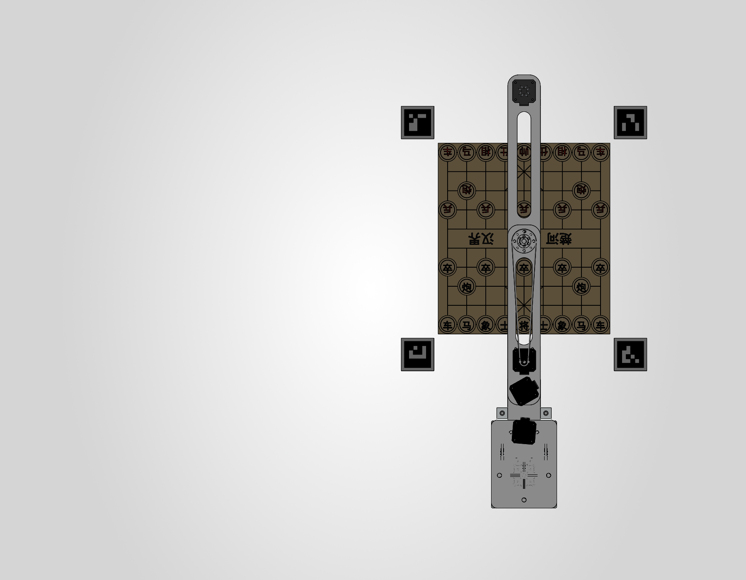
hardware/xiangqi33-assemblies-2026-10-13/long/preview/top.bmp
