lst92991-eng/four-axis-robot-arm/output/motor-load-naming-2026-10-13/assembly-readonly_front.bmp

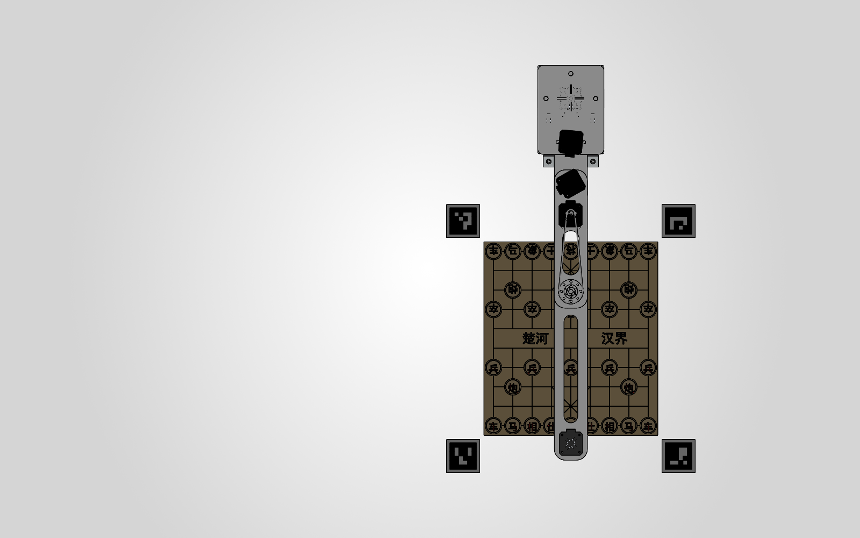
output/motor-load-naming-2026-10-13/assembly-readonly_front.bmp
