lst92991-eng/four-axis-robot-arm/output/rv1106/validation/step1/camera.jpg

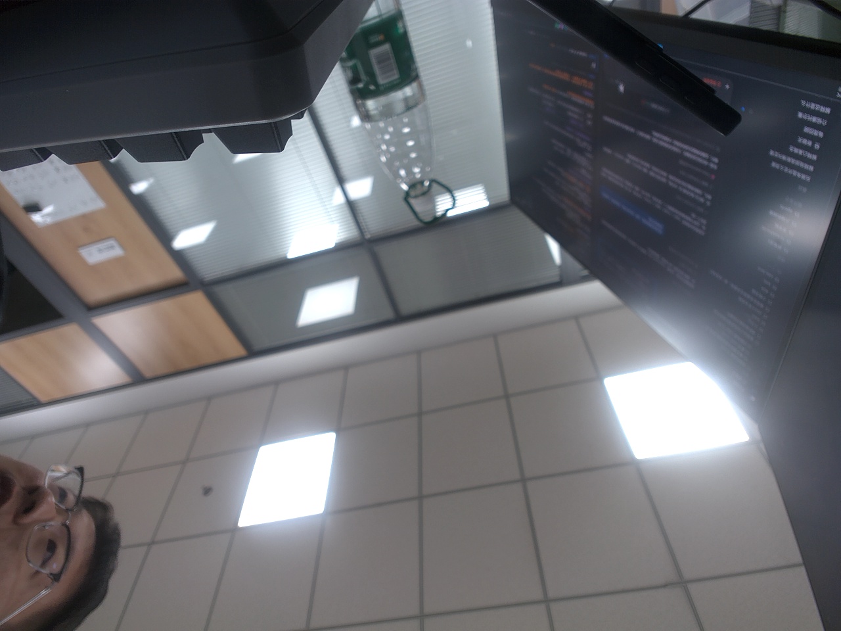
output/rv1106/validation/step1/camera.jpg
