lst92991-eng/four-axis-robot-arm/output/rv1106/validation/step1/first-frame.jpg

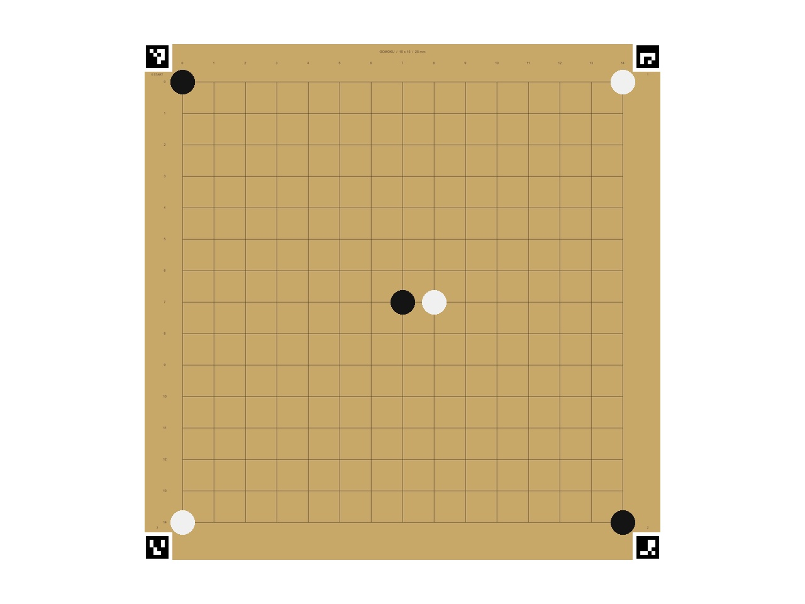
output/rv1106/validation/step1/first-frame.jpg
