lst92991-eng/four-axis-robot-arm/research/mechanism/driver-x42s/manual-page-8.png

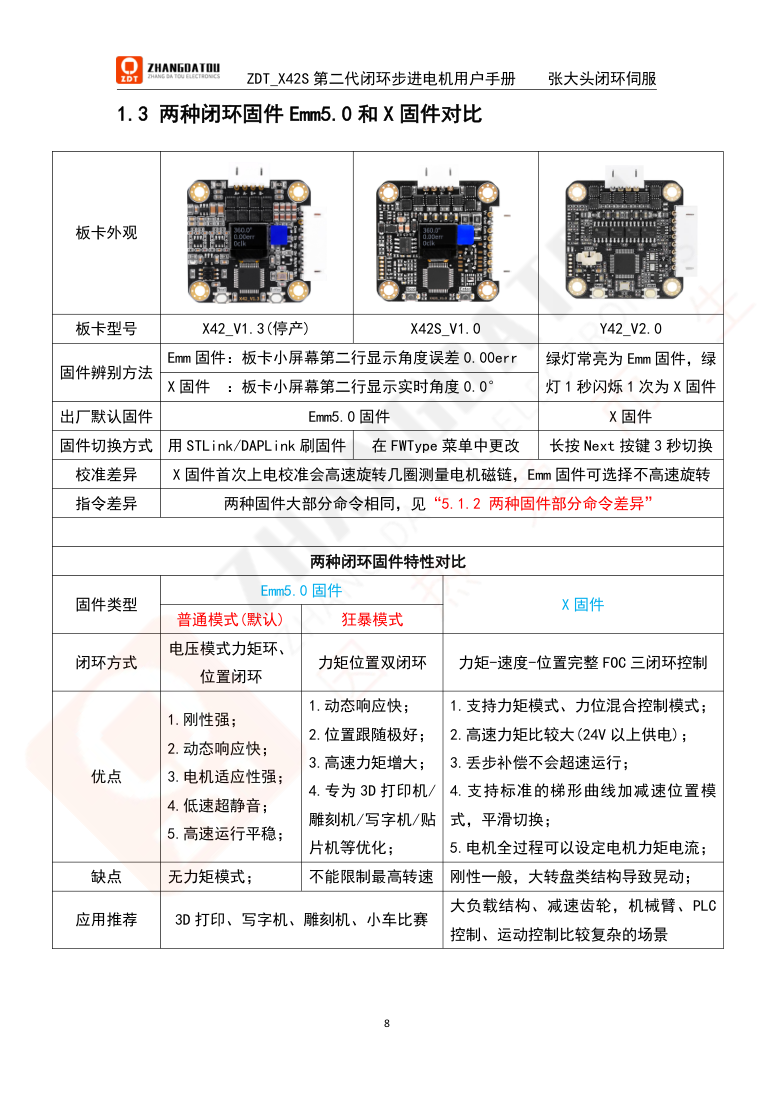
research/mechanism/driver-x42s/manual-page-8.png
