lst92991-eng/four-axis-robot-arm/output/hardware-validation/500rpm-extract-2026-10-13/samples.csv

segment | source | direction | elapsed_s | unix_time | target_rpm | measured_rpm | angle_deg | phase_ma | status
1 | z-panel-20261013-180703.jsonl | up | 0.003507 | 1791886036.2370565 | 500 | 0 | -0.2691650390625 | 209 | 3
1 | z-panel-20261013-180703.jsonl | up | 0.116239 | 1791886036.3497891 | 500 | 1 | 0.1263427734375 | 357 | 3
1 | z-panel-20261013-180703.jsonl | up | 0.22424 | 1791886036.4577901 | 500 | 15 | 8.50341796875 | 481 | 1
1 | z-panel-20261013-180703.jsonl | up | 0.334243 | 1791886036.567793 | 500 | 23 | 22.5054931640625 | 453 | 1
1 | z-panel-20261013-180703.jsonl | up | 0.444392 | 1791886036.6779416 | 500 | 31 | 42.01171875 | 476 | 1
1 | z-panel-20261013-180703.jsonl | up | 0.553422 | 1791886036.7869718 | 500 | 40 | 66.97265625 | 510 | 1
1 | z-panel-20261013-180703.jsonl | up | 0.664466 | 1791886036.8980162 | 500 | 46 | 96.5093994140625 | 636 | 1
1 | z-panel-20261013-180703.jsonl | up | 0.772804 | 1791886037.0063534 | 500 | 58 | 132.0062255859375 | 567 | 1
1 | z-panel-20261013-180703.jsonl | up | 0.880815 | 1791886037.114365 | 500 | 62 | 173.232421875 | 543 | 1
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
