lst92991-eng/four-axis-robot-arm/output/rv1106/validation/board-tests/mixed/board.csv

B | . | . | . | . | . | . | . | . | . | . | . | . | . | W
. | . | . | . | . | . | . | . | . | . | . | . | . | . | .
. | . | . | . | . | . | . | . | . | . | . | . | . | . | .
. | . | . | . | . | . | . | . | . | . | . | . | . | . | .
. | . | . | . | . | . | . | . | . | . | . | . | . | . | .
. | . | . | . | . | . | . | . | . | . | . | . | . | . | .
. | . | . | . | . | . | . | . | . | . | . | . | . | . | .
. | . | . | . | . | . | . | B | W | . | . | . | . | . | .
. | . | . | . | . | . | . | . | . | . | . | . | . | . | .
. | . | . | . | . | . | . | . | . | . | . | . | . | . | .
. | . | . | . | . | . | . | . | . | . | . | . | . | . | .
. | . | . | . | . | . | . | . | . | . | . | . | . | . | .
. | . | . | . | . | . | . | . | . | . | . | . | . | . | .
. | . | . | . | . | . | . | . | . | . | . | . | . | . | .
W | . | . | . | . | . | . | . | . | . | . | . | . | . | B
