lst92991-eng/four-axis-robot-arm/output/rv1106/full-validation/camera-mis5001.jpg

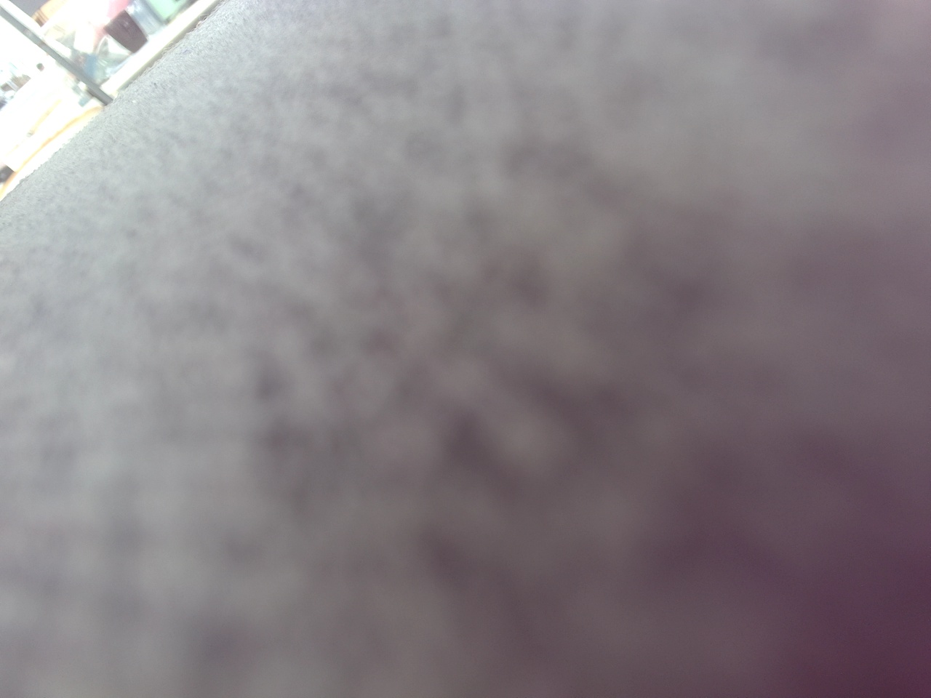
output/rv1106/full-validation/camera-mis5001.jpg
