lst92991-eng/four-axis-robot-arm/output/rv1106/full-validation/camera-preview.jpg

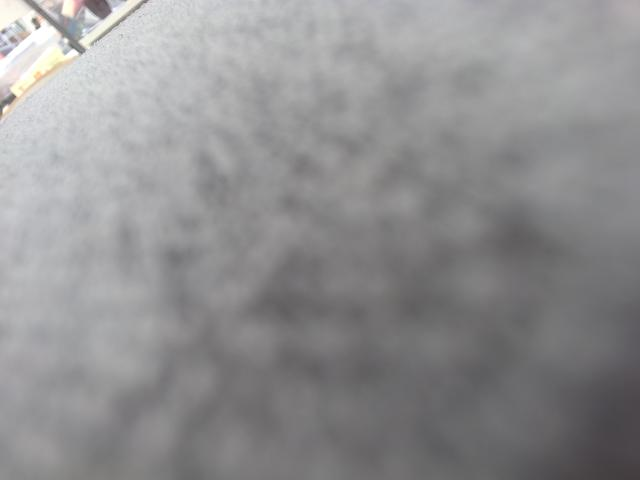
output/rv1106/full-validation/camera-preview.jpg
