lst92991-eng/four-axis-robot-arm/output/rv1106/full-validation/teaching-demo.png

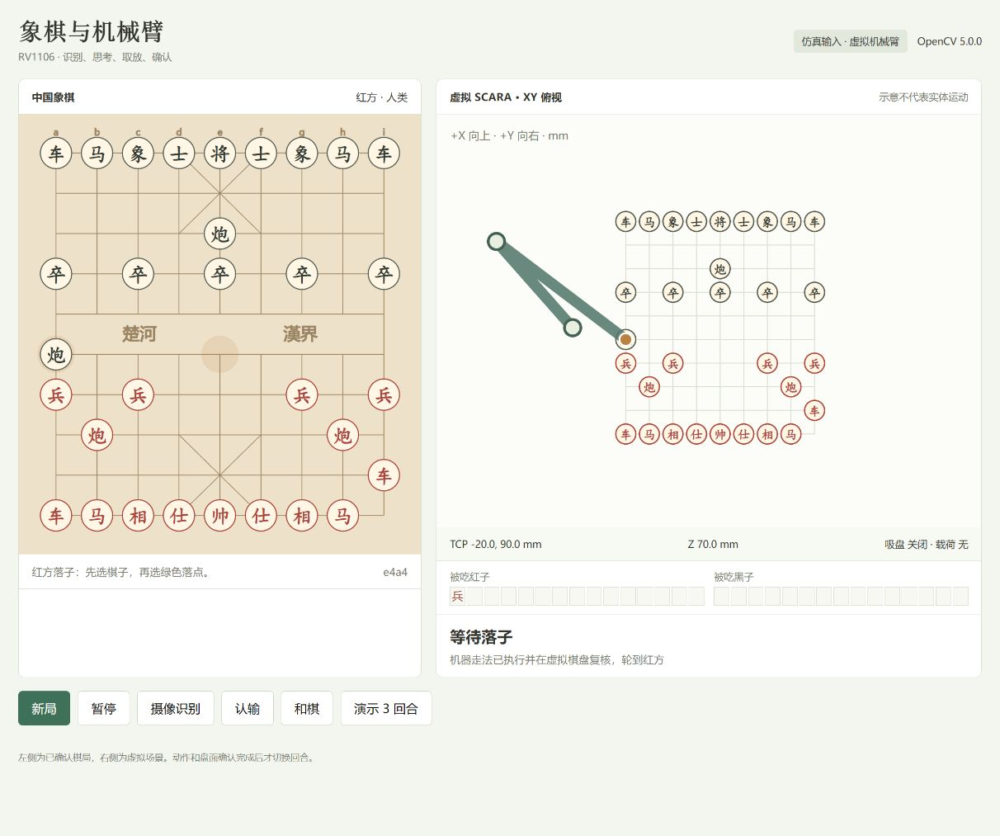
output/rv1106/full-validation/teaching-demo.png
