lst92991-eng/four-axis-robot-arm/output/rv1106/pikafish-validation/viewer/live-board.jpg

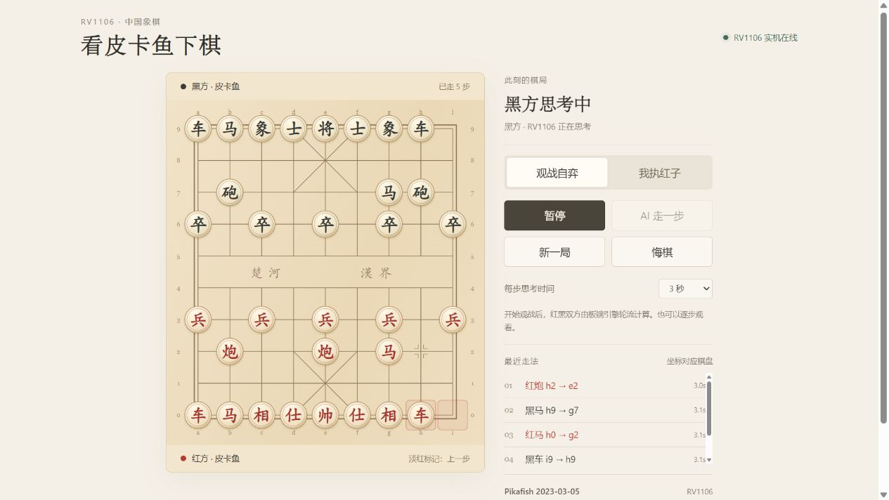
output/rv1106/pikafish-validation/viewer/live-board.jpg
