lst92991-eng/four-axis-robot-arm/output/rv1106/validation/board-tests/mixed/annotated.png

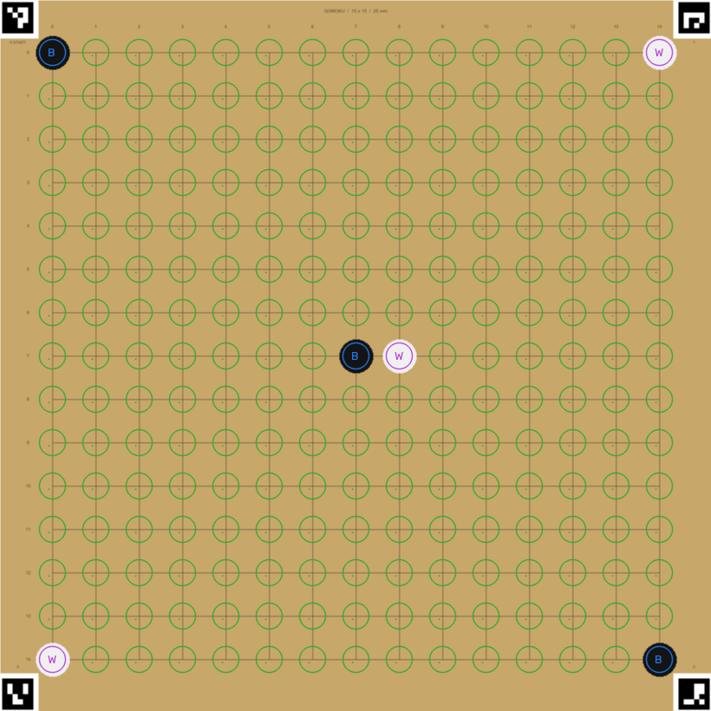
output/rv1106/validation/board-tests/mixed/annotated.png
