lst92991-eng/four-axis-robot-arm/output/rv1106/validation/board-tests/uncertain/source.jpg

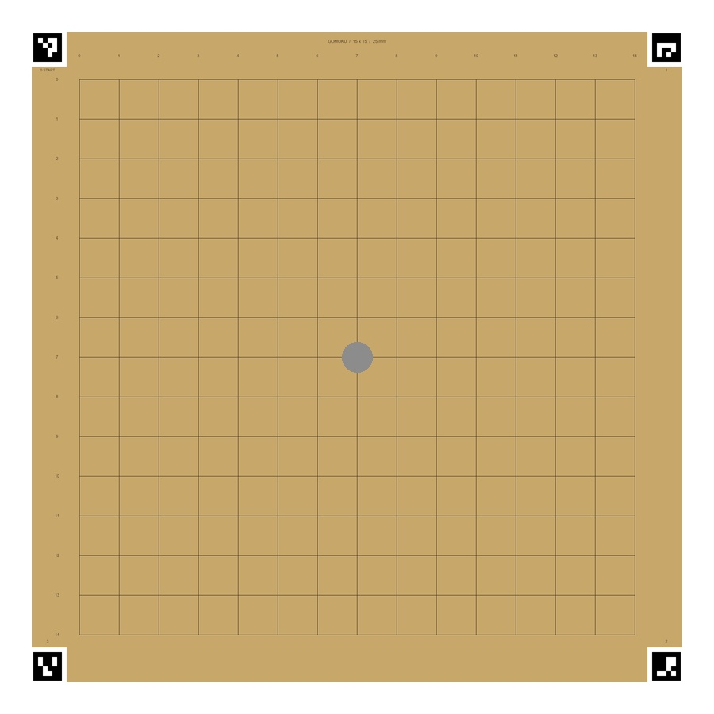
output/rv1106/validation/board-tests/uncertain/source.jpg
