lst92991-eng/four-axis-robot-arm/output/rv1106/validation/inputs/white-background.png

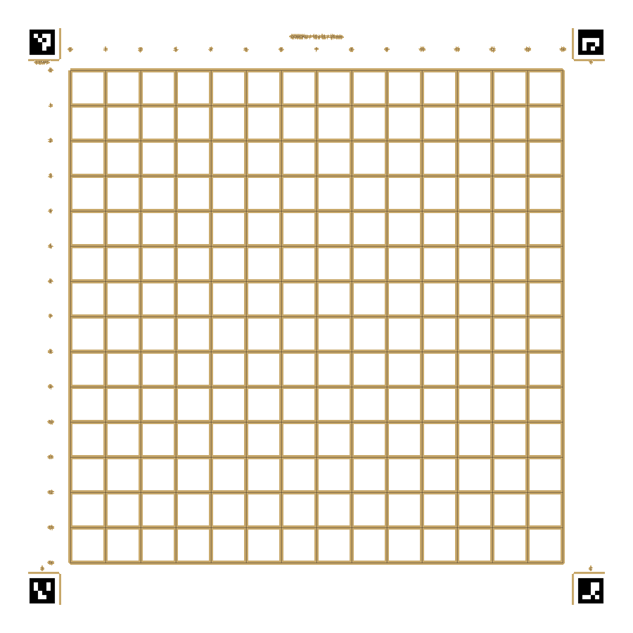
output/rv1106/validation/inputs/white-background.png
