lst92991-eng/four-axis-robot-arm/output/pdf/gomoku-stones-a4.pdf

五子棋棋子 · 剪裁版 | 1 / 3

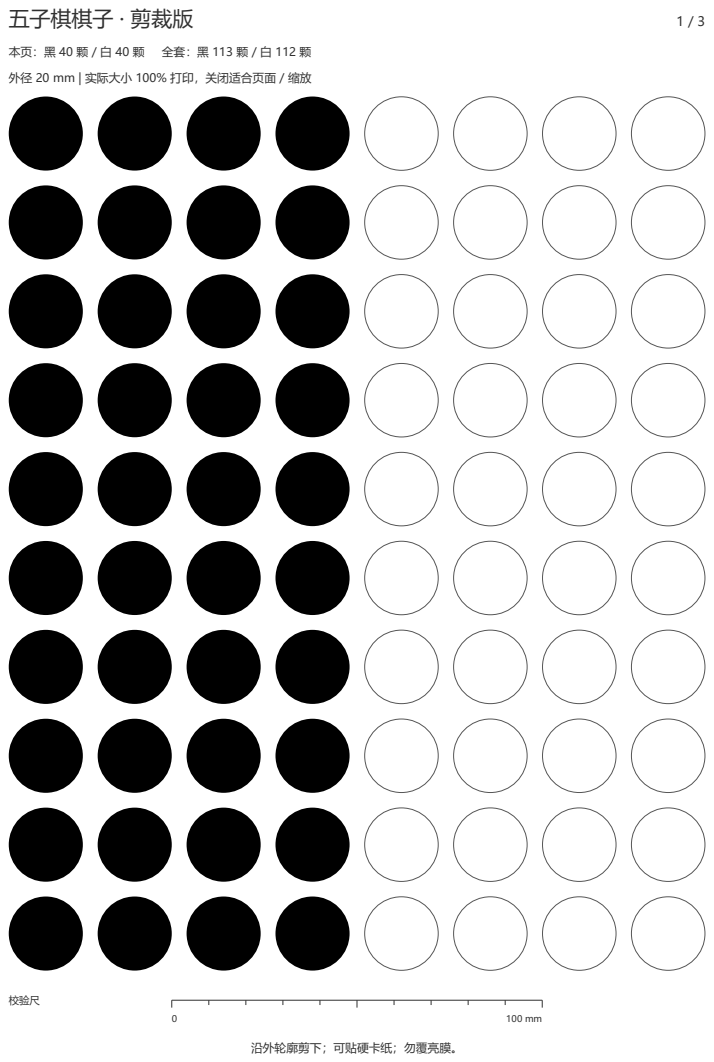
[picture p177: page 1]
校验尺

外径 20 mm | 实际大小 100% 打印，关闭适合页面 / 缩放

沿外轮廓剪下；可贴硬卡纸；勿覆亮膜。

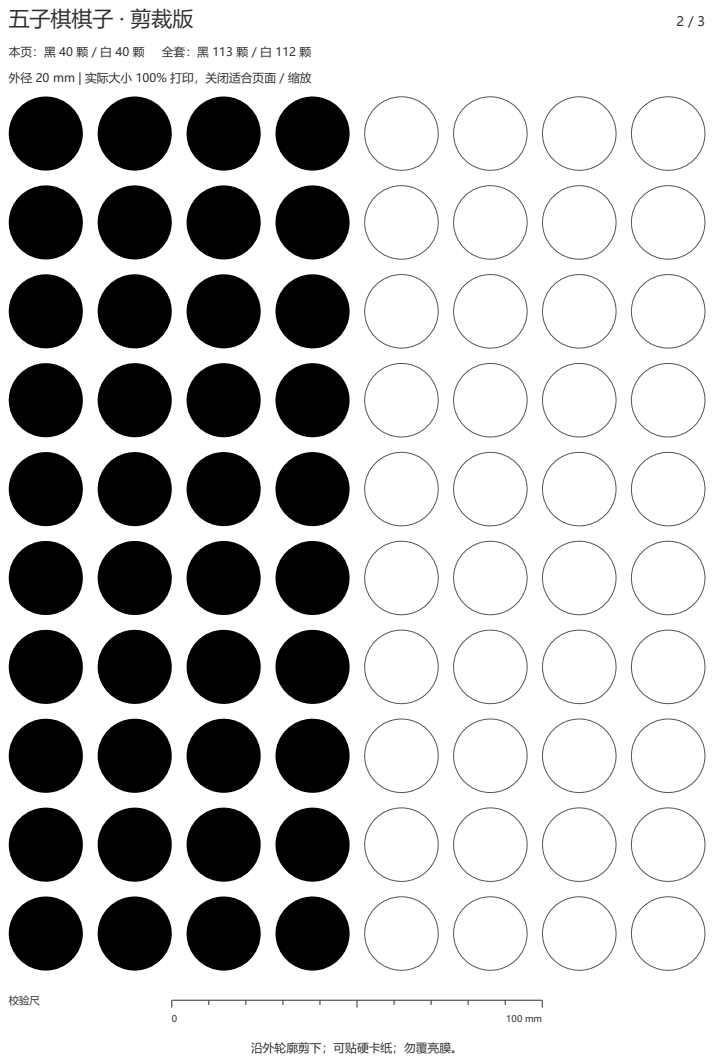
[picture p178: page 2]

外径 20 mm | 实际大小 100% 打印，关闭适合页面 / 缩放

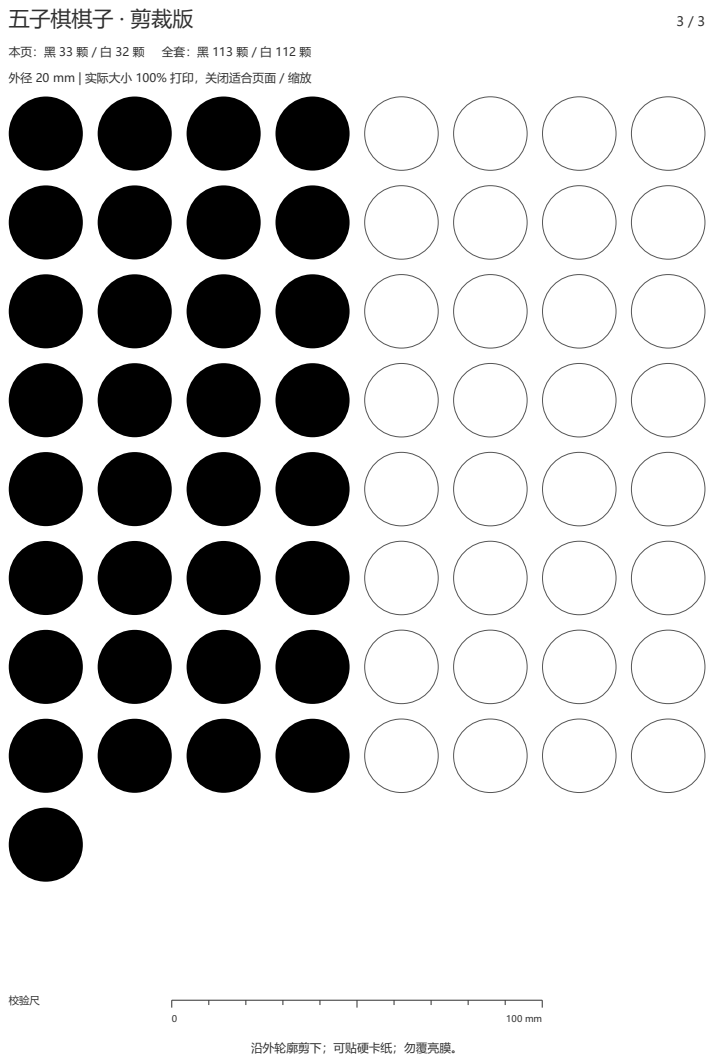
[picture p179: page 3]

外径 20 mm | 实际大小 100% 打印，关闭适合页面 / 缩放
