lst92991-eng/four-axis-robot-arm/(list of files, drawings)

Other design files:
hardware/camera_mount/v2/pcb-import-evidence.json
hardware/camera_mount/v2/pcb-mounting-geometry.json
hardware/camera_mount/v2/pcb-reference.json
