lst92991-eng/four-axis-robot-arm/research/mechanism/driver-x42s/vendor-review/can-main-decoded.c

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

/* Includes ------------------------------------------------------------------*/

#include "main.h"

#include "can.h"

#include "gpio.h"




/* USER CODE BEGIN Includes */



#include "X_V2.h"



/* USER CODE END Includes */










void SystemClock_Config(void);


/**

  * @brief  The application entry point.

  * @retval int

  */

int main(void)

{

  /* MCU Configuration--------------------------------------------------------*/



  /* Reset of all peripherals, Initializes the Flash interface and the Systick. */

  HAL_Init();



  /* Configure the system clock */

  SystemClock_Config();



  /* Initialize all configured peripherals */

  MX_GPIO_Init();

  MX_CAN_Init();

  /* USER CODE BEGIN 2 */

	USER_CAN1_Filter_Init();																	// 初始化CAN滤波器

	if(HAL_CAN_Start(&hcan) != HAL_OK) { Error_Handler(); }	// 启动CAN控制器

	if(HAL_CAN_ActivateNotification(&hcan, CAN_IT_RX_FIFO0_MSG_PENDING) != HAL_OK) { Error_Handler(); }	// 使能CAN控制器接收中断



/**********************************************************

***	上电延时500毫秒等待闭环初始化完毕

**********************************************************/	

	HAL_Delay(500);



/**********************************************************

***	梯形曲线加减速位置模式控制：

	*   方向			    ：CCW

	*   加速加速度    ：1000RPM/s

	*   减速加速度    ：1000RPM/s

	*   最大速度      ：2000.0RPM

	*   相对位置运动  ：-36000.0°

**********************************************************/	

	X_V2_Traj_Pos_Control(1, 1, 1000, 1000, 2000.0f, 36000.0f, 0, 0);

	

/**********************************************************

	*	等待返回命令

***	返回数据缓存在can.rxData数组上，长度为can.CAN_RxMsg.DLC,

***	电机地址为帧ID右移8位：can.CAN_RxMsg.ExtId >> 8

	*	can.rxFrameFlag在stm32f1xx_it.h中USB_LP_CAN1_RX0_IRQHandler中断函数里接收数据和置位

**********************************************************/	

	while(can.rxFrameFlag == false); can.rxFrameFlag = false;



  /* USER CODE END 2 */



  /* Infinite loop */

  /* USER CODE BEGIN WHILE */

  while (1)

  {

    /* USER CODE END WHILE */



    /* USER CODE BEGIN 3 */

  }

  /* USER CODE END 3 */

}



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
