lst92991-eng/four-axis-robot-arm/research/mechanism/driver-x42s/vendor-review/can-can-decoded.c

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

/* Includes ------------------------------------------------------------------*/

#include "can.h"



/* USER CODE BEGIN 0 */



__IO CAN_t can = {0};



/* USER CODE END 0 */



CAN_HandleTypeDef hcan;



/* CAN init function */

void MX_CAN_Init(void)

{



  hcan.Instance = CAN1;

  hcan.Init.Prescaler = 6;									// 波特率 = 36M / 6 / (1 + 9 + 2) = 0.5，即500K

  hcan.Init.Mode = CAN_MODE_NORMAL;					// 正常工作模式

  hcan.Init.SyncJumpWidth = CAN_SJW_1TQ;		// 重新同步跳跃宽度为SJW + 1个时间单位

  hcan.Init.TimeSeg1 = CAN_BS1_9TQ;

  hcan.Init.TimeSeg2 = CAN_BS2_2TQ;

  hcan.Init.TimeTriggeredMode = DISABLE;		// 关闭时间触发通讯模式

  hcan.Init.AutoBusOff = ENABLE;						// 开启自动离线管理

  hcan.Init.AutoWakeUp = DISABLE;						// 关闭自动唤醒模式

  hcan.Init.AutoRetransmission = DISABLE;		// 关闭非自动重传模式	DISABLE：自动重传

  hcan.Init.ReceiveFifoLocked = DISABLE;		// 接收FIFO锁定模式		DISABLE-溢出时新报文会覆盖原有报文

  hcan.Init.TransmitFifoPriority = DISABLE;	// 发送FIFO优先级			DISABLE-优先级取决于报文标识符

  if (HAL_CAN_Init(&hcan) != HAL_OK)

  {

    Error_Handler();

  }

}



void HAL_CAN_MspInit(CAN_HandleTypeDef* canHandle)

{



  GPIO_InitTypeDef GPIO_InitStruct = {0};

  if(canHandle->Instance==CAN1)

  {

    /* CAN1 clock enable */

    __HAL_RCC_CAN1_CLK_ENABLE();



    __HAL_RCC_GPIOB_CLK_ENABLE();

    /**CAN GPIO Configuration

    PB8     ------> CAN_RX

    PB9     ------> CAN_TX

    */

    GPIO_InitStruct.Pin = GPIO_PIN_8;

    GPIO_InitStruct.Mode = GPIO_MODE_INPUT;

    GPIO_InitStruct.Pull = GPIO_NOPULL;

    HAL_GPIO_Init(GPIOB, &GPIO_InitStruct);



    GPIO_InitStruct.Pin = GPIO_PIN_9;

    GPIO_InitStruct.Mode = GPIO_MODE_AF_PP;

    GPIO_InitStruct.Speed = GPIO_SPEED_FREQ_HIGH;

    HAL_GPIO_Init(GPIOB, &GPIO_InitStruct);



    __HAL_AFIO_REMAP_CAN1_2();



    /* CAN1 interrupt Init */

    HAL_NVIC_SetPriority(USB_LP_CAN1_RX0_IRQn, 0, 0);

    HAL_NVIC_EnableIRQ(USB_LP_CAN1_RX0_IRQn);

  }

}



void HAL_CAN_MspDeInit(CAN_HandleTypeDef* canHandle)

{



  if(canHandle->Instance==CAN1)

  {

    /* Peripheral clock disable */

    __HAL_RCC_CAN1_CLK_DISABLE();



    /**CAN GPIO Configuration

    PB8     ------> CAN_RX

    PB9     ------> CAN_TX

    */

    HAL_GPIO_DeInit(GPIOB, GPIO_PIN_8|GPIO_PIN_9);



    /* CAN1 interrupt Deinit */

    HAL_NVIC_DisableIRQ(USB_LP_CAN1_RX0_IRQn);

  }

}



/* USER CODE BEGIN 1 */



/**

	* @brief   初始化滤波器

	* @param   无

	* @retval  无

	*/

void USER_CAN1_Filter_Init(void)

{

	// 过滤器结构体

	CAN_FilterTypeDef  sFilterConfig;



	// 设置STM32的帧ID - 扩展帧格式 - 不过滤任何数据帧

	__IO uint8_t id_o, im_o; __IO uint16_t id_l, id_h, im_l, im_h;

	id_o = (0x00);

	id_h = (uint16_t)((uint16_t)id_o >> 5);								// 高3位

	id_l = (uint16_t)((uint16_t)id_o << 11) | CAN_ID_EXT; // 低5位

	im_o = (0x00);

	im_h = (uint16_t)((uint16_t)im_o >> 5);

	im_l = (uint16_t)((uint16_t)im_o << 11) | CAN_ID_EXT;



	// 过滤器参数

	sFilterConfig.FilterBank = 0;                      		// 过滤器1

	sFilterConfig.FilterMode = CAN_FILTERMODE_IDMASK;  		// 掩码模式

	sFilterConfig.FilterScale = CAN_FILTERSCALE_32BIT; 		// 32位过滤器位宽

	sFilterConfig.FilterIdHigh = id_h;               			// 过滤器标识符的高16位值

	sFilterConfig.FilterIdLow = id_l;                			// 过滤器标识符的低16位值

	sFilterConfig.FilterMaskIdHigh = im_h;           			// 过滤器屏蔽标识符的高16位值

	sFilterConfig.FilterMaskIdLow = im_l;            			// 过滤器屏蔽标识符的低16位值

	sFilterConfig.FilterFIFOAssignment = CAN_RX_FIFO0; 		// 指向过滤器的FIFO为0

	sFilterConfig.FilterActivation = ENABLE;           		// 使能过滤器

	sFilterConfig.SlaveStartFilterBank = 0;           		// 从过滤器配置，用来选择从过滤器的寄存器编号

	

	// 配置并自检

	while(HAL_CAN_ConfigFilter(&hcan, &sFilterConfig) != HAL_OK);

}



/**

	* @brief   CAN发送多个字节

	* @param   无

	* @retval  无

	*/

void can_SendCmd(__IO uint8_t *cmd, uint8_t len)

{

	static uint32_t TxMailbox; __IO uint8_t i = 0, j = 0, k = 0, l = 0, packNum = 0;



	// 除去ID地址和功能码后的数据长度

	j = len - 2;



	// 发送数据

	while(i < j)

	{

		// 数据个数

		k = j - i;



		// 填充缓存

		can.CAN_TxMsg.StdId = 0x00;

		can.CAN_TxMsg.ExtId = ((uint32_t)cmd[0] << 8) | (uint32_t)packNum;

		can.txData[0] = cmd[1];

		can.CAN_TxMsg.IDE = CAN_ID_EXT;

		can.CAN_TxMsg.RTR = CAN_RTR_DATA;



		// 小于8字节命令

		if(k < 8)

		{

			for(l=0; l < k; l++,i++) { can.txData[l + 1] = cmd[i + 2]; } can.CAN_TxMsg.DLC = k + 1;

		}

		// 大于8字节命令，分包发送，每包数据最多发送8个字节

		else

		{

			for(l=0; l < 7; l++,i++) { can.txData[l + 1] = cmd[i + 2]; } can.CAN_TxMsg.DLC = 8;

		}



		// 发送数据

		HAL_CAN_AddTxMessage((&hcan), (CAN_TxHeaderTypeDef *)(&can.CAN_TxMsg), (uint8_t *)(&can.txData), (&TxMailbox));



		// 记录发送的第几包的数据

		++packNum;

	}

}



/* USER CODE END 1 */
