lst92991-eng/four-axis-robot-arm/output/motor-can-refactor-2026-10-13/before/tests/main.cpp

#include <iostream>
void testAlgorithms();
void testChess();
void testSimulator();
void testCommands();
void testVision();
#ifdef SCARA_HAS_EMM_CAN
void testEmmCan();
#endif
int main()
{
    testAlgorithms();
    testChess();
    testSimulator();
    testCommands();
    testVision();
#ifdef SCARA_HAS_EMM_CAN
    testEmmCan();
#endif
    std::cout << "SCARA tests passed\n";
}
