lst92991-eng/four-axis-robot-arm/(commit log)

2026-10-14 docs: 建立SCARA教学项目需求与技术栈调研
    目的
    从空白教学项目建立需求和技术依据。用户要求第一次提交只有文档，第二次提交才新增接口。
    范围
    仅teaching/README.md和teaching/docs/技术栈调研.md，不纳入现有业务代码、模型、测试产物和机械资料。
    设计理由
    沿用RV1106、C++17、OpenCV5.0.0、YOLOv5/RKNN和Pikafish已选路线，复用已验证经验，避免重新选型。
    CAN采用SocketCAN标准接口，Motor承担Emm节点和报文；参考Linux文档、can-utils及相近开源项目，明确适用差异，不搬入ROS框架或全量协议。
    区分已实现、已实物验证和仍待验证的事实，500RP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
2026-10-14 feat(can): 新增已审定的SocketCAN初始化接口
    接口与用途
    新增robot::Can::Can(const char* interface)。输入为教学代码传入的有效接口名称，例如can0；成功后保存绑定到该接口的非阻塞CAN句柄，失败抛出runtime_error。
    这是新教学项目的第一个接口。本提交只含teaching/robot/can.hpp、can.cpp及README进度说明，不包含析构、收发或电机运动接口。
    用户定案
    用户已确认完整候选方法“这版我已经可以接受了”。源码与总规划10.7保存的已确认完整方法逐字核对一致。
    设计原因
    1. 使用if_nametoindex直接按名称查询编号，省去ifreq、strcpy和ioctl准备过程；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
2026-11-02 Archive complete SCARA project and add portable J1 demo
    Publish the user-authorized current workspace, teaching history, CAD, models,
    runtime inputs and validation evidence. Preserve original bytes, record per-file
    SHA-256, and store the oversized CAD in LFS. Exclude credentials and transient files.
    Reuse the existing J1/Z-axis panel with automatic per-user Python/Tk installation
    and pinned USB wheels, online or offline. Preserve manual standby and all stop paths.
    Validation: 32 offline tests; PowerShell setup/check; offline installation from an
    extracted ZIP at a path with spaces; installer/wheel/package and staged-file hashes.
    No USB connection, CAN frames or motor movements were perform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
    [01_base.SLDPRT, 01_base.STL, 01_base.step, 01_clamp_right.SLDPRT, 01_clamp_right.STL, 01_clamp_right.step, 02_clamp_left.SLDPRT, 02_clamp_left.STL]
