lst92991-eng/four-axis-robot-arm/(notices)

Notices in the files:
research/mechanism/driver-x42s/vendor-review/can-can-decoded.c:
Copyright (c) 2026 STMicroelectronics.
All rights reserved.
This software is licensed under terms that can be found in the LICENSE file
